odevincenti/Wet-DryPenguins/Pruebas Experimentales/Medición de conductividad/Conexion de ensayo preliminar.jpeg

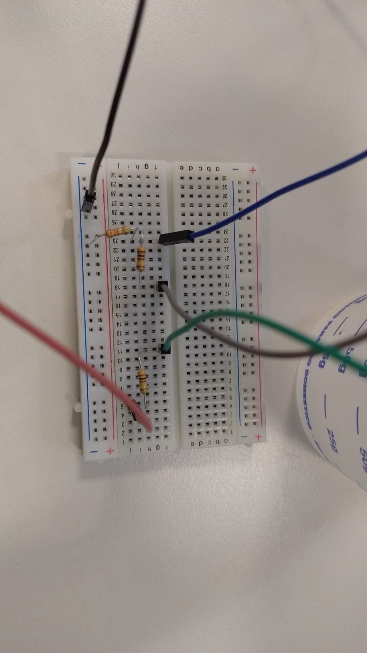
Pruebas Experimentales/Medición de conductividad/Conexion de ensayo preliminar.jpeg
