odevincenti/Wet-DryPenguins/README.md

# Wet&Dry Pingüinos

### Proyecto final de carrera de Ingeniería Electrónica - ITBA
#
## Integrantes
- De Vincenti, Olivia
- Figueroa, Alejo Agustin
- Mangone, Santiago Ezequiel
- Moldovan, Alexander
#
## Requerimientos
Diseñar un dispositivo que...
