odevincenti/Wet-DryPenguins/Produccion/PT_FINAL_2024_02/idea2.txt

// TODO
- si se despierta al inicio, otro texto?
- mediante uart y rtc para setear
//- agregar que se despierte desde base directo a uart
//- PONER HORA DE INICIO
//- si desconecta base, se salga solo de uart
//- always unknown command \n
//- lista de reseteos (con 2 indices each)
//- set led / clr led
//- paridad set, y chequeo con NAK
//- revisar indice 65535
// - ver porq se glitchea al inicio
//- sacar leds
//- corregir largo arreglo log
- corregir minuto calibrado 
//- corregir index maximo

// https://e2e.ti.com/support/microcontrollers/msp-low-power-microcontrollers-group/msp430/f/msp-low-power-microcontroller-forum/461905/msp430fr6989-unable-to-use-fram2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

65535 (MOD mas grande)

Digamos, maximo 60 min = 60000
-> 1 min = 1000
-> precision de 0,1%

Divisor de RTC a 1000
-> RTCCLK a 10Hz
-> 1 = 0,1 segs
-> 600 = 1 min

Divisor de RTC a 256
-> RTCCLK a 39,0625 Hz
-> 1 = 0,0256 segs
-> 2343,75 = 1 min

Divisor de RTC a 100
-> RTCCLK a 100Hz
-> 1 = 0,01 segs
-> 6000 = 1 min

Maximo 15 min = 60000
-> 1 min hasta 4000

Divisor de RTC a 256
-> RTCCLK a 39,0625 Hz
-> 1 = 0,0256 segs
-> 2343,75 = 1 min
