odevincenti/Wet-DryPenguins/Documentación/Tablas/14-1 Confiabilidad de hardware.xlsx

Sheet: Fórmulas
Componente | Cálculo de tasa de fallos [$fallas/10^6 horas$]
Capacitor | $\lambda_p = \pi_G \pi_C \left( \lambda_{OB} \pi_{DCO} \pi_{TO} \pi_S + \lambda_{EB} \pi_{DCN} \pi_{TE} + \lambda_{TCB} \pi_{CR} \pi_{DT} \right) + \lambda_{SJB} \pi_{SJDT} + \lambda_{EOS}$
Diodo | $\lambda_p = \pi_G \left( \lambda_{OB} \pi_{DCO} \pi_{TO} \pi_S + \lambda_{EB} \pi_{DCN} \pi_{TE} + \lambda_{TCB} \pi_{CR} \pi_{DT} \right) + \lambda_{SJB} \pi_{SJDT} + \lambda_{EOS}$
Resistencia | $\lambda_p = \pi_G \left( \lambda_{OB} \pi_{DCO} \pi_{TO} \pi_P + \lambda_{EB} \pi_{DCN} \pi_{TE} + \lambda_{TCB} \pi_{CR} \pi_{DT} \right) + \lambda_{SJB} \pi_{SJDT} + \lambda_{IND}$
Microcontrolador | $\lambda_p = \pi_G \left( \lambda_{OB} \pi_{DCO} \pi_{TO} + \lambda_{EB} \pi_{DCN} \pi_{RHT} + \lambda_{TCB} \pi_{CR} \pi_{DT} \right) + \lambda_{SJB} \pi_{SJDT} + \lambda_{EOS}$
LED | $\lambda_p = \pi_G \left( \lambda_{OB} \pi_{DCO} \pi_{TO} + \lambda_{EB} \pi_{DCN} \pi_{TE} + \lambda_{TCB} \pi_{CR} \pi_{DT} \right) + \lambda_{IND}$
PCB | $\lambda_p = \pi_G \left( \lambda_{OB} \pi_{DCO} \pi_{TO} + \lambda_{EB} \pi_{DCN} \pi_{TE} + \lambda_{TCB} \pi_{CR} \pi_{DT} \right) + \lambda_{IND}$
Conector | $\lambda_p = \pi_G \left( \lambda_{OB} \pi_{DCO} \pi_{TO} + \lambda_{EB} \pi_{DCN} \pi_{TE} + \lambda_{TCB} \pi_{CR} \pi_{DT} \right) + \lambda_{IND}$
Pila | Documentación

Sheet: Cálculos
 | Capacitor | Diodo uso general | Diodo schotky | Resistencia | Microcontrolador | LED | PCB | Conector | Pila
πG | 0.78 | 0.0012 | 0.0012 | 1.0 | 0.0000006 | 0.00004 | 0.001 | 0.001 | -
πC | 0.7 | - | - | - | - | - | - | - | -
λOB | 0.0013 | 0.00062 | 0.00005 | 0.00004 | 0.00001 | 0.00003 | 0.00004 | 0.0002 | -
πDCO | 0.01 | 0.04 | 0.04 | 0.04 | 0.04 | 0.03 | 0.02 | 0.02 | -
πTO | 1.0 | 0.8 | 0.8 | 0.9 | 1.1 | 0.5 | 0.8 | 0.8 | -
πP | - | - | - | 0.72021089 | - | - | - | - | -
πS | 0.000001 | 0.001 | 0.001 | - | - | - | - | - | -
λEB | 0.0006 | 0.00003 | 0.00004 | 0.00003 | 0.00063 | 0.0001 | 0.0001 | 0.0009 | -
πDCN | 1.20 | 1.30 | 1.30 | 1.30 | 1.39 | 1.47 | 2.04 | 2.04 | -
πTE | 0.5 | 0.4 | 0.4 | 0.7 | 0.5 | 0.4 | 0.7 | 0.7 | -
λTCB | 0.00010 | 0.00010 | 0.0006 | 0.000001 | 0.00003 | 0.00001 | 0.000003 | 0.00001 | -
πCR | 0.001 | 0.000001 | 0.000001 | 0.001 | 0.002 | 0.003 | 0.002 | 0.002 | -
πDT | 0.44 | 0.03 | 0.03 | 0.01 | 1.64 | 1.42 | 0.07 | 0.07 | -
λSJB | 0.0009 | 0.0002 | 0.0002 | 0.0009 | 0.0049 | - | - | - | -
λSJDT | 0.08 | 0.04 | 0.04 | 0.04 | 0.42 | - | - | - | -
λEOS | 0 | 0 | 0 | 0 | 0 | 0 | 0 | 0.00000 | -
λIND | - | - | - | 0.000006 | - | 0.0001 | 0.0002 | 0.002 | -
λP [fallas/10^6 hs] | 0.0002 | 0.000007 | 0.000007 | 0.00006 | 0.002 | 0.0001 | 0.0002 | 0.002 | 0.0000004
Bloque: | λ [fallas/10^6hs] |  | t [años] | R(t)
2x Conector | 0.004 |  | 1 | 99.99%
PCB | 0.0002 |  | 2 | 99.97%
2x Diodo Schotky | 0.00001 |  | 3 | 99.96%
3x Diodo uso general | 0.00002 |  | 4 | 99.95%
RC de reset | 0.0003 |  | 5 | 99.93%
Micro | 0.002 |  | 6 | 99.92%
2xR de sensado | 0.0001 |  | 7 | 99.91%
4x Pines de entrada | 0.008 |  | 8 | 99.90%
R de LED | 0.0001 |  | 9 | 99.88%
LED | 0.0001 |  | 10 | 99.87%
Pila | 0.0000004
 |  |  | MTBF [años] | 7.681236065
λtotal | 0.015
