odevincenti/Wet-DryPenguins/Documentación/Tablas/10-1-2 Propuesta de alternativas de diseño.xlsx

 | MSP430FR2476 | MB85RC128APNF-G | AT25DN256-SSHF-B
 | METER FOTO | METER FOTO | METER FOTO
Formato | RTC Interno Sin formato de fecha | HH:MM:SS - YY:MM:DD:dd | HH:MM:SS - YY:MM:DD:dd
Dimensiones | - | 3mm x 3mm | 3mm x 3mm
Consumo | - | 0,65 μA | 0,05 μA
Costo | Integrado | \$0,40 | \$1,67
 | MSP430FR2433 | MSP430FR2476
 | METER FOTO | METER FOTO
Consumo | 126 μA/M Hz − 0, 73μA(avg) | 135 μA/M Hz − 0, 66μA(avg)
Memoria | 16kB FRAM | 64kB FRAM
Dimensiones | 4mm x 4mm | 5mm x 5mm
Costo | $2,11 | $2,90
 | Interno MSP430 | MB85RC128APNF-G | AT25DN256-SSHF-B
 | METER FOTO | METER FOTO | METER FOTO
Memoria | 64kB FRAM | 16kB FRAM | 32 KB FLASH
Costo | Integrado | $2,48 | $0,26
 | Interno MSP430 | SIT1532AI-J4-DCC-32.768D
 | METER FOTO | METER FOTO
Tipo | RTC interno | RTC alta precisión
Frecuencia | 32.768 kHz | 32.768kHz
Consumo | - | 1.4µA
Costo | Integrado | \$1,24
 | Interno MSP430 | MB85RC128APNF-G | AT25DN256-SSHF-B
 | METER FOTO | METER FOTO | METER FOTO
Formato | RTC Interno Sin formato de fecha | HH:MM:SS - YY:MM:DD:dd | HH:MM:SS - YY:MM:DD:dd
Dimensiones | - | 3mm x 3mm | 3mm x 3mm
Consumo | - | 0,65 μA | 0,05 μA
Costo | Integrado | \$0,40 | \$1,67
 | SR626 | CR1620 | CR1632 | CR2032
 | METER FOTO | METER FOTO | METER FOTO | METER FOTO
Diámetro | 6,8mm | 16mm | 16mm | 20mm
Alto | 2,6mm | 2mm | 3.2mm | 3.2mm
Peso | 0,4g | 1,2g | 1,8g | 3,0g
Tensión nominal | 1,55v | 3V | 3V | 3V
Capacidad | 28mAh | 75mAh | 140mAh | 235mAh
Descarga continua | 0,05mA | 0,1mA | 0.1mA | 0,1mA
Descarga pulsada | 1mA | 5mA | 5mA | 7mA
Precio | $0,53 | $1,03 | $1,09 | $0,48
 | Pogo 0985-0-15-20-71-14-11-0 | GRPB081VWVN-RC
 | METER FOTO | METER FOTO
Peso | 80mg | 51mg
Acabado | Gold Plated | Gold Plated
Precio | $0,75 USD | $0,76 USD (x8)
 | Interno MSP430 | MAX31875 | TMP102
 | METER FOTO | METER FOTO | METER FOTO
Peso | - | 3mg | 15,5mg
Dimensiones | - | 1,6 X 1,6mm | 2,9 X 2,8mm
Rango | -10°C ~ 100°C (12bit res) | -10°C ~ 100°C (12bit res) | -40°C ~ 125°C (11bit res)
Comunicación | - | I²C | I²C
Consumo | - | 0.7uA/80uA | 1uA/10uA
Precio | $0,00 | $2,01 | $1,82
 | Epoxi | Poliuretano | Silicona
Impermeable | Si | Si | Si
Propiedades mecánicas | \tabitem Alta resistencia \tabitem Excelente adherencia \tabitem Duro y rígido | \tabitem Buena flexibilidad y resistencia \tabitem Buena resistencia al impacto \tabitem Resistencia moderada | \tabitem Buena flexibilidad \tabitem Buena resistencia al impacto \tabitem Resistencia moderada
Tiempo de curado | Minutos a horas | Minutos a horas | Horas a dias
Facilidad de aplicación | \tabitem Requiere mezcla precisa y manejo adecuado \tabitem Pot life corto | \tabitem Sencilla mezcla y manejo \tabitem Tiempo de vida más largo | \tabitem Sencilla mezcla y manejo \tabitem Tiempo de vida más largo
Resistencia al agua salada y corrosión | Buena | Excelente | Excelente
Resistencia a Altas Presiones | Buena (depende de la formulación y espesor) | Excelente (depende de la formulación y espesor) | Buena (depende de la formulación y espesor)
Densidad | 1.1 - 1.5 g/cm^3 | 0.9 - 1.5 g/cm^3 | 0.9 - 1.3 g/cm^3
Rango de Temperatura de Curado | 70°C-90°C | 40°C-60°C | 25°C-45°C
Costo | Medio | Bajo | Medio
