odevincenti/Wet-DryPenguins/Revisión del Informe/Corrección 8.docx

2. Agradecimientos

A nuestras familias por apoyarnos en cada paso de nuestra formación como Ingenieros.

A los Doctores Miguel Aguirre, y Pablo Cossuta y el resto de investigadores ~~en el~~ del CIDEI. (¿A estos en que se los agradece?)

A los Ingenieros Lien Tori y Nicolás Magliola, por ~~prestarnos~~ brindarnos su experiencia, ~~y~~ consejos~~, al igual que~~ y el uso de las instalaciones …. (Instalaciones de dónde).

A los Doctores Esteban Frere, Melina Barrionuevo y Gabriela Blanco, y a Juan Cruz Martín, por confiar en nosotros con el desarrollo del proyecto, hospedarnos en Puerto Deseado y ser nuestros guías ~~durante~~ en la excursión a la Isla Quiroga.

Al Doctor Martín David por su especial ayuda y ~~por~~ facilitarnos las instalaciones del Laboratorio de Energía.

A los Doctores Ezequiel Rossi, ~~la Doctora~~ Guillermina Gentile, Gema Díaz y Víctor Omar Lizza por su ayuda en las ~~momentos~~ etapas de la investigación. (A estos los adelanté porque son Doctores, no pueden estar al fondo)

A Jorge Caseres y Gabriel Zapata por estar siempre disponibles en el pañol, ~~ayudándonos sin importar cuántas~~ brindándose generosamente ~~en~~ durante las extensas pruebas de ~~estemos en el~~ laboratorio. ~~durante las pruebas.~~

Y finalmente, a los Pingüinos de Magallanes que protagonizan este trabajo y nos inspiraron a lo largo del proyecto.

¿Qué es CIDEI? ¿Está aclarado en el trabajo? Caso contrario hay que poner el nombre completo

Entre cada agradecimiento conviene dejar un espacio

Me gustó agradecerles a los pingüinos
