odevincenti/Wet-DryPenguins/Documentación/Factibilidad de tiempos/Gantt del Proyecto.pdf

Alejo Figueroa - Alexander Moldov an - Oliv ia De Vincenti - Santiago Mangone

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
1 | Planteo de Objetiv os | 27 28 29 30 31
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
9 10 11 12 13 14 15 16 17 18 19 20 21 22 23 24 25 26 27 28 29 30

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
9 10 11 12 13 14 15 16 17 18 19 20 21 22 23 24 25 26 27 28 29 30 31

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
9 10 11 12 13 14 15 16 17 18 19 20 21 22 23 24 25 26 27 28 29 30

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
9 10 11 12 13 14 15 16 17 18 19 20 21 22 23 24 25 26 27 28 29 30 31

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
9 10 11 12 13 14 15 16 17 18 19 20 21 22 23 24 25 26 27 28 29 30 31

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
9 10 11 12 13 14 15 16 17 18 19

1.1 | Contacto biólogos | Aj.Ax.O.S. | ####### #######
4
1.2 | Def inición del problema y relev amiento
de datos | Aj.Ax.O.S. | ####### #######
6
1.3 | Def inición de requerimientos | Aj.Ax.O.S. | ####### #######
7 | 1.2
1.4 | Plan de v alidación | Aj.Ax.O.S. | ####### ####### | 10 | 1.3 2 | Diseño del Producto
2.1 | Factibilidad Tecnológica | ####### ####### | 30
2.1.1 | Propuesta de alternativ as | Aj.Ax.O.S. | ####### ####### | 20 | 1.3
2.1.2 | Elección de una solución | Aj.Ax.O.S. | ####### ####### | 10 | 2.1.1, 2.3
2.1.3 | 1ra DFMEA | Aj.Ax.O.S. | ####### #######
1 | 2.1.2
2.2 | Factibilidad Económica | ####### ####### | 36
2.2.1 | Análisis de presupuesto y costos | Oliv ia | ####### ####### | 10 | 2.1.1
2.2.2 | Análisis del mercado | Oliv ia | ####### ####### | 30 | 1.3
2.2.4 | Diseño del modelo de negocios | Oliv ia | ####### ####### | 10 | 2.1.2
2.2.1, 2.2.2
2.3 | Factibilidad legal | Santiago | ####### ####### | 20 | 2.1.1 3 | Ingeniería de Detalle
3.1.1 | Diseño del sistema de medición | Aj.Ax.O.S. | ####### ####### | 22 | 2.1.2
3.1.2 | Diseño del sistema de alimentación | Aj.Ax.O.S. | ####### ####### | 22 | 2.1.2
3.1.3 | Diseño del sistema de comunicación | Aj.Ax.O. | ####### ####### | 32 | 2.1.2
3.1.4 | Selección de recubrimiento aislante | Santiago | ####### ####### | 38 | 2.1.2
3.1.5 | Integración de módulos | Aj.Ax.O.S. | ####### #######
8 | 3.1.1, 3.1.2,
3.1.3
3.2 | Diagramación del f irmware | Alex | ####### #######
6 | 3.1.1, 3.1.2,
3.1.4
3.3 | Diagramación del sof tware | Oliv ia | ####### #######
6 | 3.2

### 4 Elaboración Prototipo

4.1 | Fabricación de primer prototipo | Aj.S. | ####### ####### | 14 | 3.1.5
4.2 | Programación del f irmware | Alex | ####### ####### | 37 | 3.2, 3.1.5
4.3 | Programación del sof tware | Oliv ia | ####### ####### | 40 | 3.3 5 | Validación
5.1.1 | Pruebas de duración de batería | Ax.S. | ####### ####### | 60 | 3.1.2
5.1.2 | Pruebas de poteo | Santiago | ####### ####### | 16 | 3.1.4
5.1.3 | Pruebas de medición | Oliv ia | ####### #######
7 | 4.1
5.1.4 | Pruebas de consumo | Oliv ia | ####### #######
7 | 4.1
5.1.5 | Pruebas de resistencia | Aj.Ax.O.S. | ####### #######
7 | 4.1, 5.1.2
5.1.6 | Pruebas de f uncionamiento | Aj.Ax. | ####### #######
7 | 4.1, 4.2
5.2 | Prueba de Campo | Aj.Ax.O.S. | ####### ####### | 39 | 4.3, 5.1.6 6 | Rediseño
6.1 | Análisis de resultados | Aj.Ax.O.S. | ####### ####### | 12 | 5.2
6.2 | Identif icación de nuev os modos de
| f alla | Aj.Ax.O.S. | ####### ####### | 19 | 6.1
6.3 | Rediseño | Aj.Ax.O.S. | ####### ####### | 10 | 6.2
6.4 | Elaboración del producto f inal | Aj.Ax.O.S. | ####### ####### | 6 | 6.3

### 7 Conclusiones

7.1 | Elaboración de especif icaciones
| def initiv as | Aj.Ax.O.S. | ####### ####### | 9 | 6.4
7.2 | Presentación a la comunidad | Aj.Ax.O.S. | ####### ####### | 1 | 7.1

MAYO
DEPENDENCI | SEMANA 13 | SEMANA 14 | SEMANA 15 | SEMANA 16 | SEMANA 17 | SEMANA 18 | SEMANA 19 | SEMANA 20 AS

# Proyecto ITBA + CIDEI + CONICET

TÍTULO DEL PROYECTO | Diseño de Equipos Electrónicos

RESPONSABLE DEL PROYECTO

NÚMERO
EDT
MARZO | ABRIL
TÍTULO DE LA TAREA | RESPONSAB
LE

FECHA
DE INICIO

FECHA
DE
ENTREG A
DURACIÓ N | SEMANA 26 | SEMANA 27
JUNIO | JULIO
SEMANA 28 | SEMANA 29 | SEMANA 30 | SEMANA 31

AGOSTO

SEMANA 21 | SEMANA 22 | SEMANA 23 | SEMANA 24 | SEMANA 25 | SEMANA 32 | SEMANA 33 | SEMANA 34 | SEMANA 35 | SEMANA 36 | SEMANA 37 | SEMANA 38 | SEMANA 39
| | | | | | | | | | SEPTIEMBRE
SEMANA 40 | SEMANA 41 | SEMANA 42 | SEMANA 43 | SEMANA 44

OCTUBRE

SEMANA 45 | SEMANA 46 | SEMANA 47 | SEMANA 48

NOVIEMBRE

SEMANA 49 | SEMANA 50 | SEMANA 51 | SEMANA 52
DICIEMBRE | ENERO
SEMANA 1 | SEMANA 2 | SEMANA 3 | SEMANA 4 | SEMANA 5 | SEMANA 6

FEBRERO

SEMANA 7
