odevincenti/Wet-DryPenguins/Documentación/Diagramas y Gráficos/Diagramas en bloque/8 - Definición del producto/Casa de calidad.jpeg

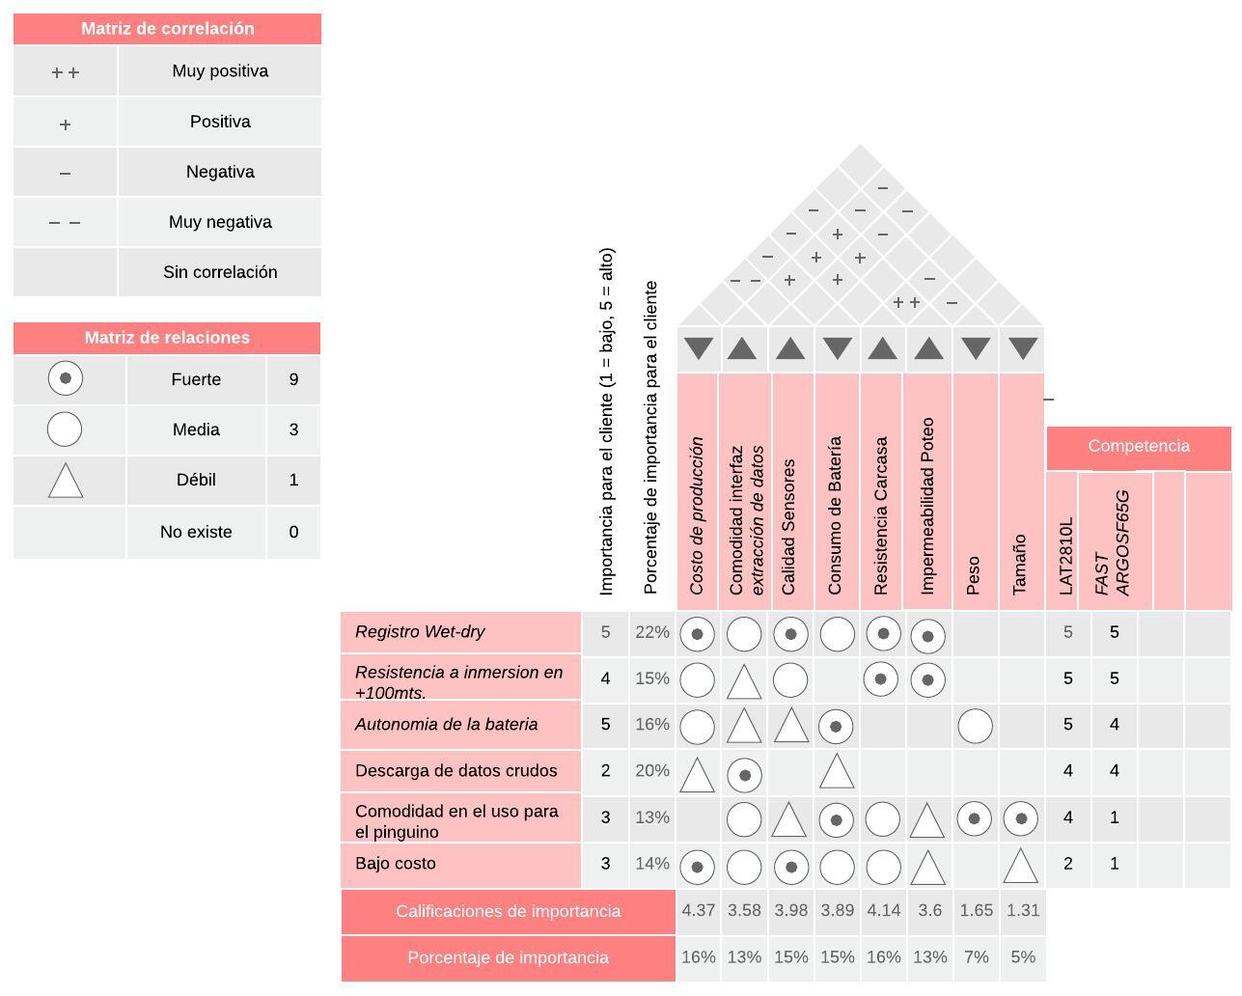
Documentación/Diagramas y Gráficos/Diagramas en bloque/8 - Definición del producto/Casa de calidad.jpeg
