odevincenti/Wet-DryPenguins/Documentación/Diagramas y Gráficos/Diagramas en bloque/8 - Definición del producto/project_diagram.png

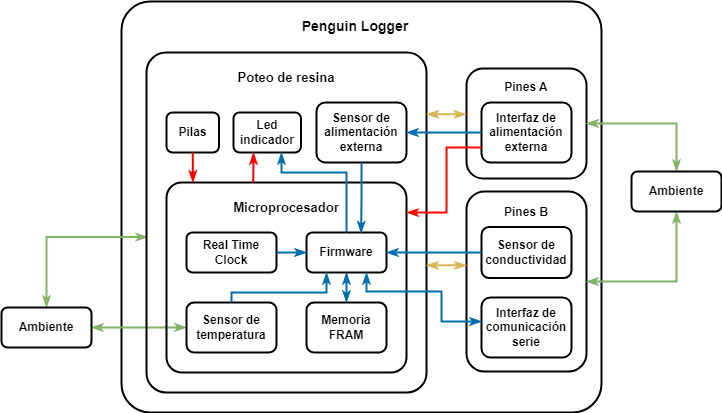
Documentación/Diagramas y Gráficos/Diagramas en bloque/8 - Definición del producto/project_diagram.png
