odevincenti/Wet-DryPenguins/Documentación/Diagramas y Gráficos/Diagramas en bloque/8 - Definición del producto/reference.drawio.png

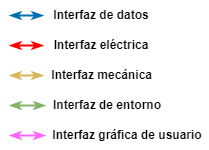
Documentación/Diagramas y Gráficos/Diagramas en bloque/8 - Definición del producto/reference.drawio.png
