odevincenti/Wet-DryPenguins/Documentación/Diagramas y Gráficos/Diagramas en bloque/9 - Plan de validación/BP-03.jpg

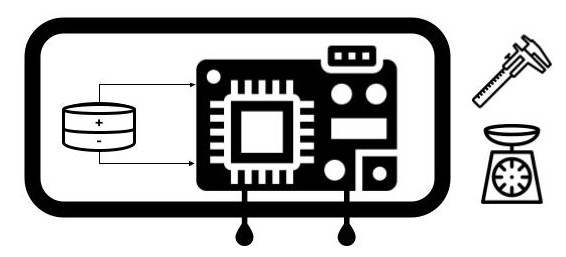
Documentación/Diagramas y Gráficos/Diagramas en bloque/9 - Plan de validación/BP-03.jpg
