odevincenti/Wet-DryPenguins/Documentación/Diagramas y Gráficos/Diagramas en bloque/9 - Plan de validación/BP-04.jpg

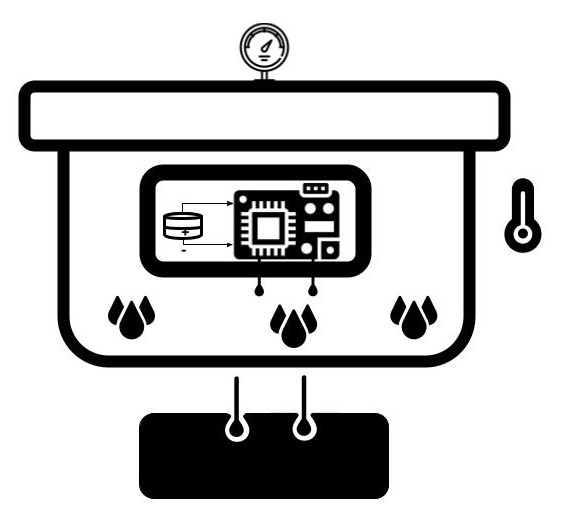
Documentación/Diagramas y Gráficos/Diagramas en bloque/9 - Plan de validación/BP-04.jpg
