odevincenti/Wet-DryPenguins/Documentación/Diagramas y Gráficos/Diagramas en bloque/10 - Ingeniería de detalle/Hardware/10.1.3 Detalles de Selección y Cálculo de los Elementos Circuitales de cada Bloque.jpg

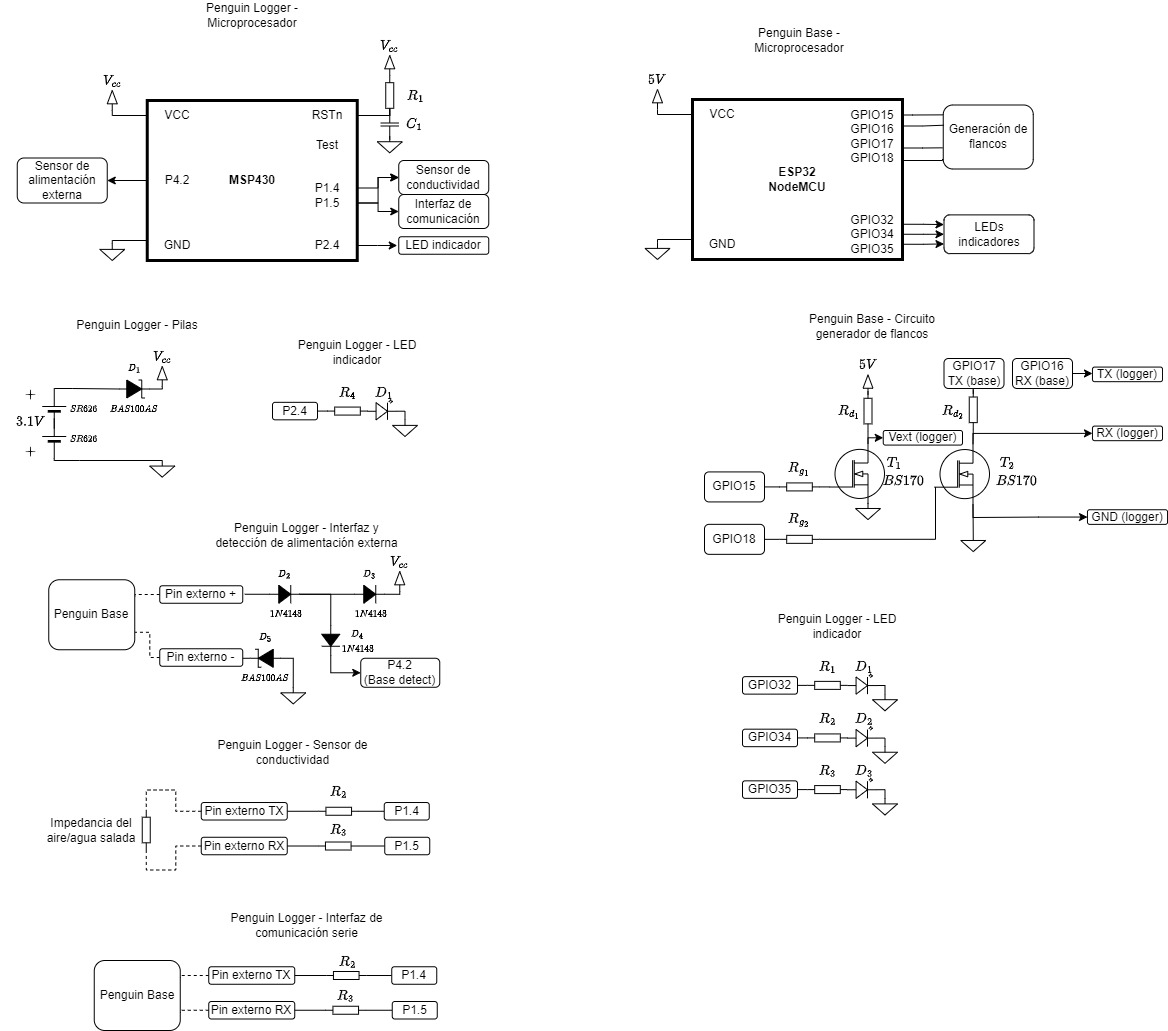
Documentación/Diagramas y Gráficos/Diagramas en bloque/10 - Ingeniería de detalle/Hardware/10.1.3 Detalles de Selección y Cálculo de los Elementos Circuitales de cada Bloque.jpg
