odevincenti/Wet-DryPenguins/Documentación/Diagramas y Gráficos/Diagramas en bloque/10 - Ingeniería de detalle/Hardware/base.drawio.png

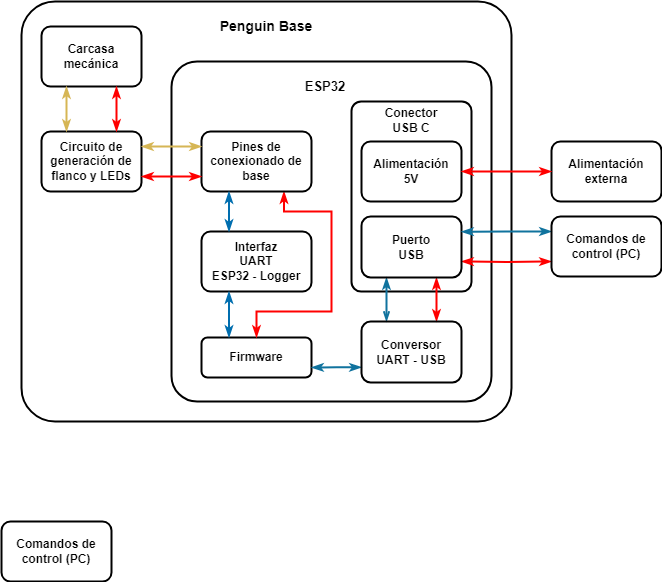
Documentación/Diagramas y Gráficos/Diagramas en bloque/10 - Ingeniería de detalle/Hardware/base.drawio.png
