odevincenti/Wet-DryPenguins/Documentación/Diagramas y Gráficos/Diagramas en bloque/10 - Ingeniería de detalle/Hardware/Base_led_block.jpg

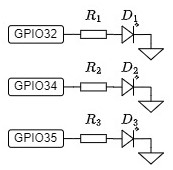
Documentación/Diagramas y Gráficos/Diagramas en bloque/10 - Ingeniería de detalle/Hardware/Base_led_block.jpg
