odevincenti/Wet-DryPenguins/Documentación/Diagramas y Gráficos/Diagramas en bloque/10 - Ingeniería de detalle/Software/pengui_diagram.drawio.png

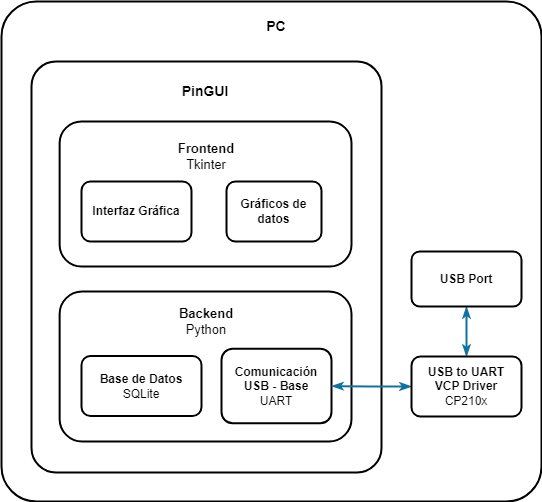
Documentación/Diagramas y Gráficos/Diagramas en bloque/10 - Ingeniería de detalle/Software/pengui_diagram.drawio.png
