odevincenti/Wet-DryPenguins/Documentación/Diagramas y Gráficos/Diagramas en bloque/10 - Ingeniería de detalle/Software/PreHito 3 - Firmware - Diagrama de Bloques.png

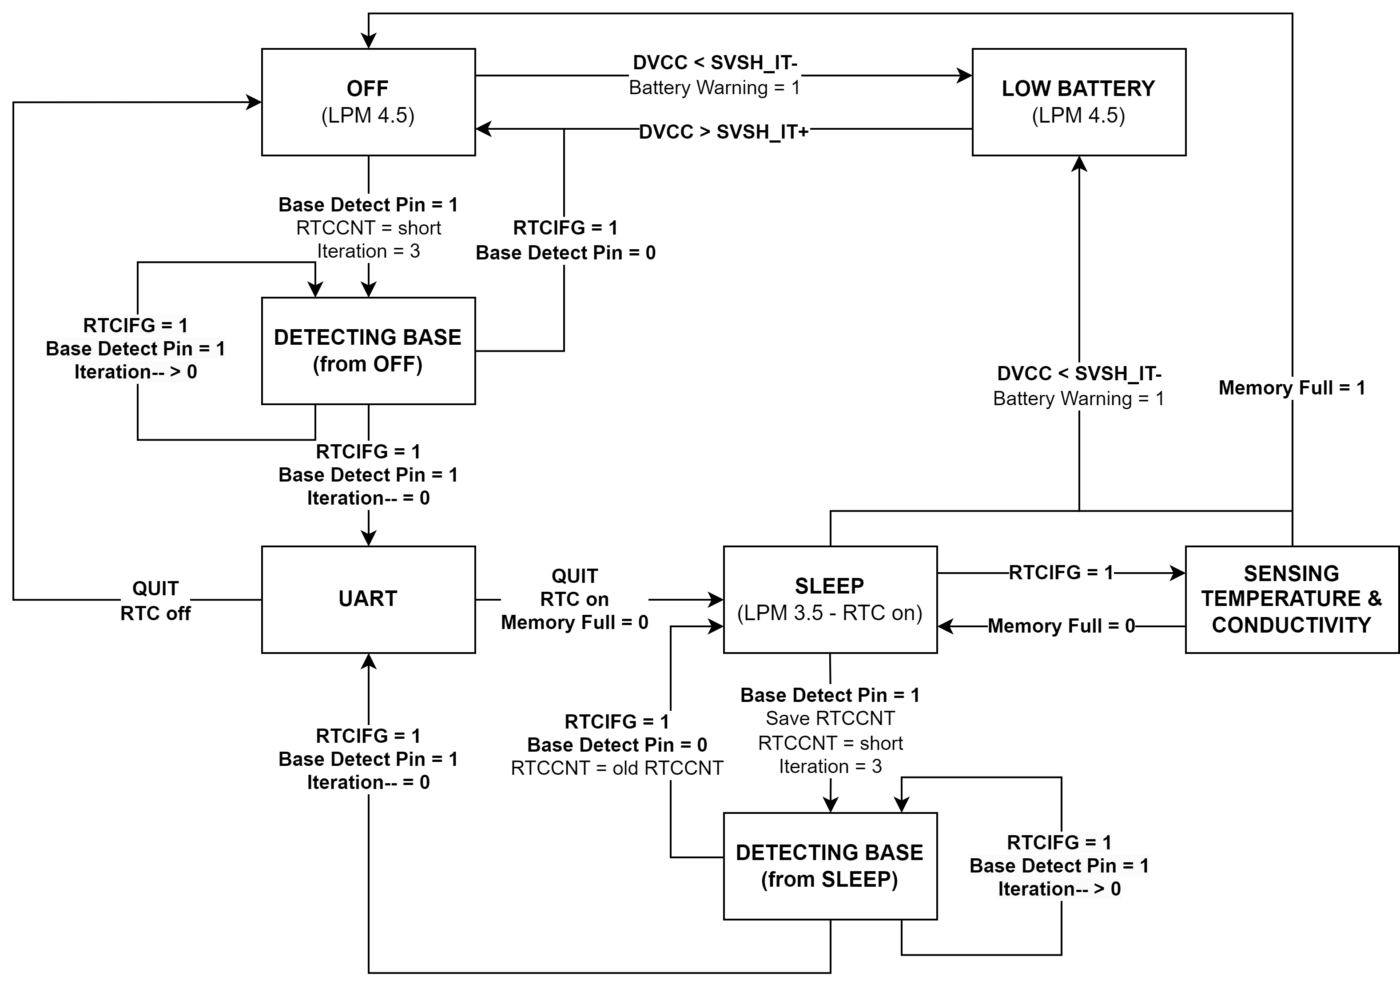
Documentación/Diagramas y Gráficos/Diagramas en bloque/10 - Ingeniería de detalle/Software/PreHito 3 - Firmware - Diagrama de Bloques.png
