odevincenti/Wet-DryPenguins/Documentación/Diagramas y Gráficos/Diagramas en bloque/10 - Ingeniería de detalle/Software/PreHito 3 - Firmware - Memoria.png

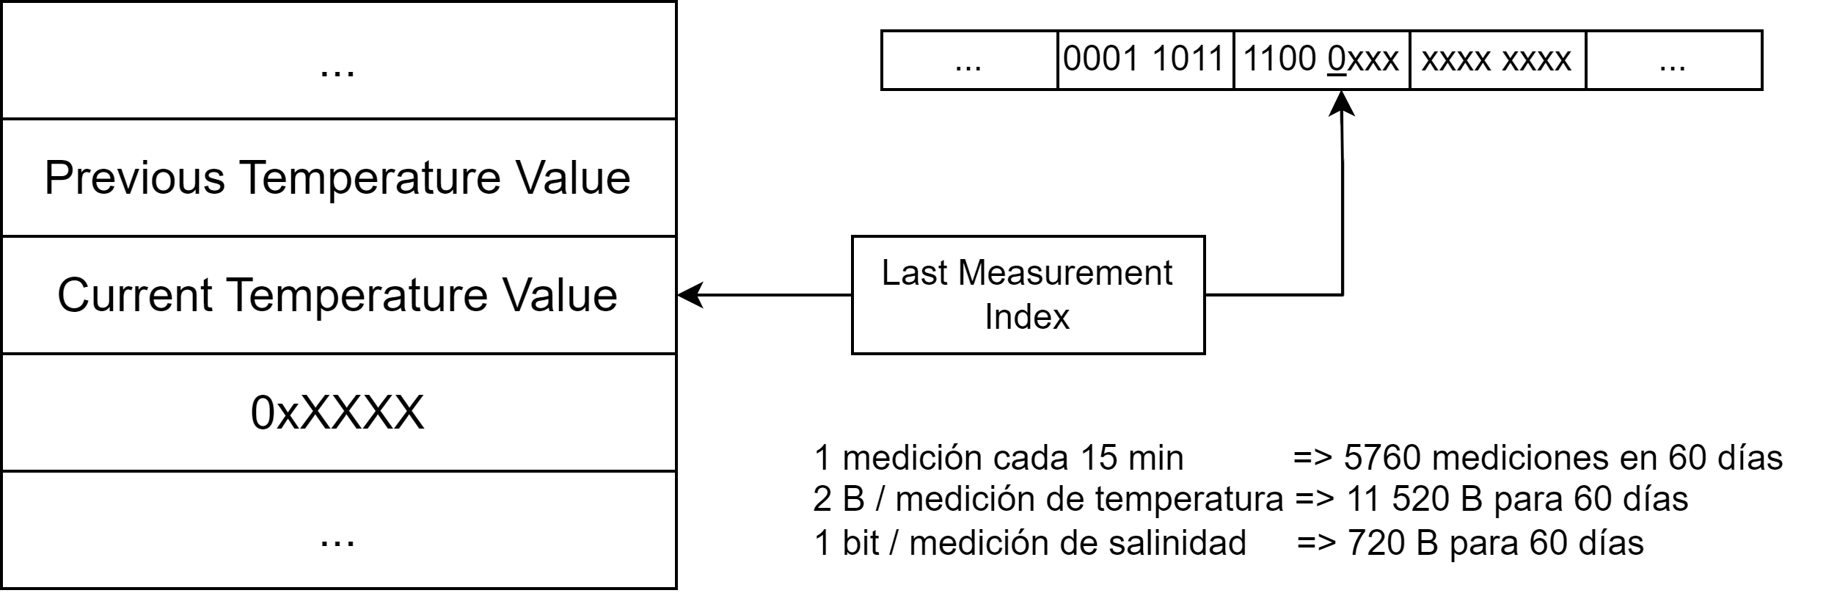
Documentación/Diagramas y Gráficos/Diagramas en bloque/10 - Ingeniería de detalle/Software/PreHito 3 - Firmware - Memoria.png
