odevincenti/Wet-DryPenguins/Documentación/Diagramas y Gráficos/Diagramas en bloque/14 - Confiabilidad/14-1 Confiabilidad de hardware.jpg

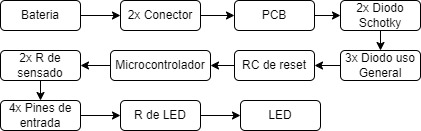
Documentación/Diagramas y Gráficos/Diagramas en bloque/14 - Confiabilidad/14-1 Confiabilidad de hardware.jpg
