odevincenti/Wet-DryPenguins/Documentación/Diagramas y Gráficos/PenGUI Views/connected_logger_view.png

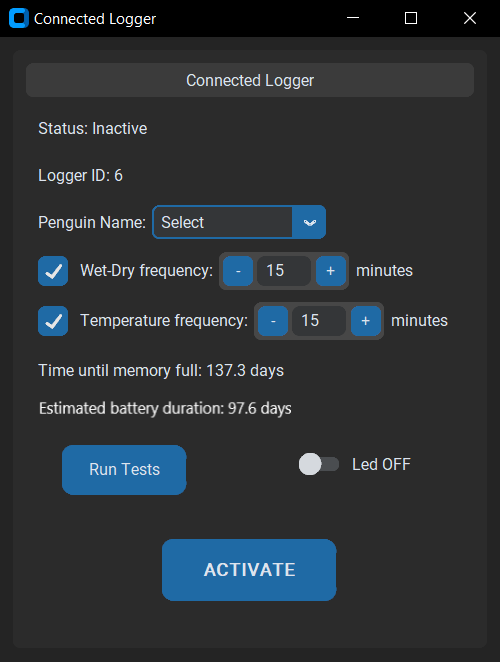
Documentación/Diagramas y Gráficos/PenGUI Views/connected_logger_view.png
