odevincenti/Wet-DryPenguins/Documentación/Diagramas y Gráficos/PenGUI Views/data_view.png

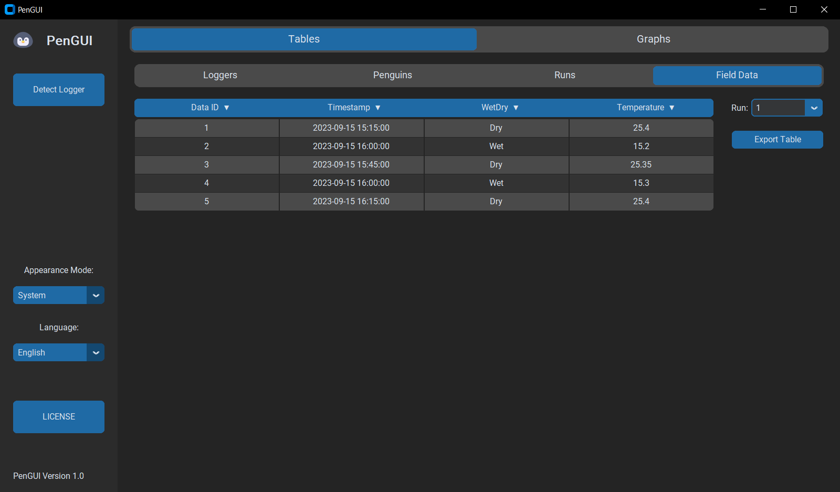
Documentación/Diagramas y Gráficos/PenGUI Views/data_view.png
