odevincenti/Wet-DryPenguins/Documentación/Diagramas y Gráficos/PenGUI Views/data_view_with_connected_logger.png

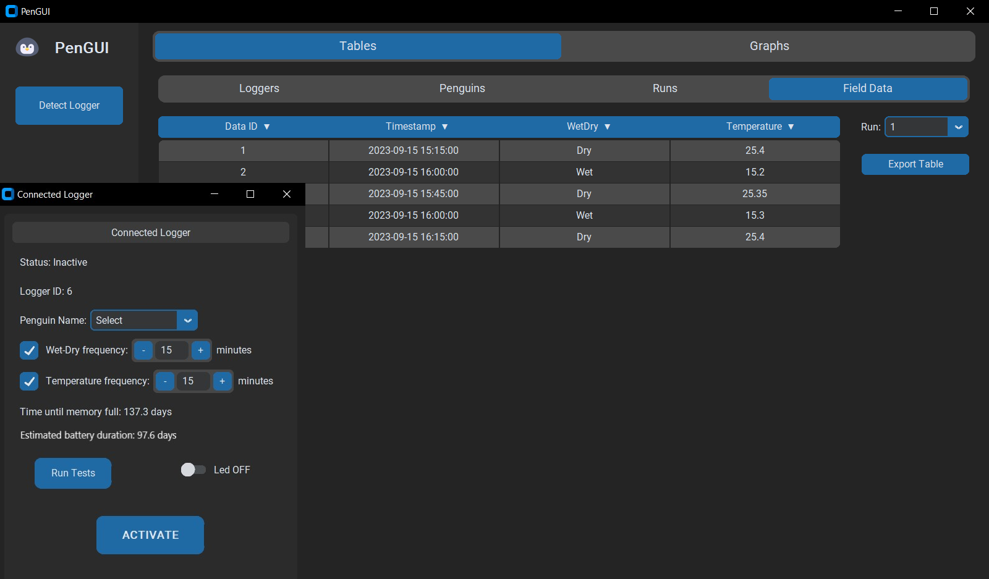
Documentación/Diagramas y Gráficos/PenGUI Views/data_view_with_connected_logger.png
