odevincenti/Wet-DryPenguins/Documentación/Diagramas y Gráficos/PenGUI Views/graph_view.png

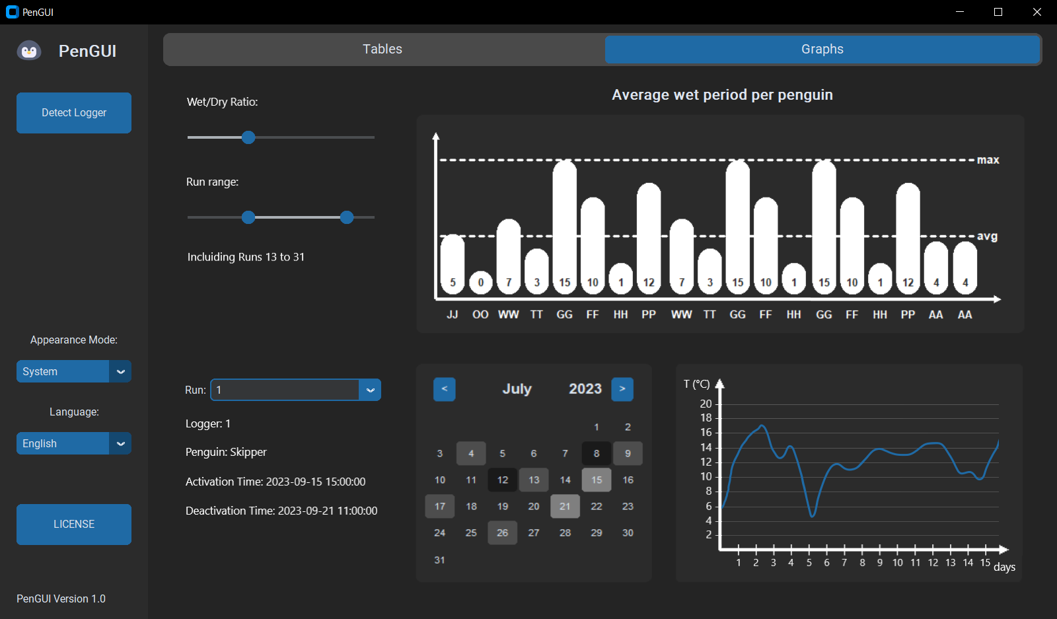
Documentación/Diagramas y Gráficos/PenGUI Views/graph_view.png
