odevincenti/Wet-DryPenguins/Documentación/Diagramas y Gráficos/PenGUI Views/Logger_base_PenGUI_real.jpeg

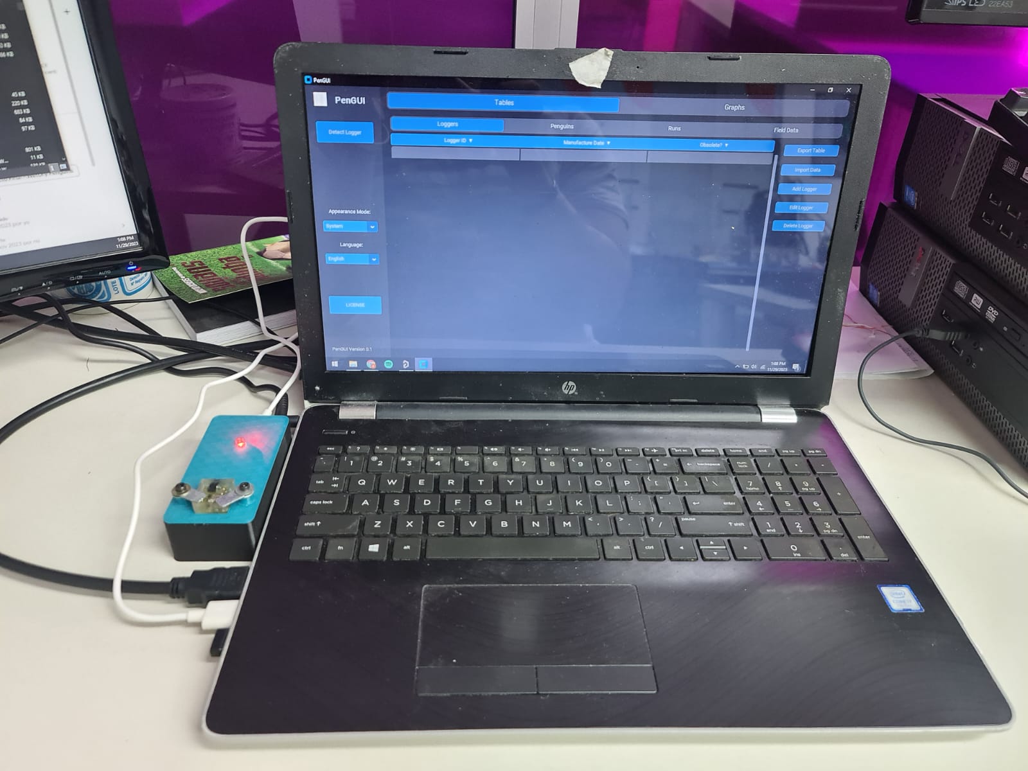
Documentación/Diagramas y Gráficos/PenGUI Views/Logger_base_PenGUI_real.jpeg
