odevincenti/Wet-DryPenguins/Documentación/Diagramas y Gráficos/PenGUI Views/logger_view.png

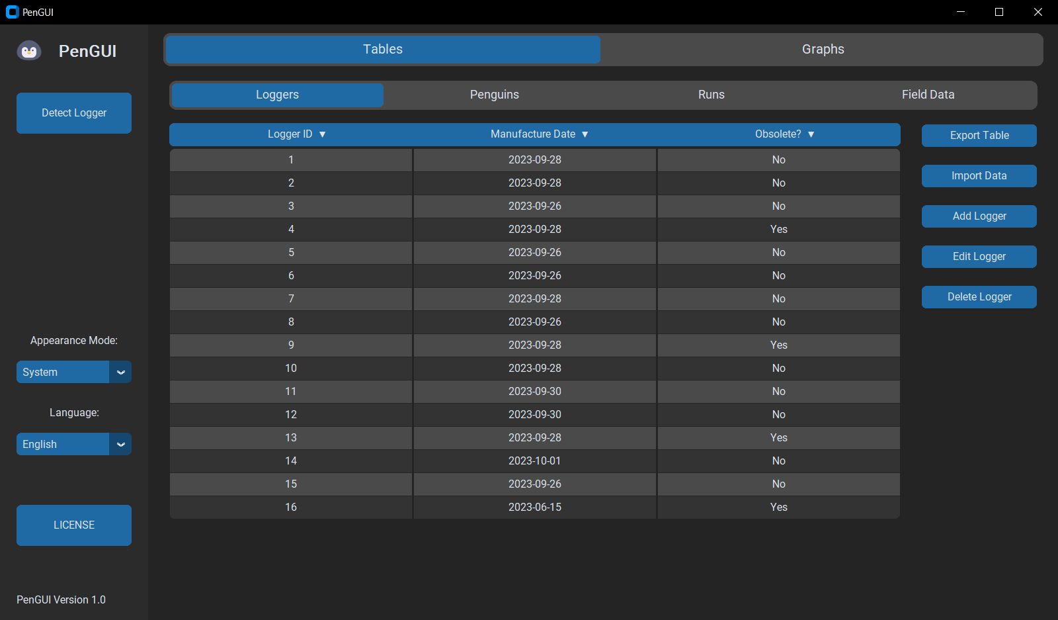
Documentación/Diagramas y Gráficos/PenGUI Views/logger_view.png
