odevincenti/Wet-DryPenguins/Documentación/Diagramas y Gráficos/PenGUI Views/penguin_view+connected_logger_view.png

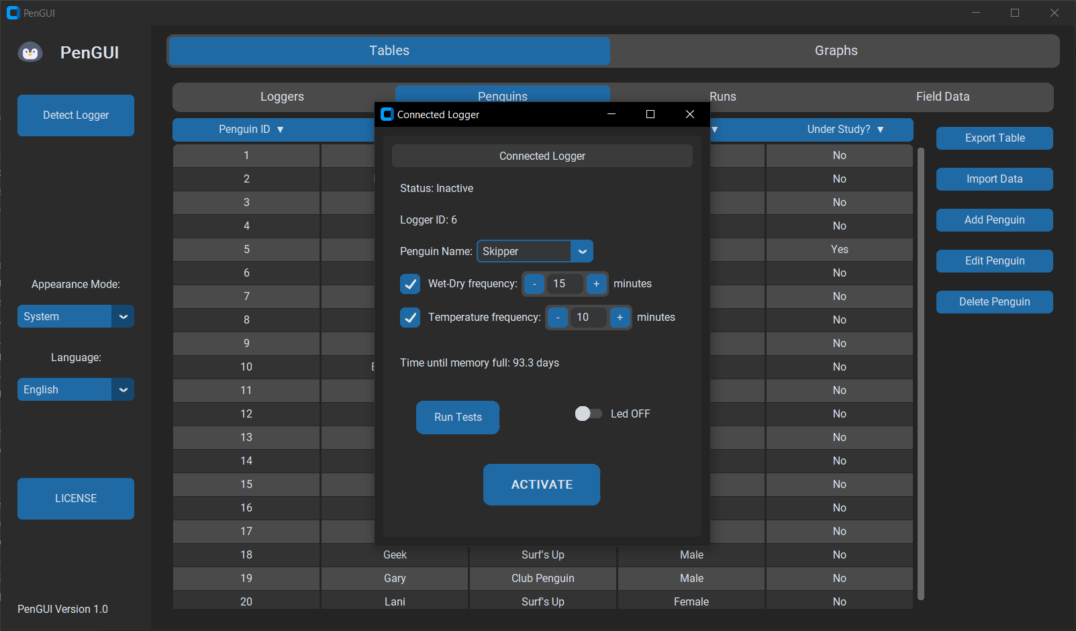
Documentación/Diagramas y Gráficos/PenGUI Views/penguin_view+connected_logger_view.png
