odevincenti/Wet-DryPenguins/Documentación/Diagramas y Gráficos/PenGUI Views/penguin_view.png

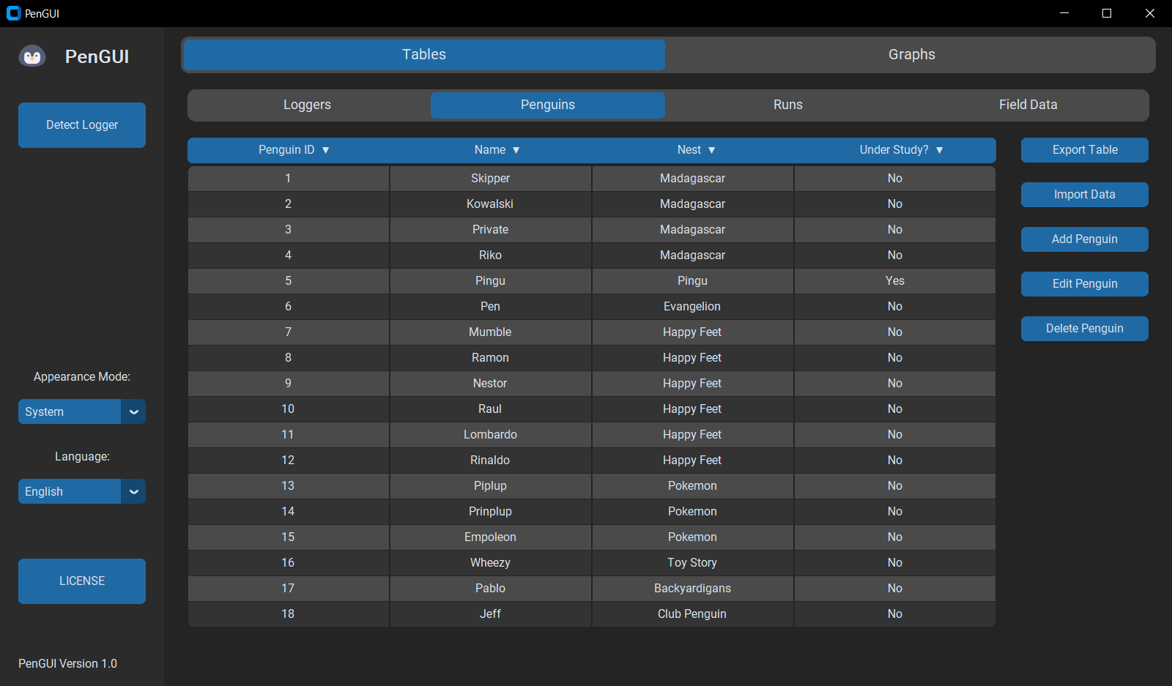
Documentación/Diagramas y Gráficos/PenGUI Views/penguin_view.png
