odevincenti/Wet-DryPenguins/Documentación/Diagramas y Gráficos/PenGUI Views/run_view.png

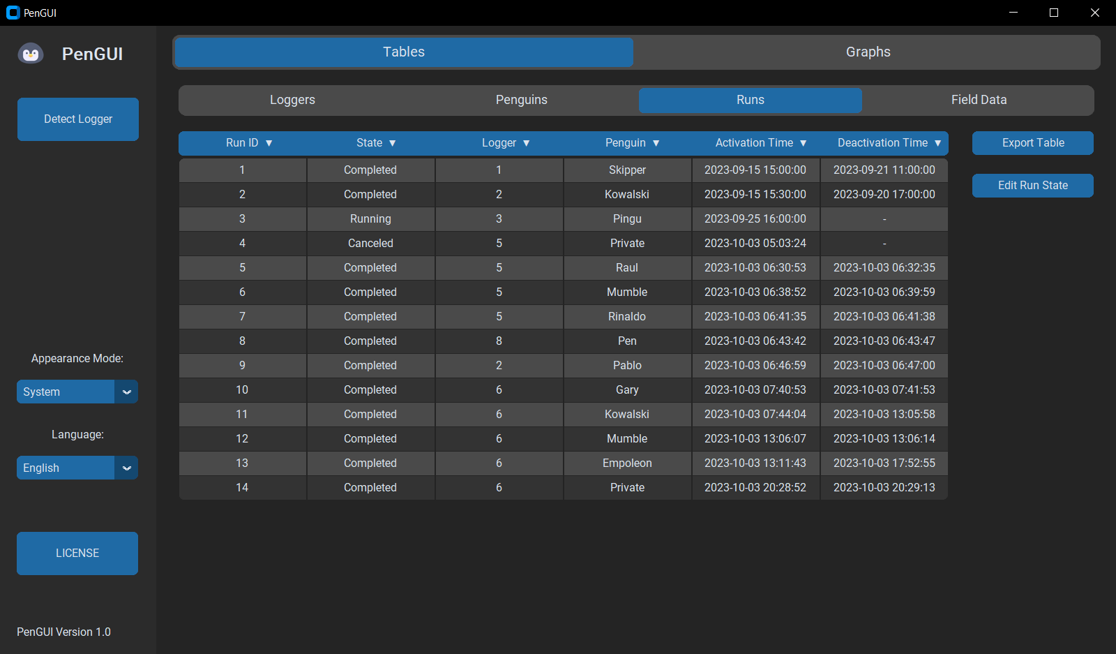
Documentación/Diagramas y Gráficos/PenGUI Views/run_view.png
