odevincenti/Wet-DryPenguins/Documentación/Factibilidad de tiempos/PERT.drawio.png

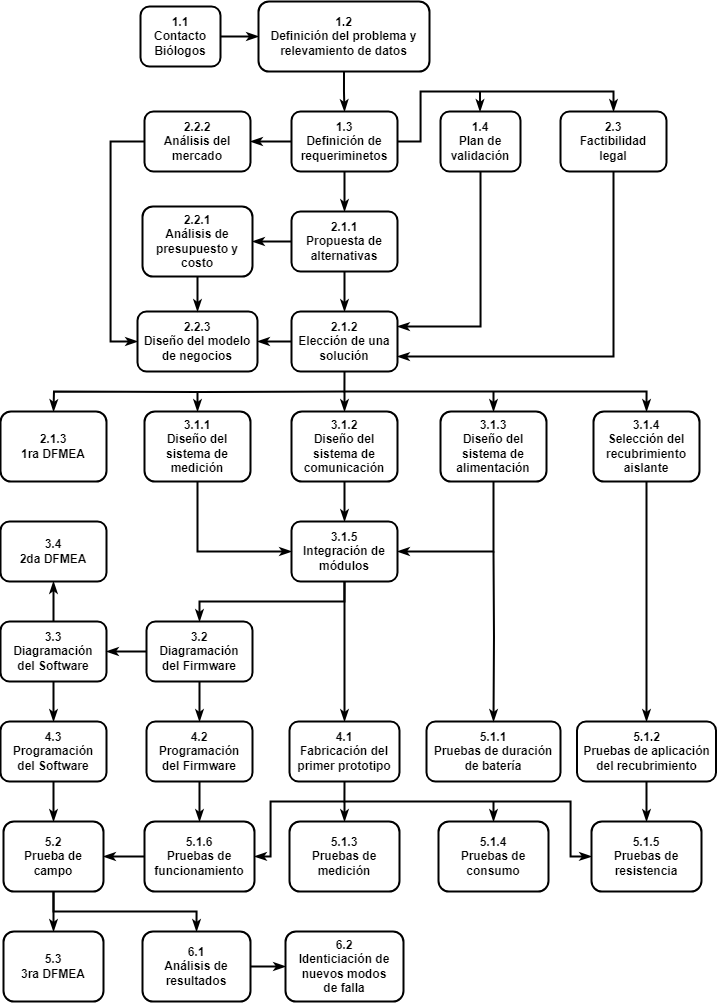
Documentación/Factibilidad de tiempos/PERT.drawio.png
