odevincenti/Wet-DryPenguins/Documentación/Factibilidad económica/CANVAS.png

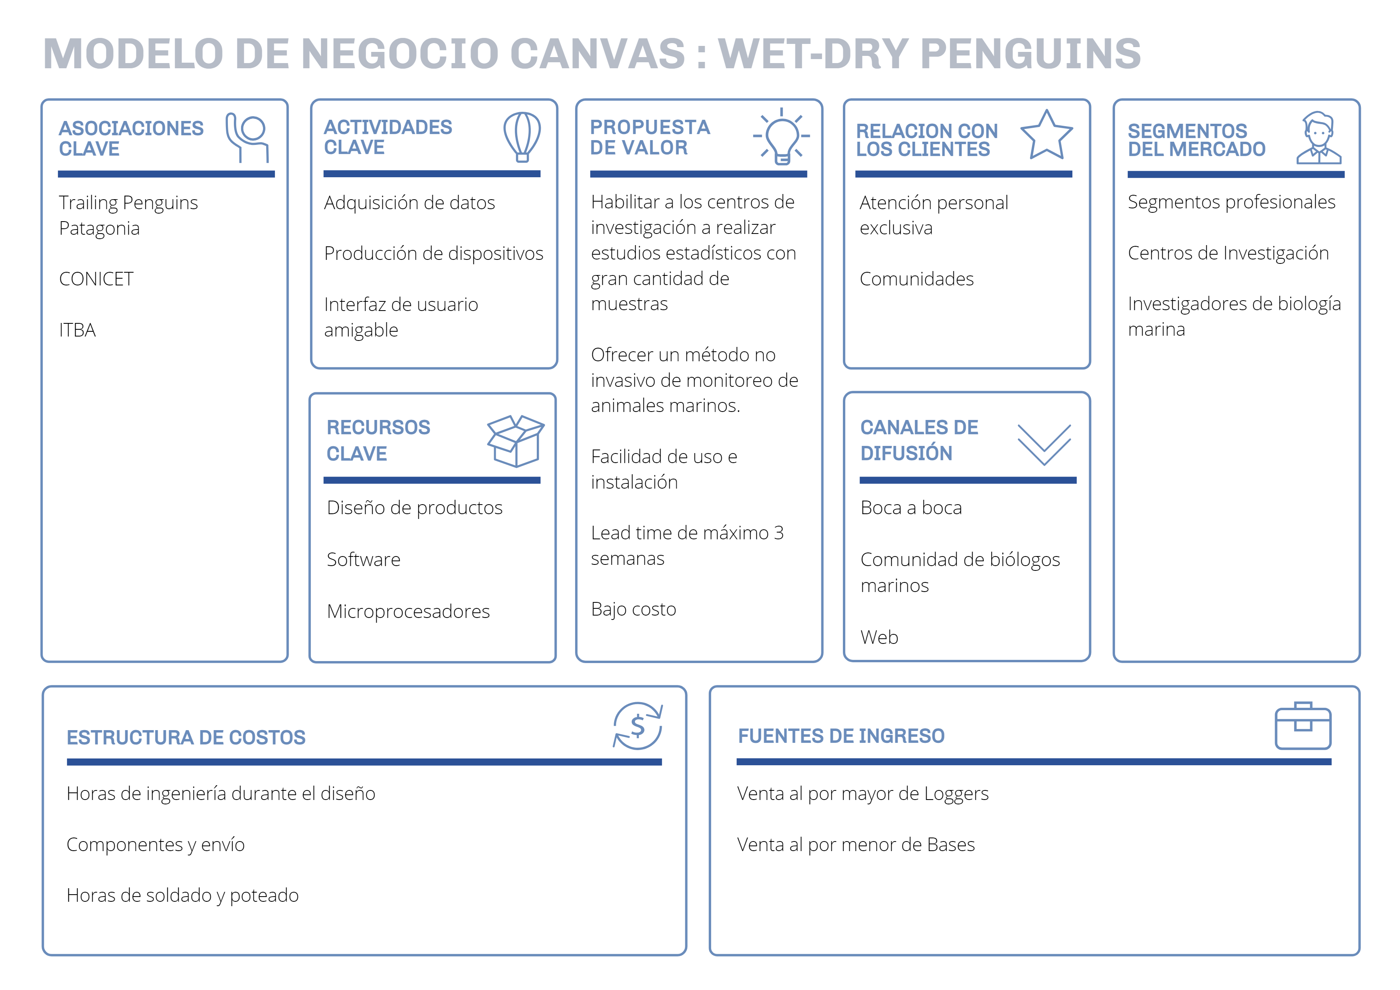
Documentación/Factibilidad económica/CANVAS.png
