odevincenti/Wet-DryPenguins/Documentación/PCB_Base_Real.jpeg

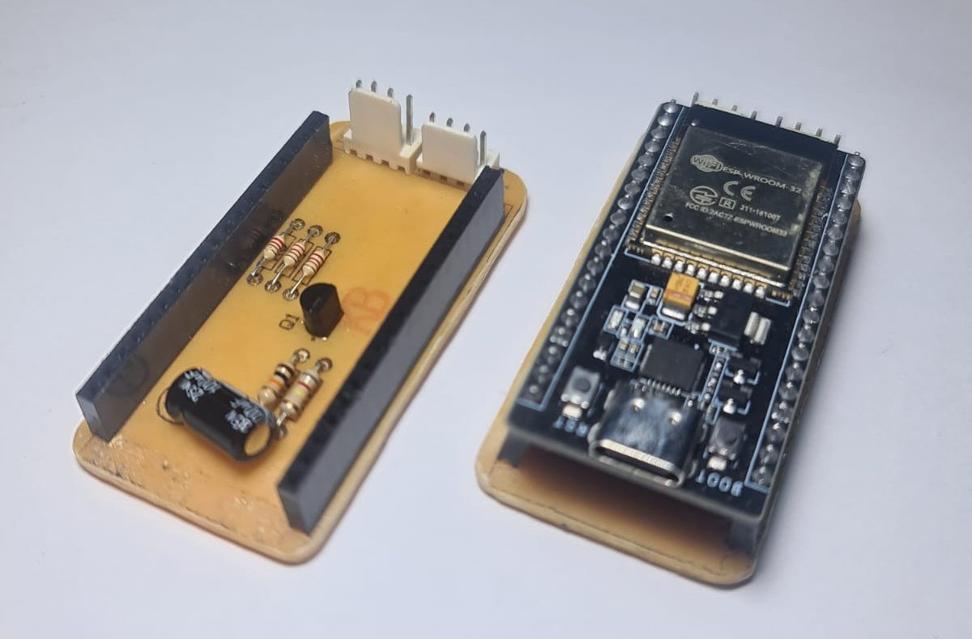
Documentación/PCB_Base_Real.jpeg
