odevincenti/Wet-DryPenguins/PCB/Penguin Base/Base_V2.png

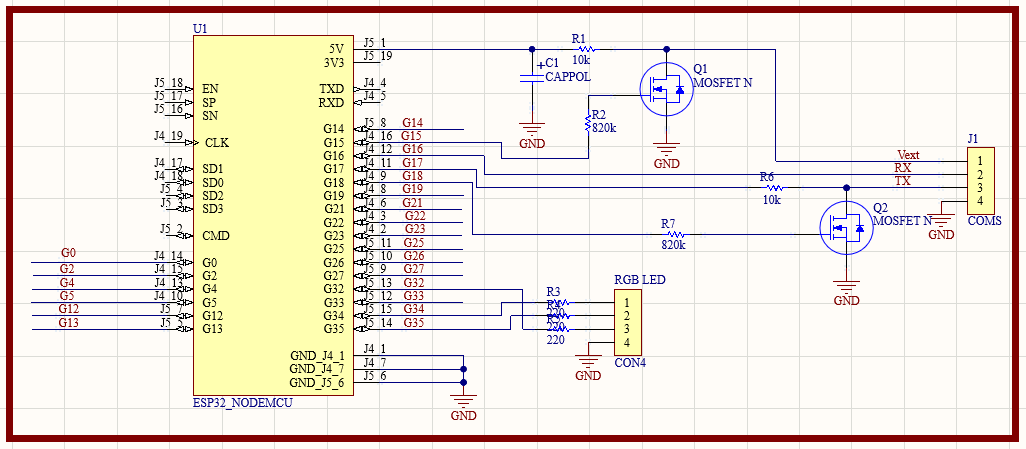
PCB/Penguin Base/Base_V2.png
