odevincenti/Wet-DryPenguins/PCB/terrifiednootnoot.png

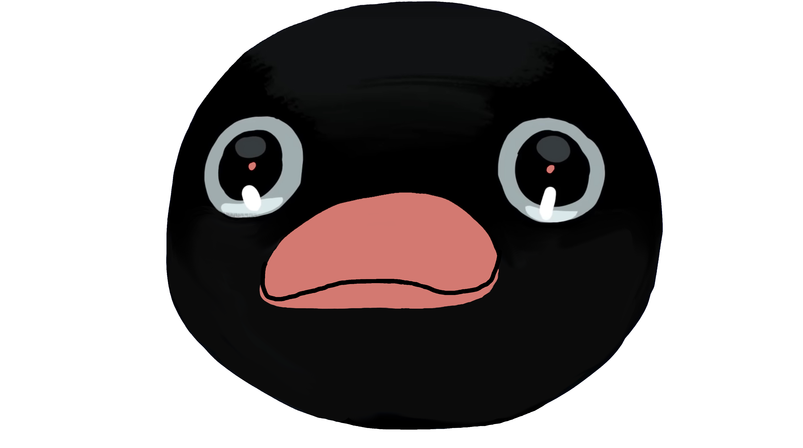
PCB/terrifiednootnoot.png
