odevincenti/Wet-DryPenguins/PCB/Tracker_Prototype/3D_View_V3.png

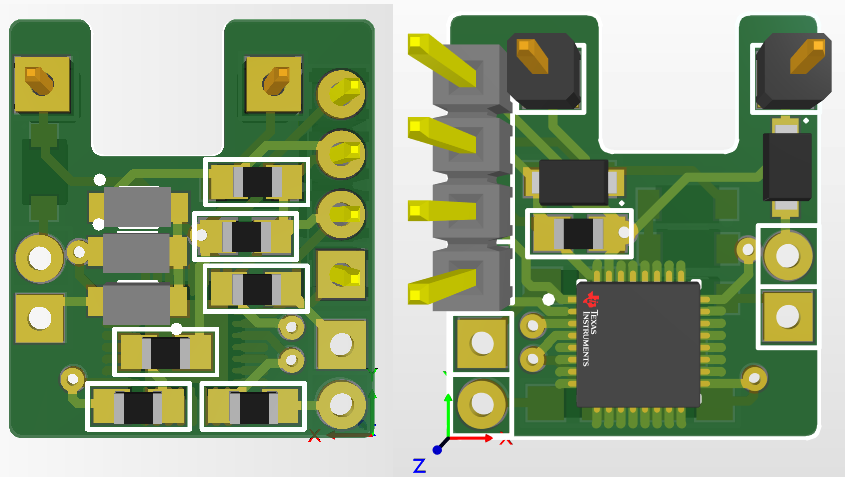
PCB/Tracker_Prototype/3D_View_V3.png
