odevincenti/Wet-DryPenguins/PCB/Tracker_Prototype/ReferenceV3.png

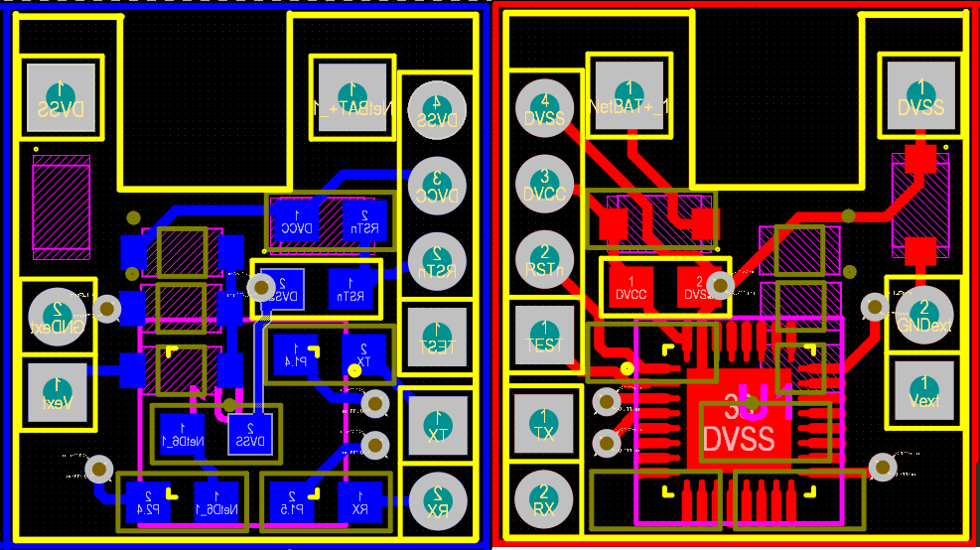
PCB/Tracker_Prototype/ReferenceV3.png
