odevincenti/Wet-DryPenguins/PCB/Tracker_Prototype/ReferenceV3_inverted.png

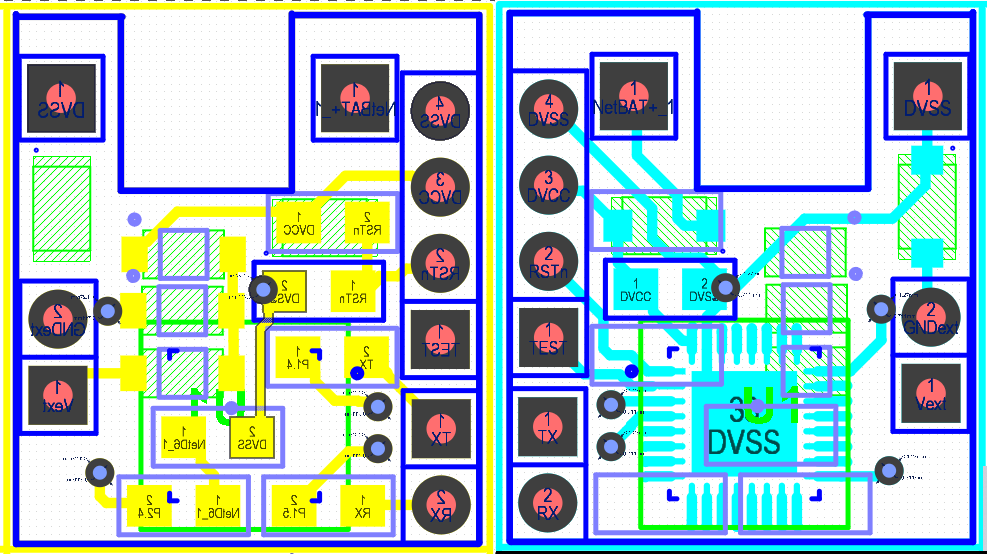
PCB/Tracker_Prototype/ReferenceV3_inverted.png
