odevincenti/Wet-DryPenguins/Documentación/Tablas/12-1 Descripción de los módulos - BOMs.xlsx

Sheet: BOM Logger
Componente | Código | Cantidad
Microprocesador | MSP430FR2476TRHBR | 1
Diodo Schottky | CDBQR70 | 2
Diodo Rectificador | 1N4148WL2-TP | 3
LED Verde | LTST-C171GKT | 1
Capacitor 100n | CL05B104KP5VPNC | 1
Capacitor 4.7n | C0402C472K5RECAUTO | 1
RES100 | RC0402FR-07100RL | 2
RES47K | ERJ-2GEJ473X | 1
RES2K2 | RC0402FR-072K2L | 1
Pines | 6136-0-00-15-00-00-03-0 | 4
Pilas | SR626 | 2

Sheet: BOM Base
Componente | Código | Cantidad
Microprocesador | ESP32 NodeMCU | 1
Transistor MOS | BS170-ND | 2
Capacitor Elec 10uF x 16V | ECA-1CM100I | 1
RES220 | CF14JT220R | 3
RES10K | CF14JT10K | 2
RES820K | CF14JT820K | 2
LED RGB 5mm | HV-5RGB25 | 1
Terminal Macho Molex 4 pines | 22232041 | 2
Tira de 19 pines Hembra | PH1-20-UA | 2
