odevincenti/Wet-DryPenguins/Documentación/Tablas/9-2 Especificación de Tests.xlsx

Sheet: 8.2 Especificación de tests
ID | Descripción | Dependencia | Banco de pruebas
T-BASIC-01 | Validación de programación del dispositivo. | - | BP-01
T-BASIC-02 | Validación encendido del dispositivo. | T-BASIC-01
T-INT-FUNC-01 | Adquisición de medición de temperatura. | T-BASIC-02
T-INT-FUNC-02 | Adquisición de hora.
T-INT-FUNC-03 | Detección wet/dry.
T-INT-FUNC-04 | Medición de corriente durante adquisición de datos. | T-INT-FUNC-01 T-INT-FUNC-02 T-INT-FUNC-03
T-INT-FUNC-05 | Medición de corriente durante guardado de datos.
T-INT-FUNC-06 | Medición de corriente durante modo bajo consumo.
T-INT-FUNC-07 | Validación duración de batería. | T-INT-FUNC-04 T-INT-FUNC-05 T-INT-FUNC-06 | BP-02
T-INT-COM-01 | Validación de transmisión de datos. | T-INT-FUNC-07
T-INT-DIM-01 | Validación de dimensiones totales. | T-INT-COM-01 | BP-03
T-INT-DIM-02 | Validación de peso total. | T-INT-COM-01
T-INT-MEC-01 | Validación de funcionamiento bajo el agua. | T-INT-DIM-01 T-INT-DIM-02 | BP-04
T-INT-MEC-02 | Validación de funcionamiento a bajas temperaturas.
T-INT-MEC-03 | Validación de funcionamiento bajo presión.
T-INT-DATA-01 | Validación de recuperado de datos. | T-INT-MEC-01 T-INT-MEC-02 T-INT-MEC-03 | BP-05
T-INT-DATA-02 | Validación de datos obtenidos. | T-INT-DATA-01
T-INT-DATA-03 | Validación de archivos de datos crudos. | T-INT-DATA-02

Sheet: 8.2.1 Tests básicos
ID Aplicabilidad | Descripción | Criterio de aceptación
T-BASIC-01 BP-01 P | \tabitem Conectar el dispositivo al programador mediante el conector de programación. \tabitem Programar el dispositivo. \tabitem Observar al dispositivo durante la programación. | El dispositivo debe parpadear su LED interno, y el programador no debe devolver errores de programación.
T-BASIC-02 BP-01 P-F | \tabitem Conectar el dispositivo a la fuente de alimentación regulada mediante los conectores utilizados para la batería. \tabitem Programar la fuente a 3.3V con limitación de 100mA. \tabitem Encender la fuente de alimentación. \tabitem Observar al dispositivo al encender la fuente. | La fuente no debe alcanzar su limitación de corriente, y el dispositivo parpadea brevemente su LED interno. El parpadeo ocurre solo inicialmente y no vuelve a suceder mientras se mantenga energizado.

Sheet: 8.2.2 Test de funcionalidad
ID Aplicabilidad | Descripción | Criterio de aceptación
T-INT-FUNC-01 BP-01 P-F | \tabitem Cargar el programa de adquisición de datos al dispositivo. \tabitem Asegurar el dispositivo al termómetro calibrado. \tabitem Conectar al dispositivo a la fuente de alimentación programada para 3.3V con limitación de 100mA. \tabitem Guardar un registro con la temperatura medida por el termómetro. \tabitem Dejar que pasen al menos 5 horas. \tabitem Durante la etapa de recuperado de datos, comparar la temperatura medida con la registrada por el termómetro. | El dispositivo tiene un error absoluto menor a 2°C, con un período transitorio menor a 10 min.
T-INT-FUNC-02 BP-01 P-F | \tabitem Cargar el programa de adquisición de datos al dispositivo. \tabitem Conectar al dispositivo a la fuente de alimentación programada para 3.3V con limitación de 100mA. \tabitem Guardar un registro de la hora en la que se energiza el dispositivo. \tabitem Guardar un registro de la hora en la que ocurren los eventos de las pruebas T-INT-FUNC-01 y T-INT-FUNC-02. \tabitem Durante la etapa de recuperado de datos, comparar el horario de los eventos registrados por el dispositivo y los registrados de forma externa. | El dispositivo devuelve el horario de los eventos transcurridos durante las pruebas con un error máximo de 1min
T-INT-FUNC-03 BP-01 P-F | \tabitem Cargar el programa de adquisición de datos al dispositivo. \tabitem Conectar al dispositivo a la fuente de alimentación programada para 3.3V con limitación de 100mA. \tabitem Conectar cables a los pines de sensado del dispositivo. \tabitem Sumergir los cables en el recipiente con agua salada en inervalos aleatorios. \tabitem Registrar los horarios de transición entre mojado y seco. \tabitem Durante la etapa de recuperado de datos, comparar el horario de los eventos registrados por el dispositivo y los registrados de forma externa. | El dispositivo detecta correctamente las transiciones entre agua salada y aire.
T-INT-FUNC-04 BP-01 P | \tabitem Cargar el programa de adquisición de datos al dispositivo. \tabitem Conectar al dispositivo a la fuente de alimentación programada para 3.3V con limitación de 100mA. \tabitem Conectar un amperímetro entre la fuente y el dispositivo. \tabitem Observar el consumo de corriente durante la adquisición de datos. | La corriente de entrada durante la adquisición de datos no supera 1mA.
T-INT-FUNC-05 BP-01 P | \tabitem Cargar el programa de adquisición de datos al dispositivo. \tabitem Conectar al dispositivo a la fuente de alimentación programada para 3.3V con limitación de 100mA. \tabitem Conectar un amperímetro entre la fuente y el dispositivo. \tabitem Observar el consumo de corriente durante el guardad de datos. | La corriente de entrada durante el guardado de datos no supera 1mA.
T-INT-FUNC-06 BP-01 P | \tabitem Cargar el programa de adquisición de datos al dispositivo. \tabitem Conectar al dispositivo a la fuente de alimentación programada para 3.3V con limitación de 100mA. \tabitem Conectar un amperímetro entre la fuente y el dispositivo. \tabitem Observar el consumo de corriente durante el modo de bajo consumo. | La corriente de entrada durante modo de bajo consumo no supera 1uA.
T-INT-FUNC-07 BP-02 P | \tabitem Cargar el programa de adquisición de datos en tiempo acelerado. \tabitem El programa simula la adquisición de datos de 60 días en 25 días. \tabitem Conectar dos pilas nuevas al dispositivo. \tabitem Dejar que pasen 25 días. | El dispositivo sigue energizado luego de la prueba y el LED sigue parpadeando.

Sheet: 8.2.3 Test de comunicación
ID Aplicabilidad | Descripción | Criterio de aceptación
T-INT-COM-01 BP-02 P-F | \tabitem Cargar el programa de adquisición de datos al dispositivo. \tabitem Asegurarse que el dispositivo este conectado a su batería mediante los conectores en la placa. \tabitem Utilizar el registro de eventos durante las pruebas anteriores. \tabitem Conectar cables a los conectores de comunicación y alimentación externa. \tabitem Conectar los cables a la base. \tabitem Conectar la base a una computadora y abrir el puerto serie correspondiente a la base. \tabitem Interactuar con la interfaz de obtención de datos propia del dispositivo. \tabitem Confirmar la recepción de datos. | Los datos registrados por el dispositivo son válidos y se reciben en la consola de comandos correctamente.

Sheet: 8.2.2 Test mecánicos
ID Aplicabilidad | Descripción | Criterio de aceptación
T-INT-DIM-01 BP-03 P-F | \tabitem Utilizar el dispositivo luego de su baño en resina, una vez que está endurecido y fuera del molde. \tabitem Utilizar un elemento de medición con precisión igual o mejor que 0.1mm. \tabitem Medir ancho, alto y profundidad del dispositivo con su recubrimiento, sin contar los conectores expuestos de medición y alimentación externa. | El dispositivo tiene dimensiones comprendidas dentro de un prisma de 40mm de ancho, 40mm de largo y 20mm de profundidad.
T-INT-DIM-02 BP-03 P-F | \tabitem Utilizar el dispositivo luego de su baño en resina, una vez que está endurecido y fuera del molde. \tabitem Utilizar una balanza digital con precisión igual o mejor que 0.1g. \tabitem Medir el peso del dispositvo final. | El dispositivo tiene un peso menor a 10g, incluyendo circuito electrónico, fuente de energía y recubrimiento.
T-INT-MEC-01 BP-04 P-F | \tabitem Utilizar el dispositivo luego de su baño en resina, una vez que está endurecido y fuera del molde. \tabitem Utilizar el programa que hace parpadear el LED interno. \tabitem Sumergir el dispositivo en un contenedor con agua salada por al menos una hora. \tabitem Retirar el dispositivo. \tabitem Comprobar el estado del LED interno. \tabitem Comunicarse con el dispositivo. | El dispositivo sigue parpadeando el LED interno, y al comunicarse no se encuentran errores de comunicación.
T-INT-MEC-02 BP-04 P-F | \tabitem Utilizar el dispositivo luego de su baño en resina, una vez que está endurecido y fuera del molde. \tabitem Utilizar el programa que hace parpadear el LED interno. \tabitem Sumergir el dispositivo en un contenedor con agua salada a una temperatura igual o menor a 3°C por al menos una hora. \tabitem Retirar el dispositivo. \tabitem Comprobar el estado del LED interno. \tabitem Comunicarse con el dispositivo. | El dispositivo sigue parpadeando el LED interno, y al comunicarse no se encuentran errores de comunicación.
T-INT-MEC-03 BP-04 P-F | \tabitem Utilizar el dispositivo luego de su baño en resina, una vez que está endurecido y fuera del molde. \tabitem Utilizar el programa que hace parpadear el LED interno. \tabitem Sumergir el dispositivo en una cámara de presión capaz de generar un mínimo de 10bar de presión. \tabitem Llenar la cámara de presión con agua salada. \tabitem Utilizar un manómetro con presición igual o mejor que 0.5bar \tabitem Sellar la cámara. \tabitem Elevar la presión hasta 10bar en menos de 10 segundos y mantenerla durante una hora. \tabitem Despresurizar la cámara en menos de 10 segundos. \tabitem Retirar el dispositivo. \tabitem Comprobar el estado del LED interno. \tabitem Comunicarse con el dispositivo. | El dispositivo sigue parpadeando el LED interno, y al comunicarse no se encuentran errores de comunicación.

Sheet: 8.2.2 Test de integridad de dat
ID Aplicabilidad | Descripción | Criterio de aceptación
T-INT-DATA-01 BP-05 P-F | \tabitem Utilizar el dispositivo luego de su baño en resina, una vez que está endurecido y fuera del molde. \tabitem Utilizar los registros de eventos de las pruebas anteriores. \tabitem Conectar el dispositivo a la base. \tabitem Conectar la base a la computadora corriendo la PenGUI. | La PenGUI reconoce al dispositivo y recupera correctamente su número de identificación.
T-INT-DATA-02 BP-05 P-F | \tabitem Utilizar el dispositivo conectado a la base, conectada a la computadora corriendo la PenGUI. \tabitem Presionar el botón para visualizar los datos crudos en la PenGUI. | Los datos recuperados y visualizados coinciden con los datos registrados en pruebas anteriores.
T-INT-DATA-03 BP-05 P-F | \tabitem Utilizar el dispositivo conectado a la base, conectada a la computadora corriendo la PenGUI. \tabitem Presionar el botón descargar los datos crudos en la PenGUI. \tabitem Importar los datos descargados en la PenGUI y visualizarlos | Los datos importados y visualizados coinciden con los datos registrados en pruebas anteriores.
