odevincenti/Wet-DryPenguins/Documentación/Tablas/8-3 Especificaciones de Diseño.xlsx

Sheet: Especificaciones funcionales
Leyenda para especificaciones |  | ID | Descripción | Origen | Aplicabilidad Validación
Aplicabilidad | Validación | INT-FUN-01 | El dispositivo debe ser capaz de detectar si se encuentra en la tierra o en el mar. | REQ-04 | P-F S-T
P: Prototipo | I: Inspección Visual | INT-FUN-02 | El dispositivo debe ser capaz de obtener la temperatura del entorno cuando se encuentre sumergido. | REQ-04 | P-F S-T
 | D: Documentación de diseño | INT-FUN-03 | El dispositivo deberá contar con un espacio de almacenamiento de datos de un tamaño entre 1.5KB y 95KB. | REQ-04 | P-F D-S-T
F: Producto Final | S: Simulación | INT-FUN-04 | El dispositivo deberá tomar las mediciones con un período mínimo de 30 segundos. | REQ-08 | P-F T
 | T: Test | INT-FUN-05 | El dispositivo deberá tomar las mediciones con un período máximo de 60 minutos. | REQ-08 | P-F T
 |  | INT-FUN-06 | El dispositivo debe ser capaz de devolver el registro de la fecha y hora correcta luego de ser previamente configurada. | REQ-05 | P-F T
 |  | INT-FUN-07 | El dispositivo debe transmitir los datos almacenados a la base según todas las especificaciones de la Tabla INT-COM1. | REQ-07 | P-F T
 |  | INT-FUN-08 | La base debe transmitir los datos almacenados a la computadora según todas las especificaciones de la Tabla INT-COM2. | REQ-08 | P-F T
 |  | INT-FUN-09 | El programa de descarga de datos (PenGUI) deberá permitir la descarga de datos desde la base. | REQ-07 | P-F S-T
 |  | INT-FUN-10 | A partir de los datos del dispositivo, debe poder obtenerse el patrón de comportamiento del pingüino bajo estudio. | REQ-04 | P-F T

Sheet: Especificaciones de interfaz
ID | Descripción | Origen | Aplicabilidad Validación
INT-COM1-01 | La transmisión de datos debe realizarse desde el dispositivo hacia la base. | REQ-07 | P-F I-T
INT-COM1-02 | La transmisión de datos debe realizarse por medio de un protocolo serie que minimice la cantidad de líneas. | REQ-07 | P-F I-D-T
INT-COM1-03 | La transmisión de datos se efectúa una vez que el dispositivo esté acoplado a la base. | REQ-07 | P-F I-T
ID | Descripción | Origen | Aplicabilidad Validación
INT-COM2-01 | La transmisión de datos debe realizarse desde la base hasta la PenGUI. | REQ-07 | P-F I-T
INT-COM2-02 | La transmisión de datos debe realizarse por medio de un protocolo USB 3.0 a través de un cable USB-C a USB-A. | REQ-07 | P-F I-T
INT-COM2-03 | La transmisión de datos debe ser inicializada de modo manual a través de la PenGUI. | REQ-07 | P-F I-S-T

Sheet: Especificaciones dimensionales
ID | Descripción | Origen | Aplicabilidad Validación
IMP-DIM-01 | El dispositivo debe poder asegurarse a la pata de un pingüino mediante precintos. | REQ-01 | P-F I-T
IMP-DIM-02 | El dispositivo debe tener dimensiones comprendidas dentro de un prisma de 40mm de ancho, 40mm de largo y 20mm de profundidad. | REQ-14 | P-F I-T
IMP-DIM-03 | El dispositivo debe tener un peso menor a 10g, incluyendo circuito electrónico, fuente de energía y recubrimiento. | REQ-15 | P-F I-T

Sheet: Especificaciones de costo
ID | Descripción | Origen | Aplicabilidad Validación
IMP‐COS‐01 | El dispositivo debe tener un costo menor o igual a 30 USD. | REQ-16 | P-F I

Sheet: Especificaciones de confiabilid
ID | Descripción | Origen | Aplicabilidad Validación
RAM‐CON‐01 | El dispositivo debe tener una vida útil mayor a 60 días. | REQ-02 | P-F I-T

Sheet: Especificaciones de operación
ID | Descripción | Origen | Aplicabilidad Validación
IMP-OPE-1 | El dispositivo debe poder operar en temperaturas entre 3°C y 50°C. | REQ-09 REQ-10 | P-F I-T
IMP-OPE-2 | El dispositivo debe poder operar a una presión constante de hasta 8bar. | REQ-11 REQ-12 | P-F I-T
IMP-OPE-3 | El dispositivo debe poder soportar cambios de presión menores a 0.8 bar/seg. | REQ-13 | P-F I-T
IMP-OPE-4 | El dispositivo debe tener un recubrimiento que lo vuelva impermeable y lo proteja del ambiente. | REQ-06 REQ-09 | P-F I-T
