odevincenti/Wet-DryPenguins/Documentación/Modelos 3D/Base_spring_holder_V2.SLDPRT

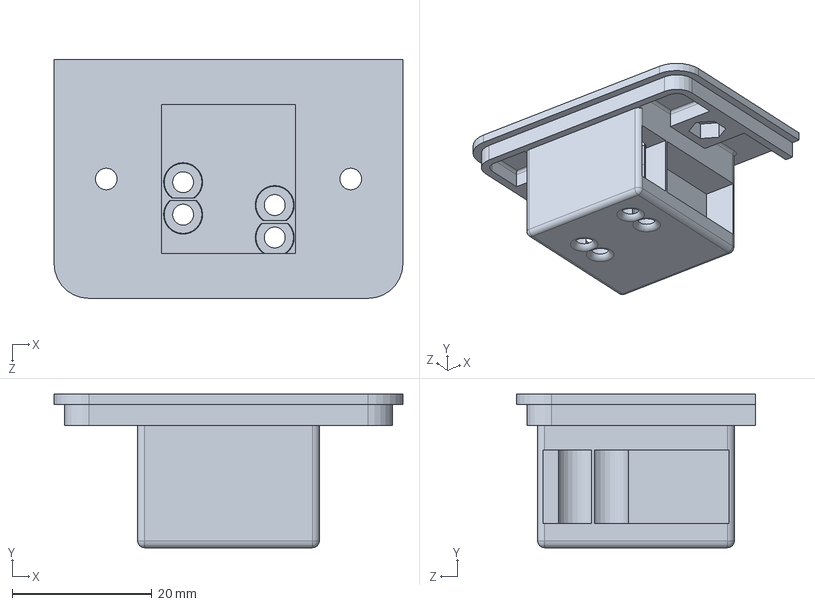
[picture p43: CAD file, 2024-02-06]
Documentación/Modelos 3D/Base_spring_holder_V2.SLDPRT
50.0 x 22.0 x 34.2 mm
