odevincenti/Wet-DryPenguins/Documentación/Modelos 3D/Base_top.SLDPRT

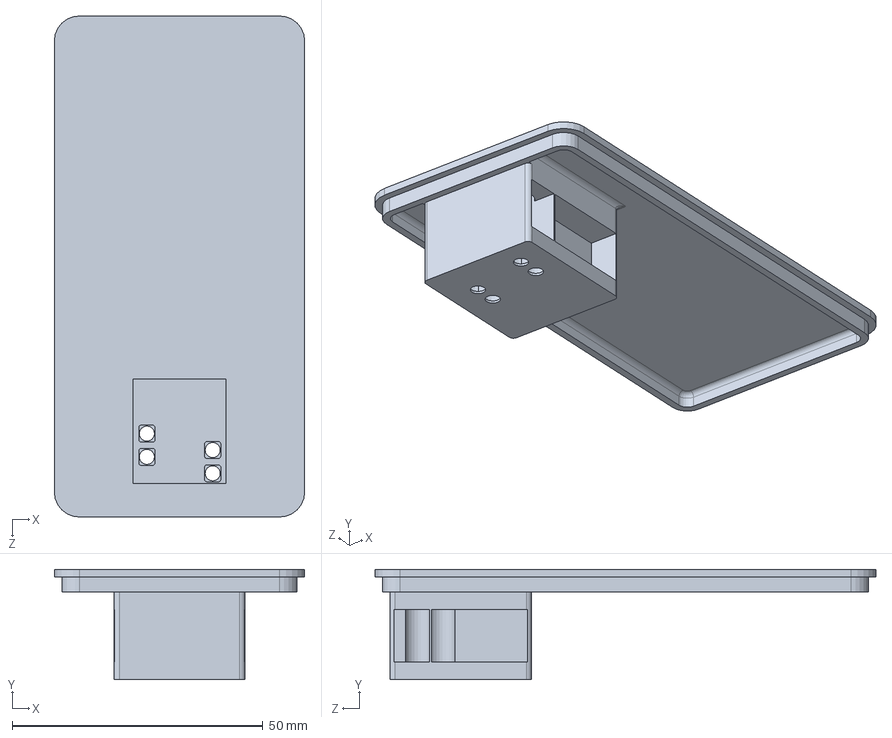
[picture p44: CAD file, 2024-02-06]
Documentación/Modelos 3D/Base_top.SLDPRT
50.0 x 22.0 x 100.0 mm
