odevincenti/Wet-DryPenguins/Documentación/Modelos 3D/Basedelabase.SLDPRT

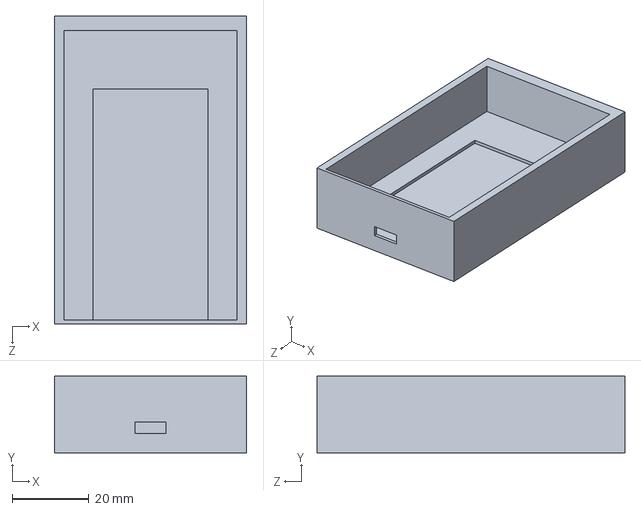
[picture p45: CAD file, 2024-02-06]
Documentación/Modelos 3D/Basedelabase.SLDPRT
50.0 x 20.0 x 80.0 mm
