odevincenti/Wet-DryPenguins/Documentación/Modelos 3D/Base_lip.STL

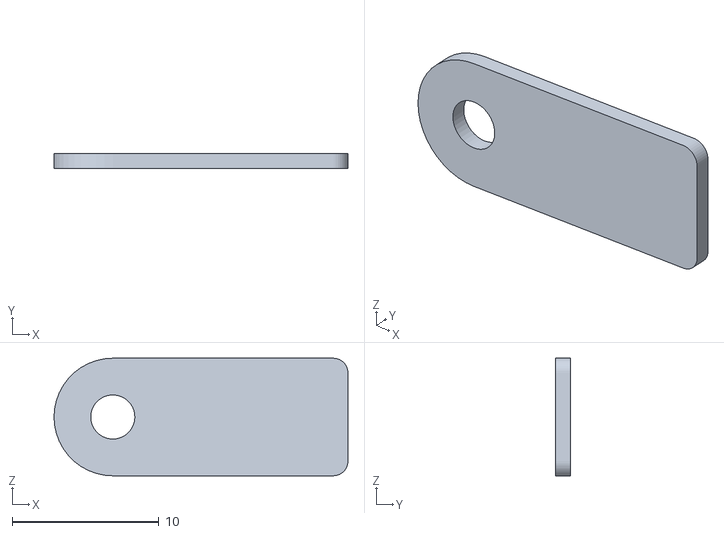
[picture p46: CAD file, 2024-02-06]
Documentación/Modelos 3D/Base_lip.STL
20.0 x 1.00 x 8.00
