odevincenti/Wet-DryPenguins/Documentación/Modelos 3D/Base_bottom.SLDPRT

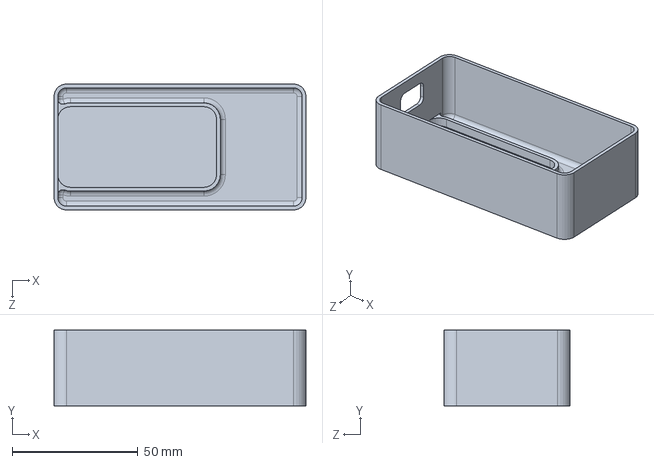
[picture p47: CAD file, 2024-02-06]
Documentación/Modelos 3D/Base_bottom.SLDPRT
100.0 x 30.0 x 50.0 mm
