odevincenti/Wet-DryPenguins/Documentación/Modelos 3D/Base_test_slider.SLDPRT

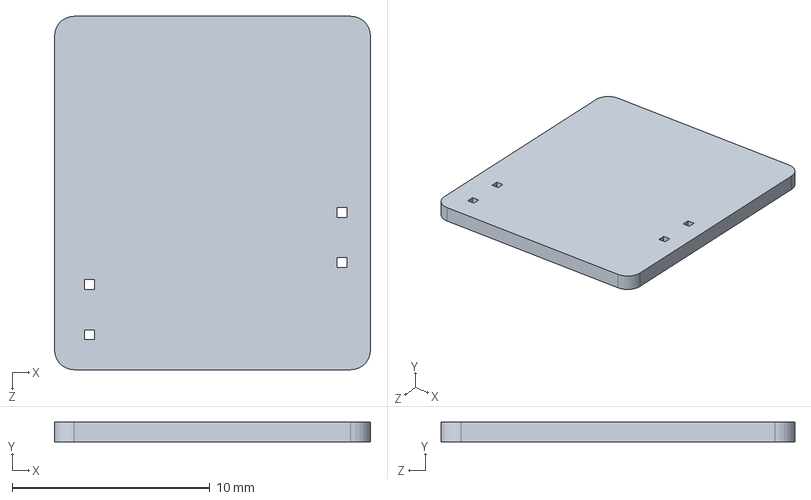
[picture p48: CAD file, 2024-02-06]
Documentación/Modelos 3D/Base_test_slider.SLDPRT
16.0 x 1.00 x 17.9 mm
