odevincenti/Wet-DryPenguins/Documentación/Modelos 3D/Base_contact.STL

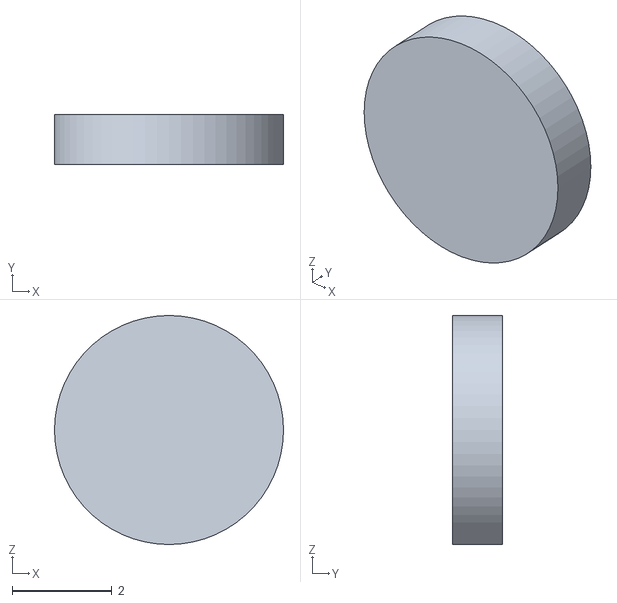
[picture p49: CAD file, 2024-02-06]
Documentación/Modelos 3D/Base_contact.STL
4.60 x 1.00 x 4.60
