odevincenti/Wet-DryPenguins/Documentación/Modelos 3D/Base_spring_holder.STL

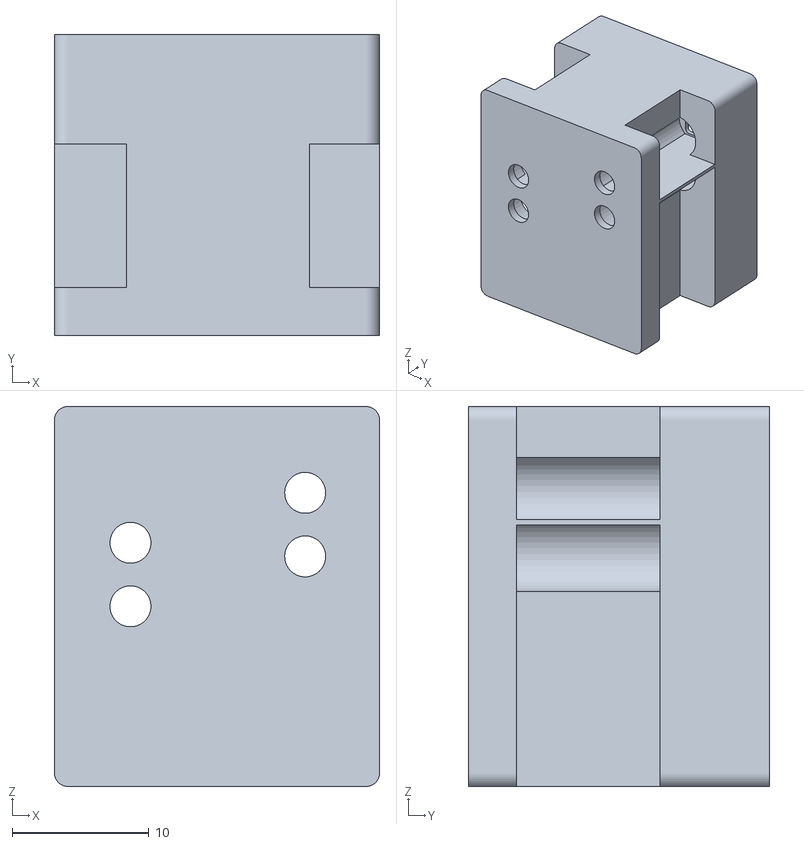
[picture p50: CAD file, 2024-02-06]
Documentación/Modelos 3D/Base_spring_holder.STL
23.8 x 22.0 x 27.8
