odevincenti/Wet-DryPenguins/Documentación/Modelos 3D/Screw_tower_bot.SLDPRT

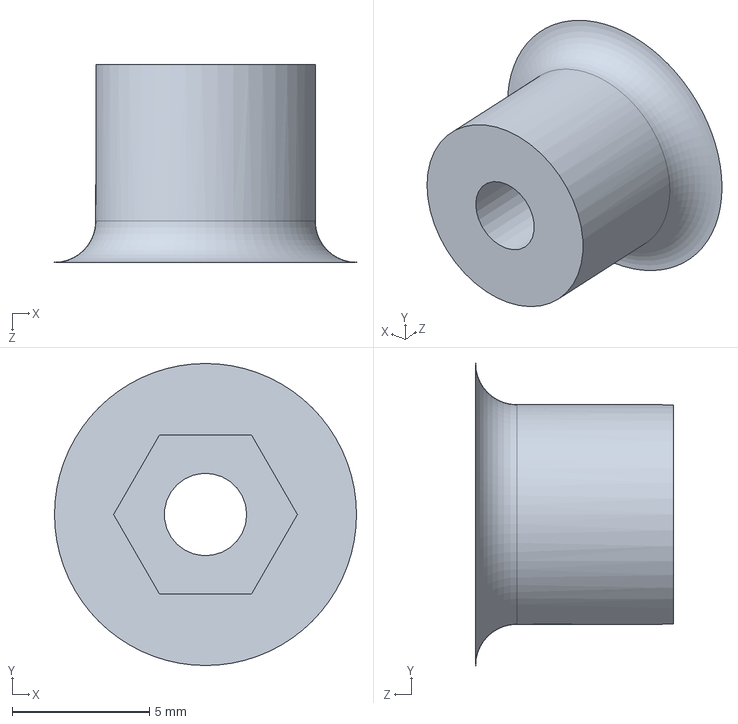
[picture p51: CAD file, 2024-02-06]
Documentación/Modelos 3D/Screw_tower_bot.SLDPRT
11.0 x 11.0 x 7.20 mm
