odevincenti/Wet-DryPenguins/(list of files, cad)

Other CAD files:
Documentación/Modelos 3D/Base_top_clipper_V2.STL
Documentación/Modelos 3D/Base_top_clipper.STL
Documentación/Modelos 3D/Base_bottom.STL
Documentación/Modelos 3D/Base_spring_holder_V2.STL
Documentación/Modelos 3D/Base_test_slider.STL
Documentación/Modelos 3D/Base_top.STL
Documentación/Modelos 3D/Screw_tower_bot.STL
Documentación/Modelos 3D/basetop.SLDPRT
PCB/Tracker_Prototype/LIB_CR1216_MFR_SM/CR1216_MFR_SM/Allegro/cr1216mfrsm.psm
PCB/Tracker_Prototype/LIB_CR1216_MFR_SM/CR1216_MFR_SM/DEHDL/cr1216_mfr_sm/chips/chips.prt
