odevincenti/Wet-DryPenguins/Documentación/Diagramas y Gráficos/Diagramas en bloque/12 - Construcción del prototipo/Logger_Schem_V3.png

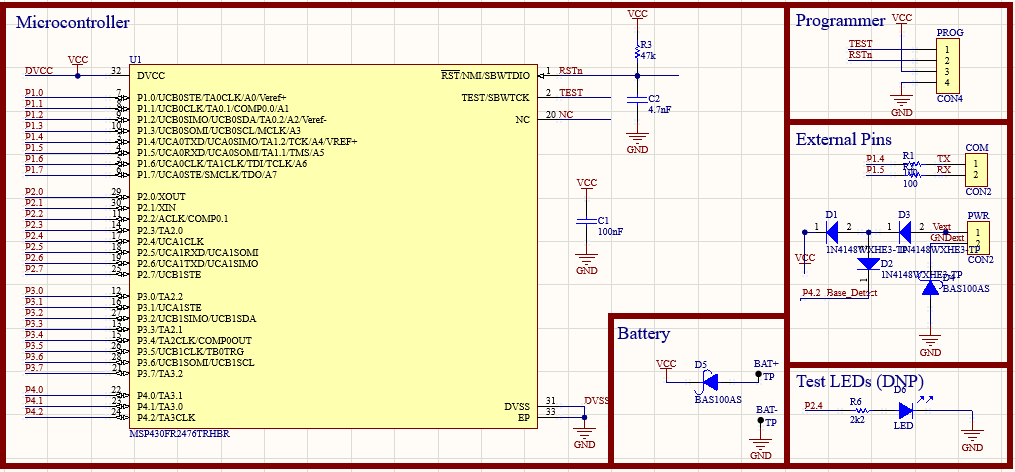
Documentación/Diagramas y Gráficos/Diagramas en bloque/12 - Construcción del prototipo/Logger_Schem_V3.png
