odevincenti/Wet-DryPenguins/Pruebas Experimentales/Prueba Temperatura/Pruebas viejas/Prueba 1/output_from_msp_PRUEBA_TEMPERATURA_OLI_06.txt

OK
ACTIVATED MASTER CONTROL

	SENDING: ?
	MESSAGE RECEIVED!
	INPUT BUFFER INDEX = 160 / 5000
	INPUT BUFFER WRITING TIME = 18

Repeating ...0x21
Unknown Command
DEBUG MENU

G = Get
S = Set
N = Change Penguin Name
L = Toggle LED
> = USER MENU
? = Repeat
Q = Quit

*************************

	SENDING: G
	MESSAGE RECEIVED!
	INPUT BUFFER INDEX = 274 / 5000
	INPUT BUFFER WRITING TIME = 29
0x6
GETTING...

1 = Device active
2 = Wet and Dry active
3 = Temperature active
4 = Wet and Dry Period
5 = Temperature Period
6 = Calibrated Minute Value
7 = Penguin Name
8 = Penguin ID
9 = Starting Date
0 = Calibration values
? = Repeat
< = Return

*************************

	SENDING: 1
	MESSAGE RECEIVED!
	INPUT BUFFER INDEX = 156 / 5000
	INPUT BUFFER WRITING TIME = 18
0x6
device_is_active = FALSE

DEBUG MENU

G = Get
S = Set
N = Change Penguin Name
L = Toggle LED
> = USER MENU
? = Repeat
Q = Quit

*************************

	SENDING: G
	MESSAGE RECEIVED!
	INPUT BUFFER INDEX = 274 / 5000
	INPUT BUFFER WRITING TIME = 29
0x6
GETTING...

1 = Device active
2 = Wet and Dry active
3 = Temperature active
4 = Wet and Dry Period
5 = Temperature Period
6 = Calibrated Minute Value
7 = Penguin Name
8 = Penguin ID
9 = Starting Date
0 = Calibration values
? = Repeat
< = Return

*************************

	SENDING: 2
	MESSAGE RECEIVED!
	INPUT BUFFER INDEX = 161 / 5000
	INPUT BUFFER WRITING TIME = 17
0x6
wet_and_dry_is_active = FALSE

DEBUG MENU

G = Get
S = Set
N = Change Penguin Name
L = Toggle LED
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
7 = Penguin Name
8 = Penguin ID
9 = Starting Date
0 = Calibration values
? = Repeat
< = Return

*************************

	SENDING: 9
	MESSAGE RECEIVED!
	INPUT BUFFER INDEX = 168 / 5000
	INPUT BUFFER WRITING TIME = 19
0x6
starting_date = 23-jun-1991 12:00:00

DEBUG MENU

G = Get
S = Set
N = Change Penguin Name
L = Toggle LED
> = USER MENU
? = Repeat
Q = Quit

*************************

	SENDING: G
	MESSAGE RECEIVED!
	INPUT BUFFER INDEX = 274 / 5000
	INPUT BUFFER WRITING TIME = 29
0x6
GETTING...

1 = Device active
2 = Wet and Dry active
3 = Temperature active
4 = Wet and Dry Period
5 = Temperature Period
6 = Calibrated Minute Value
7 = Penguin Name
8 = Penguin ID
9 = Starting Date
0 = Calibration values
? = Repeat
< = Return

*************************

	SENDING: 0
	MESSAGE RECEIVED!
	INPUT BUFFER INDEX = 211 / 5000
	INPUT BUFFER WRITING TIME = 32
0x6
CALADC_15V_30C = 2183

CALADC_15V_105C = 2755

ADC_GAIN = 32740

ADC_OFFSET = 2

DEBUG MENU

G = Get
S = Set
N = Change Penguin Name
L = Toggle LED
> = USER MENU
? = Repeat
Q = Quit

*************************

	SENDING: L
	MESSAGE RECEIVED!
	INPUT BUFFER INDEX = 138 / 5000
	INPUT BUFFER WRITING TIME = 16
0x6
LED ON

DEBUG MENU

G = Get
S = Set
N = Change Penguin Name
L = Toggle LED
> = USER MENU
? = Repeat
Q = Quit

*************************

	SENDING: L
	MESSAGE RECEIVED!
	INPUT BUFFER INDEX = 139 / 5000
	INPUT BUFFER WRITING TIME = 16
0x6
LED OFF

DEBUG MENU

G = Get
S = Set
N = Change Penguin Name
L = Toggle LED
> = USER MENU
? = Repeat
Q = Quit

*************************

	SENDING: >
	MESSAGE RECEIVED!
	INPUT BUFFER INDEX = 643 / 5000
	INPUT BUFFER WRITING TIME = 78
0x6
PROGRAMMED STATE = INACTIVE

memory_full = FALSE

svsh_fault = FALSE

resets_since_last_communication = 0

temperature_index = 74

wet_and_dry_index = 74

temperature_index == MAX_INDEX_SIZE = FALSE

wet_and_dry_index == MAX_INDEX_SIZE = FALSE

get_next_pointed_temperature_byte() = -4918

get_next_pointed_wet_and_dry_byte() = -32759

get_next_pointed_wet_and_dry_bit() = 2

USER MENU

Attention! Before starting new state, change periods in DEBUG MENU
G = Get tracking data
F = Get tracking data fast
E = Events
< = Go back to DEBUG MENU
> = Set new state (either start tracking or turn off)
? = Repeat
Q = Quit

*************************

	SENDING: E
	MESSAGE RECEIVED!
	INPUT BUFFER INDEX = 3661 / 5000
	INPUT BUFFER WRITING TIME = 856
0x6
last_events_index = 5

looping_events = FALSE
21	21	False base detect
21	21	False base detect
74	74	UART communication
74	74	False base detect
74	74	UART communication
12722	921	Reset while sensing
12723	921	Reset while sensing
12724	921	Reset while sensing
12726	922	Reset while sensing
12727	922	Reset while sensing
12728	922	Reset while sensing
12729	922	Reset while sensing
12730	922	Reset while sensing
12731	922	Reset while sensing
12732	922	Reset while sensing
12733	922	Reset while sensing
12734	922	Reset while sensing
12735	922	Reset while sensing
12736	922	Reset while sensing
12737	922	Reset while sensing
12738	922	Reset while sensing
12739	922	Reset while sensing
12740	922	Reset while sensing
12741	922	Reset while sensing
12742	922	Reset while sensing
12743	922	Reset while sensing
12746	924	Reset while sensing
12747	924	Reset while sensing
12748	924	Reset while sensing
12749	924	Reset while sensing
12750	924	Reset while sensing
12751	924	Reset while sensing
12752	924	Reset while sensing
12753	924	Reset while sensing
12754	924	Reset while sensing
12755	924	Reset while sensing
12756	924	Reset while sensing
12757	924	Reset while sensing
12758	924	Reset while sensing
12759	924	Reset while sensing
12760	924	Reset while sensing
12761	924	Reset while sensing
12762	924	Reset while sensing
12763	924	Reset while sensing
12764	924	Reset while sensing
12765	924	Reset while sensing
12766	924	Reset while sensing
12768	925	Reset while sensing
12769	925	Reset while sensing
12770	925	Reset while sensing
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
255	255	255	255	255	255	255	255	255	255	255	255	255	255	255	255
255	255	255	255	255	255	255	255	255	255	255	255	255	255	255	255
255	255	255	255	255	255	255	255	255	255	255	255	255	255	255	255
255	255	255	255	255	255	255	255	255	255	255	255	255	255	255	255
255	255	255	255	255	255	255	255	255	255	255	255	255	255	255	255
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

PROGRAMMED STATE = INACTIVE

memory_full = FALSE

svsh_fault = FALSE

resets_since_last_communication = 0

temperature_index = 74

wet_and_dry_index = 74

temperature_index == MAX_INDEX_SIZE = FALSE

wet_and_dry_index == MAX_INDEX_SIZE = FALSE

get_next_pointed_temperature_byte() = -4918

get_next_pointed_wet_and_dry_byte() = -32759

get_next_pointed_wet_and_dry_bit() = 2

USER MENU

Attention! Before starting new state, change periods in DEBUG MENU
G = Get tracking data
F = Get tracking data fast
E = Events
< = Go back to DEBUG MENU
> = Set new state (either start tracking or turn off)
? = Repeat
Q = Quit

*************************

	SENDING: >
	MESSAGE RECEIVED!
	INPUT BUFFER INDEX = 157 / 5000
	INPUT BUFFER WRITING TIME = 17
0x6
INPUT = 

ENTER PASSWORD

WARNING! Changing state starts new tracking logs, deleting all previous data
< = Abort password input

*************************

	SENDING: N
	MESSAGE RECEIVED!
	INPUT BUFFER INDEX = 158 / 5000
	INPUT BUFFER WRITING TIME = 17
0x6
INPUT = *

ENTER PASSWORD

WARNING! Changing state starts new tracking logs, deleting all previous data
< = Abort password input

*************************

	SENDING: o
	MESSAGE RECEIVED!
	INPUT BUFFER INDEX = 159 / 5000
	INPUT BUFFER WRITING TIME = 17
0x6
INPUT = **

ENTER PASSWORD

WARNING! Changing state starts new tracking logs, deleting all previous data
< = Abort password input

*************************

	SENDING: o
	MESSAGE RECEIVED!
	INPUT BUFFER INDEX = 160 / 5000
	INPUT BUFFER WRITING TIME = 17
0x6
INPUT = ***

ENTER PASSWORD

WARNING! Changing state starts new tracking logs, deleting all previous data
< = Abort password input

*************************

	SENDING: t
	MESSAGE RECEIVED!
	INPUT BUFFER INDEX = 161 / 5000
	INPUT BUFFER WRITING TIME = 17
0x6
INPUT = ****

ENTER PASSWORD

WARNING! Changing state starts new tracking logs, deleting all previous data
< = Abort password input

*************************

	SENDING:  
	MESSAGE RECEIVED!
	INPUT BUFFER INDEX = 162 / 5000
	INPUT BUFFER WRITING TIME = 18
0x6
INPUT = *****

ENTER PASSWORD

WARNING! Changing state starts new tracking logs, deleting all previous data
< = Abort password input

*************************

	SENDING: n
	MESSAGE RECEIVED!
	INPUT BUFFER INDEX = 163 / 5000
	INPUT BUFFER WRITING TIME = 18
0x6
INPUT = ******

ENTER PASSWORD

WARNING! Changing state starts new tracking logs, deleting all previous data
< = Abort password input

*************************

	SENDING: o
	MESSAGE RECEIVED!
	INPUT BUFFER INDEX = 164 / 5000
	INPUT BUFFER WRITING TIME = 18
0x6
INPUT = *******

ENTER PASSWORD

WARNING! Changing state starts new tracking logs, deleting all previous data
< = Abort password input

*************************

	SENDING: o
	MESSAGE RECEIVED!
	INPUT BUFFER INDEX = 165 / 5000
	INPUT BUFFER WRITING TIME = 18
0x6
INPUT = ********

ENTER PASSWORD

WARNING! Changing state starts new tracking logs, deleting all previous data
< = Abort password input

*************************

	SENDING: t
	MESSAGE RECEIVED!
	INPUT BUFFER INDEX = 166 / 5000
	INPUT BUFFER WRITING TIME = 18
0x6
INPUT = *********

ENTER PASSWORD

WARNING! Changing state starts new tracking logs, deleting all previous data
< = Abort password input

*************************

	SENDING: !
	MESSAGE RECEIVED!
	INPUT BUFFER INDEX = 169 / 5000
	INPUT BUFFER WRITING TIME = 18
0x6
incorrect_password = FALSE

Input = 

INSERT DATE

Any letter or number = Write
- = Delete
> = Confirm starting date
? = Repeat
< = Return

*************************

	SENDING: >
	MESSAGE RECEIVED!
	INPUT BUFFER INDEX = 243 / 5000
	INPUT BUFFER WRITING TIME = 27
0x6
Starting date = 

SELECT NEW STATE AND QUIT

REMEMBER! After choosing an option, all previous data is lost
1 = INACTIVE
2 = WET AND DRY ONLY
3 = TEMPERATURE ONLY
4 = WET AND DRY & TEMPERATURE
? = Repeat
< = Return

*************************

	SENDING: 1
	 WARNING! MESSAGED NOT RECEIVED PROPERLY!!!
	INPUT BUFFER INDEX = 14 / 5000
	INPUT BUFFER WRITING TIME = 2000
0x6
Bye bye!
OK
