odevincenti/Wet-DryPenguins/Pruebas Experimentales/Prueba Temperatura/Pruebas viejas/Prueba 1/output_from_msp_PRUEBA_TEMPERATURA_OLI_23.txt

OK

ACTIVATED MASTER CONTROL

	SENDING: ?
	MESSAGE RECEIVED!
	INPUT BUFFER INDEX = 160 / 5000
	INPUT BUFFER WRITING TIME = 17

Repeating ...0x21
Unknown Command
DEBUG MENU

G = Get
S = Set
N = Change Penguin Name
L = Toggle LED
> = USER MENU
? = Repeat
Q = Quit

*************************

	SENDING: G
	MESSAGE RECEIVED!
	INPUT BUFFER INDEX = 274 / 5000
	INPUT BUFFER WRITING TIME = 29
0x6
GETTING...

1 = Device active
2 = Wet and Dry active
3 = Temperature active
4 = Wet and Dry Period
5 = Temperature Period
6 = Calibrated Minute Value
7 = Penguin Name
8 = Penguin ID
9 = Starting Date
0 = Calibration values
? = Repeat
< = Return

*************************

	SENDING: 1
	MESSAGE RECEIVED!
	INPUT BUFFER INDEX = 155 / 5000
	INPUT BUFFER WRITING TIME = 17
0x6
device_is_active = TRUE

DEBUG MENU

G = Get
S = Set
N = Change Penguin Name
L = Toggle LED
> = USER MENU
? = Repeat
Q = Quit

*************************

	SENDING: G
	MESSAGE RECEIVED!
	INPUT BUFFER INDEX = 274 / 5000
	INPUT BUFFER WRITING TIME = 29
0x6
GETTING...

1 = Device active
2 = Wet and Dry active
3 = Temperature active
4 = Wet and Dry Period
5 = Temperature Period
6 = Calibrated Minute Value
7 = Penguin Name
8 = Penguin ID
9 = Starting Date
0 = Calibration values
? = Repeat
< = Return

*************************

	SENDING: 2
	MESSAGE RECEIVED!
	INPUT BUFFER INDEX = 160 / 5000
	INPUT BUFFER WRITING TIME = 17
0x6
wet_and_dry_is_active = TRUE

DEBUG MENU

G = Get
S = Set
N = Change Penguin Name
L = Toggle LED
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
7 = Penguin Name
8 = Penguin ID
9 = Starting Date
0 = Calibration values
? = Repeat
< = Return

*************************

	SENDING: 9
	MESSAGE RECEIVED!
	INPUT BUFFER INDEX = 168 / 5000
	INPUT BUFFER WRITING TIME = 19
0x6
starting_date = 23-jun-1991 12:00:00

DEBUG MENU

G = Get
S = Set
N = Change Penguin Name
L = Toggle LED
> = USER MENU
? = Repeat
Q = Quit

*************************

	SENDING: G
	MESSAGE RECEIVED!
	INPUT BUFFER INDEX = 274 / 5000
	INPUT BUFFER WRITING TIME = 30
0x6
GETTING...

1 = Device active
2 = Wet and Dry active
3 = Temperature active
4 = Wet and Dry Period
5 = Temperature Period
6 = Calibrated Minute Value
7 = Penguin Name
8 = Penguin ID
9 = Starting Date
0 = Calibration values
? = Repeat
< = Return

*************************

	SENDING: 0
	MESSAGE RECEIVED!
	INPUT BUFFER INDEX = 211 / 5000
	INPUT BUFFER WRITING TIME = 32
0x6
CALADC_15V_30C = 2207

CALADC_15V_105C = 2779

ADC_GAIN = 32735

ADC_OFFSET = 2

DEBUG MENU

G = Get
S = Set
N = Change Penguin Name
L = Toggle LED
> = USER MENU
? = Repeat
Q = Quit

*************************

	SENDING: L
	MESSAGE RECEIVED!
	INPUT BUFFER INDEX = 138 / 5000
	INPUT BUFFER WRITING TIME = 16
0x6
LED ON

DEBUG MENU

G = Get
S = Set
N = Change Penguin Name
L = Toggle LED
> = USER MENU
? = Repeat
Q = Quit

*************************

	SENDING: L
	MESSAGE RECEIVED!
	INPUT BUFFER INDEX = 139 / 5000
	INPUT BUFFER WRITING TIME = 15
0x6
LED OFF

DEBUG MENU

G = Get
S = Set
N = Change Penguin Name
L = Toggle LED
> = USER MENU
? = Repeat
Q = Quit

*************************

	SENDING: >
	MESSAGE RECEIVED!
	INPUT BUFFER INDEX = 660 / 5000
	INPUT BUFFER WRITING TIME = 81
0x6
PROGRAMMED STATE = WET AND DRY & TEMPERATURE

memory_full = FALSE

svsh_fault = FALSE

resets_since_last_communication = 0

temperature_index = 91

wet_and_dry_index = 91

temperature_index == MAX_INDEX_SIZE = FALSE

wet_and_dry_index == MAX_INDEX_SIZE = FALSE

get_next_pointed_temperature_byte() = -4952

get_next_pointed_wet_and_dry_byte() = -32757

get_next_pointed_wet_and_dry_bit() = 3

USER MENU

Attention! Before starting new state, change periods in DEBUG MENU
G = Get tracking data
F = Get tracking data fast
E = Events
< = Go back to DEBUG MENU
> = Set new state (either start tracking or turn off)
? = Repeat
Q = Quit

*************************

	SENDING: E
	MESSAGE RECEIVED!
	INPUT BUFFER INDEX = 3025 / 5000
	INPUT BUFFER WRITING TIME = 609
0x6
last_events_index = 3

looping_events = FALSE
23	23	False base detect
27	27	False base detect
91	91	UART communication
0	0	False base detect
0	0	False base detect
0	0	False base detect
0	0	False base detect
0	0	False base detect
0	0	False base detect
0	0	False base detect
0	0	False base detect
0	0	False base detect
0	0	False base detect
0	0	False base detect
0	0	False base detect
0	0	False base detect
0	0	False base detect
0	0	False base detect
0	0	False base detect
0	0	False base detect
0	0	False base detect
0	0	False base detect
0	0	False base detect
0	0	Timeout while Password
0	0	Timeout while Password
0	0	Timeout while Password
0	0	Timeout while Password
0	0	UART communication
0	0	False base detect
0	0	UART communication
0	0	False base detect
0	0	False base detect
0	0	False base detect
0	0	False base detect
0	0	False base detect
0	0	False base detect
0	0	False base detect
0	0	False base detect
0	0	UART communication
0	0	Disconnected for Inactivity
0	0	UART communication
0	0	Disconnected for Inactivity
0	0	UART communication
0	0	Disconnected for Inactivity
0	0	UART communication
0	0	Disconnected for Inactivity
0	0	UART communication
0	0	Disconnected for Inactivity
0	0	UART communication
0	0	Disconnected for Inactivity
0	0	UART communication
0	0	Disconnected for Inactivity
0	0	UART communication
0	0	Disconnected for Inactivity
0	0	False base detect
0	0	False base detect
0	0	False base detect
0	0	False base detect
0	0	False base detect
0	0	False base detect
0	0	False base detect
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

*************************

	SENDING: N
	MESSAGE RECEIVED!
	INPUT BUFFER INDEX = 158 / 5000
	INPUT BUFFER WRITING TIME = 17
0x6
INPUT = *

ENTER PASSWORD

WARNING! Changing state starts new tracking logs, deleting all previous data
< = Abort password input

*************************

	SENDING: o
	MESSAGE RECEIVED!
	INPUT BUFFER INDEX = 159 / 5000
	INPUT BUFFER WRITING TIME = 17
0x6
INPUT = **

ENTER PASSWORD

WARNING! Changing state starts new tracking logs, deleting all previous data
< = Abort password input

*************************

	SENDING: o
	MESSAGE RECEIVED!
	INPUT BUFFER INDEX = 160 / 5000
	INPUT BUFFER WRITING TIME = 18
0x6
INPUT = ***

ENTER PASSWORD

WARNING! Changing state starts new tracking logs, deleting all previous data
< = Abort password input

*************************

	SENDING: t
	MESSAGE RECEIVED!
	INPUT BUFFER INDEX = 161 / 5000
	INPUT BUFFER WRITING TIME = 17
0x6
INPUT = ****

ENTER PASSWORD

WARNING! Changing state starts new tracking logs, deleting all previous data
< = Abort password input

*************************

	SENDING:  
	MESSAGE RECEIVED!
	INPUT BUFFER INDEX = 162 / 5000
	INPUT BUFFER WRITING TIME = 18
0x6
INPUT = *****

ENTER PASSWORD

WARNING! Changing state starts new tracking logs, deleting all previous data
< = Abort password input

*************************

	SENDING: n
	MESSAGE RECEIVED!
	INPUT BUFFER INDEX = 163 / 5000
	INPUT BUFFER WRITING TIME = 18
0x6
INPUT = ******

ENTER PASSWORD

WARNING! Changing state starts new tracking logs, deleting all previous data
< = Abort password input

*************************

	SENDING: o
	MESSAGE RECEIVED!
	INPUT BUFFER INDEX = 164 / 5000
	INPUT BUFFER WRITING TIME = 18
0x6
INPUT = *******

ENTER PASSWORD

WARNING! Changing state starts new tracking logs, deleting all previous data
< = Abort password input

*************************

	SENDING: o
	MESSAGE RECEIVED!
	INPUT BUFFER INDEX = 165 / 5000
	INPUT BUFFER WRITING TIME = 19
0x6
INPUT = ********

ENTER PASSWORD

WARNING! Changing state starts new tracking logs, deleting all previous data
< = Abort password input

*************************

	SENDING: t
	MESSAGE RECEIVED!
	INPUT BUFFER INDEX = 166 / 5000
	INPUT BUFFER WRITING TIME = 18
0x6
INPUT = *********

ENTER PASSWORD

WARNING! Changing state starts new tracking logs, deleting all previous data
< = Abort password input

*************************

	SENDING: !
	MESSAGE RECEIVED!
	INPUT BUFFER INDEX = 169 / 5000
	INPUT BUFFER WRITING TIME = 18
0x6
incorrect_password = FALSE

Input = 

INSERT DATE

Any letter or number = Write
- = Delete
> = Confirm starting date
? = Repeat
< = Return

*************************

	SENDING: <
	MESSAGE RECEIVED!
	INPUT BUFFER INDEX = 660 / 5000
	INPUT BUFFER WRITING TIME = 80
0x6
PROGRAMMED STATE = WET AND DRY & TEMPERATURE

memory_full = FALSE

svsh_fault = FALSE

resets_since_last_communication = 0

temperature_index = 91

wet_and_dry_index = 91

temperature_index == MAX_INDEX_SIZE = FALSE

wet_and_dry_index == MAX_INDEX_SIZE = FALSE

get_next_pointed_temperature_byte() = -4952

get_next_pointed_wet_and_dry_byte() = -32757

get_next_pointed_wet_and_dry_bit() = 3

USER MENU

Attention! Before starting new state, change periods in DEBUG MENU
G = Get tracking data
F = Get tracking data fast
E = Events
< = Go back to DEBUG MENU
> = Set new state (either start tracking or turn off)
? = Repeat
Q = Quit

*************************

	SENDING: >
	MESSAGE RECEIVED!
	INPUT BUFFER INDEX = 157 / 5000
	INPUT BUFFER WRITING TIME = 17
0x6
INPUT = 

ENTER PASSWORD

WARNING! Changing state starts new tracking logs, deleting all previous data
< = Abort password input

*************************

	SENDING: N
	MESSAGE RECEIVED!
	INPUT BUFFER INDEX = 158 / 5000
	INPUT BUFFER WRITING TIME = 18
0x6
INPUT = *

ENTER PASSWORD

WARNING! Changing state starts new tracking logs, deleting all previous data
< = Abort password input

*************************

	SENDING: o
	MESSAGE RECEIVED!
	INPUT BUFFER INDEX = 159 / 5000
	INPUT BUFFER WRITING TIME = 18
0x6
INPUT = **

ENTER PASSWORD

WARNING! Changing state starts new tracking logs, deleting all previous data
< = Abort password input

*************************

	SENDING: o
	MESSAGE RECEIVED!
	INPUT BUFFER INDEX = 160 / 5000
	INPUT BUFFER WRITING TIME = 17
0x6
INPUT = ***

ENTER PASSWORD

WARNING! Changing state starts new tracking logs, deleting all previous data
< = Abort password input

*************************

	SENDING: t
	MESSAGE RECEIVED!
	INPUT BUFFER INDEX = 161 / 5000
	INPUT BUFFER WRITING TIME = 18
0x6
INPUT = ****

ENTER PASSWORD

WARNING! Changing state starts new tracking logs, deleting all previous data
< = Abort password input

*************************

	SENDING:  
	MESSAGE RECEIVED!
	INPUT BUFFER INDEX = 162 / 5000
	INPUT BUFFER WRITING TIME = 18
0x6
INPUT = *****

ENTER PASSWORD

WARNING! Changing state starts new tracking logs, deleting all previous data
< = Abort password input

*************************

	SENDING: n
	MESSAGE RECEIVED!
	INPUT BUFFER INDEX = 163 / 5000
	INPUT BUFFER WRITING TIME = 18
0x6
INPUT = ******

ENTER PASSWORD

WARNING! Changing state starts new tracking logs, deleting all previous data
< = Abort password input

*************************

	SENDING: o
	MESSAGE RECEIVED!
	INPUT BUFFER INDEX = 164 / 5000
	INPUT BUFFER WRITING TIME = 18
0x6
INPUT = *******

ENTER PASSWORD

WARNING! Changing state starts new tracking logs, deleting all previous data
< = Abort password input

*************************

	SENDING: o
	MESSAGE RECEIVED!
	INPUT BUFFER INDEX = 165 / 5000
	INPUT BUFFER WRITING TIME = 19
0x6
INPUT = ********

ENTER PASSWORD

WARNING! Changing state starts new tracking logs, deleting all previous data
< = Abort password input

*************************

	SENDING: t
	MESSAGE RECEIVED!
	INPUT BUFFER INDEX = 166 / 5000
	INPUT BUFFER WRITING TIME = 19
0x6
INPUT = *********

ENTER PASSWORD

WARNING! Changing state starts new tracking logs, deleting all previous data
< = Abort password input

*************************

	SENDING: !
	MESSAGE RECEIVED!
	INPUT BUFFER INDEX = 169 / 5000
	INPUT BUFFER WRITING TIME = 18
0x6
incorrect_password = FALSE

Input = 

INSERT DATE

Any letter or number = Write
- = Delete
> = Confirm starting date
? = Repeat
< = Return

*************************

	SENDING: >
	MESSAGE RECEIVED!
	INPUT BUFFER INDEX = 243 / 5000
	INPUT BUFFER WRITING TIME = 28
0x6
Starting date = 

SELECT NEW STATE AND QUIT

REMEMBER! After choosing an option, all previous data is lost
1 = INACTIVE
2 = WET AND DRY ONLY
3 = TEMPERATURE ONLY
4 = WET AND DRY & TEMPERATURE
? = Repeat
< = Return

*************************

	SENDING: 1
	 WARNING! MESSAGED NOT RECEIVED PROPERLY!!!
	INPUT BUFFER INDEX = 14 / 5000
	INPUT BUFFER WRITING TIME = 2000
0x6
Bye bye!
OK
