odevincenti/Wet-DryPenguins/Documentación/Tablas/9-1 Diseño de banco de pruebas.xlsx

Banco | Descripción
BP-01 | FOTO | \tabitem Penguin Logger. \tabitem Penguin Base. \tabitem Multímetro de banco. \tabitem Fuente regulada de 3.3V, capaz de entregar al menos 100mA. \tabitem Sensor de temperatura calibrado. \tabitem Cronómetro calibrado. \tabitem Recipiente con agua salada.
BP-02 | FOTO | \tabitem Penguin Logger. \tabitem Batería utilizada. \tabitem Data Logger. \tabitem Multímetro de banco.
BP-03 | FOTO | \tabitem Penguin Logger, sellado en su poteo. \tabitem Penguin Base. \tabitem Instrumentos de medición dimensional con resolución de al menos 1mm. \tabitem Balanza digital con resolución de al menos 0.1g.
BP-04 | FOTO | \tabitem Penguin Logger, sellado en su poteo. \tabitem Penguin Base. \tabitem Cámara de presión calibrada, capaz de generar al menos 10bar de presión. \tabitem Manómetro calibrado. \tabitem Sensor de temperatura calibrado. \tabitem Recipiente con agua salada.
BP-05 | FOTO | \tabitem Penguin Logger, sellado en su poteo y con datos. \tabitem Penguin Base. \tabitem Computadora con programa de recoleccíon de datos (PenGUI).
