odevincenti/Wet-DryPenguins/Documentación/Tablas/11-1-4 Plan de pruebas de cada módulo (Hardware).xlsx

Sheet: Logger
Módulo | Plan de prueba
Microprocesador | \tabitem Utilizar una placa de evaluación MSP430FR2433 LaunchPad para programar el microcontrolador usando el conector de programación dedicado. \tabitem Utilizar un programa que configure las entradas y salidas. \tabitem Verificar que el programa cargue correctamente. \tabitem Aplicar una señal digital alta a los pines de entrada. \tabitem Utilizar un multímetro para verificar que los pines de salida reflejan una señal digital alta.
Pilas | \tabitem Conectar las dos pilas a su conector dedicado en el dispositivo. \tabitem Verificar con un multímetro que la tensión medida entre ambas pilas es de $3,1V$. \tabitem Verificar con un multímetro que la tensión medida entre el negativo del conjunto de pilas y el cátodo del diodo $D_1$ está entre $2,6V$ y $2,8V$.
Interfaz de alimentación externa | \tabitem Aplicar una tensión de $5V$ entre los conectores de alimentación externa. \tabitem Verificar con un multímetro que la tensión entre el pin externo negativo y la alimentación del microcontrolador $V_{cc}$ está entre $3V$ y $3,3V$. \tabitem Verificar con un multímetro que la tensión entre el pin externo negativo y el pin P4.2 del microcontrolador (Base Detect) está entre $3V$ y $3,3V$.
Interfaz de comunicación serie | \tabitem Cargar un programa que configure los pines P1.4 y P1.5 como transmisión y recepción de una interfaz de comunicación UART. \tabitem Utilizar un osciloscopio con analizador de tramas para verificar que el mensaje enviado y recibido sea el correcto.
Sensor de conductividad | \tabitem Cortocircuitar los conectores externos del dispositivo en modo de medición. \tabitem Verificar con un multímetro que la tensión en el pin P1.5 esté entre $2,25V$ y la tensión de alimentación $V_{cc}$.
LED indicador | \tabitem Aplicar una tensión de $3V$ a $R_4$. \tabitem Verificar que el LED se enciende y que su brillo es adecuado. \tabitem Verificar con un multímetro que la corriente que circula por el LED no supere los $5mA$.

Sheet: Base
Módulo | Plan de prueba
Microprocesador | \tabitem Programar el microcontrolador usando el conector de programación dedicado. \tabitem Utilizar un programa que configure los pines de salida y de comunicación. \tabitem Verificar que el programa cargue correctamente. \tabitem Aplicar una señal digital alta a los pines de entrada. \tabitem Verificar con un multímetro que los pines de salida reflejan una señal digital alta. \tabitem Utilizar un osciloscopio con analizador de tramas para verificar que el mensaje enviado y recibido sea el correcto.
Circuito de generación de flancos | \tabitem Aplicar una tensión de $3,3V$ a $R_{g_1}$ y a $R_{g_2}$. \tabitem Verificar con un multímetro que la tensión en $V_{ext}$ es de $5V$. \tabitem Verificar con un multímetro que la tensión en $RX$ (logger) sigue siempre a $TX$ (base).
LED indicador | \tabitem Aplicar una tensión de $3,3V$ a $R_1$, $R_2$ y $R_3$, . \tabitem Verificar que el LED RGB se enciende y que su brillo es adecuado. \tabitem Verificar con un multímetro que la corriente que circula por el LED no supere los $5mA$.
