odevincenti/Wet-DryPenguins/Pruebas Experimentales/Prueba Temperatura/Prueba Temperatura.xlsx

Sheet: Pruebas pegadas
T° real | Logger | Activación | Desactivación | Indice | T° real max | T° real min | T° medida media | T° medida max | T° medida min | T° medida std | Tiempo de estabilización | Observaciones | Path
24 | 6 | 2023-12-08 23:17:42 | 2023-12-08 23:51:10 | 34 | 24.5 | 23.5 | 24.36188811 | 24.62412587 | 24.23076923 | 0.1311188811 | 0:17:56 |  | C:\Users\User\Repos\Wet-DryPenguins\Pruebas Experimentales\Prueba Temperatura\Prueba
 | 23 | 2023-12-08 23:19:32 | 2023-12-08 23:54:54 | 35 |  |  | 24.93404323 | 25.1486014 | 24.36188811 | 0.3062277315 | 0:08:45
23 | 6 | 2023-12-09 00:05:42 | 2023-12-09 00:40:09 | 35 | 23.5 | 22.5 | 23.7301335 | 23.96853147 | 23.44405594 | 0.1741284591 | 0:14:16
 | 23 | 2023-12-09 00:04:04 | 2023-12-09 00:36:07 | 32 |  |  | 23.37253655 | 24.09965035 | 23.0506993 | 0.3010806804 | 0:18:17
22 | 6 | 2023-12-09 00:49:50 | 2023-12-09 01:26:11 | 37 | 22.5 | 21.5 | 23.14605849 | 23.44405594 | 22.91958042 | 0.1561461179 | 0:19:20
 | 23 | 2023-12-09 00:50:57 | 2023-12-09 01:28:18 | 37 |  |  | 22.68118245 | 23.57517483 | 22.3951049 | 0.3147846315 | 0:14:08
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
