odevincenti/Wet-DryPenguins/Pruebas Experimentales/Medicion de tiempos/Prueba de Resistencia/Medicion_de_tiempos_prueba_de_resistencia.csv

#Digilent WaveForms Oscilloscope Acquisition
#Device Name: Discovery2
#Serial Number: SN:210321B0DECA
#Date Time: 2023-12-11 23:41:10.776
#Sample rate: 400000Hz
#Samples: 8192
#Trigger: Source: Channel 2 Type: Edge Condition: Rising Level: 1.25 V Hyst.: Auto HoldOff: 0 s
#Channel 1: Range: 20 mV/div Offset: -2.96 V Attenuation: 1 X Sample Mode: Average
#Channel 2: Range: 500 mV/div Offset: -2 V Attenuation: 1 X Sample Mode: Average
#Power Supplies: ON
#Positive Supply: ON
#Voltage: 3.1 V
#Negative Supply: OFF
#Voltage: -1 V
Time (s) | Channel 1 (V) | Channel 2 (V)
-0.004238875568265142 | 3.050787066260679 | -0.002805743479061373
-0.004236375568265141 | 3.050787066260679 | -0.002472000149445819
-0.00423387556826514 | 3.049793916415505 | -0.002138256819831012
-0.004231375568265141 | 3.050456016312288 | -0.002805743479061373
-0.004228875568265141 | 3.05111811620907 | -0.002138256819830708
-0.004226375568265142 | 3.050787066260679 | -0.002138256819830708
-0.004223875568265141 | 3.050124966363896 | -0.002138256819830708
-0.004221375568265142 | 3.05111811620907 | -0.002472000149445667
-0.004218875568265141 | 3.050787066260679 | -0.002472000149445819
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
