odevincenti/Wet-DryPenguins/Pruebas Experimentales/Prueba Temperatura/Prueba 10C/PRUEBA_TEMPERATURA_23_10C.xlsx

Sheet: Datos crudos
ID | Run | Timestamp | WetDry | Temperature | Datos válidos |  | Tiempo de establecimiento
23 | 10 | 2023-12-11 22:57:25 | 0 | 23.18181818 | Fila inicial | 8 | 0:06:14
23 | 10 | 2023-12-11 22:58:27 | 0 | 21.47727273 | Fila final | 42
23 | 10 | 2023-12-11 22:59:29 | 0 | 20.03496503
23 | 10 | 2023-12-11 23:00:32 | 0 | 19.64160839
23 | 10 | 2023-12-11 23:01:34 | 0 | 18.98601399
23 | 10 | 2023-12-11 23:02:37 | 0 | 18.33041958
23 | 10 | 2023-12-11 23:03:39 | 0 | 17.54370629
23 | 10 | 2023-12-11 23:04:41 | 0 | 17.28146853
23 | 10 | 2023-12-11 23:05:44 | 0 | 17.01923077
23 | 10 | 2023-12-11 23:06:46 | 0 | 16.49475524
23 | 10 | 2023-12-11 23:07:49 | 0 | 16.23251748
23 | 10 | 2023-12-11 23:08:51 | 0 | 15.97027972
23 | 10 | 2023-12-11 23:09:53 | 0 | 16.1013986
23 | 10 | 2023-12-11 23:10:56 | 0 | 15.97027972
23 | 10 | 2023-12-11 23:11:58 | 0 | 15.70804196
23 | 10 | 2023-12-11 23:13:01 | 0 | 15.83916084
23 | 10 | 2023-12-11 23:14:03 | 0 | 15.4458042
23 | 10 | 2023-12-11 23:15:06 | 0 | 15.4458042
23 | 10 | 2023-12-11 23:16:08 | 0 | 15.57692308
23 | 10 | 2023-12-11 23:17:10 | 0 | 15.57692308
23 | 10 | 2023-12-11 23:18:13 | 0 | 15.31468531
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
