odevincenti/Wet-DryPenguins/Pruebas Experimentales/Prueba Temperatura/Prueba 10C/PRUEBA_TEMPERATURA_6_10C.xlsx

Sheet: Datos crudos
ID | Run | Timestamp | WetDry | Temperature | Datos válidos |  | Tiempo de establecimiento
6 | 10 | 2023-12-10 08:04:54 | 0 | 26.19755245 | Fila inicial | 17 | 0:14:49
6 | 10 | 2023-12-10 08:05:53 | 0 | 22.65734266 | Fila final | 40
6 | 10 | 2023-12-10 08:06:52 | 0 | 20.69055944
6 | 10 | 2023-12-10 08:07:51 | 0 | 19.37937063
6 | 10 | 2023-12-10 08:08:51 | 0 | 18.33041958
6 | 10 | 2023-12-10 08:09:50 | 0 | 17.01923077
6 | 10 | 2023-12-10 08:10:49 | 0 | 17.01923077
6 | 10 | 2023-12-10 08:11:48 | 0 | 15.4458042
6 | 10 | 2023-12-10 08:12:48 | 0 | 15.4458042
6 | 10 | 2023-12-10 08:13:47 | 0 | 14.65909091
6 | 10 | 2023-12-10 08:14:46 | 0 | 14.52797203
6 | 10 | 2023-12-10 08:15:46 | 0 | 14.39685315
6 | 10 | 2023-12-10 08:16:45 | 0 | 14.0034965
6 | 10 | 2023-12-10 08:17:44 | 0 | 13.87237762
6 | 10 | 2023-12-10 08:18:43 | 0 | 13.74125874
6 | 10 | 2023-12-10 08:19:43 | 0 | 13.47902098
6 | 10 | 2023-12-10 08:20:42 | 0 | 13.61013986
6 | 10 | 2023-12-10 08:21:41 | 0 | 13.61013986
6 | 10 | 2023-12-10 08:22:40 | 0 | 13.61013986
6 | 10 | 2023-12-10 08:23:40 | 0 | 13.61013986
6 | 10 | 2023-12-10 08:24:39 | 0 | 13.47902098
6 | 10 | 2023-12-10 08:25:38 | 0 | 13.47902098
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
