odevincenti/Wet-DryPenguins/Pruebas Experimentales/Prueba Temperatura/Prueba 13C/PRUEBA_TEMPERATURA_23_13C.xlsx

Sheet: Datos crudos
ID | Run | Timestamp | WetDry | Temperature | Datos válidos |  | Tiempo de establecimiento
23 | 13 | 2023-12-11 22:13:15 | 0 | 26.32867133 | Fila inicial | 8 | 0:06:10
23 | 13 | 2023-12-11 22:14:16 | 0 | 24.36188811 | Fila final | 35
23 | 13 | 2023-12-11 22:15:18 | 0 | 22.00174825
23 | 13 | 2023-12-11 22:16:20 | 0 | 21.34615385
23 | 13 | 2023-12-11 22:17:21 | 0 | 20.55944056
23 | 13 | 2023-12-11 22:18:23 | 0 | 20.55944056
23 | 13 | 2023-12-11 22:19:25 | 0 | 19.90384615
23 | 13 | 2023-12-11 22:20:26 | 0 | 19.24825175
23 | 13 | 2023-12-11 22:21:28 | 0 | 18.98601399
23 | 13 | 2023-12-11 22:22:30 | 0 | 18.98601399
23 | 13 | 2023-12-11 22:23:31 | 0 | 18.8548951
23 | 13 | 2023-12-11 22:24:33 | 0 | 18.1993007
23 | 13 | 2023-12-11 22:25:35 | 0 | 18.46153846
23 | 13 | 2023-12-11 22:26:37 | 0 | 18.1993007
23 | 13 | 2023-12-11 22:27:38 | 0 | 18.06818182
23 | 13 | 2023-12-11 22:28:40 | 0 | 18.33041958
23 | 13 | 2023-12-11 22:29:42 | 0 | 18.06818182
23 | 13 | 2023-12-11 22:30:43 | 0 | 17.67482517
23 | 13 | 2023-12-11 22:31:45 | 0 | 17.67482517
23 | 13 | 2023-12-11 22:32:47 | 0 | 17.54370629
23 | 13 | 2023-12-11 22:33:48 | 0 | 17.93706294
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
