odevincenti/Wet-DryPenguins/Pruebas Experimentales/Prueba Temperatura/Prueba 13C/PRUEBA_TEMPERATURA_6_13C.xlsx

Sheet: Datos crudos
ID | Run | Timestamp | WetDry | Temperature | Datos válidos |  | Tiempo de establecimiento
6 | 13 | 2023-12-11 22:12:56 | 0 | 26.45979021 | Fila inicial | 16 | 0:14:11
6 | 13 | 2023-12-11 22:13:56 | 0 | 24.36188811 | Fila final | 36
6 | 13 | 2023-12-11 22:14:57 | 0 | 22.91958042
6 | 13 | 2023-12-11 22:15:58 | 0 | 21.60839161
6 | 13 | 2023-12-11 22:16:59 | 0 | 21.08391608
6 | 13 | 2023-12-11 22:18:00 | 0 | 20.55944056
6 | 13 | 2023-12-11 22:19:00 | 0 | 19.90384615
6 | 13 | 2023-12-11 22:20:01 | 0 | 19.37937063
6 | 13 | 2023-12-11 22:21:02 | 0 | 19.11713287
6 | 13 | 2023-12-11 22:22:03 | 0 | 18.46153846
6 | 13 | 2023-12-11 22:23:04 | 0 | 18.46153846
6 | 13 | 2023-12-11 22:24:04 | 0 | 17.93706294
6 | 13 | 2023-12-11 22:25:05 | 0 | 17.93706294
6 | 13 | 2023-12-11 22:26:06 | 0 | 17.93706294
6 | 13 | 2023-12-11 22:27:07 | 0 | 16.88811189
6 | 13 | 2023-12-11 22:28:08 | 0 | 16.75699301
6 | 13 | 2023-12-11 22:29:08 | 0 | 17.54370629
6 | 13 | 2023-12-11 22:30:09 | 0 | 17.41258741
6 | 13 | 2023-12-11 22:31:10 | 0 | 17.28146853
6 | 13 | 2023-12-11 22:32:11 | 0 | 17.01923077
6 | 13 | 2023-12-11 22:33:12 | 0 | 16.23251748
6 | 13 | 2023-12-11 22:34:12 | 0 | 17.01923077
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
