odevincenti/Wet-DryPenguins/Pruebas Experimentales/Prueba Temperatura/Prueba 19C/PRUEBA_TEMPERATURA_23_19C.xlsx

Sheet: Datos crudos
ID | Run | Timestamp | WetDry | Temperature | Datos válidos |  | Tiempo de establecimiento
23 | 19 | 2023-12-11 23:54:44 | 0 | 25.93531469 | Fila inicial | 15 | 0:13:25
23 | 19 | 2023-12-11 23:55:45 | 0 | 25.1486014 | Fila final | 37
23 | 19 | 2023-12-11 23:56:47 | 0 | 24.23076923
23 | 19 | 2023-12-11 23:57:49 | 0 | 22.78846154
23 | 19 | 2023-12-11 23:58:51 | 0 | 22.65734266
23 | 19 | 2023-12-11 23:59:53 | 0 | 22.26398601
23 | 19 | 2023-12-12 00:00:55 | 0 | 22.00174825
23 | 19 | 2023-12-12 00:01:57 | 0 | 22.00174825
23 | 19 | 2023-12-12 00:02:59 | 0 | 21.60839161
23 | 19 | 2023-12-12 00:04:01 | 0 | 21.34615385
23 | 19 | 2023-12-12 00:05:03 | 0 | 21.87062937
23 | 19 | 2023-12-12 00:06:05 | 0 | 21.34615385
23 | 19 | 2023-12-12 00:07:07 | 0 | 21.21503497
23 | 19 | 2023-12-12 00:08:09 | 0 | 21.34615385
23 | 19 | 2023-12-12 00:09:11 | 0 | 21.08391608
23 | 19 | 2023-12-12 00:10:13 | 0 | 20.82167832
23 | 19 | 2023-12-12 00:11:15 | 0 | 21.08391608
23 | 19 | 2023-12-12 00:12:17 | 0 | 21.21503497
23 | 19 | 2023-12-12 00:13:19 | 0 | 21.21503497
23 | 19 | 2023-12-12 00:14:21 | 0 | 21.34615385
23 | 19 | 2023-12-12 00:15:23 | 0 | 21.08391608
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
