odevincenti/Wet-DryPenguins/Pruebas Experimentales/Prueba Temperatura/Prueba 19C/PRUEBA_TEMPERATURA_6_19C.xlsx

Sheet: Datos crudos
ID | Run | Timestamp | WetDry | Temperature | Datos válidos |  | Tiempo de establecimiento
6 | 19 | 2023-12-11 23:54:20 | 0 | 26.45979021 | Fila inicial | 8 | 0:05:59
6 | 19 | 2023-12-11 23:55:19 | 0 | 25.27972028 | Fila final | 39
6 | 19 | 2023-12-11 23:56:19 | 0 | 24.49300699
6 | 19 | 2023-12-11 23:57:19 | 0 | 23.96853147
6 | 19 | 2023-12-11 23:58:19 | 0 | 23.31293706
6 | 19 | 2023-12-11 23:59:19 | 0 | 23.0506993
6 | 19 | 2023-12-12 00:00:19 | 0 | 22.52622378
6 | 19 | 2023-12-12 00:01:19 | 0 | 22.52622378
6 | 19 | 2023-12-12 00:02:19 | 0 | 22.13286713
6 | 19 | 2023-12-12 00:03:19 | 0 | 22.13286713
6 | 19 | 2023-12-12 00:04:19 | 0 | 22.00174825
6 | 19 | 2023-12-12 00:05:19 | 0 | 21.87062937
6 | 19 | 2023-12-12 00:06:19 | 0 | 21.73951049
6 | 19 | 2023-12-12 00:07:18 | 0 | 21.60839161
6 | 19 | 2023-12-12 00:08:18 | 0 | 21.47727273
6 | 19 | 2023-12-12 00:09:18 | 0 | 21.47727273
6 | 19 | 2023-12-12 00:10:18 | 0 | 21.60839161
6 | 19 | 2023-12-12 00:11:18 | 0 | 21.47727273
6 | 19 | 2023-12-12 00:12:18 | 0 | 21.34615385
6 | 19 | 2023-12-12 00:13:18 | 0 | 21.34615385
6 | 19 | 2023-12-12 00:14:18 | 0 | 21.34615385
6 | 19 | 2023-12-12 00:15:18 | 0 | 21.47727273
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
