odevincenti/Wet-DryPenguins/Pruebas Experimentales/Prueba Temperatura/Prueba 20C/PRUEBA_TEMPERATURA_23_20C.xlsx

Sheet: Datos crudos
ID | Run | Timestamp | WetDry | Temperature | Datos válidos |  | Tiempo de establecimiento
23 | 20 | 2023-12-12 00:39:11 | 0 | 25.8041958 | Fila inicial | 16 | 0:14:33
23 | 20 | 2023-12-12 00:40:13 | 0 | 25.1486014 | Fila final | 32
23 | 20 | 2023-12-12 00:41:15 | 0 | 24.88636364
23 | 20 | 2023-12-12 00:42:18 | 0 | 23.83741259
23 | 20 | 2023-12-12 00:43:20 | 0 | 22.91958042
23 | 20 | 2023-12-12 00:44:23 | 0 | 22.78846154
23 | 20 | 2023-12-12 00:45:25 | 0 | 22.52622378
23 | 20 | 2023-12-12 00:46:27 | 0 | 22.52622378
23 | 20 | 2023-12-12 00:47:30 | 0 | 22.3951049
23 | 20 | 2023-12-12 00:48:32 | 0 | 22.26398601
23 | 20 | 2023-12-12 00:49:35 | 0 | 22.00174825
23 | 20 | 2023-12-12 00:50:37 | 0 | 22.00174825
23 | 20 | 2023-12-12 00:51:40 | 0 | 22.00174825
23 | 20 | 2023-12-12 00:52:42 | 0 | 21.87062937
23 | 20 | 2023-12-12 00:53:44 | 0 | 21.87062937
23 | 20 | 2023-12-12 00:54:47 | 0 | 21.60839161
23 | 20 | 2023-12-12 00:55:49 | 0 | 22.13286713
23 | 20 | 2023-12-12 00:56:52 | 0 | 21.87062937
23 | 20 | 2023-12-12 00:57:54 | 0 | 21.60839161
23 | 20 | 2023-12-12 00:58:57 | 0 | 21.47727273
23 | 20 | 2023-12-12 00:59:59 | 0 | 21.73951049
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
