odevincenti/Wet-DryPenguins/Pruebas Experimentales/Prueba Temperatura/Prueba 20C/PRUEBA_TEMPERATURA_6_20C.xlsx

Sheet: Datos crudos
ID | Run | Timestamp | WetDry | Temperature | Datos válidos |  | Tiempo de establecimiento
6 | 20 | 2023-12-12 00:38:49 | 0 | 25.41083916 | Fila inicial | 11 | 0:09:09
6 | 20 | 2023-12-12 00:39:50 | 0 | 24.75524476 | Fila final | 33
6 | 20 | 2023-12-12 00:40:51 | 0 | 24.23076923
6 | 20 | 2023-12-12 00:41:52 | 0 | 23.83741259
6 | 20 | 2023-12-12 00:42:53 | 0 | 23.44405594
6 | 20 | 2023-12-12 00:43:54 | 0 | 23.18181818
6 | 20 | 2023-12-12 00:44:55 | 0 | 22.65734266
6 | 20 | 2023-12-12 00:45:56 | 0 | 22.78846154
6 | 20 | 2023-12-12 00:46:57 | 0 | 22.3951049
6 | 20 | 2023-12-12 00:47:58 | 0 | 22.26398601
6 | 20 | 2023-12-12 00:48:59 | 0 | 22.26398601
6 | 20 | 2023-12-12 00:50:00 | 0 | 22.26398601
6 | 20 | 2023-12-12 00:51:01 | 0 | 22.52622378
6 | 20 | 2023-12-12 00:52:02 | 0 | 22.3951049
6 | 20 | 2023-12-12 00:53:03 | 0 | 22.3951049
6 | 20 | 2023-12-12 00:54:04 | 0 | 22.3951049
6 | 20 | 2023-12-12 00:55:06 | 0 | 22.52622378
6 | 20 | 2023-12-12 00:56:07 | 0 | 22.13286713
6 | 20 | 2023-12-12 00:57:08 | 0 | 22.3951049
6 | 20 | 2023-12-12 00:58:09 | 0 | 22.3951049
6 | 20 | 2023-12-12 00:59:10 | 0 | 22.00174825
6 | 20 | 2023-12-12 01:00:11 | 0 | 22.52622378
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
