odevincenti/Wet-DryPenguins/Pruebas Experimentales/Prueba Temperatura/Prueba 21C/PRUEBA_TEMPERATURA_23_21C.xlsx

Sheet: Datos crudos
ID | Run | Timestamp | WetDry | Temperature | Datos válidos |  | Tiempo de establecimiento
23 | 21 | 2023-12-12 01:33:34 | 0 | 26.85314685 | Fila inicial | 14 | 0:12:38
23 | 21 | 2023-12-12 01:34:37 | 0 | 26.19755245 | Fila final | 28
23 | 21 | 2023-12-12 01:35:40 | 0 | 25.8041958
23 | 21 | 2023-12-12 01:36:43 | 0 | 25.27972028
23 | 21 | 2023-12-12 01:37:46 | 0 | 24.62412587
23 | 21 | 2023-12-12 01:38:49 | 0 | 24.09965035
23 | 21 | 2023-12-12 01:39:53 | 0 | 23.44405594
23 | 21 | 2023-12-12 01:40:56 | 0 | 24.36188811
23 | 21 | 2023-12-12 01:41:59 | 0 | 23.83741259
23 | 21 | 2023-12-12 01:43:02 | 0 | 24.23076923
23 | 21 | 2023-12-12 01:44:05 | 0 | 24.09965035
23 | 21 | 2023-12-12 01:45:08 | 0 | 23.83741259
23 | 21 | 2023-12-12 01:46:12 | 0 | 22.52622378
23 | 21 | 2023-12-12 01:47:15 | 0 | 22.52622378
23 | 21 | 2023-12-12 01:48:18 | 0 | 23.31293706
23 | 21 | 2023-12-12 01:49:21 | 0 | 23.70629371
23 | 21 | 2023-12-12 01:50:24 | 0 | 23.83741259
23 | 21 | 2023-12-12 01:51:28 | 0 | 22.3951049
23 | 21 | 2023-12-12 01:52:31 | 0 | 22.52622378
23 | 21 | 2023-12-12 01:53:34 | 0 | 22.65734266
23 | 21 | 2023-12-12 01:54:37 | 0 | 22.52622378
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
