odevincenti/Wet-DryPenguins/Pruebas Experimentales/Prueba Temperatura/Prueba 21C/PRUEBA_TEMPERATURA_6_21C.xlsx

Sheet: Datos crudos
ID | Run | Timestamp | WetDry | Temperature | Datos válidos |  | Tiempo de establecimiento
6 | 21 | 2023-12-12 01:32:59 | 0 | 27.50874126 | Fila inicial | 8 | 0:06:12
6 | 21 | 2023-12-12 01:34:01 | 0 | 26.19755245 | Fila final | 28
6 | 21 | 2023-12-12 01:35:03 | 0 | 25.41083916
6 | 21 | 2023-12-12 01:36:05 | 0 | 25.1486014
6 | 21 | 2023-12-12 01:37:07 | 0 | 24.49300699
6 | 21 | 2023-12-12 01:38:09 | 0 | 24.09965035
6 | 21 | 2023-12-12 01:39:11 | 0 | 23.70629371
6 | 21 | 2023-12-12 01:40:13 | 0 | 23.57517483
6 | 21 | 2023-12-12 01:41:15 | 0 | 23.31293706
6 | 21 | 2023-12-12 01:42:17 | 0 | 23.18181818
6 | 21 | 2023-12-12 01:43:19 | 0 | 23.0506993
6 | 21 | 2023-12-12 01:44:21 | 0 | 22.78846154
6 | 21 | 2023-12-12 01:45:23 | 0 | 22.91958042
6 | 21 | 2023-12-12 01:46:25 | 0 | 23.0506993
6 | 21 | 2023-12-12 01:47:27 | 0 | 22.65734266
6 | 21 | 2023-12-12 01:48:29 | 0 | 22.78846154
6 | 21 | 2023-12-12 01:49:31 | 0 | 23.0506993
6 | 21 | 2023-12-12 01:50:33 | 0 | 22.65734266
6 | 21 | 2023-12-12 01:51:35 | 0 | 22.65734266
6 | 21 | 2023-12-12 01:52:37 | 0 | 22.52622378
6 | 21 | 2023-12-12 01:53:39 | 0 | 22.65734266
6 | 21 | 2023-12-12 01:54:41 | 0 | 22.65734266
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
