odevincenti/Wet-DryPenguins/Pruebas Experimentales/Prueba Temperatura/Prueba 22C/PRUEBA_TEMPERATURA_23_22C.xlsx

Sheet: Datos crudos
ID | Run | Timestamp | WetDry | Temperature | Datos válidos |  | Tiempo de establecimiento
23 | 22 | 2023-12-12 02:18:43 | 0 | 26.98426573 | Fila inicial | 16 | 0:14:08
23 | 22 | 2023-12-12 02:19:43 | 0 | 26.19755245 | Fila final | 32
23 | 22 | 2023-12-12 02:20:44 | 0 | 25.8041958
23 | 22 | 2023-12-12 02:21:44 | 0 | 25.67307692
23 | 22 | 2023-12-12 02:22:45 | 0 | 25.27972028
23 | 22 | 2023-12-12 02:23:45 | 0 | 25.1486014
23 | 22 | 2023-12-12 02:24:46 | 0 | 24.75524476
23 | 22 | 2023-12-12 02:25:47 | 0 | 24.75524476
23 | 22 | 2023-12-12 02:26:47 | 0 | 24.49300699
23 | 22 | 2023-12-12 02:27:48 | 0 | 23.31293706
23 | 22 | 2023-12-12 02:28:48 | 0 | 23.0506993
23 | 22 | 2023-12-12 02:29:49 | 0 | 24.23076923
23 | 22 | 2023-12-12 02:30:49 | 0 | 23.0506993
23 | 22 | 2023-12-12 02:31:50 | 0 | 23.18181818
23 | 22 | 2023-12-12 02:32:51 | 0 | 22.78846154
23 | 22 | 2023-12-12 02:33:51 | 0 | 22.78846154
23 | 22 | 2023-12-12 02:34:52 | 0 | 22.78846154
23 | 22 | 2023-12-12 02:35:52 | 0 | 22.78846154
23 | 22 | 2023-12-12 02:36:53 | 0 | 23.83741259
23 | 22 | 2023-12-12 02:37:54 | 0 | 22.65734266
23 | 22 | 2023-12-12 02:38:54 | 0 | 22.65734266
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
