odevincenti/Wet-DryPenguins/Pruebas Experimentales/Prueba Temperatura/Prueba 22C/PRUEBA_TEMPERATURA_6_22C.xlsx

Sheet: Datos crudos
ID | Run | Timestamp | WetDry | Temperature | Datos válidos |  | Tiempo de establecimiento
6 | 22 | 2023-12-12 02:17:43 | 0 | 26.59090909 | Fila inicial | 21 | 0:19:20
6 | 22 | 2023-12-12 02:18:44 | 0 | 26.45979021 | Fila final | 34
6 | 22 | 2023-12-12 02:19:45 | 0 | 25.54195804
6 | 22 | 2023-12-12 02:20:46 | 0 | 25.41083916
6 | 22 | 2023-12-12 02:21:47 | 0 | 24.88636364
6 | 22 | 2023-12-12 02:22:48 | 0 | 24.49300699
6 | 22 | 2023-12-12 02:23:49 | 0 | 24.49300699
6 | 22 | 2023-12-12 02:24:50 | 0 | 23.96853147
6 | 22 | 2023-12-12 02:25:51 | 0 | 24.09965035
6 | 22 | 2023-12-12 02:26:52 | 0 | 24.09965035
6 | 22 | 2023-12-12 02:27:53 | 0 | 23.83741259
6 | 22 | 2023-12-12 02:28:54 | 0 | 23.83741259
6 | 22 | 2023-12-12 02:29:56 | 0 | 23.57517483
6 | 22 | 2023-12-12 02:30:57 | 0 | 23.44405594
6 | 22 | 2023-12-12 02:31:58 | 0 | 23.70629371
6 | 22 | 2023-12-12 02:32:59 | 0 | 23.44405594
6 | 22 | 2023-12-12 02:34:00 | 0 | 23.57517483
6 | 22 | 2023-12-12 02:35:01 | 0 | 23.31293706
6 | 22 | 2023-12-12 02:36:02 | 0 | 23.31293706
6 | 22 | 2023-12-12 02:37:03 | 0 | 23.18181818
6 | 22 | 2023-12-12 02:38:04 | 0 | 23.18181818
6 | 22 | 2023-12-12 02:39:05 | 0 | 23.18181818
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
