odevincenti/Wet-DryPenguins/Pruebas Experimentales/Prueba Temperatura/Prueba 23C/PRUEBA_TEMPERATURA_23_23C.xlsx

Sheet: Datos crudos
ID | Run | Timestamp | WetDry | Temperature | Datos válidos |  | Tiempo de establecimiento
23 | 23 | 2023-12-12 03:20:30 | 0 | 27.37762238 | Fila inicial | 20 | 0:18:17
23 | 23 | 2023-12-12 03:21:30 | 0 | 26.72202797 | Fila final | 30
23 | 23 | 2023-12-12 03:22:31 | 0 | 26.19755245
23 | 23 | 2023-12-12 03:23:32 | 0 | 26.19755245
23 | 23 | 2023-12-12 03:24:33 | 0 | 25.8041958
23 | 23 | 2023-12-12 03:25:34 | 0 | 25.54195804
23 | 23 | 2023-12-12 03:26:35 | 0 | 25.1486014
23 | 23 | 2023-12-12 03:27:36 | 0 | 25.1486014
23 | 23 | 2023-12-12 03:28:37 | 0 | 25.1486014
23 | 23 | 2023-12-12 03:29:38 | 0 | 24.75524476
23 | 23 | 2023-12-12 03:30:39 | 0 | 24.75524476
23 | 23 | 2023-12-12 03:31:40 | 0 | 23.57517483
23 | 23 | 2023-12-12 03:32:41 | 0 | 24.75524476
23 | 23 | 2023-12-12 03:33:42 | 0 | 24.75524476
23 | 23 | 2023-12-12 03:34:43 | 0 | 24.62412587
23 | 23 | 2023-12-12 03:35:44 | 0 | 24.36188811
23 | 23 | 2023-12-12 03:36:45 | 0 | 24.62412587
23 | 23 | 2023-12-12 03:37:46 | 0 | 23.83741259
23 | 23 | 2023-12-12 03:38:47 | 0 | 23.18181818
23 | 23 | 2023-12-12 03:39:48 | 0 | 23.31293706
23 | 23 | 2023-12-12 03:40:49 | 0 | 23.31293706
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
