odevincenti/Wet-DryPenguins/Pruebas Experimentales/Prueba Temperatura/Prueba 23C/PRUEBA_TEMPERATURA_6_23C.xlsx

Sheet: Datos crudos
ID | Run | Timestamp | WetDry | Temperature | Datos válidos |  | Tiempo de establecimiento
6 | 23 | 2023-12-12 03:19:55 | 0 | 26.98426573 | Fila inicial | 16 | 0:14:16
6 | 23 | 2023-12-12 03:20:56 | 0 | 26.45979021 | Fila final | 33
6 | 23 | 2023-12-12 03:21:57 | 0 | 25.93531469
6 | 23 | 2023-12-12 03:22:58 | 0 | 25.54195804
6 | 23 | 2023-12-12 03:23:59 | 0 | 25.1486014
6 | 23 | 2023-12-12 03:25:00 | 0 | 25.01748252
6 | 23 | 2023-12-12 03:26:02 | 0 | 24.62412587
6 | 23 | 2023-12-12 03:27:03 | 0 | 24.75524476
6 | 23 | 2023-12-12 03:28:04 | 0 | 24.36188811
6 | 23 | 2023-12-12 03:29:05 | 0 | 24.36188811
6 | 23 | 2023-12-12 03:30:06 | 0 | 24.23076923
6 | 23 | 2023-12-12 03:31:08 | 0 | 24.09965035
6 | 23 | 2023-12-12 03:32:09 | 0 | 24.09965035
6 | 23 | 2023-12-12 03:33:10 | 0 | 23.96853147
6 | 23 | 2023-12-12 03:34:11 | 0 | 23.83741259
6 | 23 | 2023-12-12 03:35:12 | 0 | 23.96853147
6 | 23 | 2023-12-12 03:36:14 | 0 | 23.96853147
6 | 23 | 2023-12-12 03:37:15 | 0 | 23.96853147
6 | 23 | 2023-12-12 03:38:16 | 0 | 23.57517483
6 | 23 | 2023-12-12 03:39:17 | 0 | 23.83741259
6 | 23 | 2023-12-12 03:40:18 | 0 | 23.83741259
6 | 23 | 2023-12-12 03:41:19 | 0 | 23.83741259
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
