odevincenti/Wet-DryPenguins/Pruebas Experimentales/Prueba Temperatura/Prueba 24C/PRUEBA_TEMPERATURA_23_24C.xlsx

Sheet: Datos crudos
ID | Run | Timestamp | WetDry | Temperature | Datos válidos |  | Tiempo de establecimiento
23 | 24 | 2023-12-12 03:19:55 | 0 | 27.2465035 | Fila inicial | 13 | 0:08:45
23 | 24 | 2023-12-12 03:20:42 | 0 | 26.72202797 | Fila final | 36
23 | 24 | 2023-12-12 03:21:30 | 0 | 26.45979021
23 | 24 | 2023-12-12 03:22:18 | 0 | 26.06643357
23 | 24 | 2023-12-12 03:23:06 | 0 | 26.06643357
23 | 24 | 2023-12-12 03:23:53 | 0 | 25.8041958
23 | 24 | 2023-12-12 03:24:41 | 0 | 25.8041958
23 | 24 | 2023-12-12 03:25:29 | 0 | 25.67307692
23 | 24 | 2023-12-12 03:26:17 | 0 | 25.41083916
23 | 24 | 2023-12-12 03:27:04 | 0 | 25.1486014
23 | 24 | 2023-12-12 03:27:52 | 0 | 25.41083916
23 | 24 | 2023-12-12 03:28:40 | 0 | 24.23076923
23 | 24 | 2023-12-12 03:29:28 | 0 | 25.27972028
23 | 24 | 2023-12-12 03:30:15 | 0 | 25.27972028
23 | 24 | 2023-12-12 03:31:03 | 0 | 25.27972028
23 | 24 | 2023-12-12 03:31:51 | 0 | 24.09965035
23 | 24 | 2023-12-12 03:32:39 | 0 | 25.27972028
23 | 24 | 2023-12-12 03:33:26 | 0 | 24.88636364
23 | 24 | 2023-12-12 03:34:14 | 0 | 25.1486014
23 | 24 | 2023-12-12 03:35:02 | 0 | 23.96853147
23 | 24 | 2023-12-12 03:35:50 | 0 | 25.1486014
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
