odevincenti/Wet-DryPenguins/Pruebas Experimentales/Prueba Temperatura/Prueba 24C/PRUEBA_TEMPERATURA_6_24C.xlsx

Sheet: Datos crudos
ID | Run | Timestamp | WetDry | Temperature | Datos válidos |  | Tiempo de establecimiento
6 | 24 | 2023-12-12 04:04:36 | 0 | 26.72202797 | Fila inicial | 20 | 0:17:56
6 | 24 | 2023-12-12 04:05:35 | 0 | 26.32867133 | Fila final | 36
6 | 24 | 2023-12-12 04:06:35 | 0 | 25.93531469
6 | 24 | 2023-12-12 04:07:35 | 0 | 25.67307692
6 | 24 | 2023-12-12 04:08:35 | 0 | 25.27972028
6 | 24 | 2023-12-12 04:09:35 | 0 | 25.1486014
6 | 24 | 2023-12-12 04:10:34 | 0 | 25.01748252
6 | 24 | 2023-12-12 04:11:34 | 0 | 25.01748252
6 | 24 | 2023-12-12 04:12:34 | 0 | 24.88636364
6 | 24 | 2023-12-12 04:13:34 | 0 | 25.01748252
6 | 24 | 2023-12-12 04:14:34 | 0 | 24.62412587
6 | 24 | 2023-12-12 04:15:34 | 0 | 24.88636364
6 | 24 | 2023-12-12 04:16:33 | 0 | 24.49300699
6 | 24 | 2023-12-12 04:17:33 | 0 | 24.75524476
6 | 24 | 2023-12-12 04:18:33 | 0 | 24.49300699
6 | 24 | 2023-12-12 04:19:33 | 0 | 24.62412587
6 | 24 | 2023-12-12 04:20:33 | 0 | 24.49300699
6 | 24 | 2023-12-12 04:21:33 | 0 | 24.49300699
6 | 24 | 2023-12-12 04:22:32 | 0 | 24.36188811
6 | 24 | 2023-12-12 04:23:32 | 0 | 24.49300699
6 | 24 | 2023-12-12 04:24:32 | 0 | 24.49300699
6 | 24 | 2023-12-12 04:25:32 | 0 | 24.36188811
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
