odevincenti/Wet-DryPenguins/Pruebas Experimentales/Prueba Temperatura/Prueba 25C/PRUEBA_TEMPERATURA_23_25C.xlsx

Sheet: Datos crudos
ID | Run | Timestamp | WetDry | Temperature | Datos válidos |  | Tiempo de establecimiento
23 | 25 | 2023-12-12 04:54:08 | 0 | 27.63986014 | Fila inicial | 14 | 0:12:12
23 | 25 | 2023-12-12 04:55:09 | 0 | 27.37762238 | Fila final | 37
23 | 25 | 2023-12-12 04:56:10 | 0 | 26.85314685
23 | 25 | 2023-12-12 04:57:11 | 0 | 26.72202797
23 | 25 | 2023-12-12 04:58:12 | 0 | 26.59090909
23 | 25 | 2023-12-12 04:59:13 | 0 | 26.45979021
23 | 25 | 2023-12-12 05:00:14 | 0 | 26.32867133
23 | 25 | 2023-12-12 05:01:15 | 0 | 26.06643357
23 | 25 | 2023-12-12 05:02:16 | 0 | 26.19755245
23 | 25 | 2023-12-12 05:03:17 | 0 | 25.93531469
23 | 25 | 2023-12-12 05:04:18 | 0 | 25.01748252
23 | 25 | 2023-12-12 05:05:19 | 0 | 26.06643357
23 | 25 | 2023-12-12 05:06:20 | 0 | 25.8041958
23 | 25 | 2023-12-12 05:07:22 | 0 | 25.8041958
23 | 25 | 2023-12-12 05:08:23 | 0 | 25.8041958
23 | 25 | 2023-12-12 05:09:24 | 0 | 25.8041958
23 | 25 | 2023-12-12 05:10:25 | 0 | 25.67307692
23 | 25 | 2023-12-12 05:11:26 | 0 | 25.54195804
23 | 25 | 2023-12-12 05:12:27 | 0 | 25.67307692
23 | 25 | 2023-12-12 05:13:28 | 0 | 25.67307692
23 | 25 | 2023-12-12 05:14:29 | 0 | 25.67307692
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
