odevincenti/Wet-DryPenguins/Pruebas Experimentales/Prueba Temperatura/Prueba 25C/PRUEBA_TEMPERATURA_6_25C.xlsx

Sheet: Datos crudos
ID | Run | Timestamp | WetDry | Temperature | Datos válidos |  | Tiempo de establecimiento
6 | 25 | 2023-12-12 04:53:40 | 0 | 27.11538462 | Fila inicial | 17 | 0:15:04
6 | 25 | 2023-12-12 04:54:40 | 0 | 26.85314685 | Fila final | 36
6 | 25 | 2023-12-12 04:55:40 | 0 | 26.45979021
6 | 25 | 2023-12-12 04:56:40 | 0 | 26.06643357
6 | 25 | 2023-12-12 04:57:41 | 0 | 26.06643357
6 | 25 | 2023-12-12 04:58:41 | 0 | 25.8041958
6 | 25 | 2023-12-12 04:59:41 | 0 | 25.67307692
6 | 25 | 2023-12-12 05:00:41 | 0 | 25.8041958
6 | 25 | 2023-12-12 05:01:42 | 0 | 25.41083916
6 | 25 | 2023-12-12 05:02:42 | 0 | 25.41083916
6 | 25 | 2023-12-12 05:03:42 | 0 | 25.27972028
6 | 25 | 2023-12-12 05:04:43 | 0 | 25.27972028
6 | 25 | 2023-12-12 05:05:43 | 0 | 25.27972028
6 | 25 | 2023-12-12 05:06:43 | 0 | 25.27972028
6 | 25 | 2023-12-12 05:07:43 | 0 | 25.67307692
6 | 25 | 2023-12-12 05:08:44 | 0 | 25.01748252
6 | 25 | 2023-12-12 05:09:44 | 0 | 25.1486014
6 | 25 | 2023-12-12 05:10:44 | 0 | 25.01748252
6 | 25 | 2023-12-12 05:11:45 | 0 | 25.1486014
6 | 25 | 2023-12-12 05:12:45 | 0 | 25.27972028
6 | 25 | 2023-12-12 05:13:45 | 0 | 25.01748252
6 | 25 | 2023-12-12 05:14:45 | 0 | 25.01748252
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
