odevincenti/Wet-DryPenguins/Pruebas Experimentales/Prueba Temperatura/Prueba 26C/PRUEBA_TEMPERATURA_23_26C.xlsx

Sheet: Datos crudos
ID | Run | Timestamp | WetDry | Temperature | Datos válidos |  | Tiempo de establecimiento
23 | 26 | 2023-12-12 05:53:06 | 0 | 27.63986014 | Fila inicial | 15 | 0:13:29
23 | 26 | 2023-12-12 05:54:08 | 0 | 27.50874126 | Fila final | 31
23 | 26 | 2023-12-12 05:55:10 | 0 | 27.11538462
23 | 26 | 2023-12-12 05:56:12 | 0 | 27.11538462
23 | 26 | 2023-12-12 05:57:15 | 0 | 26.85314685
23 | 26 | 2023-12-12 05:58:17 | 0 | 26.72202797
23 | 26 | 2023-12-12 05:59:19 | 0 | 26.72202797
23 | 26 | 2023-12-12 06:00:21 | 0 | 26.72202797
23 | 26 | 2023-12-12 06:01:24 | 0 | 26.59090909
23 | 26 | 2023-12-12 06:02:26 | 0 | 26.32867133
23 | 26 | 2023-12-12 06:03:28 | 0 | 26.45979021
23 | 26 | 2023-12-12 06:04:30 | 0 | 26.32867133
23 | 26 | 2023-12-12 06:05:33 | 0 | 26.45979021
23 | 26 | 2023-12-12 06:06:35 | 0 | 26.19755245
23 | 26 | 2023-12-12 06:07:37 | 0 | 26.45979021
23 | 26 | 2023-12-12 06:08:40 | 0 | 26.32867133
23 | 26 | 2023-12-12 06:09:42 | 0 | 26.06643357
23 | 26 | 2023-12-12 06:10:44 | 0 | 26.19755245
23 | 26 | 2023-12-12 06:11:46 | 0 | 26.32867133
23 | 26 | 2023-12-12 06:12:49 | 0 | 26.32867133
23 | 26 | 2023-12-12 06:13:51 | 0 | 26.59090909
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
