odevincenti/Wet-DryPenguins/Pruebas Experimentales/Prueba Temperatura/Prueba 26C/PRUEBA_TEMPERATURA_6_26C.xlsx

Sheet: Datos crudos
ID | Run | Timestamp | WetDry | Temperature | Datos válidos |  | Tiempo de establecimiento
6 | 26 | 2023-12-12 05:53:28 | 0 | 26.72202797 | Fila inicial | 11 | 0:08:56
6 | 26 | 2023-12-12 05:54:27 | 0 | 26.45979021 | Fila final | 31
6 | 26 | 2023-12-12 05:55:27 | 0 | 26.32867133
6 | 26 | 2023-12-12 05:56:26 | 0 | 26.06643357
6 | 26 | 2023-12-12 05:57:26 | 0 | 26.32867133
6 | 26 | 2023-12-12 05:58:26 | 0 | 26.06643357
6 | 26 | 2023-12-12 05:59:25 | 0 | 26.06643357
6 | 26 | 2023-12-12 06:00:25 | 0 | 26.06643357
6 | 26 | 2023-12-12 06:01:25 | 0 | 25.93531469
6 | 26 | 2023-12-12 06:02:24 | 0 | 25.8041958
6 | 26 | 2023-12-12 06:03:24 | 0 | 25.8041958
6 | 26 | 2023-12-12 06:04:24 | 0 | 25.8041958
6 | 26 | 2023-12-12 06:05:23 | 0 | 25.8041958
6 | 26 | 2023-12-12 06:06:23 | 0 | 25.8041958
6 | 26 | 2023-12-12 06:07:23 | 0 | 25.8041958
6 | 26 | 2023-12-12 06:08:22 | 0 | 25.8041958
6 | 26 | 2023-12-12 06:09:22 | 0 | 25.8041958
6 | 26 | 2023-12-12 06:10:22 | 0 | 25.8041958
6 | 26 | 2023-12-12 06:11:21 | 0 | 25.8041958
6 | 26 | 2023-12-12 06:12:21 | 0 | 25.8041958
6 | 26 | 2023-12-12 06:13:21 | 0 | 25.8041958
6 | 26 | 2023-12-12 06:14:20 | 0 | 25.8041958
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
