odevincenti/Wet-DryPenguins/Pruebas Experimentales/Prueba Temperatura/Prueba 10C2/PRUEBA_TEMPERATURA_23_10C.xlsx

Sheet: Datos crudos
ID | Run | Timestamp | WetDry | Temperature | Datos válidos |  | Tiempo de establecimiento
23 | 10 | 2023-12-11 06:02:19 | 0 | 22.52622378 | Fila inicial | 15 | 0:13:28
23 | 10 | 2023-12-11 06:03:21 | 0 | 20.55944056 | Fila final | 31
23 | 10 | 2023-12-11 06:04:23 | 0 | 18.98601399
23 | 10 | 2023-12-11 06:05:25 | 0 | 17.93706294
23 | 10 | 2023-12-11 06:06:27 | 0 | 16.75699301
23 | 10 | 2023-12-11 06:07:29 | 0 | 15.57692308
23 | 10 | 2023-12-11 06:08:32 | 0 | 15.18356643
23 | 10 | 2023-12-11 06:09:34 | 0 | 14.92132867
23 | 10 | 2023-12-11 06:10:36 | 0 | 14.65909091
23 | 10 | 2023-12-11 06:11:38 | 0 | 14.0034965
23 | 10 | 2023-12-11 06:12:40 | 0 | 14.0034965
23 | 10 | 2023-12-11 06:13:42 | 0 | 13.74125874
23 | 10 | 2023-12-11 06:14:45 | 0 | 13.74125874
23 | 10 | 2023-12-11 06:15:47 | 0 | 13.47902098
23 | 10 | 2023-12-11 06:16:49 | 0 | 13.47902098
23 | 10 | 2023-12-11 06:17:51 | 0 | 13.47902098
23 | 10 | 2023-12-11 06:18:53 | 0 | 13.3479021
23 | 10 | 2023-12-11 06:19:56 | 0 | 13.61013986
23 | 10 | 2023-12-11 06:20:58 | 0 | 13.21678322
23 | 10 | 2023-12-11 06:22:00 | 0 | 13.21678322
23 | 10 | 2023-12-11 06:23:02 | 0 | 13.47902098
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
