odevincenti/Wet-DryPenguins/Pruebas Experimentales/Prueba Temperatura/Prueba 10C2/PRUEBA_TEMPERATURA_6_10C.xlsx

Sheet: Datos crudos
ID | Run | Timestamp | WetDry | Temperature | Datos válidos |  | Tiempo de establecimiento
6 | 10 | 2023-12-11 06:01:49 | 0 | 24.49300699 | Fila inicial | 15 | 0:13:11
6 | 10 | 2023-12-11 06:02:49 | 0 | 21.87062937 | Fila final | 33
6 | 10 | 2023-12-11 06:03:50 | 0 | 19.90384615
6 | 10 | 2023-12-11 06:04:51 | 0 | 17.93706294
6 | 10 | 2023-12-11 06:05:52 | 0 | 16.49475524
6 | 10 | 2023-12-11 06:06:53 | 0 | 14.39685315
6 | 10 | 2023-12-11 06:07:54 | 0 | 13.3479021
6 | 10 | 2023-12-11 06:08:55 | 0 | 13.3479021
6 | 10 | 2023-12-11 06:09:56 | 0 | 12.82342657
6 | 10 | 2023-12-11 06:10:57 | 0 | 12.56118881
6 | 10 | 2023-12-11 06:11:58 | 0 | 12.16783217
6 | 10 | 2023-12-11 06:12:58 | 0 | 12.03671329
6 | 10 | 2023-12-11 06:13:59 | 0 | 12.03671329
6 | 10 | 2023-12-11 06:15:00 | 0 | 11.77447552
6 | 10 | 2023-12-11 06:16:01 | 0 | 11.51223776
6 | 10 | 2023-12-11 06:17:02 | 0 | 11.77447552
6 | 10 | 2023-12-11 06:18:03 | 0 | 11.90559441
6 | 10 | 2023-12-11 06:19:04 | 0 | 11.38111888
6 | 10 | 2023-12-11 06:20:05 | 0 | 11.64335664
6 | 10 | 2023-12-11 06:21:06 | 0 | 11.90559441
6 | 10 | 2023-12-11 06:22:07 | 0 | 11.77447552
6 | 10 | 2023-12-11 06:23:08 | 0 | 11.38111888
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
