odevincenti/Wet-DryPenguins/Pruebas Experimentales/Prueba Temperatura/Prueba 11C/PRUEBA_TEMPERATURA_23_11C.xlsx

Sheet: Datos crudos
ID | Run | Timestamp | WetDry | Temperature | Datos válidos |  | Tiempo de establecimiento
23 | 11 | 2023-12-10 07:13:04 | 0 | 29.21328671 | Fila inicial | 21 | 0:19:45
23 | 11 | 2023-12-10 07:14:06 | 0 | 26.19755245 | Fila final | 34
23 | 11 | 2023-12-10 07:15:08 | 0 | 22.65734266
23 | 11 | 2023-12-10 07:16:11 | 0 | 21.34615385
23 | 11 | 2023-12-10 07:17:13 | 0 | 20.55944056
23 | 11 | 2023-12-10 07:18:16 | 0 | 19.90384615
23 | 11 | 2023-12-10 07:19:18 | 0 | 18.59265734
23 | 11 | 2023-12-10 07:20:20 | 0 | 18.59265734
23 | 11 | 2023-12-10 07:21:23 | 0 | 18.1993007
23 | 11 | 2023-12-10 07:22:25 | 0 | 17.80594406
23 | 11 | 2023-12-10 07:23:28 | 0 | 17.01923077
23 | 11 | 2023-12-10 07:24:30 | 0 | 16.49475524
23 | 11 | 2023-12-10 07:25:32 | 0 | 16.75699301
23 | 11 | 2023-12-10 07:26:35 | 0 | 16.36363636
23 | 11 | 2023-12-10 07:27:37 | 0 | 16.23251748
23 | 11 | 2023-12-10 07:28:40 | 0 | 15.97027972
23 | 11 | 2023-12-10 07:29:42 | 0 | 15.97027972
23 | 11 | 2023-12-10 07:30:44 | 0 | 15.70804196
23 | 11 | 2023-12-10 07:31:47 | 0 | 15.70804196
23 | 11 | 2023-12-10 07:32:49 | 0 | 15.4458042
23 | 11 | 2023-12-10 07:33:52 | 0 | 15.70804196
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
