odevincenti/Wet-DryPenguins/Pruebas Experimentales/Prueba Temperatura/Prueba 11C/PRUEBA_TEMPERATURA_6_11C.xlsx

Sheet: Datos crudos
ID | Run | Timestamp | WetDry | Temperature | Datos válidos |  | Tiempo de establecimiento
6 | 11 | 2023-12-10 07:12:34 | 0 | 30.52447552 | Fila inicial | 20 | 0:18:04
6 | 11 | 2023-12-10 07:13:34 | 0 | 26.98426573 | Fila final | 36
6 | 11 | 2023-12-10 07:14:34 | 0 | 23.70629371
6 | 11 | 2023-12-10 07:15:34 | 0 | 22.13286713
6 | 11 | 2023-12-10 07:16:35 | 0 | 20.69055944
6 | 11 | 2023-12-10 07:17:35 | 0 | 19.64160839
6 | 11 | 2023-12-10 07:18:35 | 0 | 17.80594406
6 | 11 | 2023-12-10 07:19:35 | 0 | 17.41258741
6 | 11 | 2023-12-10 07:20:36 | 0 | 16.49475524
6 | 11 | 2023-12-10 07:21:36 | 0 | 16.36363636
6 | 11 | 2023-12-10 07:22:36 | 0 | 16.75699301
6 | 11 | 2023-12-10 07:23:36 | 0 | 16.36363636
6 | 11 | 2023-12-10 07:24:37 | 0 | 15.05244755
6 | 11 | 2023-12-10 07:25:37 | 0 | 14.92132867
6 | 11 | 2023-12-10 07:26:37 | 0 | 14.65909091
6 | 11 | 2023-12-10 07:27:37 | 0 | 14.52797203
6 | 11 | 2023-12-10 07:28:38 | 0 | 14.52797203
6 | 11 | 2023-12-10 07:29:38 | 0 | 14.92132867
6 | 11 | 2023-12-10 07:30:38 | 0 | 14.39685315
6 | 11 | 2023-12-10 07:31:38 | 0 | 14.39685315
6 | 11 | 2023-12-10 07:32:39 | 0 | 14.26573427
6 | 11 | 2023-12-10 07:33:39 | 0 | 14.0034965
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
