odevincenti/Wet-DryPenguins/Pruebas Experimentales/Prueba Temperatura/Prueba 11C2/PRUEBA_TEMPERATURA_23_11C.xlsx

Sheet: Datos crudos
ID | Run | Timestamp | WetDry | Temperature | Datos válidos |  | Tiempo de establecimiento
23 | 11 | 2023-12-11 05:17:33 | 0 | 23.0506993 | Fila inicial | 8 | 0:06:08
23 | 11 | 2023-12-11 05:18:34 | 0 | 20.2972028 | Fila final | 32
23 | 11 | 2023-12-11 05:19:35 | 0 | 19.37937063
23 | 11 | 2023-12-11 05:20:37 | 0 | 17.67482517
23 | 11 | 2023-12-11 05:21:38 | 0 | 16.36363636
23 | 11 | 2023-12-11 05:22:40 | 0 | 14.92132867
23 | 11 | 2023-12-11 05:23:41 | 0 | 14.92132867
23 | 11 | 2023-12-11 05:24:43 | 0 | 14.39685315
23 | 11 | 2023-12-11 05:25:44 | 0 | 14.13461538
23 | 11 | 2023-12-11 05:26:46 | 0 | 14.0034965
23 | 11 | 2023-12-11 05:27:47 | 0 | 13.61013986
23 | 11 | 2023-12-11 05:28:48 | 0 | 13.87237762
23 | 11 | 2023-12-11 05:29:50 | 0 | 13.61013986
23 | 11 | 2023-12-11 05:30:51 | 0 | 13.47902098
23 | 11 | 2023-12-11 05:31:53 | 0 | 13.74125874
23 | 11 | 2023-12-11 05:32:54 | 0 | 13.47902098
23 | 11 | 2023-12-11 05:33:56 | 0 | 13.47902098
23 | 11 | 2023-12-11 05:34:57 | 0 | 13.3479021
23 | 11 | 2023-12-11 05:35:59 | 0 | 13.47902098
23 | 11 | 2023-12-11 05:37:00 | 0 | 13.3479021
23 | 11 | 2023-12-11 05:38:01 | 0 | 13.21678322
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
