odevincenti/Wet-DryPenguins/Pruebas Experimentales/Prueba Temperatura/Prueba 11C2/PRUEBA_TEMPERATURA_6_11C.xlsx

Sheet: Datos crudos
ID | Run | Timestamp | WetDry | Temperature | Datos válidos |  | Tiempo de establecimiento
6 | 11 | 2023-12-11 05:17:00 | 0 | 25.41083916 | Fila inicial | 17 | 0:15:21
6 | 11 | 2023-12-11 05:18:01 | 0 | 22.52622378 | Fila final | 34
6 | 11 | 2023-12-11 05:19:02 | 0 | 20.42832168
6 | 11 | 2023-12-11 05:20:04 | 0 | 18.59265734
6 | 11 | 2023-12-11 05:21:05 | 0 | 17.28146853
6 | 11 | 2023-12-11 05:22:07 | 0 | 15.97027972
6 | 11 | 2023-12-11 05:23:08 | 0 | 14.0034965
6 | 11 | 2023-12-11 05:24:09 | 0 | 13.87237762
6 | 11 | 2023-12-11 05:25:11 | 0 | 13.47902098
6 | 11 | 2023-12-11 05:26:12 | 0 | 12.95454545
6 | 11 | 2023-12-11 05:27:14 | 0 | 12.82342657
6 | 11 | 2023-12-11 05:28:15 | 0 | 12.56118881
6 | 11 | 2023-12-11 05:29:17 | 0 | 12.56118881
6 | 11 | 2023-12-11 05:30:18 | 0 | 12.43006993
6 | 11 | 2023-12-11 05:31:19 | 0 | 12.69230769
6 | 11 | 2023-12-11 05:32:21 | 0 | 12.43006993
6 | 11 | 2023-12-11 05:33:22 | 0 | 12.16783217
6 | 11 | 2023-12-11 05:34:24 | 0 | 12.16783217
6 | 11 | 2023-12-11 05:35:25 | 0 | 12.03671329
6 | 11 | 2023-12-11 05:36:27 | 0 | 12.29895105
6 | 11 | 2023-12-11 05:37:28 | 0 | 12.16783217
6 | 11 | 2023-12-11 05:38:29 | 0 | 12.16783217
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
