odevincenti/Wet-DryPenguins/Pruebas Experimentales/Prueba Temperatura/Prueba 12C/PRUEBA_TEMPERATURA_23_12C.xlsx

Sheet: Datos crudos
ID | Run | Timestamp | WetDry | Temperature | Datos válidos |  | Tiempo de establecimiento
23 | 12 | 2023-12-10 06:24:56 | 0 | 28.68881119 | Fila inicial | 16 | 0:14:22
23 | 12 | 2023-12-10 06:25:57 | 0 | 25.67307692 | Fila final | 32
23 | 12 | 2023-12-10 06:26:59 | 0 | 23.96853147
23 | 12 | 2023-12-10 06:28:00 | 0 | 20.9527972
23 | 12 | 2023-12-10 06:29:02 | 0 | 20.16608392
23 | 12 | 2023-12-10 06:30:04 | 0 | 19.64160839
23 | 12 | 2023-12-10 06:31:05 | 0 | 19.11713287
23 | 12 | 2023-12-10 06:32:07 | 0 | 18.06818182
23 | 12 | 2023-12-10 06:33:09 | 0 | 18.1993007
23 | 12 | 2023-12-10 06:34:10 | 0 | 17.41258741
23 | 12 | 2023-12-10 06:35:12 | 0 | 17.80594406
23 | 12 | 2023-12-10 06:36:14 | 0 | 17.28146853
23 | 12 | 2023-12-10 06:37:15 | 0 | 17.28146853
23 | 12 | 2023-12-10 06:38:17 | 0 | 16.62587413
23 | 12 | 2023-12-10 06:39:18 | 0 | 16.62587413
23 | 12 | 2023-12-10 06:40:20 | 0 | 16.36363636
23 | 12 | 2023-12-10 06:41:22 | 0 | 16.49475524
23 | 12 | 2023-12-10 06:42:23 | 0 | 16.36363636
23 | 12 | 2023-12-10 06:43:25 | 0 | 16.23251748
23 | 12 | 2023-12-10 06:44:27 | 0 | 16.23251748
23 | 12 | 2023-12-10 06:45:28 | 0 | 16.49475524
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
