odevincenti/Wet-DryPenguins/Pruebas Experimentales/Prueba Temperatura/Prueba 12C/PRUEBA_TEMPERATURA_6_12C.xlsx

Sheet: Datos crudos
ID | Run | Timestamp | WetDry | Temperature | Datos válidos |  | Tiempo de establecimiento
6 | 12 | 2023-12-10 06:24:17 | 0 | 29.08216783 | Fila inicial | 14 | 0:12:19
6 | 12 | 2023-12-10 06:25:18 | 0 | 25.01748252 | Fila final | 33
6 | 12 | 2023-12-10 06:26:20 | 0 | 22.65734266
6 | 12 | 2023-12-10 06:27:21 | 0 | 21.34615385
6 | 12 | 2023-12-10 06:28:23 | 0 | 20.03496503
6 | 12 | 2023-12-10 06:29:24 | 0 | 19.24825175
6 | 12 | 2023-12-10 06:30:26 | 0 | 17.67482517
6 | 12 | 2023-12-10 06:31:28 | 0 | 17.80594406
6 | 12 | 2023-12-10 06:32:29 | 0 | 16.62587413
6 | 12 | 2023-12-10 06:33:31 | 0 | 17.15034965
6 | 12 | 2023-12-10 06:34:32 | 0 | 16.75699301
6 | 12 | 2023-12-10 06:35:34 | 0 | 16.23251748
6 | 12 | 2023-12-10 06:36:36 | 0 | 15.97027972
6 | 12 | 2023-12-10 06:37:37 | 0 | 15.97027972
6 | 12 | 2023-12-10 06:38:39 | 0 | 15.83916084
6 | 12 | 2023-12-10 06:39:40 | 0 | 15.97027972
6 | 12 | 2023-12-10 06:40:42 | 0 | 15.70804196
6 | 12 | 2023-12-10 06:41:44 | 0 | 15.97027972
6 | 12 | 2023-12-10 06:42:45 | 0 | 15.70804196
6 | 12 | 2023-12-10 06:43:47 | 0 | 15.83916084
6 | 12 | 2023-12-10 06:44:48 | 0 | 15.83916084
6 | 12 | 2023-12-10 06:45:50 | 0 | 15.70804196
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
