odevincenti/Wet-DryPenguins/Pruebas Experimentales/Prueba Temperatura/Prueba 12C2/PRUEBA_TEMPERATURA_23_12C.xlsx

Sheet: Datos crudos
ID | Run | Timestamp | WetDry | Temperature | Datos válidos |  | Tiempo de establecimiento
23 | 12 | 2023-12-11 04:24:16 | 0 | 25.67307692 | Fila inicial | 19 | 0:17:34
23 | 12 | 2023-12-11 04:25:18 | 0 | 21.60839161 | Fila final | 38
23 | 12 | 2023-12-11 04:26:20 | 0 | 20.03496503
23 | 12 | 2023-12-11 04:27:22 | 0 | 18.59265734
23 | 12 | 2023-12-11 04:28:24 | 0 | 17.28146853
23 | 12 | 2023-12-11 04:29:26 | 0 | 16.75699301
23 | 12 | 2023-12-11 04:30:28 | 0 | 16.1013986
23 | 12 | 2023-12-11 04:31:30 | 0 | 15.70804196
23 | 12 | 2023-12-11 04:32:32 | 0 | 15.57692308
23 | 12 | 2023-12-11 04:33:34 | 0 | 15.18356643
23 | 12 | 2023-12-11 04:34:36 | 0 | 14.92132867
23 | 12 | 2023-12-11 04:35:38 | 0 | 15.05244755
23 | 12 | 2023-12-11 04:36:40 | 0 | 15.05244755
23 | 12 | 2023-12-11 04:37:42 | 0 | 14.79020979
23 | 12 | 2023-12-11 04:38:44 | 0 | 14.79020979
23 | 12 | 2023-12-11 04:39:46 | 0 | 14.52797203
23 | 12 | 2023-12-11 04:40:48 | 0 | 14.65909091
23 | 12 | 2023-12-11 04:41:50 | 0 | 14.26573427
23 | 12 | 2023-12-11 04:42:52 | 0 | 14.52797203
23 | 12 | 2023-12-11 04:43:54 | 0 | 14.39685315
23 | 12 | 2023-12-11 04:44:56 | 0 | 14.39685315
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
