odevincenti/Wet-DryPenguins/Pruebas Experimentales/Prueba Temperatura/Prueba 12C2/PRUEBA_TEMPERATURA_6_12C.xlsx

Sheet: Datos crudos
ID | Run | Timestamp | WetDry | Temperature | Datos válidos |  | Tiempo de establecimiento
6 | 12 | 2023-12-11 04:23:45 | 0 | 25.93531469 | Fila inicial | 18 | 0:16:07
6 | 12 | 2023-12-11 04:24:45 | 0 | 23.83741259 | Fila final | 32
6 | 12 | 2023-12-11 04:25:45 | 0 | 21.73951049
6 | 12 | 2023-12-11 04:26:46 | 0 | 19.90384615
6 | 12 | 2023-12-11 04:27:46 | 0 | 18.1993007
6 | 12 | 2023-12-11 04:28:47 | 0 | 16.62587413
6 | 12 | 2023-12-11 04:29:47 | 0 | 17.01923077
6 | 12 | 2023-12-11 04:30:48 | 0 | 15.31468531
6 | 12 | 2023-12-11 04:31:48 | 0 | 15.05244755
6 | 12 | 2023-12-11 04:32:49 | 0 | 15.4458042
6 | 12 | 2023-12-11 04:33:49 | 0 | 14.39685315
6 | 12 | 2023-12-11 04:34:50 | 0 | 14.13461538
6 | 12 | 2023-12-11 04:35:50 | 0 | 14.26573427
6 | 12 | 2023-12-11 04:36:51 | 0 | 13.87237762
6 | 12 | 2023-12-11 04:37:51 | 0 | 13.74125874
6 | 12 | 2023-12-11 04:38:52 | 0 | 13.87237762
6 | 12 | 2023-12-11 04:39:52 | 0 | 13.47902098
6 | 12 | 2023-12-11 04:40:53 | 0 | 13.47902098
6 | 12 | 2023-12-11 04:41:53 | 0 | 13.21678322
6 | 12 | 2023-12-11 04:42:54 | 0 | 13.74125874
6 | 12 | 2023-12-11 04:43:54 | 0 | 13.47902098
6 | 12 | 2023-12-11 04:44:55 | 0 | 13.47902098
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
