odevincenti/Wet-DryPenguins/Pruebas Experimentales/Prueba Temperatura/Prueba 13C2/PRUEBA_TEMPERATURA_23_13C.xlsx

Sheet: Datos crudos
ID | Run | Timestamp | WetDry | Temperature | Datos válidos |  | Tiempo de establecimiento
23 | 13 | 2023-12-11 03:04:14 | 0 | 25.1486014 | Fila inicial | 28 | 0:26:47
23 | 13 | 2023-12-11 03:05:15 | 0 | 21.73951049 | Fila final | 50
23 | 13 | 2023-12-11 03:06:17 | 0 | 20.16608392
23 | 13 | 2023-12-11 03:07:19 | 0 | 18.72377622
23 | 13 | 2023-12-11 03:08:21 | 0 | 17.93706294
23 | 13 | 2023-12-11 03:09:23 | 0 | 17.93706294
23 | 13 | 2023-12-11 03:10:24 | 0 | 17.41258741
23 | 13 | 2023-12-11 03:11:26 | 0 | 16.88811189
23 | 13 | 2023-12-11 03:12:28 | 0 | 16.88811189
23 | 13 | 2023-12-11 03:13:30 | 0 | 16.75699301
23 | 13 | 2023-12-11 03:14:32 | 0 | 16.49475524
23 | 13 | 2023-12-11 03:15:34 | 0 | 16.75699301
23 | 13 | 2023-12-11 03:16:35 | 0 | 15.97027972
23 | 13 | 2023-12-11 03:17:37 | 0 | 15.97027972
23 | 13 | 2023-12-11 03:18:39 | 0 | 16.49475524
23 | 13 | 2023-12-11 03:19:41 | 0 | 16.1013986
23 | 13 | 2023-12-11 03:20:43 | 0 | 15.97027972
23 | 13 | 2023-12-11 03:21:44 | 0 | 15.97027972
23 | 13 | 2023-12-11 03:22:46 | 0 | 16.1013986
23 | 13 | 2023-12-11 03:23:48 | 0 | 15.70804196
23 | 13 | 2023-12-11 03:24:50 | 0 | 16.23251748
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
