odevincenti/Wet-DryPenguins/Pruebas Experimentales/Prueba Temperatura/Prueba 13C2/PRUEBA_TEMPERATURA_6_13C.xlsx

Sheet: Datos crudos
ID | Run | Timestamp | WetDry | Temperature | Datos válidos |  | Tiempo de establecimiento
6 | 13 | 2023-12-11 03:03:50 | 0 | 25.8041958 | Fila inicial | 34 | 0:31:56
6 | 13 | 2023-12-11 03:04:49 | 0 | 22.65734266 | Fila final | 52
6 | 13 | 2023-12-11 03:05:49 | 0 | 20.42832168
6 | 13 | 2023-12-11 03:06:49 | 0 | 18.98601399
6 | 13 | 2023-12-11 03:07:49 | 0 | 17.01923077
6 | 13 | 2023-12-11 03:08:49 | 0 | 15.57692308
6 | 13 | 2023-12-11 03:09:49 | 0 | 15.83916084
6 | 13 | 2023-12-11 03:10:49 | 0 | 16.23251748
6 | 13 | 2023-12-11 03:11:49 | 0 | 15.70804196
6 | 13 | 2023-12-11 03:12:48 | 0 | 15.18356643
6 | 13 | 2023-12-11 03:13:48 | 0 | 14.79020979
6 | 13 | 2023-12-11 03:14:48 | 0 | 14.65909091
6 | 13 | 2023-12-11 03:15:48 | 0 | 14.65909091
6 | 13 | 2023-12-11 03:16:48 | 0 | 14.13461538
6 | 13 | 2023-12-11 03:17:48 | 0 | 14.39685315
6 | 13 | 2023-12-11 03:18:48 | 0 | 14.52797203
6 | 13 | 2023-12-11 03:19:48 | 0 | 14.26573427
6 | 13 | 2023-12-11 03:20:48 | 0 | 14.39685315
6 | 13 | 2023-12-11 03:21:47 | 0 | 15.05244755
6 | 13 | 2023-12-11 03:22:47 | 0 | 14.79020979
6 | 13 | 2023-12-11 03:23:47 | 0 | 14.26573427
6 | 13 | 2023-12-11 03:24:47 | 0 | 14.52797203
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
