odevincenti/Wet-DryPenguins/Pruebas Experimentales/Prueba Temperatura/Prueba 14C/PRUEBA_TEMPERATURA_23_14C.xlsx

Sheet: Datos crudos
ID | Run | Timestamp | WetDry | Temperature | Datos válidos |  | Tiempo de establecimiento
23 | 14 | 2023-12-10 04:17:20 | 0 | 27.50874126 | Fila inicial | 22 | 0:20:21
23 | 14 | 2023-12-10 04:18:21 | 0 | 25.41083916 | Fila final | 40
23 | 14 | 2023-12-10 04:19:22 | 0 | 23.0506993
23 | 14 | 2023-12-10 04:20:23 | 0 | 22.13286713
23 | 14 | 2023-12-10 04:21:24 | 0 | 20.82167832
23 | 14 | 2023-12-10 04:22:25 | 0 | 20.2972028
23 | 14 | 2023-12-10 04:23:26 | 0 | 20.2972028
23 | 14 | 2023-12-10 04:24:27 | 0 | 20.03496503
23 | 14 | 2023-12-10 04:25:28 | 0 | 19.24825175
23 | 14 | 2023-12-10 04:26:29 | 0 | 19.51048951
23 | 14 | 2023-12-10 04:27:30 | 0 | 19.37937063
23 | 14 | 2023-12-10 04:28:32 | 0 | 19.11713287
23 | 14 | 2023-12-10 04:29:33 | 0 | 18.98601399
23 | 14 | 2023-12-10 04:30:34 | 0 | 18.59265734
23 | 14 | 2023-12-10 04:31:35 | 0 | 18.8548951
23 | 14 | 2023-12-10 04:32:36 | 0 | 18.33041958
23 | 14 | 2023-12-10 04:33:37 | 0 | 18.59265734
23 | 14 | 2023-12-10 04:34:38 | 0 | 18.46153846
23 | 14 | 2023-12-10 04:35:39 | 0 | 18.33041958
23 | 14 | 2023-12-10 04:36:40 | 0 | 18.46153846
23 | 14 | 2023-12-10 04:37:41 | 0 | 18.1993007
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
