odevincenti/Wet-DryPenguins/Pruebas Experimentales/Prueba Temperatura/Prueba 14C/PRUEBA_TEMPERATURA_6_14C.xlsx

Sheet: Datos crudos
ID | Run | Timestamp | WetDry | Temperature | Datos válidos |  | Tiempo de establecimiento
6 | 14 | 2023-12-10 04:16:50 | 0 | 28.55769231 | Fila inicial | 17 | 0:14:48
6 | 14 | 2023-12-10 04:17:49 | 0 | 25.8041958 | Fila final | 42
6 | 14 | 2023-12-10 04:18:48 | 0 | 24.09965035
6 | 14 | 2023-12-10 04:19:47 | 0 | 22.78846154
6 | 14 | 2023-12-10 04:20:46 | 0 | 21.87062937
6 | 14 | 2023-12-10 04:21:46 | 0 | 21.34615385
6 | 14 | 2023-12-10 04:22:45 | 0 | 20.82167832
6 | 14 | 2023-12-10 04:23:44 | 0 | 20.2972028
6 | 14 | 2023-12-10 04:24:43 | 0 | 19.90384615
6 | 14 | 2023-12-10 04:25:43 | 0 | 19.51048951
6 | 14 | 2023-12-10 04:26:42 | 0 | 18.72377622
6 | 14 | 2023-12-10 04:27:41 | 0 | 18.98601399
6 | 14 | 2023-12-10 04:28:40 | 0 | 18.8548951
6 | 14 | 2023-12-10 04:29:40 | 0 | 18.46153846
6 | 14 | 2023-12-10 04:30:39 | 0 | 18.33041958
6 | 14 | 2023-12-10 04:31:38 | 0 | 17.67482517
6 | 14 | 2023-12-10 04:32:37 | 0 | 17.28146853
6 | 14 | 2023-12-10 04:33:37 | 0 | 18.1993007
6 | 14 | 2023-12-10 04:34:36 | 0 | 17.93706294
6 | 14 | 2023-12-10 04:35:35 | 0 | 17.28146853
6 | 14 | 2023-12-10 04:36:34 | 0 | 17.54370629
6 | 14 | 2023-12-10 04:37:34 | 0 | 18.06818182
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
