odevincenti/Wet-DryPenguins/Pruebas Experimentales/Prueba Temperatura/Prueba 15C2/PRUEBA_TEMPERATURA_23_15C.xlsx

Sheet: Datos crudos
ID | Run | Timestamp | WetDry | Temperature | Datos válidos |  | Tiempo de establecimiento
23 | 15 | 2023-12-10 03:30:26 | 0 | 26.85314685 | Fila inicial | 17 | 0:15:44
23 | 15 | 2023-12-10 03:31:28 | 0 | 25.41083916 | Fila final | 33
23 | 15 | 2023-12-10 03:32:31 | 0 | 23.57517483
23 | 15 | 2023-12-10 03:33:34 | 0 | 22.00174825
23 | 15 | 2023-12-10 03:34:37 | 0 | 21.60839161
23 | 15 | 2023-12-10 03:35:40 | 0 | 20.82167832
23 | 15 | 2023-12-10 03:36:43 | 0 | 20.55944056
23 | 15 | 2023-12-10 03:37:46 | 0 | 20.03496503
23 | 15 | 2023-12-10 03:38:49 | 0 | 19.77272727
23 | 15 | 2023-12-10 03:39:52 | 0 | 20.03496503
23 | 15 | 2023-12-10 03:40:55 | 0 | 19.24825175
23 | 15 | 2023-12-10 03:41:58 | 0 | 19.51048951
23 | 15 | 2023-12-10 03:43:01 | 0 | 19.64160839
23 | 15 | 2023-12-10 03:44:04 | 0 | 19.24825175
23 | 15 | 2023-12-10 03:45:07 | 0 | 19.37937063
23 | 15 | 2023-12-10 03:46:10 | 0 | 18.8548951
23 | 15 | 2023-12-10 03:47:13 | 0 | 19.11713287
23 | 15 | 2023-12-10 03:48:15 | 0 | 18.8548951
23 | 15 | 2023-12-10 03:49:18 | 0 | 18.72377622
23 | 15 | 2023-12-10 03:50:21 | 0 | 19.11713287
23 | 15 | 2023-12-10 03:51:24 | 0 | 18.59265734
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
