odevincenti/Wet-DryPenguins/Pruebas Experimentales/Prueba Temperatura/Prueba 15C2/PRUEBA_TEMPERATURA_6_15C.xlsx

Sheet: Datos crudos
ID | Run | Timestamp | WetDry | Temperature | Datos válidos |  | Tiempo de establecimiento
6 | 15 | 2023-12-10 03:29:43 | 0 | 26.98426573 | Fila inicial | 21 | 0:19:00
6 | 15 | 2023-12-10 03:30:43 | 0 | 25.1486014 | Fila final | 35
6 | 15 | 2023-12-10 03:31:43 | 0 | 23.83741259
6 | 15 | 2023-12-10 03:32:43 | 0 | 22.65734266
6 | 15 | 2023-12-10 03:33:43 | 0 | 22.00174825
6 | 15 | 2023-12-10 03:34:43 | 0 | 21.73951049
6 | 15 | 2023-12-10 03:35:43 | 0 | 20.82167832
6 | 15 | 2023-12-10 03:36:43 | 0 | 20.55944056
6 | 15 | 2023-12-10 03:37:43 | 0 | 20.16608392
6 | 15 | 2023-12-10 03:38:43 | 0 | 19.64160839
6 | 15 | 2023-12-10 03:39:43 | 0 | 19.37937063
6 | 15 | 2023-12-10 03:40:43 | 0 | 19.37937063
6 | 15 | 2023-12-10 03:41:43 | 0 | 19.24825175
6 | 15 | 2023-12-10 03:42:43 | 0 | 18.98601399
6 | 15 | 2023-12-10 03:43:43 | 0 | 18.8548951
6 | 15 | 2023-12-10 03:44:43 | 0 | 18.72377622
6 | 15 | 2023-12-10 03:45:43 | 0 | 18.72377622
6 | 15 | 2023-12-10 03:46:43 | 0 | 17.93706294
6 | 15 | 2023-12-10 03:47:43 | 0 | 18.72377622
6 | 15 | 2023-12-10 03:48:43 | 0 | 18.33041958
6 | 15 | 2023-12-10 03:49:43 | 0 | 18.33041958
6 | 15 | 2023-12-10 03:50:43 | 0 | 17.41258741
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
