odevincenti/Wet-DryPenguins/Pruebas Experimentales/Prueba Temperatura/Prueba 16C/PRUEBA_TEMPERATURA_23_16C.xlsx

Sheet: Datos crudos
ID | Run | Timestamp | WetDry | Temperature | Datos válidos |  | Tiempo de establecimiento
23 | 16 | 2023-12-09 07:16:32 | 0 | 25.67307692 | Fila inicial | 14 | 0:12:15
23 | 16 | 2023-12-09 07:17:33 | 0 | 23.83741259 | Fila final | 31
23 | 16 | 2023-12-09 07:18:34 | 0 | 22.78846154
23 | 16 | 2023-12-09 07:19:35 | 0 | 21.87062937
23 | 16 | 2023-12-09 07:20:37 | 0 | 21.73951049
23 | 16 | 2023-12-09 07:21:38 | 0 | 21.34615385
23 | 16 | 2023-12-09 07:22:39 | 0 | 21.08391608
23 | 16 | 2023-12-09 07:23:41 | 0 | 20.55944056
23 | 16 | 2023-12-09 07:24:42 | 0 | 20.55944056
23 | 16 | 2023-12-09 07:25:43 | 0 | 20.2972028
23 | 16 | 2023-12-09 07:26:45 | 0 | 19.90384615
23 | 16 | 2023-12-09 07:27:46 | 0 | 20.03496503
23 | 16 | 2023-12-09 07:28:47 | 0 | 19.37937063
23 | 16 | 2023-12-09 07:29:49 | 0 | 19.51048951
23 | 16 | 2023-12-09 07:30:50 | 0 | 19.51048951
23 | 16 | 2023-12-09 07:31:51 | 0 | 19.90384615
23 | 16 | 2023-12-09 07:32:53 | 0 | 19.24825175
23 | 16 | 2023-12-09 07:33:54 | 0 | 19.51048951
23 | 16 | 2023-12-09 07:34:55 | 0 | 19.37937063
23 | 16 | 2023-12-09 07:35:57 | 0 | 19.90384615
23 | 16 | 2023-12-09 07:36:58 | 0 | 19.37937063
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
