odevincenti/Wet-DryPenguins/Pruebas Experimentales/Prueba Temperatura/Prueba 16C/PRUEBA_TEMPERATURA_6_16C.xlsx

Sheet: Datos crudos
ID | Run | Timestamp | WetDry | Temperature | Datos válidos |  | Tiempo de establecimiento
6 | 16 | 2023-12-09 07:18:27 | 0 | 23.96853147 | Fila inicial | 16 | 0:13:56
6 | 16 | 2023-12-09 07:19:26 | 0 | 23.18181818 | Fila final | 31
6 | 16 | 2023-12-09 07:20:26 | 0 | 22.52622378
6 | 16 | 2023-12-09 07:21:26 | 0 | 22.13286713
6 | 16 | 2023-12-09 07:22:26 | 0 | 21.73951049
6 | 16 | 2023-12-09 07:23:25 | 0 | 21.60839161
6 | 16 | 2023-12-09 07:24:25 | 0 | 21.08391608
6 | 16 | 2023-12-09 07:25:25 | 0 | 21.08391608
6 | 16 | 2023-12-09 07:26:25 | 0 | 20.82167832
6 | 16 | 2023-12-09 07:27:25 | 0 | 20.55944056
6 | 16 | 2023-12-09 07:28:24 | 0 | 20.42832168
6 | 16 | 2023-12-09 07:29:24 | 0 | 20.42832168
6 | 16 | 2023-12-09 07:30:24 | 0 | 20.2972028
6 | 16 | 2023-12-09 07:31:24 | 0 | 20.2972028
6 | 16 | 2023-12-09 07:32:23 | 0 | 20.03496503
6 | 16 | 2023-12-09 07:33:23 | 0 | 19.90384615
6 | 16 | 2023-12-09 07:34:23 | 0 | 19.90384615
6 | 16 | 2023-12-09 07:35:23 | 0 | 19.90384615
6 | 16 | 2023-12-09 07:36:23 | 0 | 19.90384615
6 | 16 | 2023-12-09 07:37:22 | 0 | 20.03496503
6 | 16 | 2023-12-09 07:38:22 | 0 | 19.90384615
6 | 16 | 2023-12-09 07:39:22 | 0 | 19.77272727
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
