odevincenti/Wet-DryPenguins/Pruebas Experimentales/Prueba Temperatura/Prueba 16C2/PRUEBA_TEMPERATURA_23_16C.xlsx

Sheet: Datos crudos
ID | Run | Timestamp | WetDry | Temperature | Datos válidos |  | Tiempo de establecimiento
23 | 16 | 2023-12-10 02:32:11 | 0 | 28.55769231 | Fila inicial | 19 | 0:17:27
23 | 16 | 2023-12-10 02:33:12 | 0 | 26.45979021 | Fila final | 42
23 | 16 | 2023-12-10 02:34:14 | 0 | 23.83741259
23 | 16 | 2023-12-10 02:35:15 | 0 | 22.52622378
23 | 16 | 2023-12-10 02:36:17 | 0 | 22.13286713
23 | 16 | 2023-12-10 02:37:19 | 0 | 21.34615385
23 | 16 | 2023-12-10 02:38:20 | 0 | 20.82167832
23 | 16 | 2023-12-10 02:39:22 | 0 | 21.08391608
23 | 16 | 2023-12-10 02:40:23 | 0 | 20.82167832
23 | 16 | 2023-12-10 02:41:25 | 0 | 20.2972028
23 | 16 | 2023-12-10 02:42:27 | 0 | 20.16608392
23 | 16 | 2023-12-10 02:43:28 | 0 | 20.16608392
23 | 16 | 2023-12-10 02:44:30 | 0 | 19.90384615
23 | 16 | 2023-12-10 02:45:31 | 0 | 20.03496503
23 | 16 | 2023-12-10 02:46:33 | 0 | 19.37937063
23 | 16 | 2023-12-10 02:47:35 | 0 | 19.64160839
23 | 16 | 2023-12-10 02:48:36 | 0 | 19.90384615
23 | 16 | 2023-12-10 02:49:38 | 0 | 19.37937063
23 | 16 | 2023-12-10 02:50:39 | 0 | 18.8548951
23 | 16 | 2023-12-10 02:51:41 | 0 | 19.51048951
23 | 16 | 2023-12-10 02:52:43 | 0 | 19.64160839
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
