odevincenti/Wet-DryPenguins/Pruebas Experimentales/Prueba Temperatura/Prueba 16C2/PRUEBA_TEMPERATURA_6_16C.xlsx

Sheet: Datos crudos
ID | Run | Timestamp | WetDry | Temperature | Datos válidos |  | Tiempo de establecimiento
6 | 16 | 2:31:46 | 0 | 29.08216783 | Fila inicial | 18 | 0:15:54
6 | 16 | 2:32:45 | 0 | 26.59090909 | Fila final | 43
6 | 16 | 2:33:45 | 0 | 25.01748252
6 | 16 | 2:34:44 | 0 | 23.70629371
6 | 16 | 2:35:44 | 0 | 22.91958042
6 | 16 | 2:36:44 | 0 | 22.13286713
6 | 16 | 2:37:43 | 0 | 21.73951049
6 | 16 | 2:38:43 | 0 | 21.34615385
6 | 16 | 2:39:43 | 0 | 20.9527972
6 | 16 | 2:40:42 | 0 | 20.69055944
6 | 16 | 2:41:42 | 0 | 20.03496503
6 | 16 | 2:42:42 | 0 | 20.03496503
6 | 16 | 2:43:41 | 0 | 19.77272727
6 | 16 | 2:44:41 | 0 | 19.90384615
6 | 16 | 2:45:41 | 0 | 19.64160839
6 | 16 | 2:46:40 | 0 | 19.51048951
6 | 16 | 2:47:40 | 0 | 19.37937063
6 | 16 | 2:48:40 | 0 | 19.64160839
6 | 16 | 2:49:39 | 0 | 19.24825175
6 | 16 | 2:50:39 | 0 | 19.24825175
6 | 16 | 2:51:39 | 0 | 19.24825175
6 | 16 | 2:52:38 | 0 | 18.98601399
6 | 16 | 2:53:38 | 0 | 18.8548951
6 | 16 | 2:54:37 | 0 | 19.11713287
6 | 16 | 2:55:37 | 0 | 19.37937063
6 | 16 | 2:56:37 | 0 | 18.8548951
6 | 16 | 2:57:36 | 0 | 18.98601399
6 | 16 | 2:58:36 | 0 | 19.11713287
6 | 16 | 2:59:36 | 0 | 19.11713287
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
