odevincenti/Wet-DryPenguins/Pruebas Experimentales/Prueba Temperatura/Prueba 17C/PRUEBA_TEMPERATURA_23_17C.xlsx

Sheet: Datos crudos
ID | Run | Timestamp | WetDry | Temperature | Datos válidos |  | Tiempo de establecimiento
23 | 17 | 2023-12-09 06:23:18 | 0 | 26.85314685 | Fila inicial | 11 | 0:09:19
23 | 17 | 2023-12-09 06:24:20 | 0 | 25.67307692 | Fila final | 38
23 | 17 | 2023-12-09 06:25:22 | 0 | 24.75524476
23 | 17 | 2023-12-09 06:26:24 | 0 | 23.18181818
23 | 17 | 2023-12-09 06:27:26 | 0 | 21.87062937
23 | 17 | 2023-12-09 06:28:28 | 0 | 21.47727273
23 | 17 | 2023-12-09 06:29:30 | 0 | 21.21503497
23 | 17 | 2023-12-09 06:30:32 | 0 | 21.21503497
23 | 17 | 2023-12-09 06:31:35 | 0 | 20.42832168
23 | 17 | 2023-12-09 06:32:37 | 0 | 20.42832168
23 | 17 | 2023-12-09 06:33:39 | 0 | 20.2972028
23 | 17 | 2023-12-09 06:34:41 | 0 | 20.16608392
23 | 17 | 2023-12-09 06:35:43 | 0 | 20.2972028
23 | 17 | 2023-12-09 06:36:45 | 0 | 20.2972028
23 | 17 | 2023-12-09 06:37:47 | 0 | 20.16608392
23 | 17 | 2023-12-09 06:38:50 | 0 | 20.03496503
23 | 17 | 2023-12-09 06:39:52 | 0 | 20.03496503
23 | 17 | 2023-12-09 06:40:54 | 0 | 19.90384615
23 | 17 | 2023-12-09 06:41:56 | 0 | 20.42832168
23 | 17 | 2023-12-09 06:42:58 | 0 | 20.03496503
23 | 17 | 2023-12-09 06:44:00 | 0 | 19.90384615
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
