odevincenti/Wet-DryPenguins/Pruebas Experimentales/Prueba Temperatura/Prueba 17C/PRUEBA_TEMPERATURA_6_17C.xlsx

Sheet: Datos crudos
ID | Run | Timestamp | WetDry | Temperature | Datos válidos |  | Tiempo de establecimiento
6 | 17 | 2023-12-09 06:22:00 | 0 | 25.67307692 | Fila inicial | 18 | 0:16:04
6 | 17 | 2023-12-09 06:23:00 | 0 | 24.36188811 | Fila final | 38
6 | 17 | 2023-12-09 06:24:00 | 0 | 23.44405594
6 | 17 | 2023-12-09 06:25:00 | 0 | 23.0506993
6 | 17 | 2023-12-09 06:26:01 | 0 | 22.3951049
6 | 17 | 2023-12-09 06:27:01 | 0 | 21.87062937
6 | 17 | 2023-12-09 06:28:01 | 0 | 21.60839161
6 | 17 | 2023-12-09 06:29:01 | 0 | 21.47727273
6 | 17 | 2023-12-09 06:30:02 | 0 | 21.34615385
6 | 17 | 2023-12-09 06:31:02 | 0 | 20.9527972
6 | 17 | 2023-12-09 06:32:02 | 0 | 20.9527972
6 | 17 | 2023-12-09 06:33:02 | 0 | 20.55944056
6 | 17 | 2023-12-09 06:34:03 | 0 | 20.69055944
6 | 17 | 2023-12-09 06:35:03 | 0 | 20.42832168
6 | 17 | 2023-12-09 06:36:03 | 0 | 20.42832168
6 | 17 | 2023-12-09 06:37:04 | 0 | 20.2972028
6 | 17 | 2023-12-09 06:38:04 | 0 | 20.16608392
6 | 17 | 2023-12-09 06:39:04 | 0 | 20.16608392
6 | 17 | 2023-12-09 06:40:04 | 0 | 20.16608392
6 | 17 | 2023-12-09 06:41:05 | 0 | 20.03496503
6 | 17 | 2023-12-09 06:42:05 | 0 | 20.03496503
6 | 17 | 2023-12-09 06:43:05 | 0 | 19.90384615
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
