odevincenti/Wet-DryPenguins/Pruebas Experimentales/Prueba Temperatura/Prueba 17C2/PRUEBA_TEMPERATURA_23_17C.xlsx

Sheet: Datos crudos
ID | Run | Timestamp | WetDry | Temperature | Datos válidos |  | Tiempo de establecimiento
23 | 17 | 2023-12-10 01:45:33 | 0 | 24.88636364 | Fila inicial | 15 | 0:13:21
23 | 17 | 2023-12-10 01:46:34 | 0 | 23.0506993 | Fila final | 32
23 | 17 | 2023-12-10 01:47:36 | 0 | 22.26398601
23 | 17 | 2023-12-10 01:48:37 | 0 | 22.00174825
23 | 17 | 2023-12-10 01:49:39 | 0 | 21.21503497
23 | 17 | 2023-12-10 01:50:41 | 0 | 21.73951049
23 | 17 | 2023-12-10 01:51:42 | 0 | 21.34615385
23 | 17 | 2023-12-10 01:52:44 | 0 | 20.82167832
23 | 17 | 2023-12-10 01:53:45 | 0 | 20.9527972
23 | 17 | 2023-12-10 01:54:47 | 0 | 20.55944056
23 | 17 | 2023-12-10 01:55:49 | 0 | 20.16608392
23 | 17 | 2023-12-10 01:56:50 | 0 | 20.2972028
23 | 17 | 2023-12-10 01:57:52 | 0 | 20.16608392
23 | 17 | 2023-12-10 01:58:54 | 0 | 19.77272727
23 | 17 | 2023-12-10 01:59:55 | 0 | 20.16608392
23 | 17 | 2023-12-10 02:00:57 | 0 | 19.77272727
23 | 17 | 2023-12-10 02:01:58 | 0 | 19.51048951
23 | 17 | 2023-12-10 02:03:00 | 0 | 19.90384615
23 | 17 | 2023-12-10 02:04:02 | 0 | 19.77272727
23 | 17 | 2023-12-10 02:05:03 | 0 | 20.03496503
23 | 17 | 2023-12-10 02:06:05 | 0 | 20.03496503
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
