odevincenti/Wet-DryPenguins/Pruebas Experimentales/Prueba Temperatura/Prueba 17C2/PRUEBA_TEMPERATURA_6_17C.xlsx

Sheet: Datos crudos
ID | Run | Timestamp | WetDry | Temperature | Datos válidos |  | Tiempo de establecimiento
6 | 17 | 2023-12-10 01:45:02 | 0 | 25.27972028 | Fila inicial | 16 | 0:14:08
6 | 17 | 2023-12-10 01:46:02 | 0 | 24.36188811 | Fila final | 32
6 | 17 | 2023-12-10 01:47:03 | 0 | 23.31293706
6 | 17 | 2023-12-10 01:48:03 | 0 | 22.3951049
6 | 17 | 2023-12-10 01:49:04 | 0 | 22.26398601
6 | 17 | 2023-12-10 01:50:05 | 0 | 21.87062937
6 | 17 | 2023-12-10 01:51:05 | 0 | 21.47727273
6 | 17 | 2023-12-10 01:52:06 | 0 | 21.21503497
6 | 17 | 2023-12-10 01:53:06 | 0 | 21.08391608
6 | 17 | 2023-12-10 01:54:07 | 0 | 20.55944056
6 | 17 | 2023-12-10 01:55:08 | 0 | 20.55944056
6 | 17 | 2023-12-10 01:56:08 | 0 | 20.69055944
6 | 17 | 2023-12-10 01:57:09 | 0 | 20.55944056
6 | 17 | 2023-12-10 01:58:09 | 0 | 20.42832168
6 | 17 | 2023-12-10 01:59:10 | 0 | 20.03496503
6 | 17 | 2023-12-10 02:00:11 | 0 | 20.16608392
6 | 17 | 2023-12-10 02:01:11 | 0 | 20.03496503
6 | 17 | 2023-12-10 02:02:12 | 0 | 19.90384615
6 | 17 | 2023-12-10 02:03:12 | 0 | 20.03496503
6 | 17 | 2023-12-10 02:04:13 | 0 | 20.03496503
6 | 17 | 2023-12-10 02:05:14 | 0 | 20.03496503
6 | 17 | 2023-12-10 02:06:14 | 0 | 19.90384615
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
