odevincenti/Wet-DryPenguins/Pruebas Experimentales/Prueba Temperatura/Prueba 18C/PRUEBA_TEMPERATURA_23_18C.xlsx

Sheet: Datos crudos
ID | Run | Timestamp | WetDry | Temperature | Datos válidos |  | Tiempo de establecimiento
23 | 18 | 2023-12-10 00:40:28 | 0 | 25.8041958 | Fila inicial | 12 | 0:10:20
23 | 18 | 2023-12-10 00:41:30 | 0 | 24.75524476 | Fila final | 34
23 | 18 | 2023-12-10 00:42:32 | 0 | 22.78846154
23 | 18 | 2023-12-10 00:43:34 | 0 | 22.26398601
23 | 18 | 2023-12-10 00:44:36 | 0 | 21.87062937
23 | 18 | 2023-12-10 00:45:38 | 0 | 21.73951049
23 | 18 | 2023-12-10 00:46:40 | 0 | 21.60839161
23 | 18 | 2023-12-10 00:47:42 | 0 | 21.34615385
23 | 18 | 2023-12-10 00:48:44 | 0 | 21.34615385
23 | 18 | 2023-12-10 00:49:46 | 0 | 20.82167832
23 | 18 | 2023-12-10 00:50:48 | 0 | 20.42832168
23 | 18 | 2023-12-10 00:51:50 | 0 | 20.82167832
23 | 18 | 2023-12-10 00:52:53 | 0 | 20.82167832
23 | 18 | 2023-12-10 00:53:55 | 0 | 20.55944056
23 | 18 | 2023-12-10 00:54:57 | 0 | 20.16608392
23 | 18 | 2023-12-10 00:55:59 | 0 | 20.16608392
23 | 18 | 2023-12-10 00:57:01 | 0 | 20.42832168
23 | 18 | 2023-12-10 00:58:03 | 0 | 20.69055944
23 | 18 | 2023-12-10 00:59:05 | 0 | 20.55944056
23 | 18 | 2023-12-10 01:00:07 | 0 | 20.2972028
23 | 18 | 2023-12-10 01:01:09 | 0 | 20.16608392
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
