odevincenti/Wet-DryPenguins/Pruebas Experimentales/Prueba Temperatura/Prueba 18C/PRUEBA_TEMPERATURA_6_18C.xlsx

Sheet: Datos crudos
ID | Run | Timestamp | WetDry | Temperature | Datos válidos |  | Tiempo de establecimiento
6 | 18 | 2023-12-10 00:39:28 | 0 | 25.27972028 | Fila inicial | 15 | 0:13:13
6 | 18 | 2023-12-10 00:40:29 | 0 | 24.88636364 | Fila final | 35
6 | 18 | 2023-12-10 00:41:30 | 0 | 23.83741259
6 | 18 | 2023-12-10 00:42:31 | 0 | 23.18181818
6 | 18 | 2023-12-10 00:43:32 | 0 | 22.91958042
6 | 18 | 2023-12-10 00:44:33 | 0 | 22.13286713
6 | 18 | 2023-12-10 00:45:34 | 0 | 22.13286713
6 | 18 | 2023-12-10 00:46:35 | 0 | 21.73951049
6 | 18 | 2023-12-10 00:47:36 | 0 | 21.73951049
6 | 18 | 2023-12-10 00:48:37 | 0 | 21.47727273
6 | 18 | 2023-12-10 00:49:38 | 0 | 21.21503497
6 | 18 | 2023-12-10 00:50:39 | 0 | 20.9527972
6 | 18 | 2023-12-10 00:51:40 | 0 | 21.08391608
6 | 18 | 2023-12-10 00:52:41 | 0 | 20.82167832
6 | 18 | 2023-12-10 00:53:42 | 0 | 20.69055944
6 | 18 | 2023-12-10 00:54:43 | 0 | 20.9527972
6 | 18 | 2023-12-10 00:55:44 | 0 | 20.82167832
6 | 18 | 2023-12-10 00:56:45 | 0 | 20.69055944
6 | 18 | 2023-12-10 00:57:46 | 0 | 20.69055944
6 | 18 | 2023-12-10 00:58:47 | 0 | 20.55944056
6 | 18 | 2023-12-10 00:59:48 | 0 | 20.69055944
6 | 18 | 2023-12-10 01:00:49 | 0 | 20.69055944
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
