odevincenti/Wet-DryPenguins/Pruebas Experimentales/Prueba Temperatura/Prueba 18C1/PRUEBA_TEMPERATURA_23_18C.xlsx

Sheet: Datos crudos
ID | Run | Timestamp | WetDry | Temperature | Datos válidos |  | Tiempo de establecimiento
23 | 18 | 2023-12-09 05:26:09 | 0 | 25.8041958 | Fila inicial | 15 | 0:13:27
23 | 18 | 2023-12-09 05:27:11 | 0 | 23.96853147 | Fila final | 40
23 | 18 | 2023-12-09 05:28:13 | 0 | 23.0506993
23 | 18 | 2023-12-09 05:29:15 | 0 | 23.57517483
23 | 18 | 2023-12-09 05:30:17 | 0 | 22.13286713
23 | 18 | 2023-12-09 05:31:19 | 0 | 21.87062937
23 | 18 | 2023-12-09 05:32:21 | 0 | 21.87062937
23 | 18 | 2023-12-09 05:33:23 | 0 | 21.60839161
23 | 18 | 2023-12-09 05:34:26 | 0 | 21.08391608
23 | 18 | 2023-12-09 05:35:28 | 0 | 21.08391608
23 | 18 | 2023-12-09 05:36:30 | 0 | 21.08391608
23 | 18 | 2023-12-09 05:37:32 | 0 | 21.08391608
23 | 18 | 2023-12-09 05:38:34 | 0 | 20.69055944
23 | 18 | 2023-12-09 05:39:36 | 0 | 20.42832168
23 | 18 | 2023-12-09 05:40:38 | 0 | 20.9527972
23 | 18 | 2023-12-09 05:41:40 | 0 | 20.55944056
23 | 18 | 2023-12-09 05:42:43 | 0 | 20.2972028
23 | 18 | 2023-12-09 05:43:45 | 0 | 20.55944056
23 | 18 | 2023-12-09 05:44:47 | 0 | 20.2972028
23 | 18 | 2023-12-09 05:45:49 | 0 | 20.55944056
23 | 18 | 2023-12-09 05:46:51 | 0 | 20.55944056
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
