odevincenti/Wet-DryPenguins/Pruebas Experimentales/Prueba Temperatura/Prueba 18C1/PRUEBA_TEMPERATURA_6_18C.xlsx

Sheet: Datos crudos
ID | Run | Timestamp | WetDry | Temperature | Datos válidos |  | Tiempo de establecimiento
6 | 18 | 2023-12-09 05:24:58 | 0 | 24.88636364 | Fila inicial | 16 | 0:14:12
6 | 18 | 2023-12-09 05:25:58 | 0 | 24.23076923 | Fila final | 38
6 | 18 | 2023-12-09 05:26:59 | 0 | 23.57517483
6 | 18 | 2023-12-09 05:28:00 | 0 | 23.0506993
6 | 18 | 2023-12-09 05:29:01 | 0 | 22.91958042
6 | 18 | 2023-12-09 05:30:02 | 0 | 22.52622378
6 | 18 | 2023-12-09 05:31:03 | 0 | 22.3951049
6 | 18 | 2023-12-09 05:32:04 | 0 | 21.73951049
6 | 18 | 2023-12-09 05:33:05 | 0 | 21.87062937
6 | 18 | 2023-12-09 05:34:06 | 0 | 21.47727273
6 | 18 | 2023-12-09 05:35:06 | 0 | 21.60839161
6 | 18 | 2023-12-09 05:36:07 | 0 | 21.21503497
6 | 18 | 2023-12-09 05:37:08 | 0 | 21.47727273
6 | 18 | 2023-12-09 05:38:09 | 0 | 21.47727273
6 | 18 | 2023-12-09 05:39:10 | 0 | 21.08391608
6 | 18 | 2023-12-09 05:40:11 | 0 | 21.08391608
6 | 18 | 2023-12-09 05:41:12 | 0 | 20.9527972
6 | 18 | 2023-12-09 05:42:13 | 0 | 21.08391608
6 | 18 | 2023-12-09 05:43:14 | 0 | 21.08391608
6 | 18 | 2023-12-09 05:44:15 | 0 | 21.08391608
6 | 18 | 2023-12-09 05:45:15 | 0 | 20.9527972
6 | 18 | 2023-12-09 05:46:16 | 0 | 20.9527972
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
