odevincenti/Wet-DryPenguins/Pruebas Experimentales/Prueba Temperatura/Prueba 18C2/PRUEBA_TEMPERATURA_23_18C.csv

ID | Run | Timestamp | WetDry | Temperature
23 | 18 | 2023-12-09 20:35:12 | 0 | 22.657342657342667
23 | 18 | 2023-12-09 20:36:13 | 0 | 20.82167832167835
23 | 18 | 2023-12-09 20:37:15 | 0 | 20.03496503496507
23 | 18 | 2023-12-09 20:38:17 | 0 | 19.90384615384619
23 | 18 | 2023-12-09 20:39:18 | 0 | 19.24825174825179
23 | 18 | 2023-12-09 20:40:20 | 0 | 19.11713286713291
23 | 18 | 2023-12-09 20:41:22 | 0 | 18.461538461538453
23 | 18 | 2023-12-09 20:42:24 | 0 | 17.805944055944053
23 | 18 | 2023-12-09 20:43:25 | 0 | 16.625874125874134
23 | 18 | 2023-12-09 20:44:27 | 0 | 15.839160839160854
23 | 18 | 2023-12-09 20:45:29 | 0 | 15.052447552447575
23 | 18 | 2023-12-09 20:46:31 | 0 | 14.527972027972055
23 | 18 | 2023-12-09 20:47:32 | 0 | 13.872377622377655
23 | 18 | 2023-12-09 20:48:34 | 0 | 13.216783216783256
23 | 18 | 2023-12-09 20:49:36 | 0 | 12.954545454545496
23 | 18 | 2023-12-09 20:50:38 | 0 | 13.347902097902136
23 | 18 | 2023-12-09 20:51:39 | 0 | 14.134615384615415
23 | 18 | 2023-12-09 20:52:41 | 0 | 14.396853146853175
23 | 18 | 2023-12-09 20:53:43 | 0 | 14.396853146853175
23 | 18 | 2023-12-09 20:54:45 | 0 | 14.396853146853175
23 | 18 | 2023-12-09 20:55:46 | 0 | 13.741258741258775
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
