odevincenti/Wet-DryPenguins/Pruebas Experimentales/Prueba Temperatura/Prueba 18C3/PRUEBA_TEMPERATURA_23_18C.csv

ID | Run | Timestamp | WetDry | Temperature
23 | 18 | 2023-12-09 21:36:45 | 0 | 28.16433566433568
23 | 18 | 2023-12-09 21:37:46 | 0 | 28.6888111888112
23 | 18 | 2023-12-09 21:38:48 | 0 | 24.755244755244746
23 | 18 | 2023-12-09 21:39:50 | 0 | 20.82167832167835
23 | 18 | 2023-12-09 21:40:52 | 0 | 19.51048951048955
23 | 18 | 2023-12-09 21:41:53 | 0 | 17.937062937062933
23 | 18 | 2023-12-09 21:42:55 | 0 | 16.494755244755254
23 | 18 | 2023-12-09 21:43:57 | 0 | 15.708041958041974
23 | 18 | 2023-12-09 21:44:59 | 0 | 15.708041958041974
23 | 18 | 2023-12-09 21:46:01 | 0 | 15.970279720279734
23 | 18 | 2023-12-09 21:47:02 | 0 | 16.363636363636374
23 | 18 | 2023-12-09 21:48:04 | 0 | 16.888111888111894
23 | 18 | 2023-12-09 21:49:06 | 0 | 16.756993006993014
23 | 18 | 2023-12-09 21:50:08 | 0 | 16.101398601398614
23 | 18 | 2023-12-09 21:51:10 | 0 | 16.363636363636374
23 | 18 | 2023-12-09 21:52:11 | 0 | 16.756993006993014
23 | 18 | 2023-12-09 21:53:13 | 0 | 15.970279720279734
23 | 18 | 2023-12-09 21:54:15 | 0 | 16.756993006993014
23 | 18 | 2023-12-09 21:55:17 | 0 | 16.888111888111894
23 | 18 | 2023-12-09 21:56:19 | 0 | 16.494755244755254
23 | 18 | 2023-12-09 21:57:20 | 0 | 16.232517482517494
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
