odevincenti/Wet-DryPenguins/Pruebas Experimentales/Prueba Temperatura/Prueba 18C3/PRUEBA_TEMPERATURA_6_18C.csv

ID | Run | Timestamp | WetDry | Temperature
6 | 18 | 2023-12-09 21:35:57 | 0 | 26.984265734265705
6 | 18 | 2023-12-09 21:36:58 | 0 | 28.55769230769232
6 | 18 | 2023-12-09 21:37:59 | 0 | 27.902097902097864
6 | 18 | 2023-12-09 21:39:01 | 0 | 23.837412587412587
6 | 18 | 2023-12-09 21:40:02 | 0 | 21.47727272727269
6 | 18 | 2023-12-09 21:41:04 | 0 | 19.379370629370612
6 | 18 | 2023-12-09 21:42:05 | 0 | 17.674825174825173
6 | 18 | 2023-12-09 21:43:07 | 0 | 15.445804195804158
6 | 18 | 2023-12-09 21:44:08 | 0 | 14.396853146853118
6 | 18 | 2023-12-09 21:45:10 | 0 | 14.265734265734238
6 | 18 | 2023-12-09 21:46:11 | 0 | 14.659090909090878
6 | 18 | 2023-12-09 21:47:13 | 0 | 15.052447552447518
6 | 18 | 2023-12-09 21:48:14 | 0 | 15.708041958041974
6 | 18 | 2023-12-09 21:49:16 | 0 | 15.576923076923038
6 | 18 | 2023-12-09 21:50:17 | 0 | 14.921328671328638
6 | 18 | 2023-12-09 21:51:19 | 0 | 14.921328671328638
6 | 18 | 2023-12-09 21:52:20 | 0 | 15.314685314685278
6 | 18 | 2023-12-09 21:53:21 | 0 | 15.052447552447518
6 | 18 | 2023-12-09 21:54:23 | 0 | 14.921328671328638
6 | 18 | 2023-12-09 21:55:24 | 0 | 15.314685314685278
6 | 18 | 2023-12-09 21:56:26 | 0 | 15.052447552447518
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
