odevincenti/Wet-DryPenguins/Pruebas Experimentales/Prueba Temperatura/Prueba 19C1/PRUEBA_TEMPERATURA_23_19C.xlsx

Sheet: Datos crudos
ID | Run | Timestamp | WetDry | Temperature | Datos válidos |  | Tiempo de establecimiento
23 | 19 | 2023-12-09 04:29:23 | 0 | 25.1486014 | Fila inicial | 15 | 0:13:22
23 | 19 | 2023-12-09 04:30:24 | 0 | 24.49300699 | Fila final | 36
23 | 19 | 2023-12-09 04:31:26 | 0 | 22.52622378
23 | 19 | 2023-12-09 04:32:28 | 0 | 22.13286713
23 | 19 | 2023-12-09 04:33:29 | 0 | 21.87062937
23 | 19 | 2023-12-09 04:34:31 | 0 | 21.60839161
23 | 19 | 2023-12-09 04:35:33 | 0 | 21.34615385
23 | 19 | 2023-12-09 04:36:35 | 0 | 21.21503497
23 | 19 | 2023-12-09 04:37:36 | 0 | 21.34615385
23 | 19 | 2023-12-09 04:38:38 | 0 | 21.21503497
23 | 19 | 2023-12-09 04:39:40 | 0 | 21.34615385
23 | 19 | 2023-12-09 04:40:42 | 0 | 21.08391608
23 | 19 | 2023-12-09 04:41:43 | 0 | 20.82167832
23 | 19 | 2023-12-09 04:42:45 | 0 | 20.69055944
23 | 19 | 2023-12-09 04:43:47 | 0 | 20.69055944
23 | 19 | 2023-12-09 04:44:49 | 0 | 20.82167832
23 | 19 | 2023-12-09 04:45:50 | 0 | 20.55944056
23 | 19 | 2023-12-09 04:46:52 | 0 | 20.82167832
23 | 19 | 2023-12-09 04:47:54 | 0 | 21.21503497
23 | 19 | 2023-12-09 04:48:56 | 0 | 20.82167832
23 | 19 | 2023-12-09 04:49:57 | 0 | 20.55944056
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
