odevincenti/Wet-DryPenguins/Pruebas Experimentales/Prueba Temperatura/Prueba 19C1/PRUEBA_TEMPERATURA_6_19C.xlsx

Sheet: Datos crudos
ID | Run | Timestamp | WetDry | Temperature | Datos válidos |  | Tiempo de establecimiento
6 | 19 | 2023-12-09 04:28:21 | 0 | 24.49300699 | Fila inicial | 17 | 0:15:12
6 | 19 | 2023-12-09 04:29:21 | 0 | 24.09965035 | Fila final | 35
6 | 19 | 2023-12-09 04:30:22 | 0 | 23.31293706
6 | 19 | 2023-12-09 04:31:23 | 0 | 23.18181818
6 | 19 | 2023-12-09 04:32:24 | 0 | 22.91958042
6 | 19 | 2023-12-09 04:33:25 | 0 | 22.78846154
6 | 19 | 2023-12-09 04:34:26 | 0 | 22.52622378
6 | 19 | 2023-12-09 04:35:26 | 0 | 22.52622378
6 | 19 | 2023-12-09 04:36:27 | 0 | 22.26398601
6 | 19 | 2023-12-09 04:37:28 | 0 | 22.13286713
6 | 19 | 2023-12-09 04:38:29 | 0 | 21.87062937
6 | 19 | 2023-12-09 04:39:30 | 0 | 21.73951049
6 | 19 | 2023-12-09 04:40:31 | 0 | 21.73951049
6 | 19 | 2023-12-09 04:41:32 | 0 | 21.47727273
6 | 19 | 2023-12-09 04:42:32 | 0 | 20.82167832
6 | 19 | 2023-12-09 04:43:33 | 0 | 21.60839161
6 | 19 | 2023-12-09 04:44:34 | 0 | 21.47727273
6 | 19 | 2023-12-09 04:45:35 | 0 | 21.60839161
6 | 19 | 2023-12-09 04:46:36 | 0 | 21.21503497
6 | 19 | 2023-12-09 04:47:37 | 0 | 21.47727273
6 | 19 | 2023-12-09 04:48:38 | 0 | 21.21503497
6 | 19 | 2023-12-09 04:49:38 | 0 | 21.60839161
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
