odevincenti/Wet-DryPenguins/Pruebas Experimentales/Prueba Temperatura/Prueba 20C1/PRUEBA_TEMPERATURA_23_20C.xlsx

Sheet: Datos crudos
ID | Run | Timestamp | WetDry | Temperature | Datos válidos |  | Tiempo de establecimiento
23 | 20 | 2023-12-09 03:27:23 | 0 | 25.67307692 | Fila inicial | 15 | 0:13:11
23 | 20 | 2023-12-09 03:28:23 | 0 | 25.01748252 | Fila final | 44
23 | 20 | 2023-12-09 03:29:24 | 0 | 23.0506993
23 | 20 | 2023-12-09 03:30:25 | 0 | 22.91958042
23 | 20 | 2023-12-09 03:31:26 | 0 | 22.26398601
23 | 20 | 2023-12-09 03:32:27 | 0 | 22.13286713
23 | 20 | 2023-12-09 03:33:28 | 0 | 22.00174825
23 | 20 | 2023-12-09 03:34:29 | 0 | 21.87062937
23 | 20 | 2023-12-09 03:35:30 | 0 | 21.47727273
23 | 20 | 2023-12-09 03:36:31 | 0 | 21.60839161
23 | 20 | 2023-12-09 03:37:32 | 0 | 21.47727273
23 | 20 | 2023-12-09 03:38:32 | 0 | 21.87062937
23 | 20 | 2023-12-09 03:39:33 | 0 | 21.47727273
23 | 20 | 2023-12-09 03:40:34 | 0 | 20.9527972
23 | 20 | 2023-12-09 03:41:35 | 0 | 21.34615385
23 | 20 | 2023-12-09 03:42:36 | 0 | 21.21503497
23 | 20 | 2023-12-09 03:43:37 | 0 | 21.34615385
23 | 20 | 2023-12-09 03:44:38 | 0 | 21.21503497
23 | 20 | 2023-12-09 03:45:39 | 0 | 20.82167832
23 | 20 | 2023-12-09 03:46:40 | 0 | 20.9527972
23 | 20 | 2023-12-09 03:47:41 | 0 | 21.34615385
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
