odevincenti/Wet-DryPenguins/Pruebas Experimentales/Prueba Temperatura/Prueba 20C1/PRUEBA_TEMPERATURA_6_20C.xlsx

Sheet: Datos crudos
ID | Run | Timestamp | WetDry | Temperature | Datos válidos |  | Tiempo de establecimiento
6 | 20 | 2023-12-09 03:26:00 | 0 | 25.27972028 | Fila inicial | 19 | 0:16:58
6 | 20 | 2023-12-09 03:26:59 | 0 | 24.62412587 | Fila final | 43
6 | 20 | 2023-12-09 03:27:59 | 0 | 23.96853147
6 | 20 | 2023-12-09 03:28:59 | 0 | 23.70629371
6 | 20 | 2023-12-09 03:29:59 | 0 | 23.18181818
6 | 20 | 2023-12-09 03:30:59 | 0 | 23.18181818
6 | 20 | 2023-12-09 03:31:59 | 0 | 22.91958042
6 | 20 | 2023-12-09 03:32:59 | 0 | 22.65734266
6 | 20 | 2023-12-09 03:33:59 | 0 | 22.52622378
6 | 20 | 2023-12-09 03:34:59 | 0 | 22.13286713
6 | 20 | 2023-12-09 03:35:59 | 0 | 22.3951049
6 | 20 | 2023-12-09 03:36:58 | 0 | 22.13286713
6 | 20 | 2023-12-09 03:37:58 | 0 | 22.13286713
6 | 20 | 2023-12-09 03:38:58 | 0 | 22.26398601
6 | 20 | 2023-12-09 03:39:58 | 0 | 22.00174825
6 | 20 | 2023-12-09 03:40:58 | 0 | 22.00174825
6 | 20 | 2023-12-09 03:41:58 | 0 | 22.13286713
6 | 20 | 2023-12-09 03:42:58 | 0 | 21.60839161
6 | 20 | 2023-12-09 03:43:58 | 0 | 21.87062937
6 | 20 | 2023-12-09 03:44:58 | 0 | 21.87062937
6 | 20 | 2023-12-09 03:45:58 | 0 | 21.73951049
6 | 20 | 2023-12-09 03:46:58 | 0 | 21.87062937
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
