odevincenti/Wet-DryPenguins/Pruebas Experimentales/Prueba Temperatura/Prueba 21C1/PRUEBA_TEMPERATURA_23_21C.xlsx

Sheet: Datos crudos
ID | Run | Timestamp | WetDry | Temperature | Datos válidos |  | Tiempo de establecimiento
23 | 21 | 2023-12-09 01:40:30 | 0 | 25.67307692 | Fila inicial | 13 | 0:11:27
23 | 21 | 2023-12-09 01:41:32 | 0 | 25.1486014 | Fila final | 35
23 | 21 | 2023-12-09 01:42:34 | 0 | 23.44405594
23 | 21 | 2023-12-09 01:43:37 | 0 | 23.83741259
23 | 21 | 2023-12-09 01:44:39 | 0 | 23.0506993
23 | 21 | 2023-12-09 01:45:42 | 0 | 22.91958042
23 | 21 | 2023-12-09 01:46:44 | 0 | 22.52622378
23 | 21 | 2023-12-09 01:47:47 | 0 | 22.52622378
23 | 21 | 2023-12-09 01:48:49 | 0 | 22.65734266
23 | 21 | 2023-12-09 01:49:52 | 0 | 22.52622378
23 | 21 | 2023-12-09 01:50:54 | 0 | 22.13286713
23 | 21 | 2023-12-09 01:51:57 | 0 | 22.00174825
23 | 21 | 2023-12-09 01:52:59 | 0 | 22.26398601
23 | 21 | 2023-12-09 01:54:02 | 0 | 22.26398601
23 | 21 | 2023-12-09 01:55:04 | 0 | 22.00174825
23 | 21 | 2023-12-09 01:56:07 | 0 | 21.87062937
23 | 21 | 2023-12-09 01:57:09 | 0 | 21.60839161
23 | 21 | 2023-12-09 01:58:11 | 0 | 21.87062937
23 | 21 | 2023-12-09 01:59:14 | 0 | 21.60839161
23 | 21 | 2023-12-09 02:00:16 | 0 | 21.60839161
23 | 21 | 2023-12-09 02:01:19 | 0 | 21.87062937
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
