odevincenti/Wet-DryPenguins/Pruebas Experimentales/Prueba Temperatura/Prueba 21C1/PRUEBA_TEMPERATURA_6_21C.xlsx

Sheet: Datos crudos
ID | Run | Timestamp | WetDry | Temperature | Datos válidos |  | Tiempo de establecimiento
6 | 21 | 2023-12-09 01:39:47 | 0 | 25.27972028 | Fila inicial | 15 | 0:13:11
6 | 21 | 2023-12-09 01:40:47 | 0 | 24.75524476 | Fila final | 35
6 | 21 | 2023-12-09 01:41:48 | 0 | 24.36188811
6 | 21 | 2023-12-09 01:42:49 | 0 | 24.09965035
6 | 21 | 2023-12-09 01:43:50 | 0 | 23.83741259
6 | 21 | 2023-12-09 01:44:51 | 0 | 23.57517483
6 | 21 | 2023-12-09 01:45:52 | 0 | 23.44405594
6 | 21 | 2023-12-09 01:46:53 | 0 | 23.31293706
6 | 21 | 2023-12-09 01:47:54 | 0 | 23.0506993
6 | 21 | 2023-12-09 01:48:55 | 0 | 22.91958042
6 | 21 | 2023-12-09 01:49:56 | 0 | 22.78846154
6 | 21 | 2023-12-09 01:50:57 | 0 | 22.78846154
6 | 21 | 2023-12-09 01:51:57 | 0 | 22.65734266
6 | 21 | 2023-12-09 01:52:58 | 0 | 22.3951049
6 | 21 | 2023-12-09 01:53:59 | 0 | 22.52622378
6 | 21 | 2023-12-09 01:55:00 | 0 | 22.3951049
6 | 21 | 2023-12-09 01:56:01 | 0 | 22.3951049
6 | 21 | 2023-12-09 01:57:02 | 0 | 22.52622378
6 | 21 | 2023-12-09 01:58:03 | 0 | 22.52622378
6 | 21 | 2023-12-09 01:59:04 | 0 | 22.52622378
6 | 21 | 2023-12-09 02:00:05 | 0 | 22.26398601
6 | 21 | 2023-12-09 02:01:06 | 0 | 22.52622378
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
