odevincenti/Wet-DryPenguins/Pruebas Experimentales/Prueba Temperatura/Prueba 22C1/PRUEBA_TEMPERATURA_23_22C.xlsx

Sheet: Datos crudos
ID | Run | Timestamp | WetDry | Temperature | Datos válidos |  | Tiempo de establecimiento
23 | 22 | 2023-12-09 00:50:57 | 0 | 25.8041958 | Fila inicial | 21 | 0:19:42
23 | 22 | 2023-12-09 00:51:59 | 0 | 25.27972028 | Fila final | 37
23 | 22 | 2023-12-09 00:53:01 | 0 | 24.88636364
23 | 22 | 2023-12-09 00:54:03 | 0 | 24.62412587
23 | 22 | 2023-12-09 00:55:06 | 0 | 23.18181818
23 | 22 | 2023-12-09 00:56:08 | 0 | 23.18181818
23 | 22 | 2023-12-09 00:57:10 | 0 | 23.0506993
23 | 22 | 2023-12-09 00:58:12 | 0 | 22.78846154
23 | 22 | 2023-12-09 00:59:15 | 0 | 22.65734266
23 | 22 | 2023-12-09 01:00:17 | 0 | 22.65734266
23 | 22 | 2023-12-09 01:01:19 | 0 | 22.52622378
23 | 22 | 2023-12-09 01:02:21 | 0 | 22.52622378
23 | 22 | 2023-12-09 01:03:24 | 0 | 22.52622378
23 | 22 | 2023-12-09 01:04:26 | 0 | 22.26398601
23 | 22 | 2023-12-09 01:05:28 | 0 | 23.0506993
23 | 22 | 2023-12-09 01:06:30 | 0 | 23.44405594
23 | 22 | 2023-12-09 01:07:33 | 0 | 22.91958042
23 | 22 | 2023-12-09 01:08:35 | 0 | 22.26398601
23 | 22 | 2023-12-09 01:09:37 | 0 | 23.0506993
23 | 22 | 2023-12-09 01:10:39 | 0 | 22.13286713
23 | 22 | 2023-12-09 01:11:42 | 0 | 22.26398601
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
