odevincenti/Wet-DryPenguins/Pruebas Experimentales/Prueba Temperatura/Prueba 22C1/PRUEBA_TEMPERATURA_6_22C.xlsx

Sheet: Datos crudos
ID | Run | Timestamp | WetDry | Temperature | Datos válidos |  | Tiempo de establecimiento
6 | 22 | 2023-12-09 00:49:50 | 0 | 25.41083916 | Fila inicial | 19 | 0:17:09
6 | 22 | 2023-12-09 00:50:50 | 0 | 25.01748252 | Fila final | 37
6 | 22 | 2023-12-09 00:51:51 | 0 | 24.88636364
6 | 22 | 2023-12-09 00:52:51 | 0 | 24.36188811
6 | 22 | 2023-12-09 00:53:52 | 0 | 23.96853147
6 | 22 | 2023-12-09 00:54:52 | 0 | 23.96853147
6 | 22 | 2023-12-09 00:55:53 | 0 | 23.70629371
6 | 22 | 2023-12-09 00:56:54 | 0 | 23.44405594
6 | 22 | 2023-12-09 00:57:54 | 0 | 23.44405594
6 | 22 | 2023-12-09 00:58:55 | 0 | 23.18181818
6 | 22 | 2023-12-09 00:59:55 | 0 | 23.44405594
6 | 22 | 2023-12-09 01:00:56 | 0 | 23.0506993
6 | 22 | 2023-12-09 01:01:56 | 0 | 23.44405594
6 | 22 | 2023-12-09 01:02:57 | 0 | 23.18181818
6 | 22 | 2023-12-09 01:03:58 | 0 | 23.0506993
6 | 22 | 2023-12-09 01:04:58 | 0 | 23.18181818
6 | 22 | 2023-12-09 01:05:59 | 0 | 23.18181818
6 | 22 | 2023-12-09 01:06:59 | 0 | 22.91958042
6 | 22 | 2023-12-09 01:08:00 | 0 | 22.91958042
6 | 22 | 2023-12-09 01:09:01 | 0 | 22.91958042
6 | 22 | 2023-12-09 01:10:01 | 0 | 22.91958042
6 | 22 | 2023-12-09 01:11:02 | 0 | 22.91958042
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
