odevincenti/Wet-DryPenguins/Pruebas Experimentales/Prueba Temperatura/Prueba 23C1/PRUEBA_TEMPERATURA_23_23C.xlsx

Sheet: Datos crudos
ID | Run | Timestamp | WetDry | Temperature | Datos válidos |  | Tiempo de establecimiento
23 | 23 | 2023-12-09 00:04:04 | 0 | 25.8041958 | Fila inicial | 15 | 0:13:26
23 | 23 | 2023-12-09 00:05:06 | 0 | 25.54195804 | Fila final | 32
23 | 23 | 2023-12-09 00:06:08 | 0 | 25.27972028
23 | 23 | 2023-12-09 00:07:10 | 0 | 25.1486014
23 | 23 | 2023-12-09 00:08:12 | 0 | 23.57517483
23 | 23 | 2023-12-09 00:09:14 | 0 | 23.96853147
23 | 23 | 2023-12-09 00:10:16 | 0 | 24.75524476
23 | 23 | 2023-12-09 00:11:18 | 0 | 23.18181818
23 | 23 | 2023-12-09 00:12:20 | 0 | 24.49300699
23 | 23 | 2023-12-09 00:13:22 | 0 | 24.49300699
23 | 23 | 2023-12-09 00:14:24 | 0 | 23.18181818
23 | 23 | 2023-12-09 00:15:26 | 0 | 23.0506993
23 | 23 | 2023-12-09 00:16:28 | 0 | 23.57517483
23 | 23 | 2023-12-09 00:17:30 | 0 | 23.0506993
23 | 23 | 2023-12-09 00:18:32 | 0 | 22.78846154
23 | 23 | 2023-12-09 00:19:34 | 0 | 22.91958042
23 | 23 | 2023-12-09 00:20:36 | 0 | 23.18181818
23 | 23 | 2023-12-09 00:21:38 | 0 | 23.0506993
23 | 23 | 2023-12-09 00:22:40 | 0 | 22.78846154
23 | 23 | 2023-12-09 00:23:42 | 0 | 22.91958042
23 | 23 | 2023-12-09 00:24:44 | 0 | 23.83741259
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
