odevincenti/Wet-DryPenguins/Pruebas Experimentales/Prueba Temperatura/Prueba 23C1/PRUEBA_TEMPERATURA_6_23C.xlsx

Sheet: Datos crudos
ID | Run | Timestamp | WetDry | Temperature | Datos válidos |  | Tiempo de establecimiento
6 | 23 | 2023-12-09 00:05:42 | 0 | 25.27972028 | Fila inicial | 12 | 0:10:07
6 | 23 | 2023-12-09 00:06:42 | 0 | 25.27972028 | Fila final | 35
6 | 23 | 2023-12-09 00:07:43 | 0 | 24.62412587
6 | 23 | 2023-12-09 00:08:44 | 0 | 24.49300699
6 | 23 | 2023-12-09 00:09:45 | 0 | 24.49300699
6 | 23 | 2023-12-09 00:10:45 | 0 | 24.36188811
6 | 23 | 2023-12-09 00:11:46 | 0 | 24.23076923
6 | 23 | 2023-12-09 00:12:47 | 0 | 24.23076923
6 | 23 | 2023-12-09 00:13:48 | 0 | 23.96853147
6 | 23 | 2023-12-09 00:14:49 | 0 | 23.83741259
6 | 23 | 2023-12-09 00:15:49 | 0 | 23.70629371
6 | 23 | 2023-12-09 00:16:50 | 0 | 23.70629371
6 | 23 | 2023-12-09 00:17:51 | 0 | 23.70629371
6 | 23 | 2023-12-09 00:18:52 | 0 | 23.57517483
6 | 23 | 2023-12-09 00:19:53 | 0 | 23.44405594
6 | 23 | 2023-12-09 00:20:53 | 0 | 23.57517483
6 | 23 | 2023-12-09 00:21:54 | 0 | 23.57517483
6 | 23 | 2023-12-09 00:22:55 | 0 | 23.83741259
6 | 23 | 2023-12-09 00:23:56 | 0 | 23.57517483
6 | 23 | 2023-12-09 00:24:57 | 0 | 23.57517483
6 | 23 | 2023-12-09 00:25:57 | 0 | 23.44405594
6 | 23 | 2023-12-09 00:26:58 | 0 | 23.44405594
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
