odevincenti/Wet-DryPenguins/Pruebas Experimentales/Prueba Temperatura/Prueba 24C1/PRUEBA_TEMPERATURA_23_24C.xlsx

Sheet: Datos crudos
ID | Run | Timestamp | WetDry | Temperature | Datos válidos |  | Tiempo de establecimiento
23 | 24 | 2023-12-08 23:19:32 | 0 | 26.19755245 | Fila inicial | 14 | 0:12:28
23 | 24 | 2023-12-08 23:20:34 | 0 | 26.19755245 | Fila final | 35
23 | 24 | 2023-12-08 23:21:36 | 0 | 25.93531469
23 | 24 | 2023-12-08 23:22:39 | 0 | 25.67307692
23 | 24 | 2023-12-08 23:23:41 | 0 | 25.54195804
23 | 24 | 2023-12-08 23:24:44 | 0 | 24.49300699
23 | 24 | 2023-12-08 23:25:46 | 0 | 24.88636364
23 | 24 | 2023-12-08 23:26:48 | 0 | 25.1486014
23 | 24 | 2023-12-08 23:27:51 | 0 | 24.36188811
23 | 24 | 2023-12-08 23:28:53 | 0 | 24.09965035
23 | 24 | 2023-12-08 23:29:56 | 0 | 24.62412587
23 | 24 | 2023-12-08 23:30:58 | 0 | 24.88636364
23 | 24 | 2023-12-08 23:32:00 | 0 | 23.83741259
23 | 24 | 2023-12-08 23:33:03 | 0 | 23.70629371
23 | 24 | 2023-12-08 23:34:05 | 0 | 25.01748252
23 | 24 | 2023-12-08 23:35:08 | 0 | 25.01748252
23 | 24 | 2023-12-08 23:36:10 | 0 | 23.44405594
23 | 24 | 2023-12-08 23:37:13 | 0 | 23.83741259
23 | 24 | 2023-12-08 23:38:15 | 0 | 23.57517483
23 | 24 | 2023-12-08 23:39:17 | 0 | 24.88636364
23 | 24 | 2023-12-08 23:40:20 | 0 | 23.57517483
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
