odevincenti/Wet-DryPenguins/Pruebas Experimentales/Prueba Temperatura/Prueba 24C1/PRUEBA_TEMPERATURA_6_24C.xlsx

Sheet: Datos crudos
ID | Run | Timestamp | WetDry | Temperature | Datos válidos |  | Tiempo de establecimiento
6 | 24 | 2023-12-08 23:17:42 | 0 | 25.54195804 | Fila inicial | 11 | 0:09:07
6 | 24 | 2023-12-08 23:18:42 | 0 | 25.27972028 | Fila final | 34
6 | 24 | 2023-12-08 23:19:43 | 0 | 25.1486014
6 | 24 | 2023-12-08 23:20:44 | 0 | 24.88636364
6 | 24 | 2023-12-08 23:21:45 | 0 | 24.62412587
6 | 24 | 2023-12-08 23:22:46 | 0 | 24.62412587
6 | 24 | 2023-12-08 23:23:47 | 0 | 24.36188811
6 | 24 | 2023-12-08 23:24:47 | 0 | 24.36188811
6 | 24 | 2023-12-08 23:25:48 | 0 | 24.49300699
6 | 24 | 2023-12-08 23:26:49 | 0 | 24.23076923
6 | 24 | 2023-12-08 23:27:50 | 0 | 24.36188811
6 | 24 | 2023-12-08 23:28:51 | 0 | 24.36188811
6 | 24 | 2023-12-08 23:29:52 | 0 | 24.09965035
6 | 24 | 2023-12-08 23:30:53 | 0 | 24.36188811
6 | 24 | 2023-12-08 23:31:53 | 0 | 24.49300699
6 | 24 | 2023-12-08 23:32:54 | 0 | 24.49300699
6 | 24 | 2023-12-08 23:33:55 | 0 | 24.09965035
6 | 24 | 2023-12-08 23:34:56 | 0 | 24.23076923
6 | 24 | 2023-12-08 23:35:57 | 0 | 24.23076923
6 | 24 | 2023-12-08 23:36:58 | 0 | 24.09965035
6 | 24 | 2023-12-08 23:37:58 | 0 | 24.23076923
6 | 24 | 2023-12-08 23:38:59 | 0 | 23.96853147
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
