odevincenti/Wet-DryPenguins/Pruebas Experimentales/Prueba Temperatura/Prueba 3C1/PRUEBA_TEMPERATURA_23_3C.xlsx

Sheet: Datos crudos
ID | Run | Timestamp | WetDry | Temperature | Datos válidos |  | Tiempo de establecimiento
23 | 3 | 2023-12-11 02:05:36 | 0 | 29.21328671 | Fila inicial | 22 | 0:20:40
23 | 3 | 2023-12-11 02:06:38 | 0 | 25.1486014 | Fila final | 38
23 | 3 | 2023-12-11 02:07:40 | 0 | 20.9527972
23 | 3 | 2023-12-11 02:08:42 | 0 | 19.51048951
23 | 3 | 2023-12-11 02:09:44 | 0 | 17.28146853
23 | 3 | 2023-12-11 02:10:46 | 0 | 15.97027972
23 | 3 | 2023-12-11 02:11:48 | 0 | 14.52797203
23 | 3 | 2023-12-11 02:12:50 | 0 | 13.87237762
23 | 3 | 2023-12-11 02:13:52 | 0 | 12.82342657
23 | 3 | 2023-12-11 02:14:54 | 0 | 12.43006993
23 | 3 | 2023-12-11 02:15:56 | 0 | 12.03671329
23 | 3 | 2023-12-11 02:16:58 | 0 | 11.38111888
23 | 3 | 2023-12-11 02:18:00 | 0 | 11.11888112
23 | 3 | 2023-12-11 02:19:02 | 0 | 10.20104895
23 | 3 | 2023-12-11 02:20:04 | 0 | 10.59440559
23 | 3 | 2023-12-11 02:21:06 | 0 | 9.545454545
23 | 3 | 2023-12-11 02:22:08 | 0 | 9.152097902
23 | 3 | 2023-12-11 02:23:10 | 0 | 10.33216783
23 | 3 | 2023-12-11 02:24:12 | 0 | 9.152097902
23 | 3 | 2023-12-11 02:25:14 | 0 | 10.06993007
23 | 3 | 2023-12-11 02:26:16 | 0 | 9.020979021
23 | 3 | 2023-12-11 02:27:18 | 0 | 8.758741259
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
