odevincenti/Wet-DryPenguins/Pruebas Experimentales/Prueba Temperatura/Prueba 3C1/PRUEBA_TEMPERATURA_6_3C.xlsx

Sheet: Datos crudos
ID | Run | Timestamp | WetDry | Temperature | Datos válidos |  | Tiempo de establecimiento
6 | 3 | 2023-12-11 02:05:15 | 0 | 30.13111888 | Fila inicial | 22 | 0:19:42
6 | 3 | 2023-12-11 02:06:14 | 0 | 25.27972028 | Fila final | 40
6 | 3 | 2023-12-11 02:07:13 | 0 | 22.13286713
6 | 3 | 2023-12-11 02:08:12 | 0 | 19.77272727
6 | 3 | 2023-12-11 02:09:11 | 0 | 17.80594406
6 | 3 | 2023-12-11 02:10:10 | 0 | 16.1013986
6 | 3 | 2023-12-11 02:11:09 | 0 | 14.79020979
6 | 3 | 2023-12-11 02:12:08 | 0 | 12.69230769
6 | 3 | 2023-12-11 02:13:07 | 0 | 11.90559441
6 | 3 | 2023-12-11 02:14:06 | 0 | 11.38111888
6 | 3 | 2023-12-11 02:15:06 | 0 | 10.85664336
6 | 3 | 2023-12-11 02:16:05 | 0 | 10.59440559
6 | 3 | 2023-12-11 02:17:04 | 0 | 10.06993007
6 | 3 | 2023-12-11 02:18:03 | 0 | 9.807692308
6 | 3 | 2023-12-11 02:19:02 | 0 | 9.807692308
6 | 3 | 2023-12-11 02:20:01 | 0 | 9.020979021
6 | 3 | 2023-12-11 02:21:00 | 0 | 9.414335664
6 | 3 | 2023-12-11 02:21:59 | 0 | 9.283216783
6 | 3 | 2023-12-11 02:22:58 | 0 | 9.283216783
6 | 3 | 2023-12-11 02:23:57 | 0 | 9.020979021
6 | 3 | 2023-12-11 02:24:57 | 0 | 8.88986014
6 | 3 | 2023-12-11 02:25:56 | 0 | 9.020979021
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
