odevincenti/Wet-DryPenguins/Pruebas Experimentales/Prueba Temperatura/Prueba 4C1/PRUEBA_TEMPERATURA_23_4C.xlsx

Sheet: Datos crudos
ID | Run | Timestamp | WetDry | Temperature | Datos válidos |  | Tiempo de establecimiento
23 | 4 | 2023-12-11 01:17:00 | 0 | 23.96853147 | Fila inicial | 29 | 0:27:56
23 | 4 | 2023-12-11 01:18:02 | 0 | 20.82167832 | Fila final | 32
23 | 4 | 2023-12-11 01:19:04 | 0 | 18.59265734
23 | 4 | 2023-12-11 01:20:06 | 0 | 17.80594406
23 | 4 | 2023-12-11 01:21:08 | 0 | 16.49475524
23 | 4 | 2023-12-11 01:22:10 | 0 | 15.83916084
23 | 4 | 2023-12-11 01:23:12 | 0 | 14.65909091
23 | 4 | 2023-12-11 01:24:14 | 0 | 14.13461538
23 | 4 | 2023-12-11 01:25:16 | 0 | 13.74125874
23 | 4 | 2023-12-11 01:26:18 | 0 | 13.08566434
23 | 4 | 2023-12-11 01:27:20 | 0 | 12.69230769
23 | 4 | 2023-12-11 01:28:22 | 0 | 12.56118881
23 | 4 | 2023-12-11 01:29:25 | 0 | 12.29895105
23 | 4 | 2023-12-11 01:30:27 | 0 | 12.03671329
23 | 4 | 2023-12-11 01:31:29 | 0 | 11.77447552
23 | 4 | 2023-12-11 01:32:31 | 0 | 11.51223776
23 | 4 | 2023-12-11 01:33:33 | 0 | 11.77447552
23 | 4 | 2023-12-11 01:34:35 | 0 | 11.51223776
23 | 4 | 2023-12-11 01:35:37 | 0 | 11.64335664
23 | 4 | 2023-12-11 01:36:39 | 0 | 11.25
23 | 4 | 2023-12-11 01:37:41 | 0 | 11.38111888
23 | 4 | 2023-12-11 01:38:43 | 0 | 11.11888112
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
