odevincenti/Wet-DryPenguins/Pruebas Experimentales/Prueba Temperatura/Prueba 4C1/PRUEBA_TEMPERATURA_6_4C.xlsx

Sheet: Datos crudos
ID | Run | Timestamp | WetDry | Temperature | Datos válidos |  | Tiempo de establecimiento
6 | 4 | 2023-12-11 01:16:32 | 0 | 26.19755245 | Fila inicial | 27 | 0:24:44
6 | 4 | 2023-12-11 01:17:31 | 0 | 22.3951049 | Fila final | 34
6 | 4 | 2023-12-11 01:18:30 | 0 | 19.51048951
6 | 4 | 2023-12-11 01:19:30 | 0 | 17.28146853
6 | 4 | 2023-12-11 01:20:29 | 0 | 15.4458042
6 | 4 | 2023-12-11 01:21:28 | 0 | 13.87237762
6 | 4 | 2023-12-11 01:22:28 | 0 | 12.95454545
6 | 4 | 2023-12-11 01:23:27 | 0 | 12.03671329
6 | 4 | 2023-12-11 01:24:27 | 0 | 11.90559441
6 | 4 | 2023-12-11 01:25:26 | 0 | 11.11888112
6 | 4 | 2023-12-11 01:26:25 | 0 | 10.59440559
6 | 4 | 2023-12-11 01:27:25 | 0 | 10.33216783
6 | 4 | 2023-12-11 01:28:24 | 0 | 10.06993007
6 | 4 | 2023-12-11 01:29:23 | 0 | 10.06993007
6 | 4 | 2023-12-11 01:30:23 | 0 | 10.06993007
6 | 4 | 2023-12-11 01:31:22 | 0 | 10.06993007
6 | 4 | 2023-12-11 01:32:22 | 0 | 9.283216783
6 | 4 | 2023-12-11 01:33:21 | 0 | 9.676573427
6 | 4 | 2023-12-11 01:34:20 | 0 | 9.414335664
6 | 4 | 2023-12-11 01:35:20 | 0 | 9.414335664
6 | 4 | 2023-12-11 01:36:19 | 0 | 9.283216783
6 | 4 | 2023-12-11 01:37:19 | 0 | 9.152097902
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
