odevincenti/Wet-DryPenguins/Documentación/Diagramas y Gráficos/Diagramas en bloque/9 - Plan de validación/9.4 Plan de Verificación y Validación.jpg

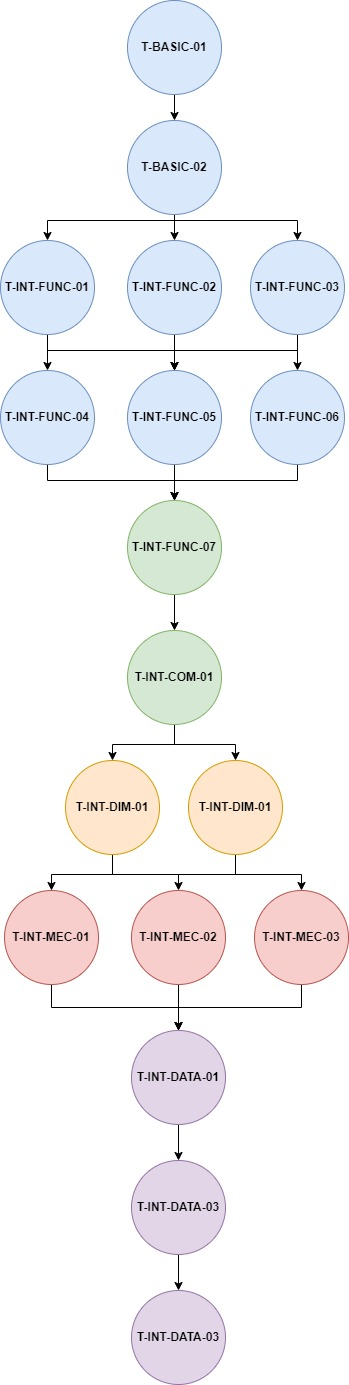
Documentación/Diagramas y Gráficos/Diagramas en bloque/9 - Plan de validación/9.4 Plan de Verificación y Validación.jpg
