odevincenti/Wet-DryPenguins/Documentación/Logger_high_measurement.jpeg

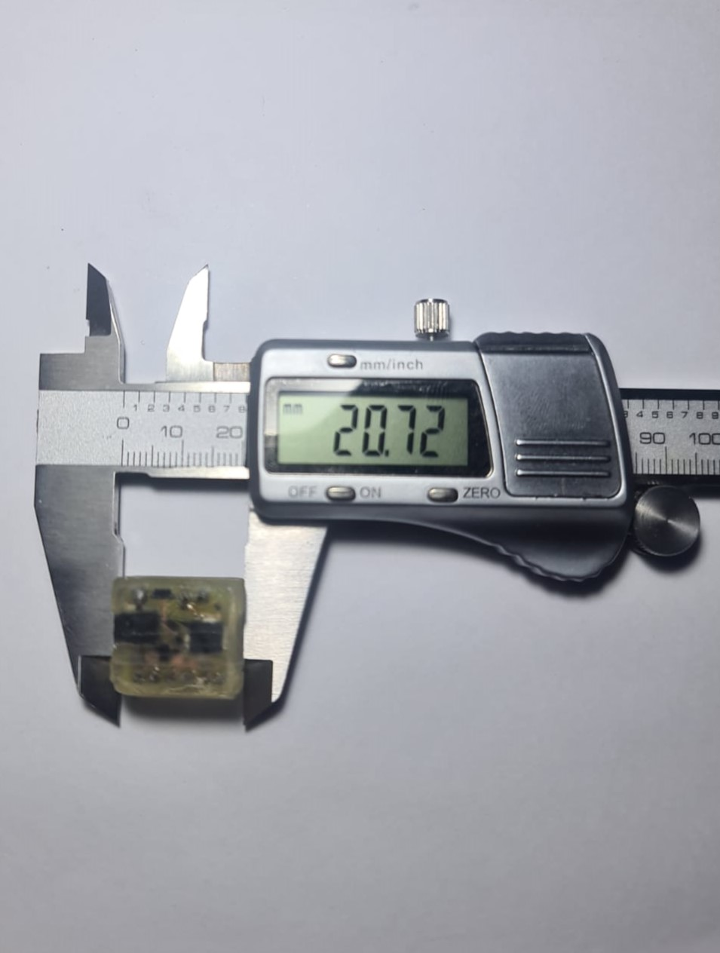
Documentación/Logger_high_measurement.jpeg
