odevincenti/Wet-DryPenguins/Documentación/Logger_thickness_measurement.jpeg

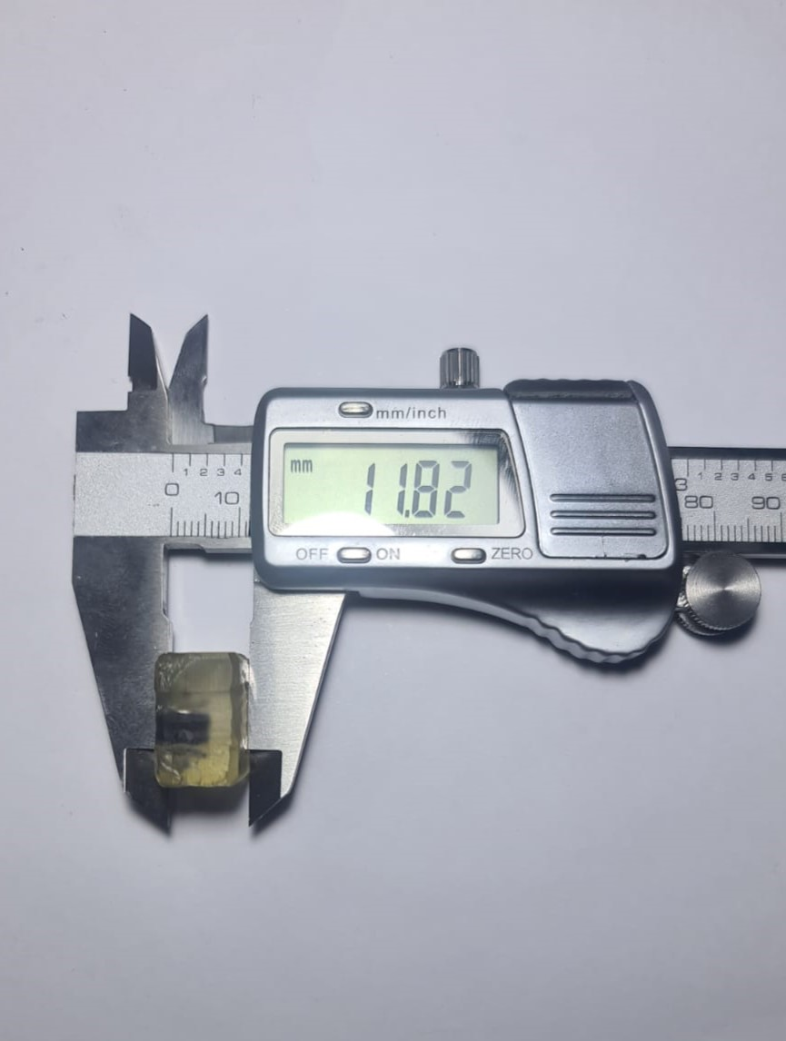
Documentación/Logger_thickness_measurement.jpeg
