odevincenti/Wet-DryPenguins/Documentación/Logger_with_measurement.jpeg

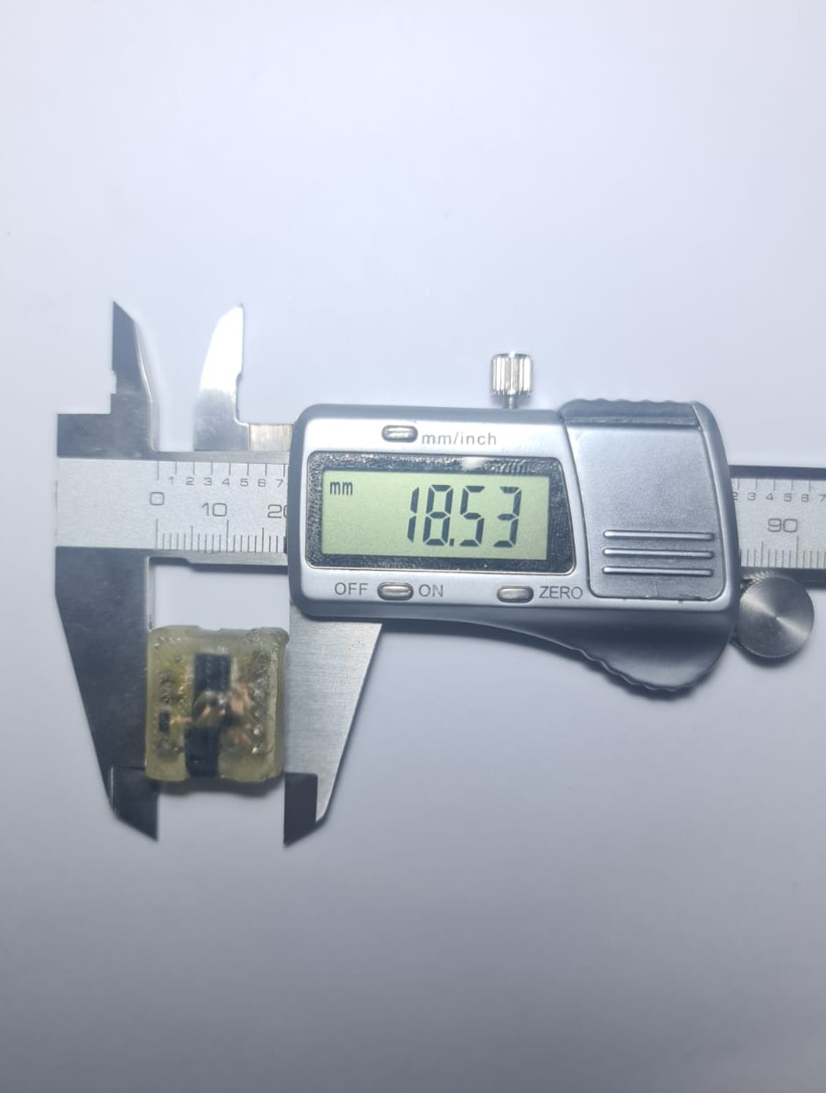
Documentación/Logger_with_measurement.jpeg
