odevincenti/Wet-DryPenguins/Pruebas Experimentales/Comparación de Osciladores internos/WhatsApp Image 2023-09-17 at 17.17.46.jpeg

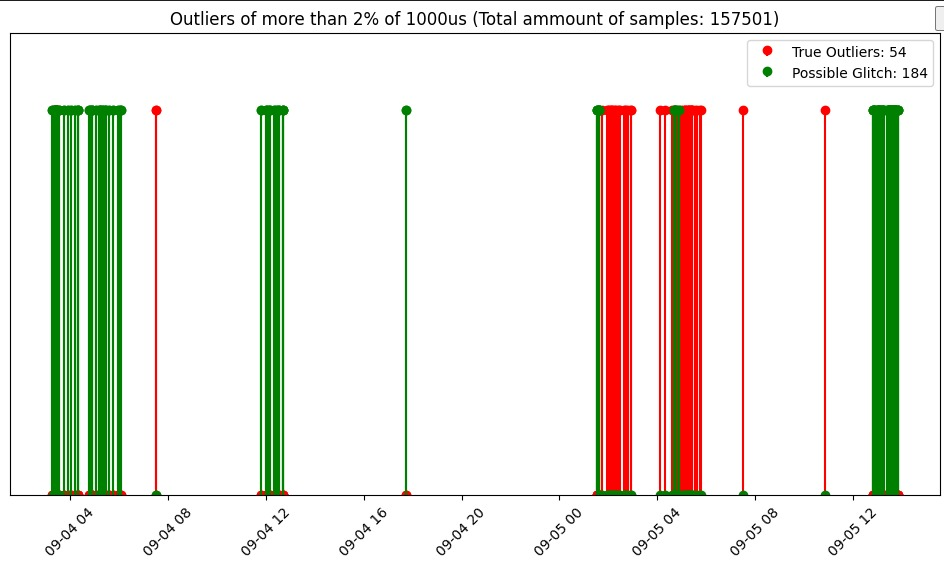
Pruebas Experimentales/Comparación de Osciladores internos/WhatsApp Image 2023-09-17 at 17.17.46.jpeg
