odevincenti/Wet-DryPenguins/Pruebas Experimentales/Medicion de tiempos/ADC/Screenshot 2023-12-07 201402.png

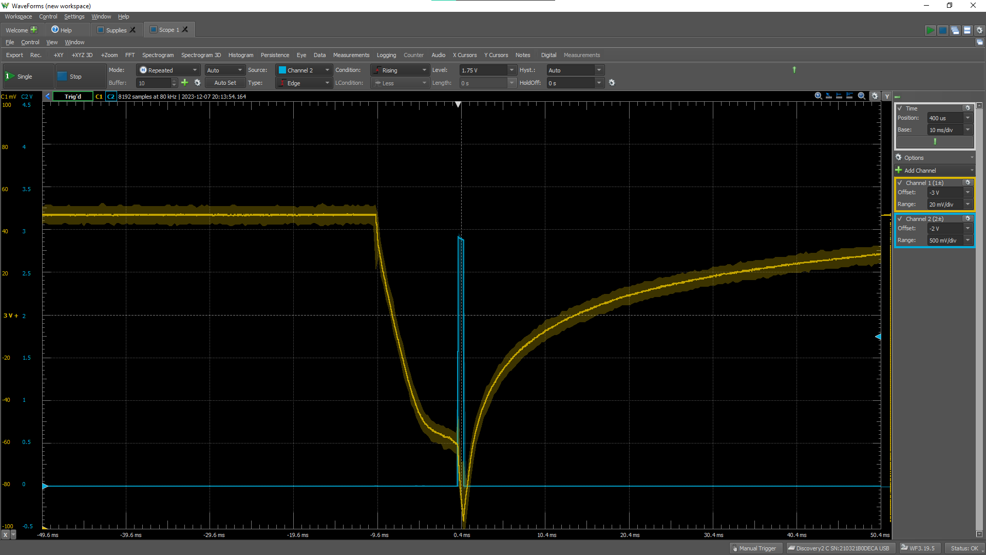
Pruebas Experimentales/Medicion de tiempos/ADC/Screenshot 2023-12-07 201402.png
