odevincenti/Wet-DryPenguins/Pruebas Experimentales/Medicion de tiempos/ADC/Screenshot 2023-12-07 201443.png

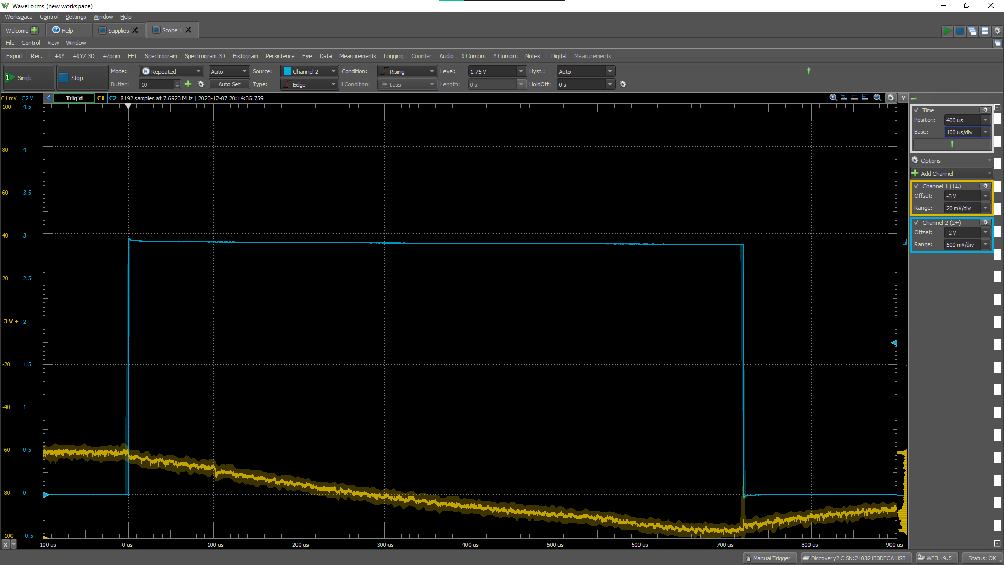
Pruebas Experimentales/Medicion de tiempos/ADC/Screenshot 2023-12-07 201443.png
