odevincenti/Wet-DryPenguins/Pruebas Experimentales/Medicion de tiempos/General/all.png

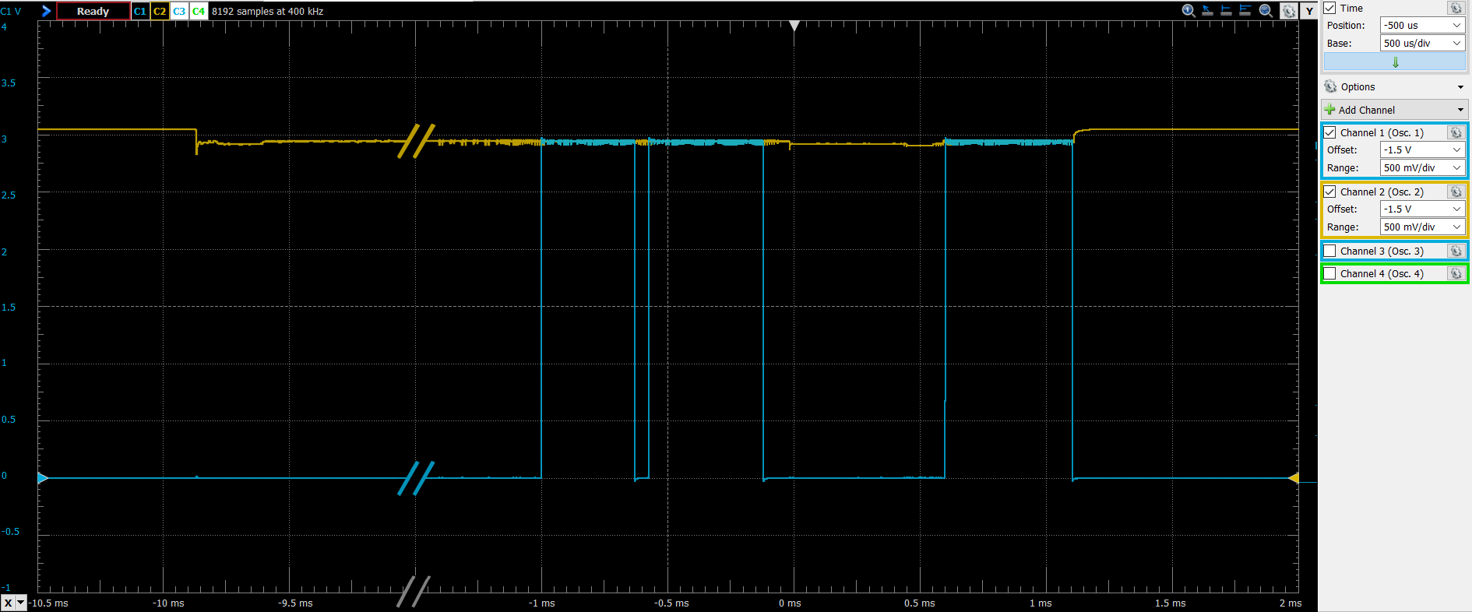
Pruebas Experimentales/Medicion de tiempos/General/all.png
