odevincenti/Wet-DryPenguins/Pruebas Experimentales/Medicion de tiempos/General/consumo_scope.png

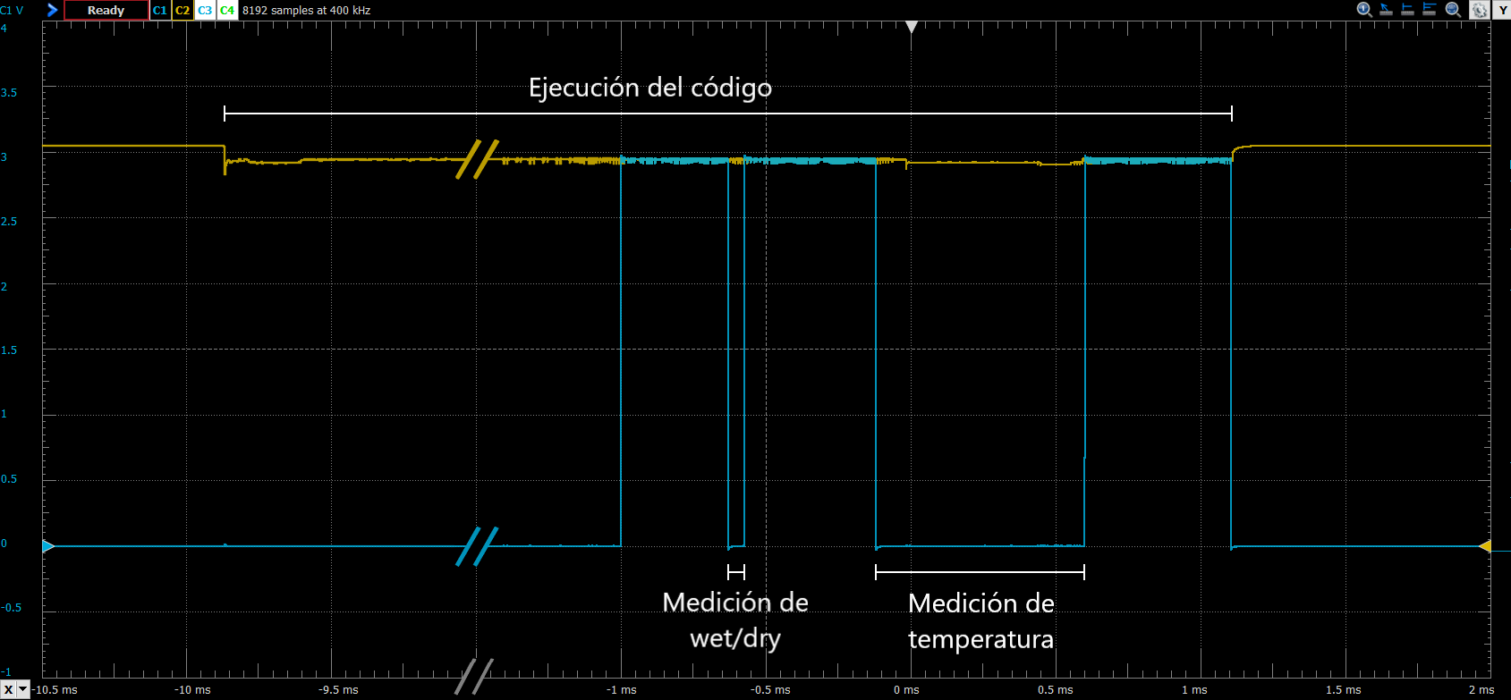
Pruebas Experimentales/Medicion de tiempos/General/consumo_scope.png
