odevincenti/Wet-DryPenguins/Pruebas Experimentales/Medicion de tiempos/General/full.png

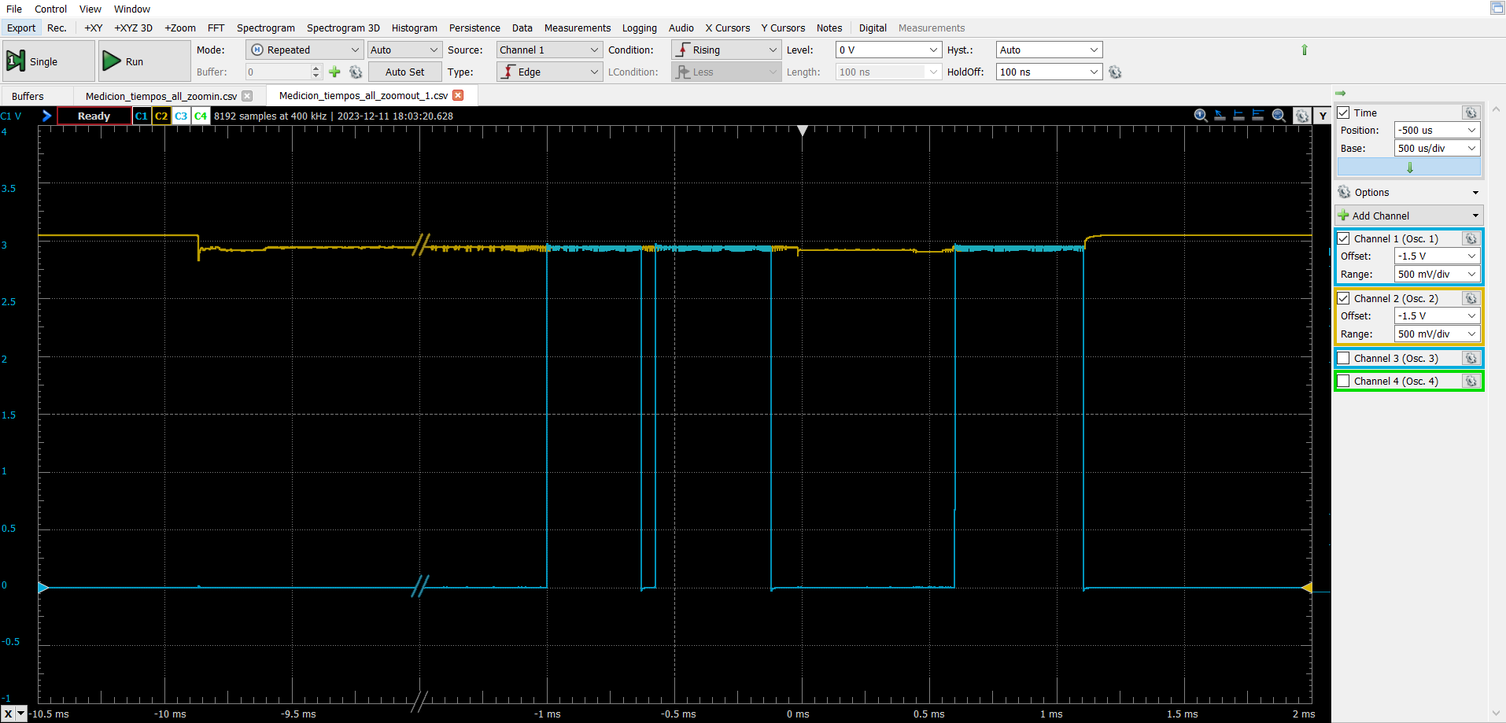
Pruebas Experimentales/Medicion de tiempos/General/full.png
