odevincenti/Wet-DryPenguins/Pruebas Experimentales/Medicion de tiempos/General/Screenshot 2023-12-10 054708.png

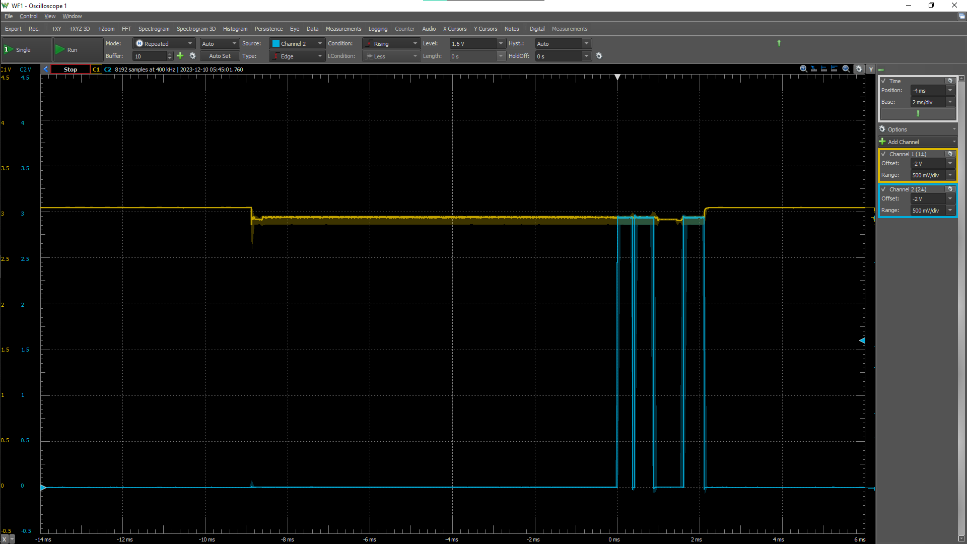
Pruebas Experimentales/Medicion de tiempos/General/Screenshot 2023-12-10 054708.png
