odevincenti/Wet-DryPenguins/Pruebas Experimentales/Medicion de tiempos/General/Screenshot 2023-12-10 055049.png

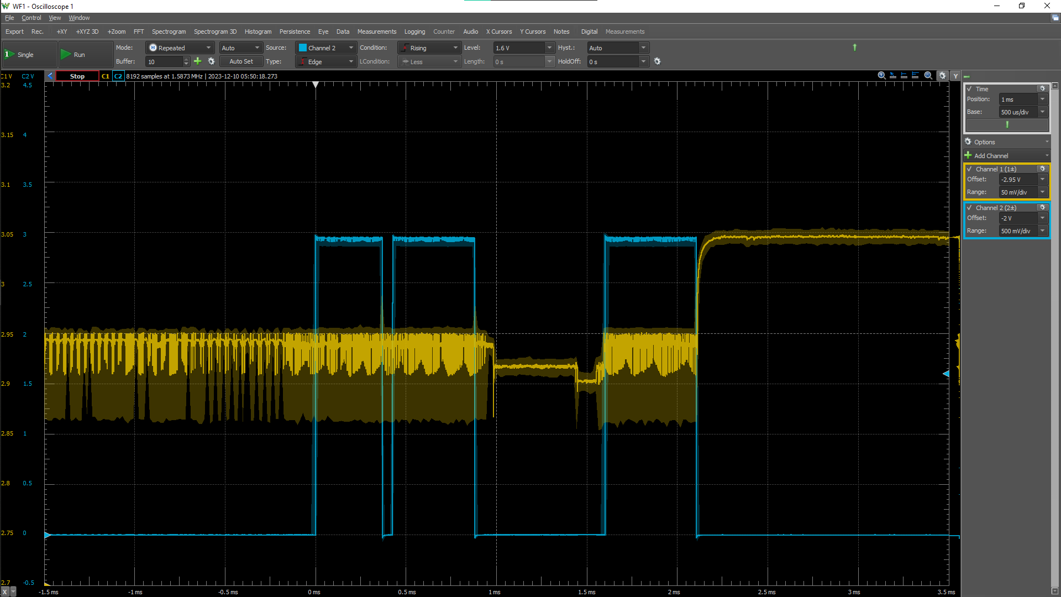
Pruebas Experimentales/Medicion de tiempos/General/Screenshot 2023-12-10 055049.png
