odevincenti/Wet-DryPenguins/Pruebas Experimentales/Medicion de tiempos/General/zoomin.png

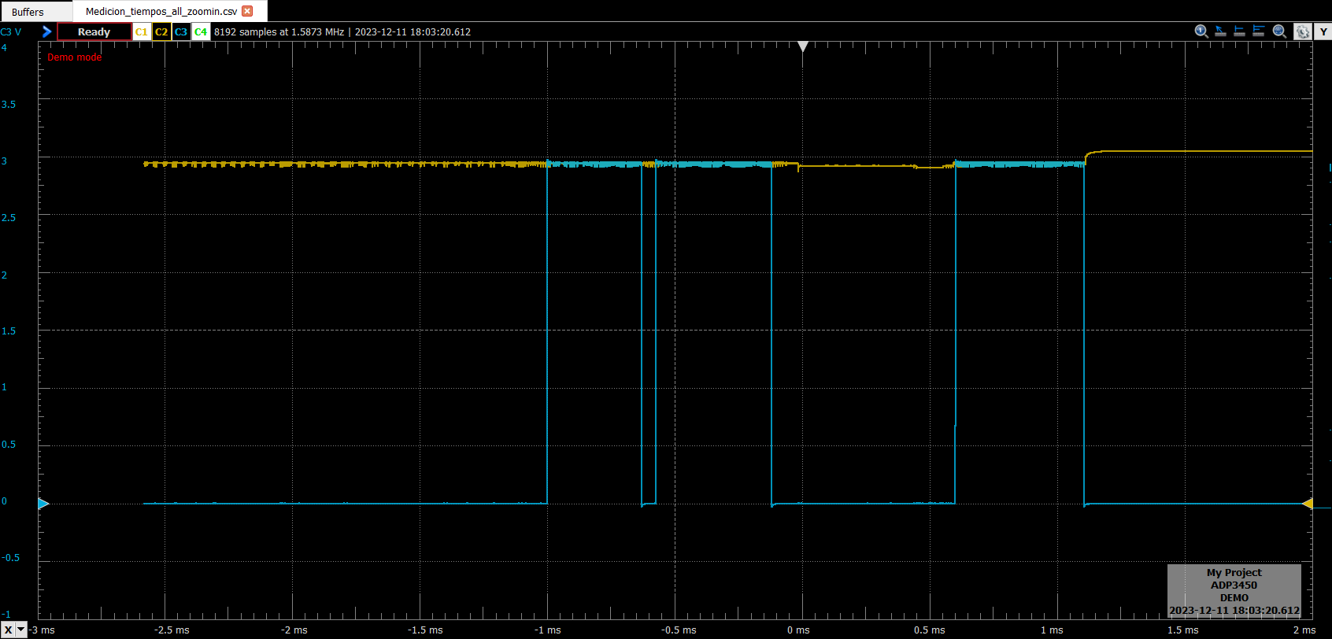
Pruebas Experimentales/Medicion de tiempos/General/zoomin.png
