odevincenti/Wet-DryPenguins/Pruebas Experimentales/Medicion de tiempos/General/zoomout.png

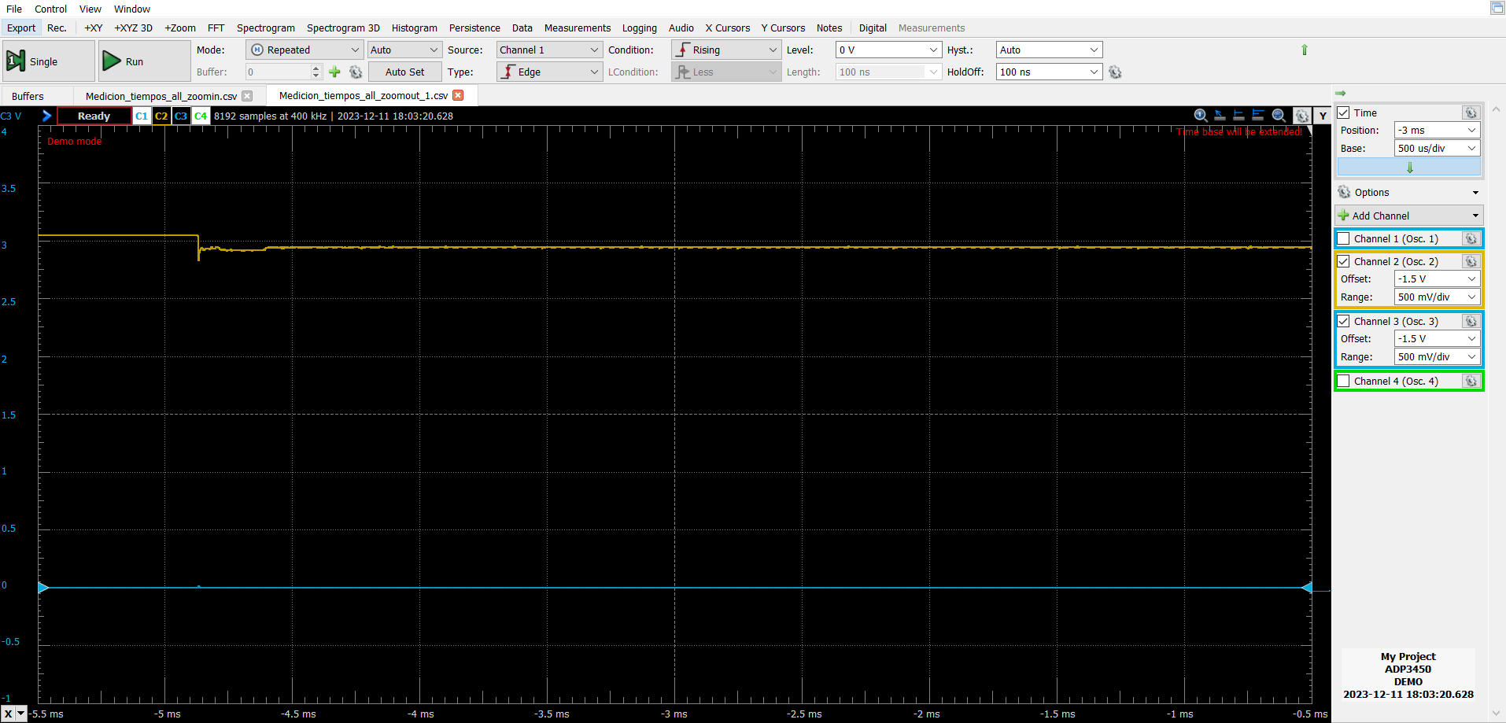
Pruebas Experimentales/Medicion de tiempos/General/zoomout.png
