odevincenti/Wet-DryPenguins/Pruebas Experimentales/Medicion de tiempos/Prueba de Resistencia/Grafico base + Segmentos.png

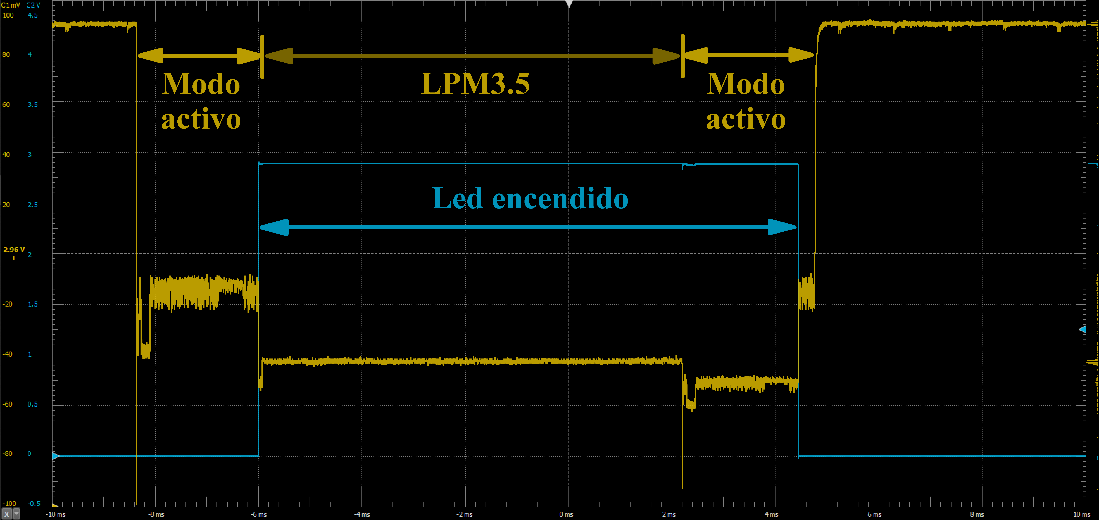
Pruebas Experimentales/Medicion de tiempos/Prueba de Resistencia/Grafico base + Segmentos.png
