odevincenti/Wet-DryPenguins/Pruebas Experimentales/Medicion de tiempos/Prueba de Resistencia/Grafico base.png

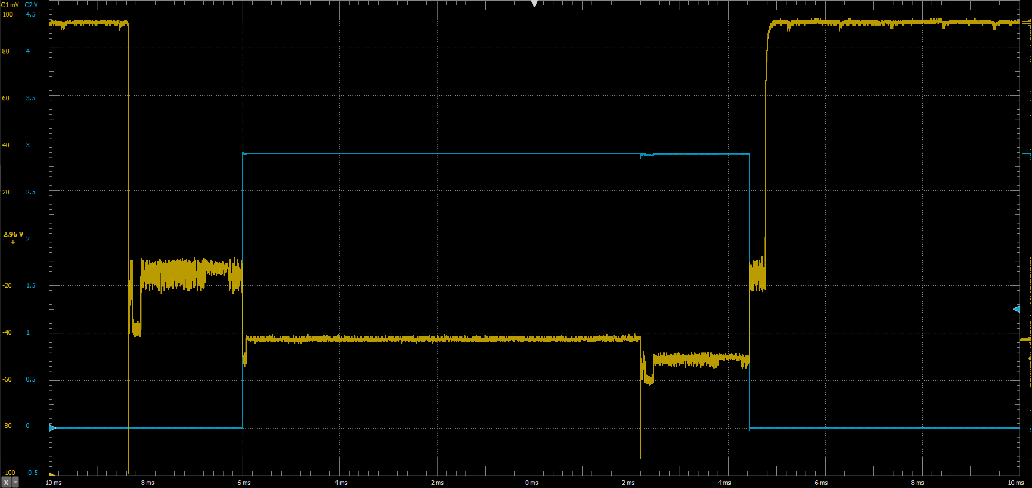
Pruebas Experimentales/Medicion de tiempos/Prueba de Resistencia/Grafico base.png
