odevincenti/Wet-DryPenguins/Pruebas Experimentales/Medición de conductividad/Circuito de ensayo preliminar.jpeg

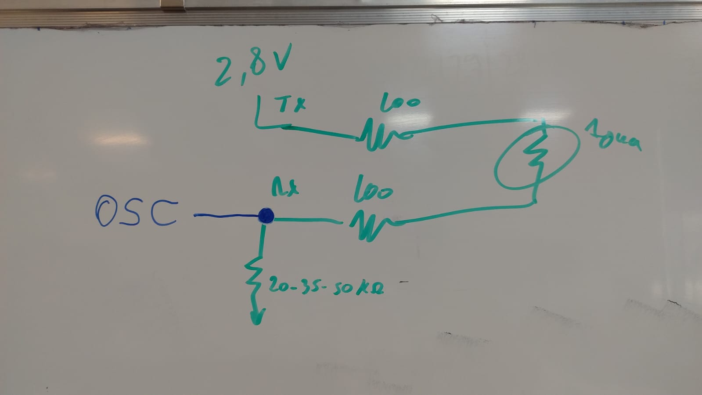
Pruebas Experimentales/Medición de conductividad/Circuito de ensayo preliminar.jpeg
