odevincenti/Wet-DryPenguins/Pruebas Experimentales/Medición de conductividad/Ensayo 2.8V.jpeg

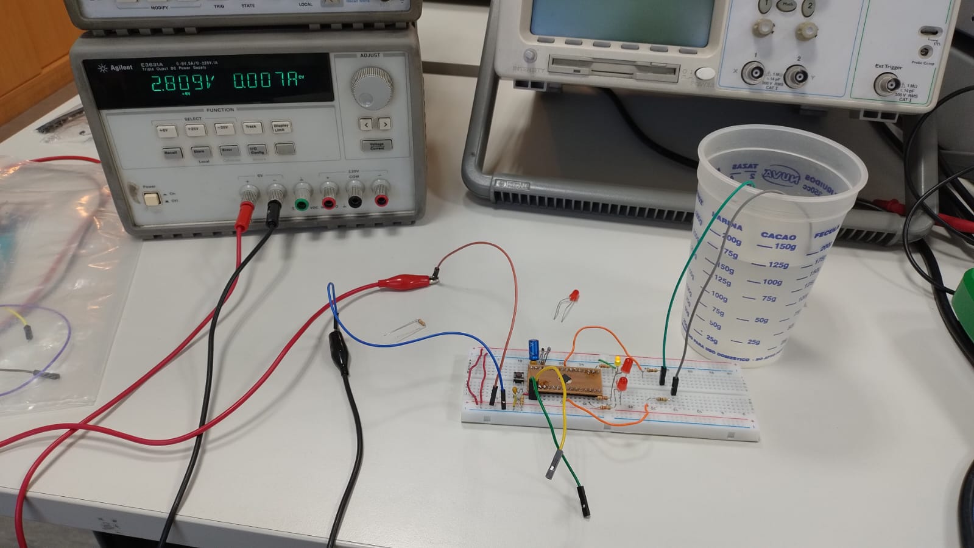
Pruebas Experimentales/Medición de conductividad/Ensayo 2.8V.jpeg
