odevincenti/Wet-DryPenguins/Pruebas Experimentales/Medición de conductividad/Ensayo 2V.jpeg

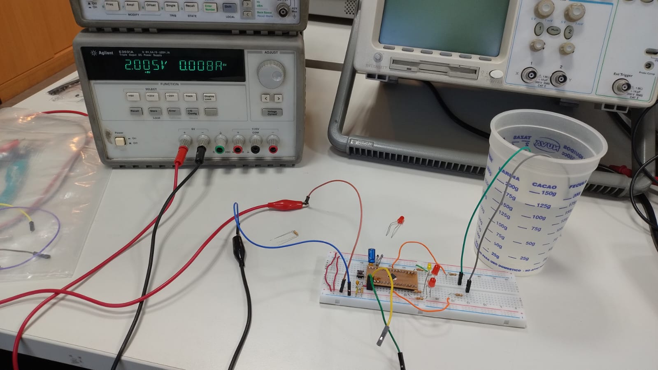
Pruebas Experimentales/Medición de conductividad/Ensayo 2V.jpeg
