odevincenti/Wet-DryPenguins/Pruebas Experimentales/Medición de conductividad/Ensayo preliminar AGUA 2V.jpeg

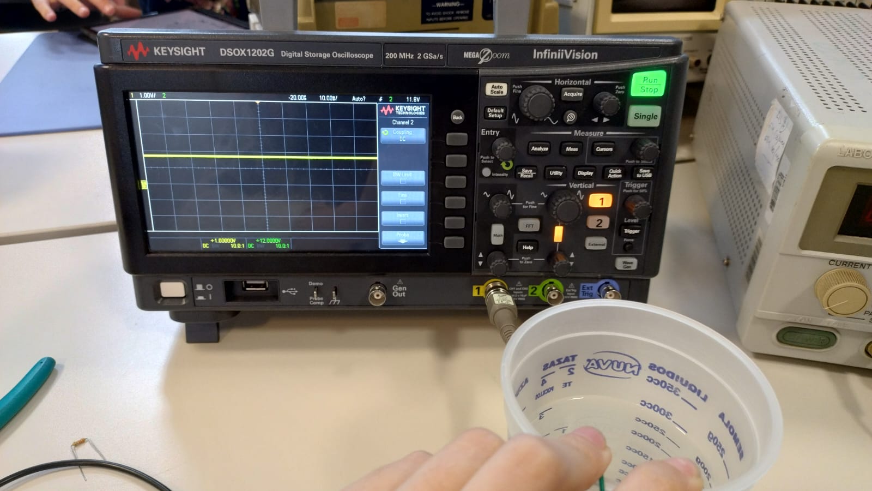
Pruebas Experimentales/Medición de conductividad/Ensayo preliminar AGUA 2V.jpeg
