odevincenti/Wet-DryPenguins/Pruebas Experimentales/Medición de conductividad/Ensayo preliminar AIRE 0V.jpeg

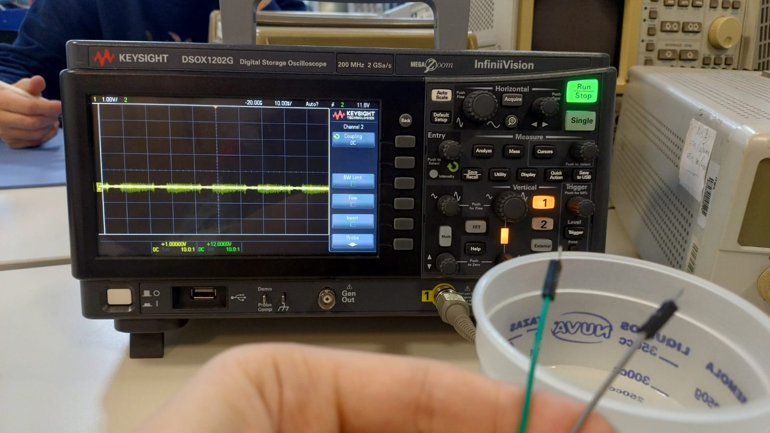
Pruebas Experimentales/Medición de conductividad/Ensayo preliminar AIRE 0V.jpeg
