odevincenti/Wet-DryPenguins/Pruebas Experimentales/Medición de conductividad/Mesa de ensayo preliminar.jpeg

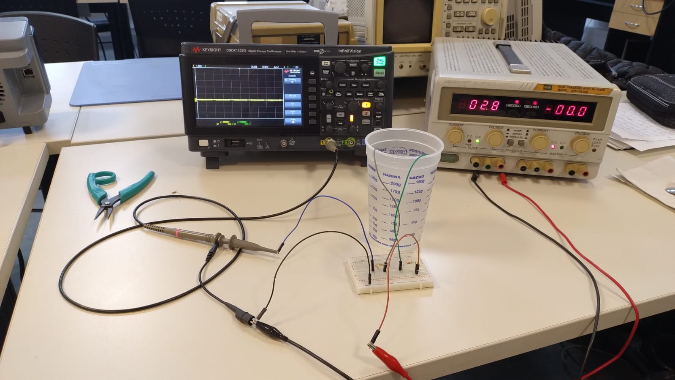
Pruebas Experimentales/Medición de conductividad/Mesa de ensayo preliminar.jpeg
