odevincenti/Wet-DryPenguins/Pruebas Experimentales/Medición de Consumo/Pruebas 07-12/consumo_ledon - copia.jpeg

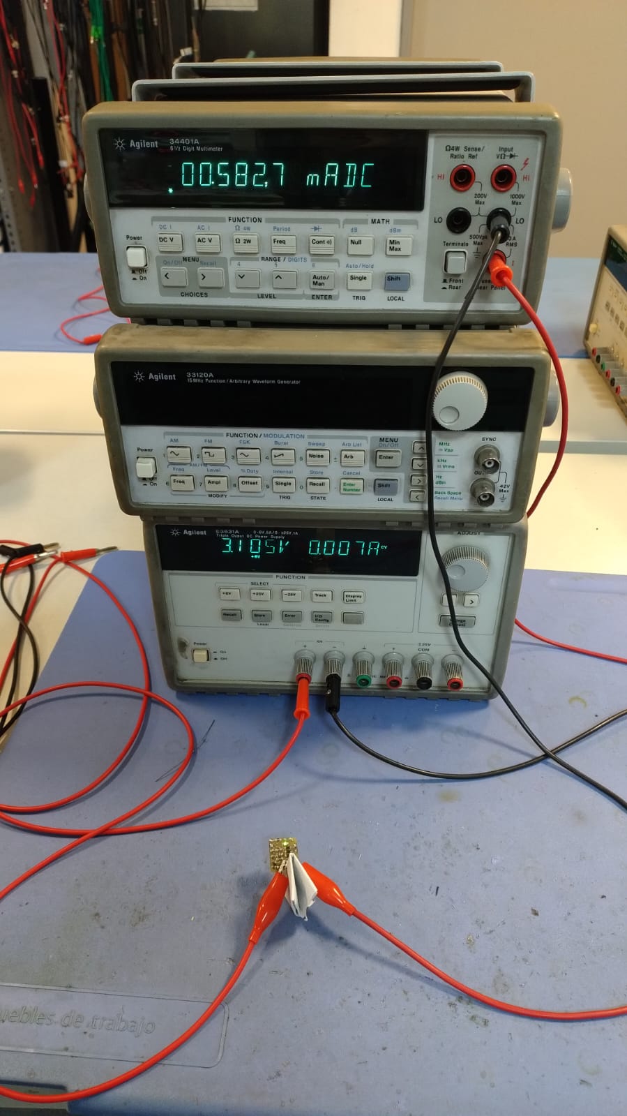
Pruebas Experimentales/Medición de Consumo/Pruebas 07-12/consumo_ledon - copia.jpeg
