odevincenti/Wet-DryPenguins/Pruebas Experimentales/Medición de Consumo/Pruebas 07-12/consumo_osc.jpeg

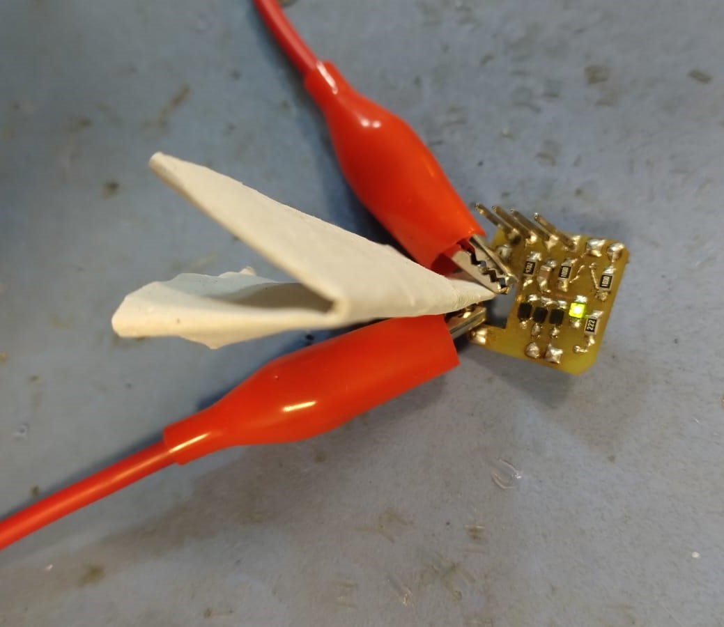
Pruebas Experimentales/Medición de Consumo/Pruebas 07-12/consumo_osc.jpeg
