odevincenti/Wet-DryPenguins/Pruebas Experimentales/Medición de Consumo/Pruebas 20-09/WhatsApp Image 2023-09-18 at 20.15.10.jpeg

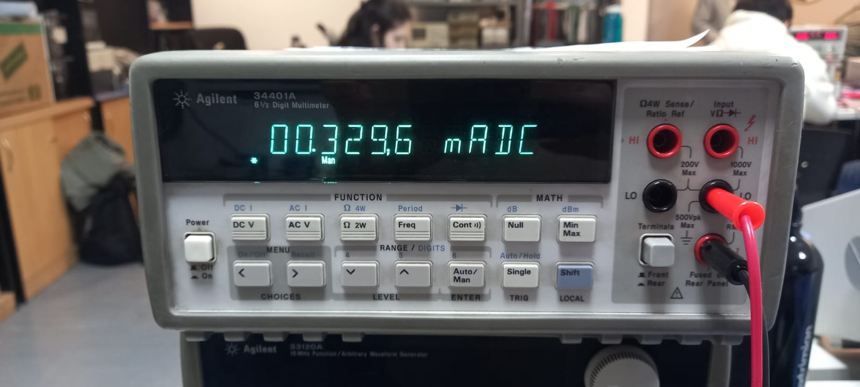
Pruebas Experimentales/Medición de Consumo/Pruebas 20-09/WhatsApp Image 2023-09-18 at 20.15.10.jpeg
