odevincenti/Wet-DryPenguins/Pruebas Experimentales/Placas prototipo/V2/WhatsApp Image 2023-09-19 at 20.37.05.jpeg

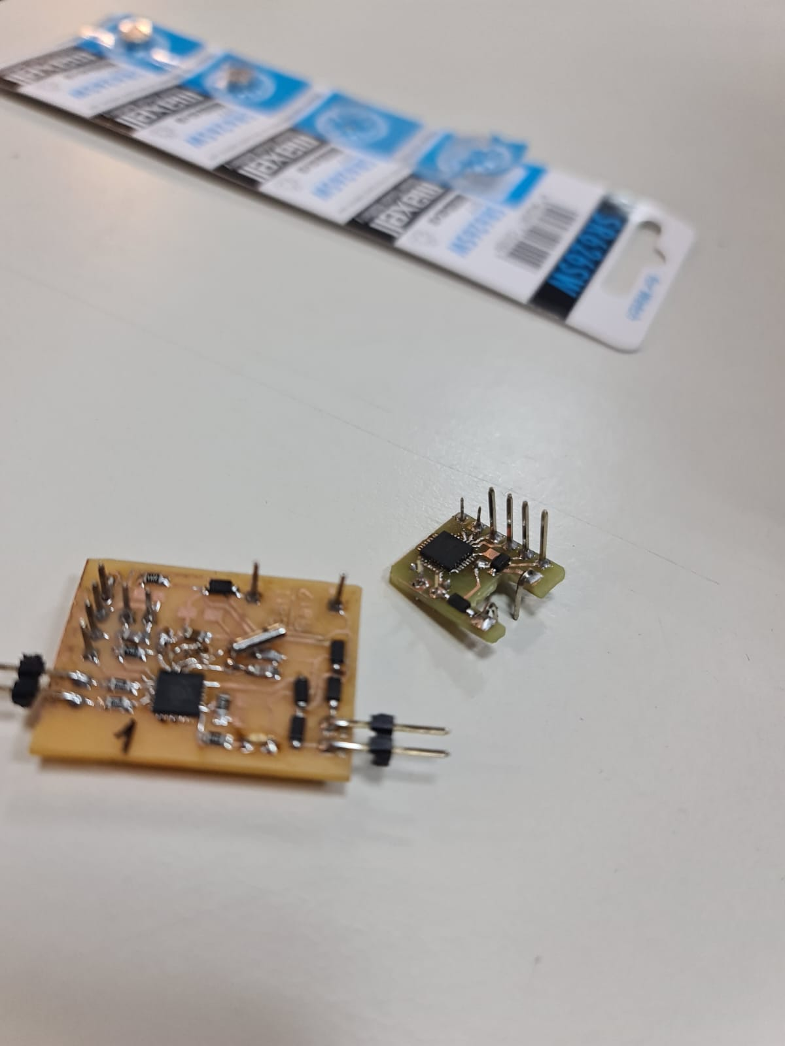
Pruebas Experimentales/Placas prototipo/V2/WhatsApp Image 2023-09-19 at 20.37.05.jpeg
