odevincenti/Wet-DryPenguins/Pruebas Experimentales/Placas prototipo/V2/WhatsApp Image 2023-09-20 at 13.44.29.jpeg

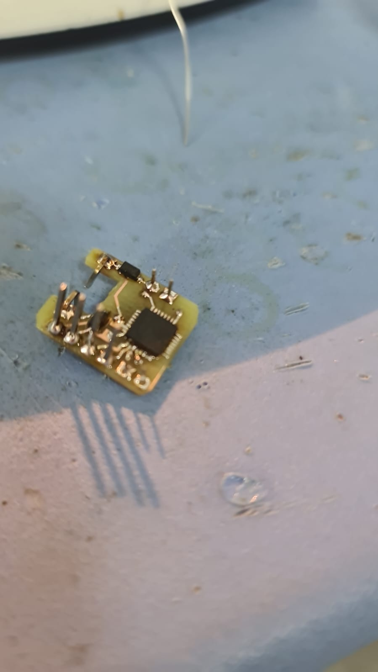
Pruebas Experimentales/Placas prototipo/V2/WhatsApp Image 2023-09-20 at 13.44.29.jpeg
