odevincenti/Wet-DryPenguins/Pruebas Experimentales/Poteo/V2/WhatsApp Image 2023-09-20 at 01.19.57.jpeg

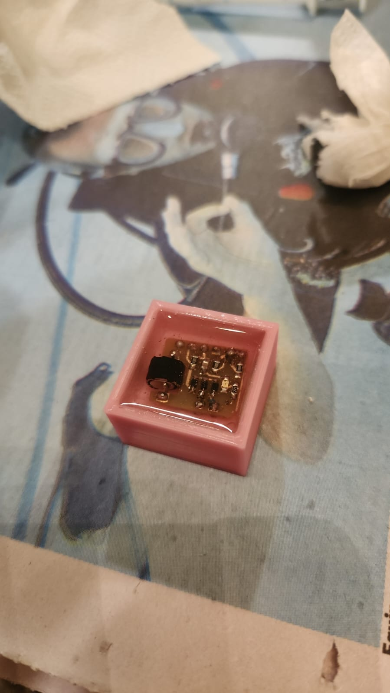
Pruebas Experimentales/Poteo/V2/WhatsApp Image 2023-09-20 at 01.19.57.jpeg
