odevincenti/Wet-DryPenguins/Pruebas Experimentales/Prueba de Presión/Prueba 1 13-09/WhatsApp Image 2023-09-13 at 11.03.48.jpeg

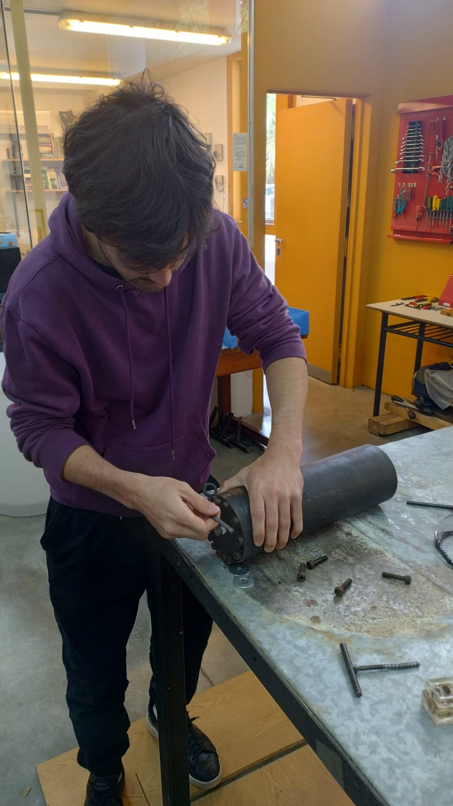
Pruebas Experimentales/Prueba de Presión/Prueba 1 13-09/WhatsApp Image 2023-09-13 at 11.03.48.jpeg
