odevincenti/Wet-DryPenguins/Pruebas Experimentales/Prueba Temperatura/Fotos/prueba_temp_diez.jpeg

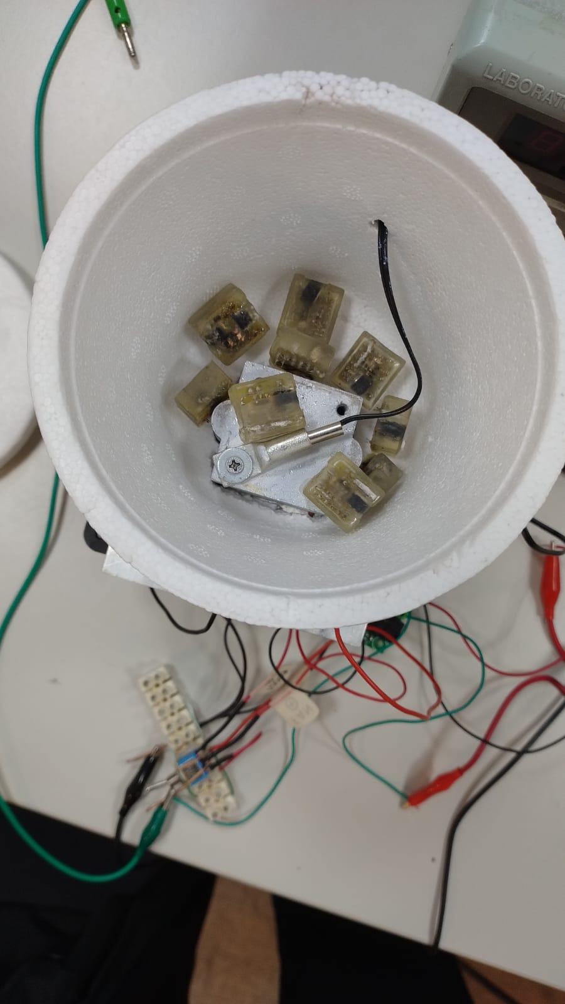
Pruebas Experimentales/Prueba Temperatura/Fotos/prueba_temp_diez.jpeg
