odevincenti/Wet-DryPenguins/Pruebas Experimentales/Prueba Temperatura/Fotos/prueba_temp_dos.jpeg

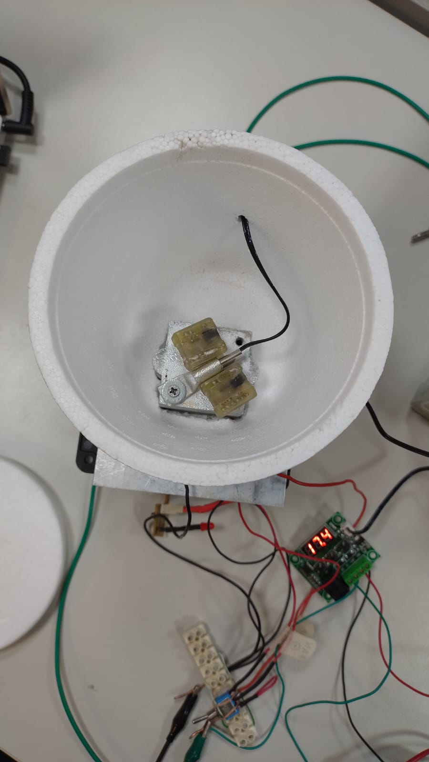
Pruebas Experimentales/Prueba Temperatura/Fotos/prueba_temp_dos.jpeg
