odevincenti/Wet-DryPenguins/Pruebas Experimentales/Prueba Temperatura/Fotos/prueba_temp_hclosed.jpeg

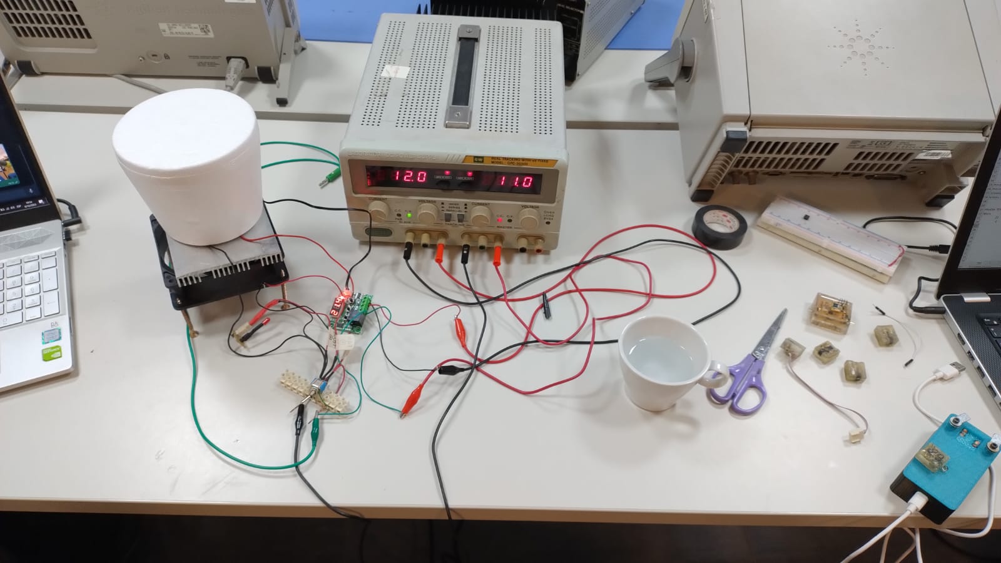
Pruebas Experimentales/Prueba Temperatura/Fotos/prueba_temp_hclosed.jpeg
