odevincenti/Wet-DryPenguins/Pruebas Experimentales/Prueba Temperatura/Fotos/prueba_temp_hopen - copia.jpeg

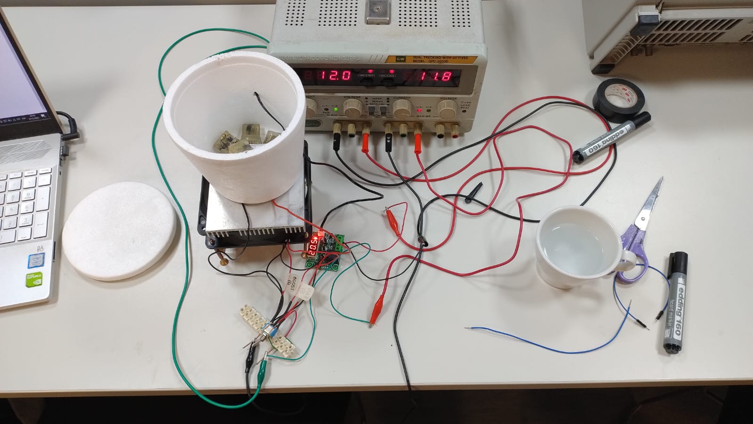
Pruebas Experimentales/Prueba Temperatura/Fotos/prueba_temp_hopen - copia.jpeg
