odevincenti/Wet-DryPenguins/Pruebas Experimentales/Prueba Temperatura/Fotos/prueba_temp_hopen.jpeg

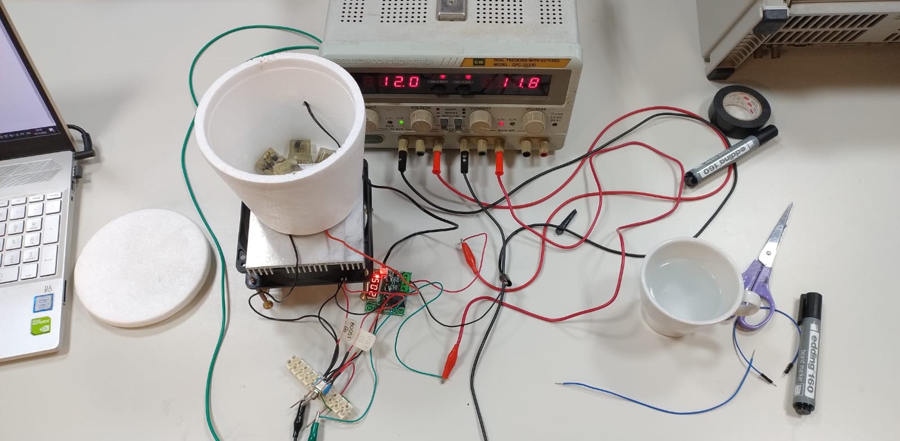
Pruebas Experimentales/Prueba Temperatura/Fotos/prueba_temp_hopen.jpeg
