odevincenti/Wet-DryPenguins/Pruebas Experimentales/Prueba Temperatura/Fotos/prueba_temp_vclosed.jpeg

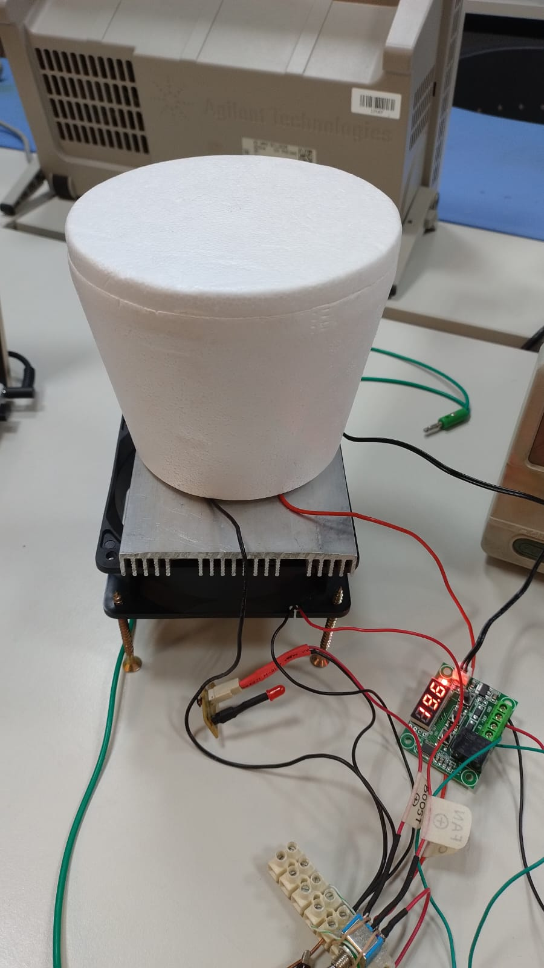
Pruebas Experimentales/Prueba Temperatura/Fotos/prueba_temp_vclosed.jpeg
