odevincenti/Wet-DryPenguins/Pruebas Experimentales/Prueba Temperatura/Fotos/prueba_temp_vopen.jpeg

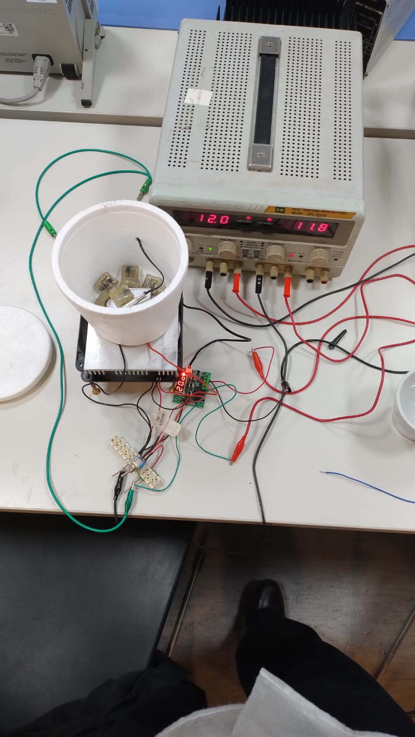
Pruebas Experimentales/Prueba Temperatura/Fotos/prueba_temp_vopen.jpeg
