odevincenti/Wet-DryPenguins/Pruebas Experimentales/Prueba Temperatura/Grafico_6_10C.png

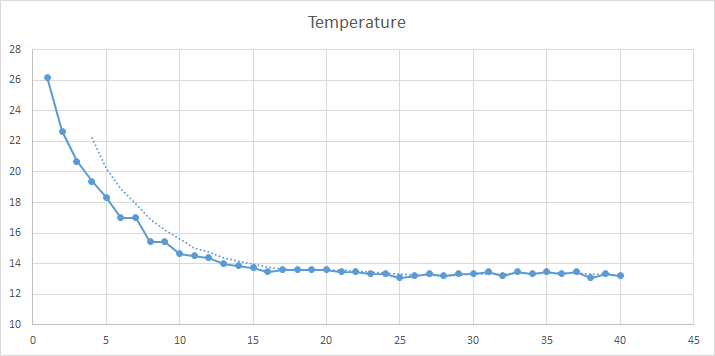
Pruebas Experimentales/Prueba Temperatura/Grafico_6_10C.png
