odevincenti/Wet-DryPenguins/Pruebas Experimentales/Prueba Temperatura/Grafico_Tmedida_vs_Treal.png

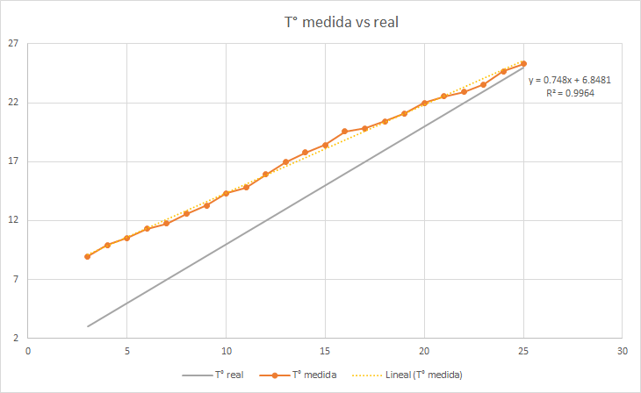
Pruebas Experimentales/Prueba Temperatura/Grafico_Tmedida_vs_Treal.png
