odevincenti/Wet-DryPenguins/Pruebas Experimentales/Prueba Temperatura/Prueba 3C1/PRUEBA_TEMPERATURA_23_T3C.png

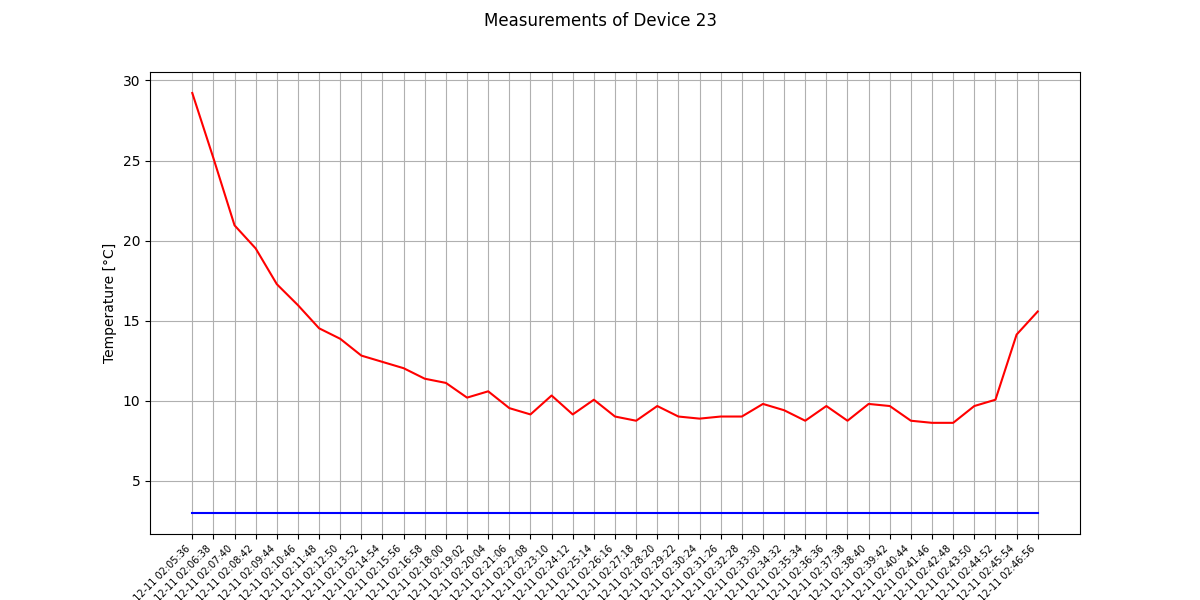
Pruebas Experimentales/Prueba Temperatura/Prueba 3C1/PRUEBA_TEMPERATURA_23_T3C.png
