odevincenti/Wet-DryPenguins/Pruebas Experimentales/Prueba Temperatura/Prueba 4C1/PRUEBA_TEMPERATURA_6_T4C.png

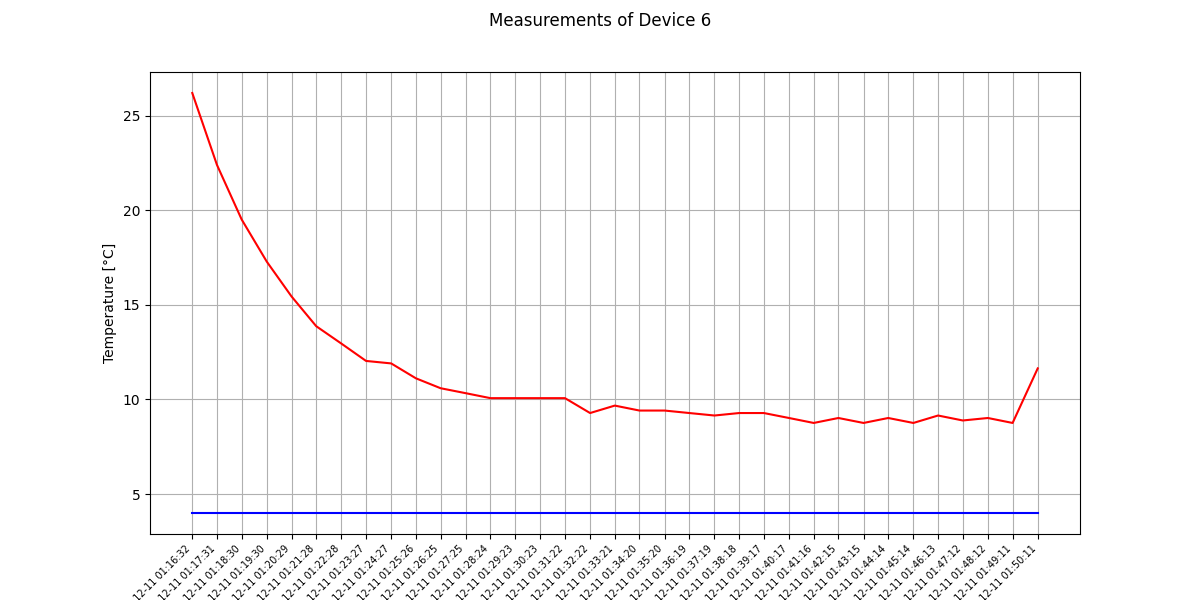
Pruebas Experimentales/Prueba Temperatura/Prueba 4C1/PRUEBA_TEMPERATURA_6_T4C.png
