odevincenti/Wet-DryPenguins/Pruebas Experimentales/Prueba Temperatura/Prueba 5C1/PRUEBA_TEMPERATURA_6_T5C.png

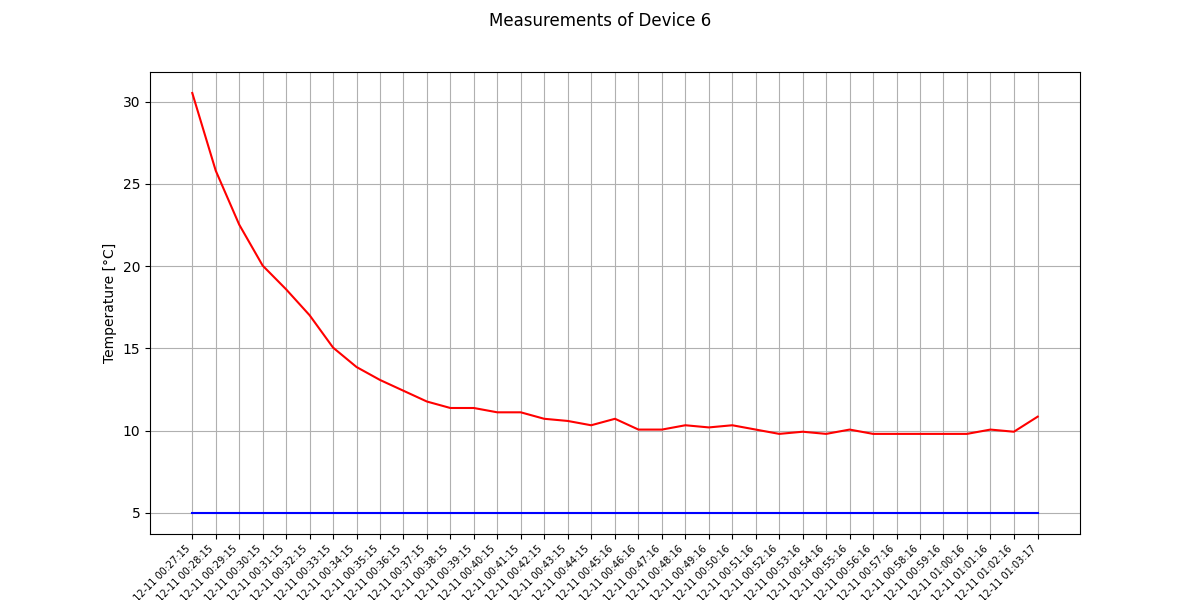
Pruebas Experimentales/Prueba Temperatura/Prueba 5C1/PRUEBA_TEMPERATURA_6_T5C.png
