odevincenti/Wet-DryPenguins/Pruebas Experimentales/Prueba Temperatura/Prueba 7C1/PRUEBA_TEMPERATURA_6_T7C.png

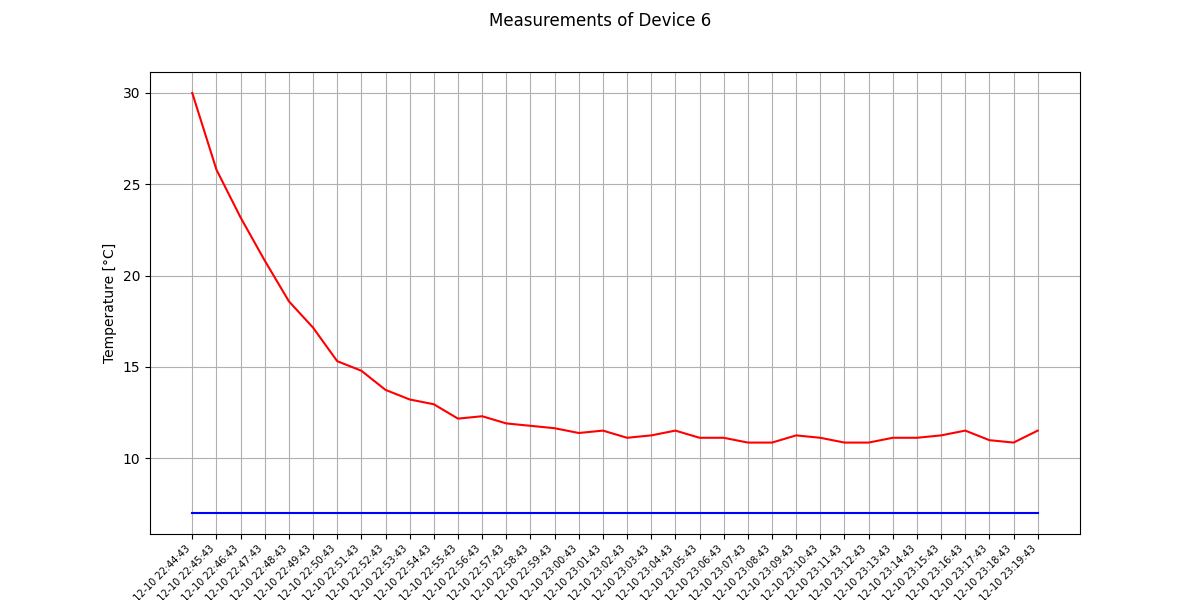
Pruebas Experimentales/Prueba Temperatura/Prueba 7C1/PRUEBA_TEMPERATURA_6_T7C.png
