odevincenti/Wet-DryPenguins/Pruebas Experimentales/Prueba Temperatura/Prueba 8C/PRUEBA_TEMPERATURA_23_T8C.png

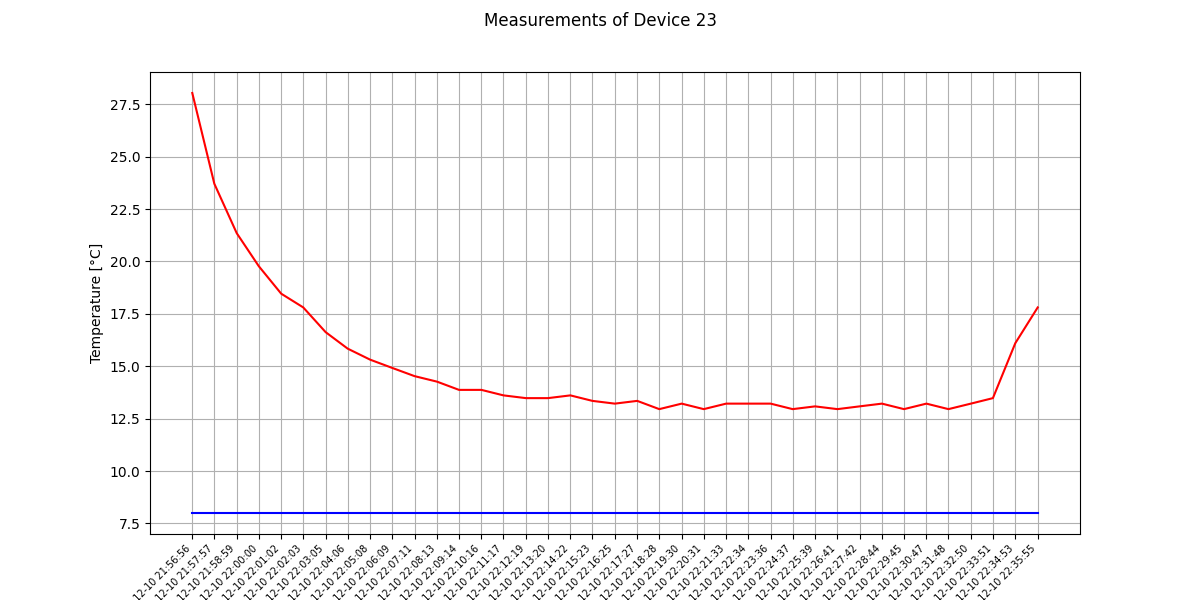
Pruebas Experimentales/Prueba Temperatura/Prueba 8C/PRUEBA_TEMPERATURA_23_T8C.png
