odevincenti/Wet-DryPenguins/Pruebas Experimentales/Prueba Temperatura/Prueba 9C2/PRUEBA_TEMPERATURA_23_T9C.png

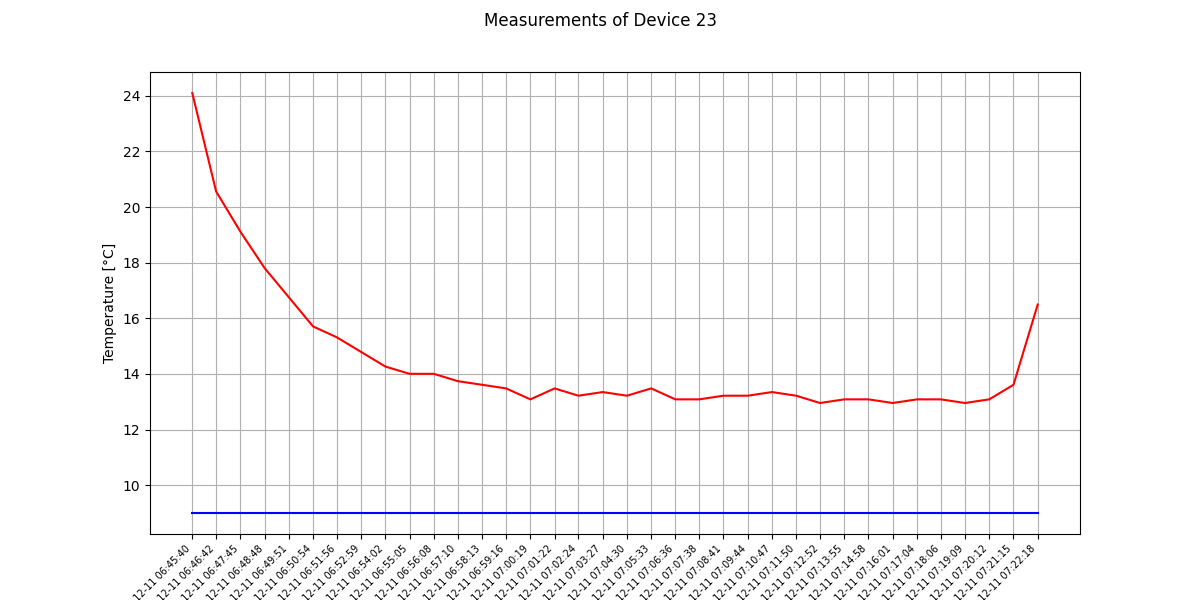
Pruebas Experimentales/Prueba Temperatura/Prueba 9C2/PRUEBA_TEMPERATURA_23_T9C.png
