odevincenti/Wet-DryPenguins/Pruebas Experimentales/Prueba Temperatura/Prueba 10C2/PRUEBA_TEMPERATURA_6_T10C.png

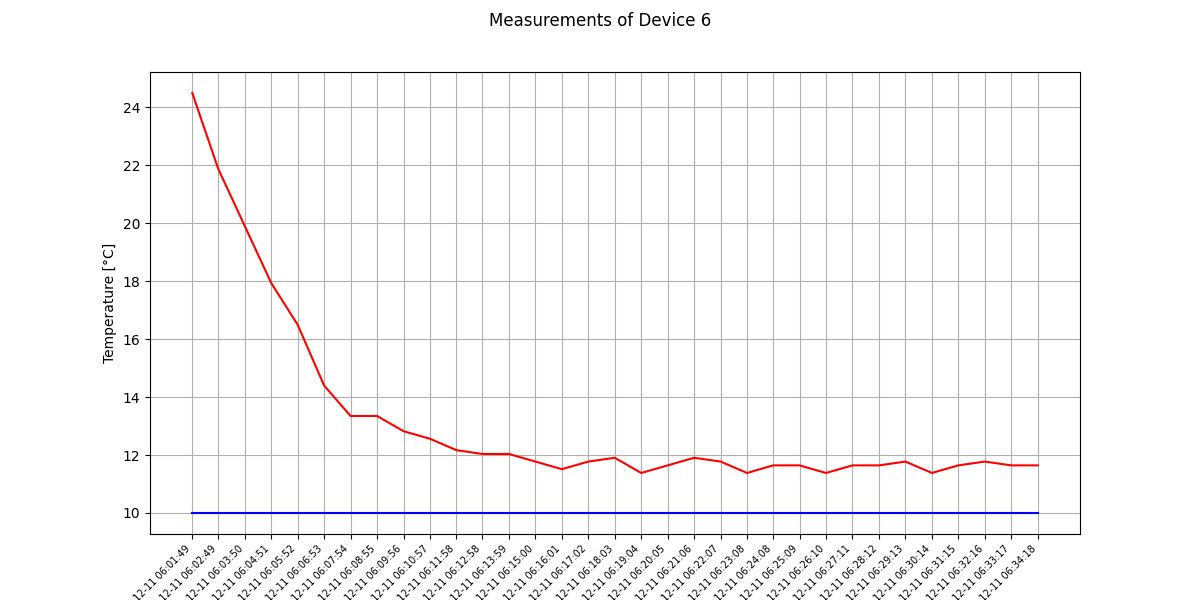
Pruebas Experimentales/Prueba Temperatura/Prueba 10C2/PRUEBA_TEMPERATURA_6_T10C.png
