odevincenti/Wet-DryPenguins/Pruebas Experimentales/Prueba Temperatura/Prueba 10C/Ex 23/PRUEBA_TEMPERATURA_23_T10C.png

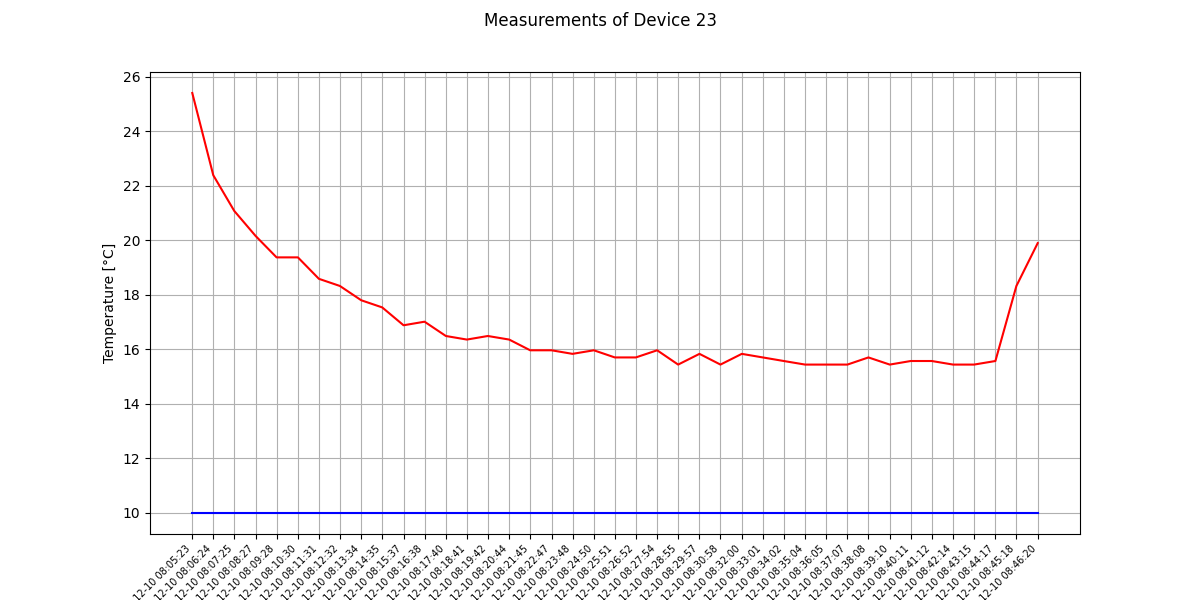
Pruebas Experimentales/Prueba Temperatura/Prueba 10C/Ex 23/PRUEBA_TEMPERATURA_23_T10C.png
