odevincenti/Wet-DryPenguins/Pruebas Experimentales/Prueba Temperatura/Prueba 11C2/PRUEBA_TEMPERATURA_23_T11C.png

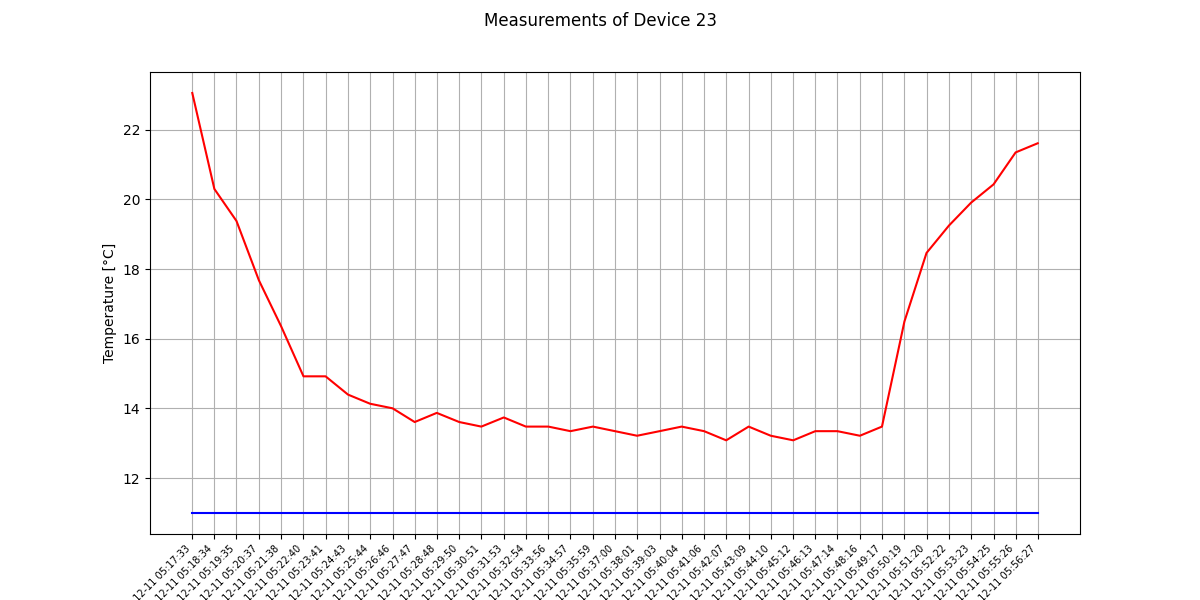
Pruebas Experimentales/Prueba Temperatura/Prueba 11C2/PRUEBA_TEMPERATURA_23_T11C.png
