odevincenti/Wet-DryPenguins/Pruebas Experimentales/Prueba Temperatura/Prueba 12C2/PRUEBA_TEMPERATURA_23_T12C.png

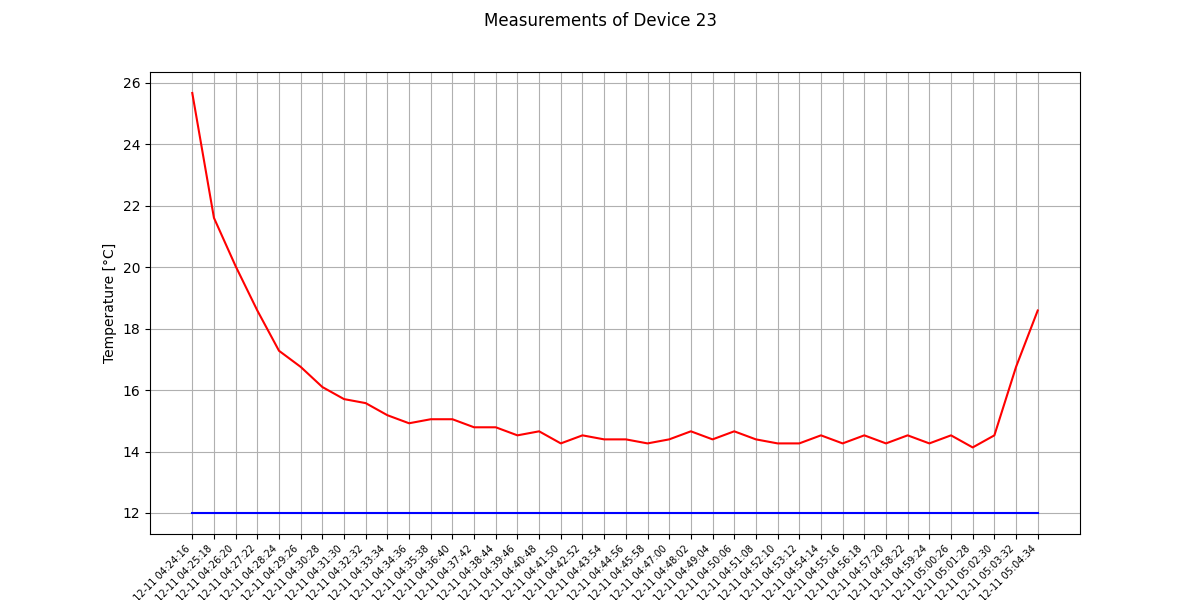
Pruebas Experimentales/Prueba Temperatura/Prueba 12C2/PRUEBA_TEMPERATURA_23_T12C.png
