odevincenti/Wet-DryPenguins/Pruebas Experimentales/Prueba Temperatura/Prueba 13C2/PRUEBA_TEMPERATURA_6_T13C.png

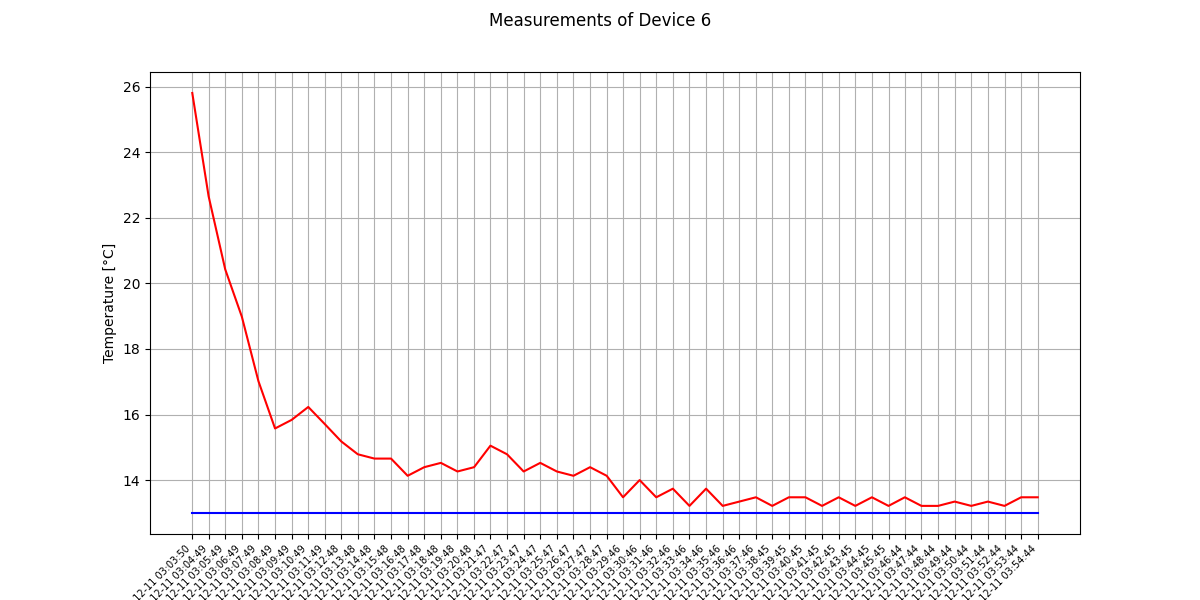
Pruebas Experimentales/Prueba Temperatura/Prueba 13C2/PRUEBA_TEMPERATURA_6_T13C.png
