odevincenti/Wet-DryPenguins/Pruebas Experimentales/Prueba Temperatura/Prueba 14C/PRUEBA_TEMPERATURA_23_T14C.png

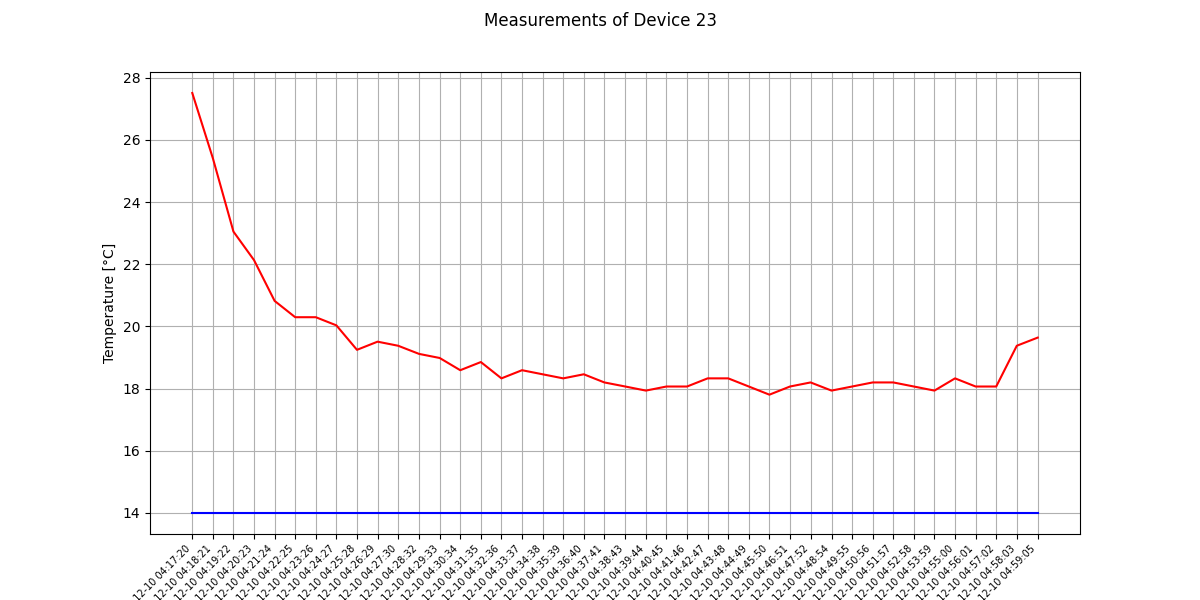
Pruebas Experimentales/Prueba Temperatura/Prueba 14C/PRUEBA_TEMPERATURA_23_T14C.png
