odevincenti/Wet-DryPenguins/Pruebas Experimentales/Prueba Temperatura/Prueba 15C2/PRUEBA_TEMPERATURA_6_T15C.png

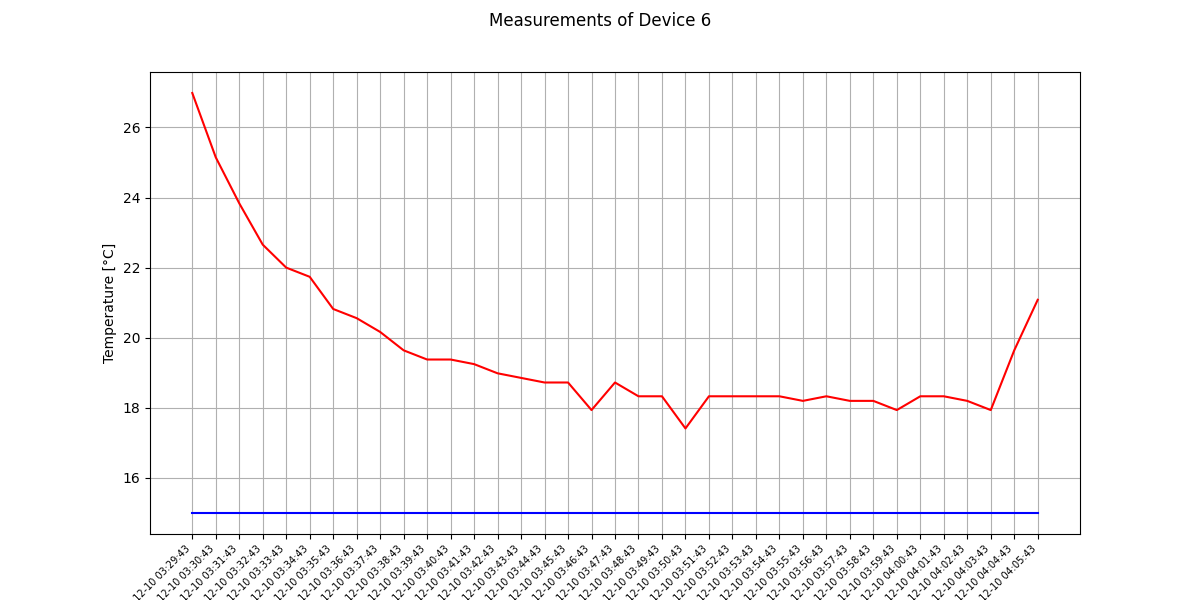
Pruebas Experimentales/Prueba Temperatura/Prueba 15C2/PRUEBA_TEMPERATURA_6_T15C.png
