odevincenti/Wet-DryPenguins/Pruebas Experimentales/Prueba Temperatura/Prueba 16C/PRUEBA_TEMPERATURA_6_T16C.png

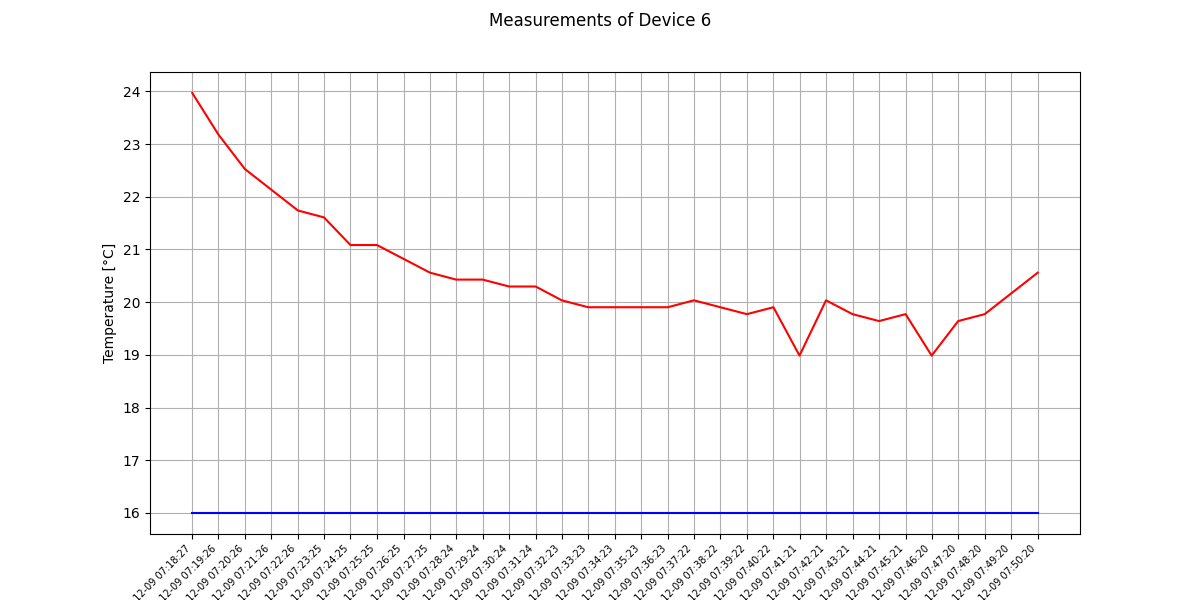
Pruebas Experimentales/Prueba Temperatura/Prueba 16C/PRUEBA_TEMPERATURA_6_T16C.png
