odevincenti/Wet-DryPenguins/Pruebas Experimentales/Prueba Temperatura/Prueba 17C2/PRUEBA_TEMPERATURA_6_T17C.png

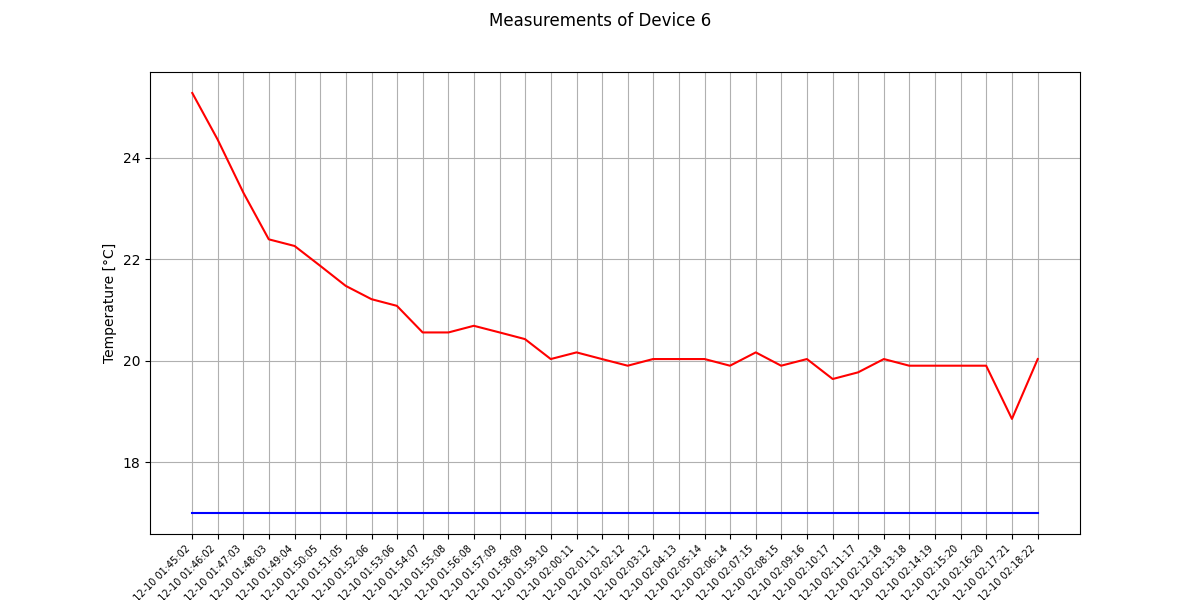
Pruebas Experimentales/Prueba Temperatura/Prueba 17C2/PRUEBA_TEMPERATURA_6_T17C.png
