odevincenti/Wet-DryPenguins/Pruebas Experimentales/Prueba Temperatura/Prueba 18C2/PRUEBA_TEMPERATURA_6_T18C.png

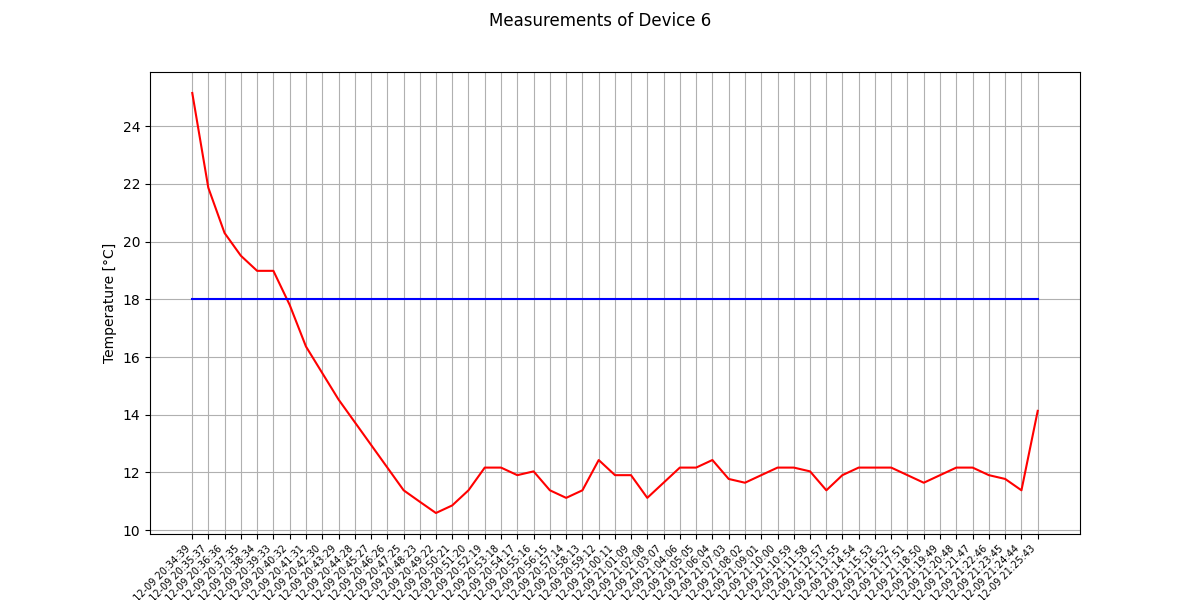
Pruebas Experimentales/Prueba Temperatura/Prueba 18C2/PRUEBA_TEMPERATURA_6_T18C.png
