odevincenti/Wet-DryPenguins/Pruebas Experimentales/Prueba Temperatura/Prueba 19C1/PRUEBA_TEMPERATURA_23_T19C.png

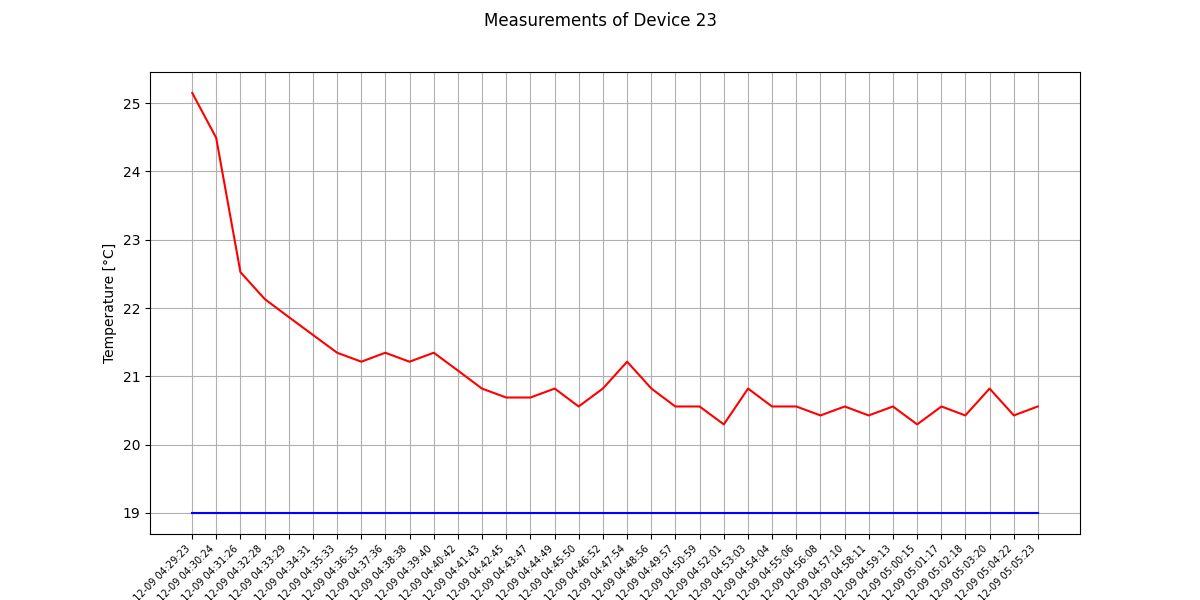
Pruebas Experimentales/Prueba Temperatura/Prueba 19C1/PRUEBA_TEMPERATURA_23_T19C.png
