odevincenti/Wet-DryPenguins/Pruebas Experimentales/Prueba Temperatura/Prueba 20C1/PRUEBA_TEMPERATURA_6_T20C.png

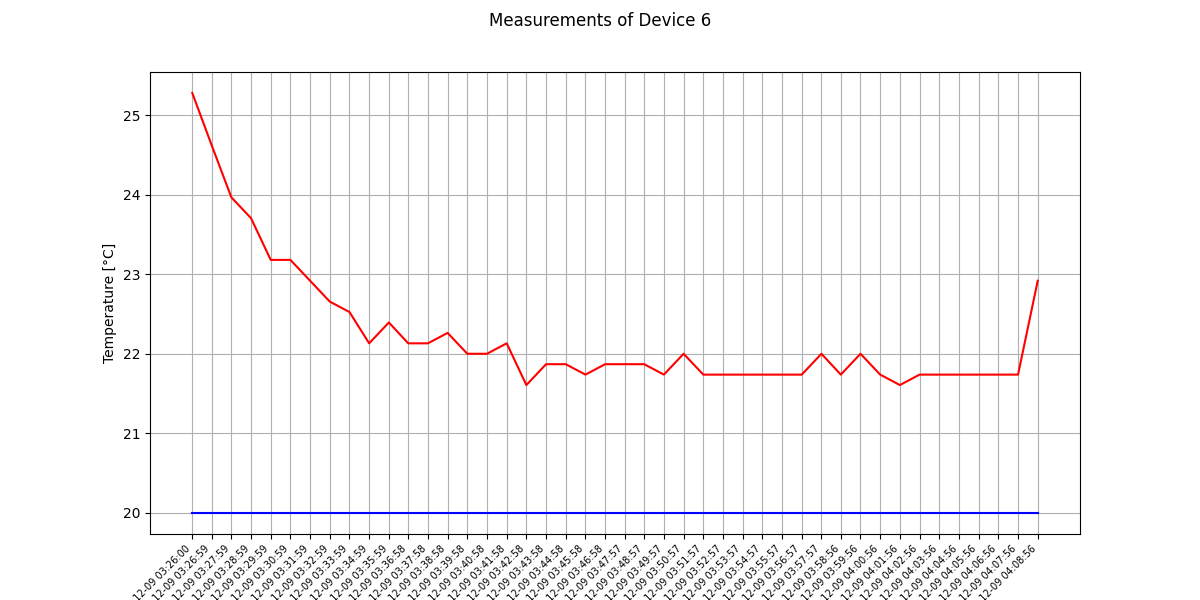
Pruebas Experimentales/Prueba Temperatura/Prueba 20C1/PRUEBA_TEMPERATURA_6_T20C.png
