odevincenti/Wet-DryPenguins/Pruebas Experimentales/Prueba Temperatura/Prueba 20C/PRUEBA_TEMPERATURA_6_T20C.png

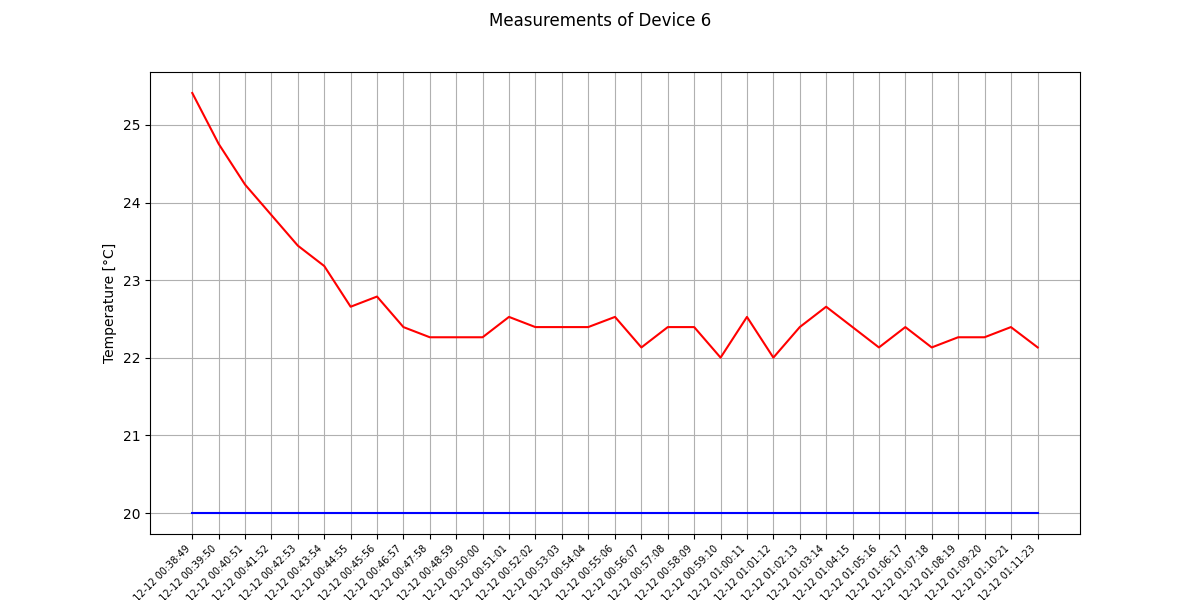
Pruebas Experimentales/Prueba Temperatura/Prueba 20C/PRUEBA_TEMPERATURA_6_T20C.png
