odevincenti/Wet-DryPenguins/Pruebas Experimentales/Prueba Temperatura/Prueba 21C1/PRUEBA_TEMPERATURA_23_T21C.png

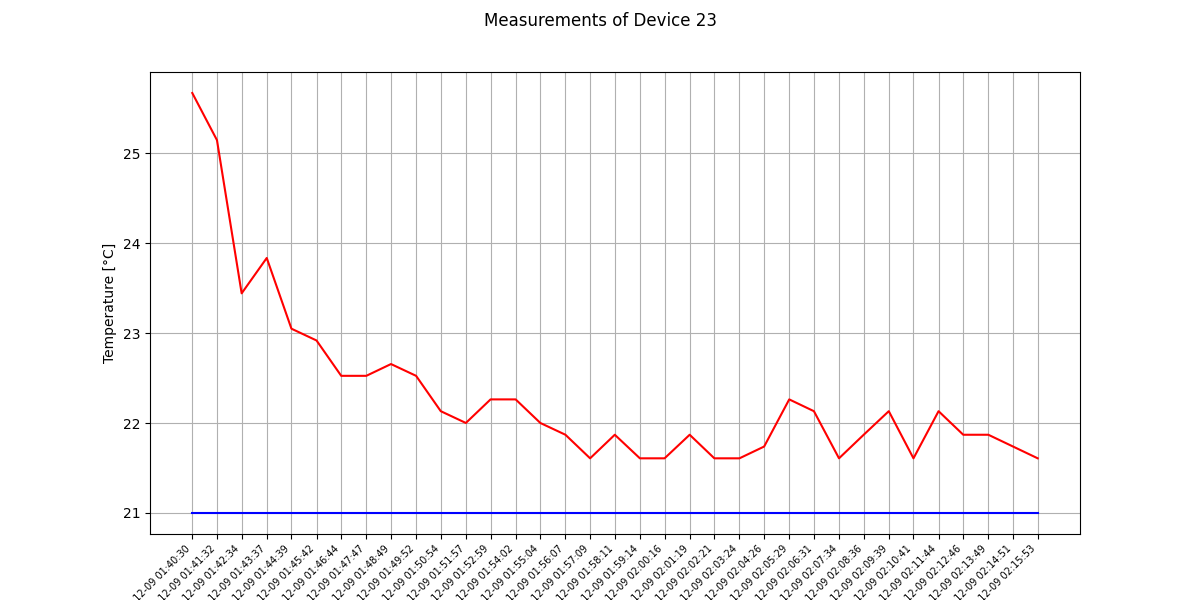
Pruebas Experimentales/Prueba Temperatura/Prueba 21C1/PRUEBA_TEMPERATURA_23_T21C.png
