odevincenti/Wet-DryPenguins/Pruebas Experimentales/Prueba Temperatura/Prueba 21C/PRUEBA_TEMPERATURA_6_T21C.png

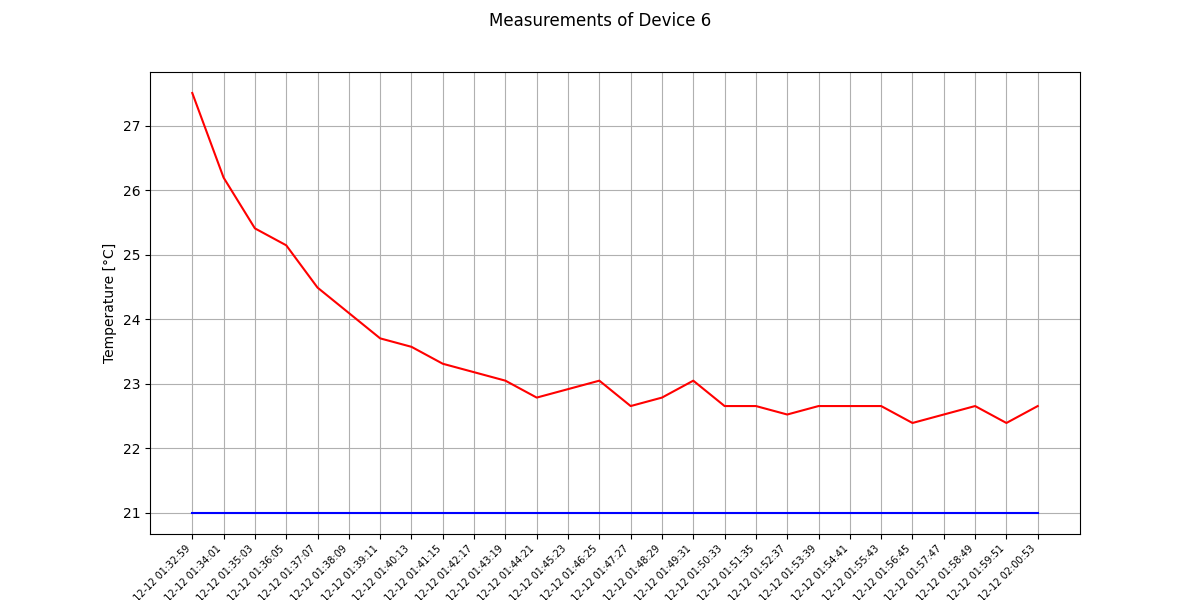
Pruebas Experimentales/Prueba Temperatura/Prueba 21C/PRUEBA_TEMPERATURA_6_T21C.png
