odevincenti/Wet-DryPenguins/Pruebas Experimentales/Prueba Temperatura/Prueba 22C1/PRUEBA_TEMPERATURA_23_T22C.png

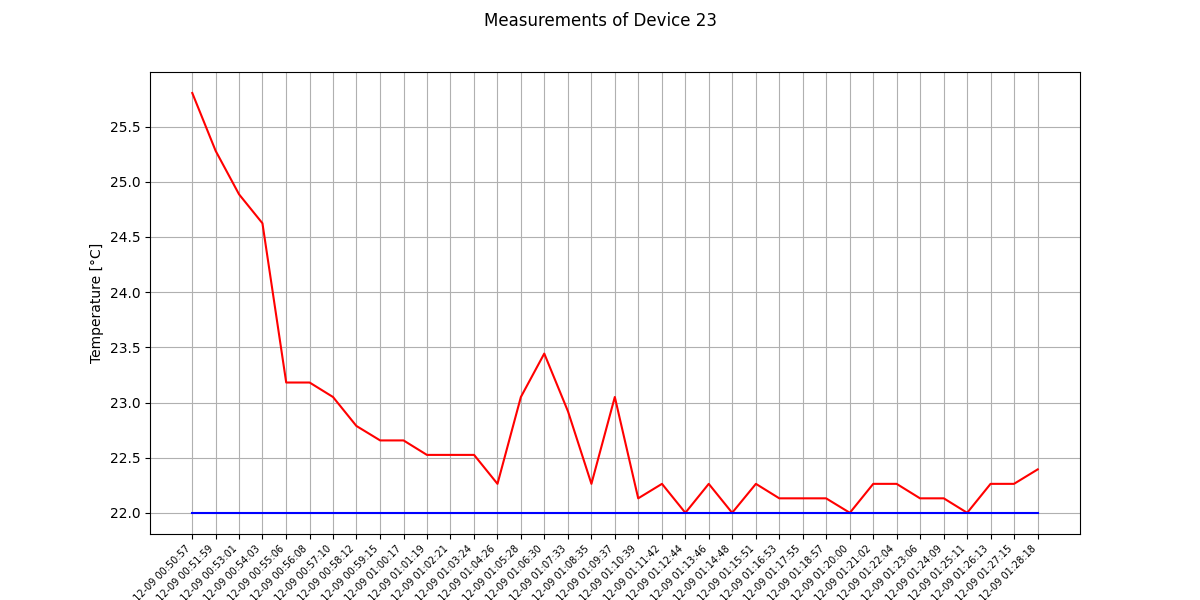
Pruebas Experimentales/Prueba Temperatura/Prueba 22C1/PRUEBA_TEMPERATURA_23_T22C.png
