odevincenti/Wet-DryPenguins/Pruebas Experimentales/Prueba Temperatura/Prueba 23C1/PRUEBA_TEMPERATURA_23_T23C.png

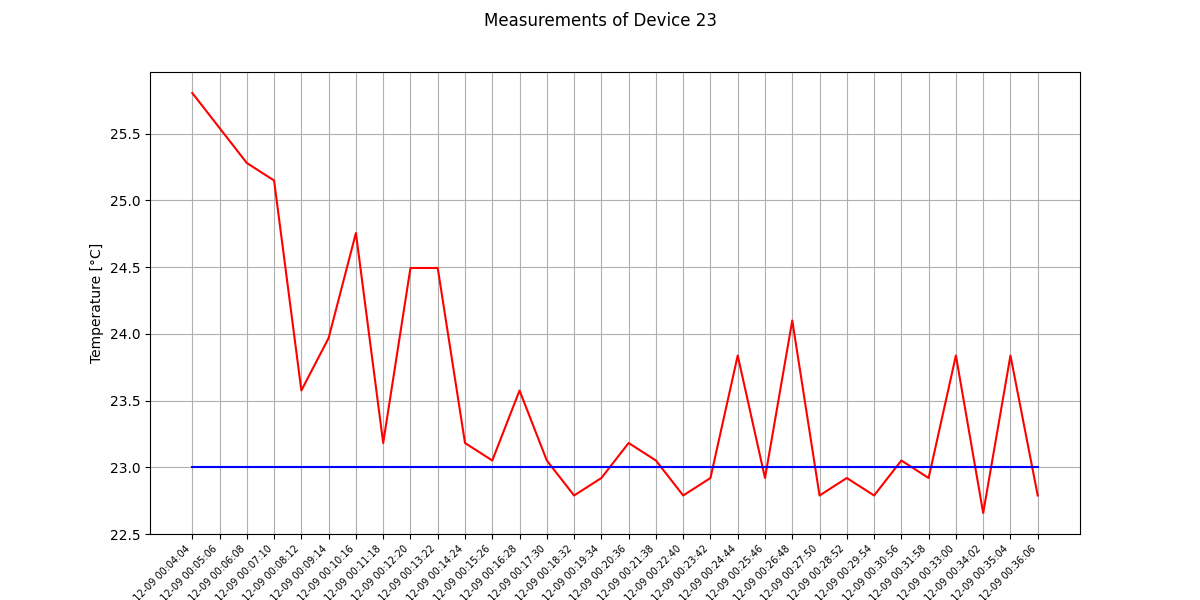
Pruebas Experimentales/Prueba Temperatura/Prueba 23C1/PRUEBA_TEMPERATURA_23_T23C.png
