odevincenti/Wet-DryPenguins/Pruebas Experimentales/Prueba Temperatura/Prueba 23C/PRUEBA_TEMPERATURA_6_T23C.png

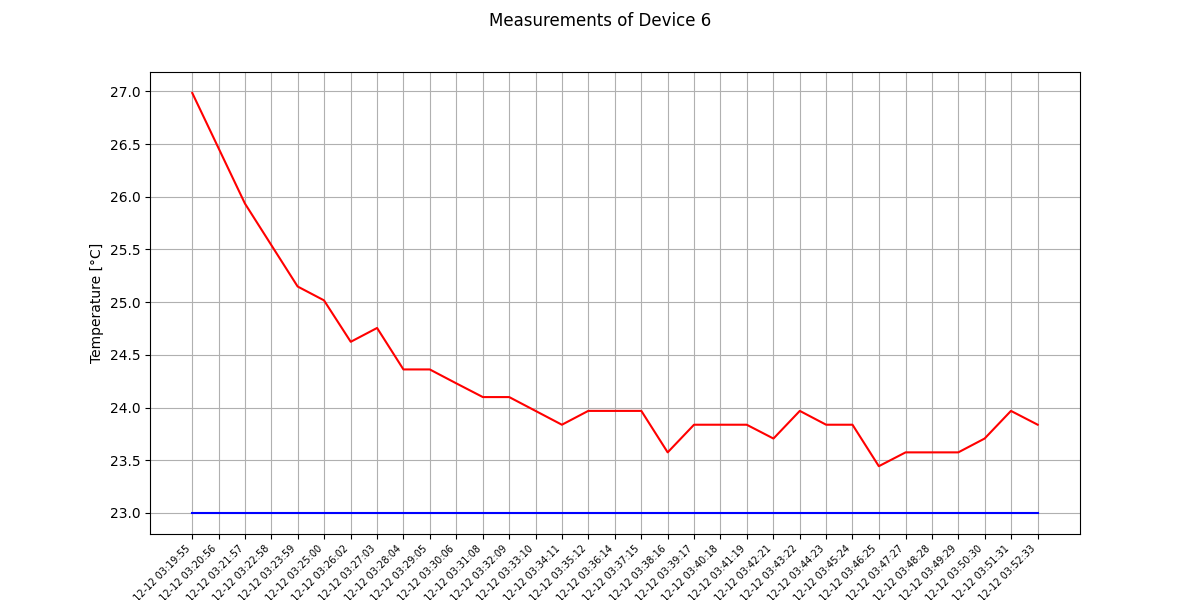
Pruebas Experimentales/Prueba Temperatura/Prueba 23C/PRUEBA_TEMPERATURA_6_T23C.png
