odevincenti/Wet-DryPenguins/Pruebas Experimentales/Prueba Temperatura/Prueba 24C/PRUEBA_TEMPERATURA_6_T24C.png

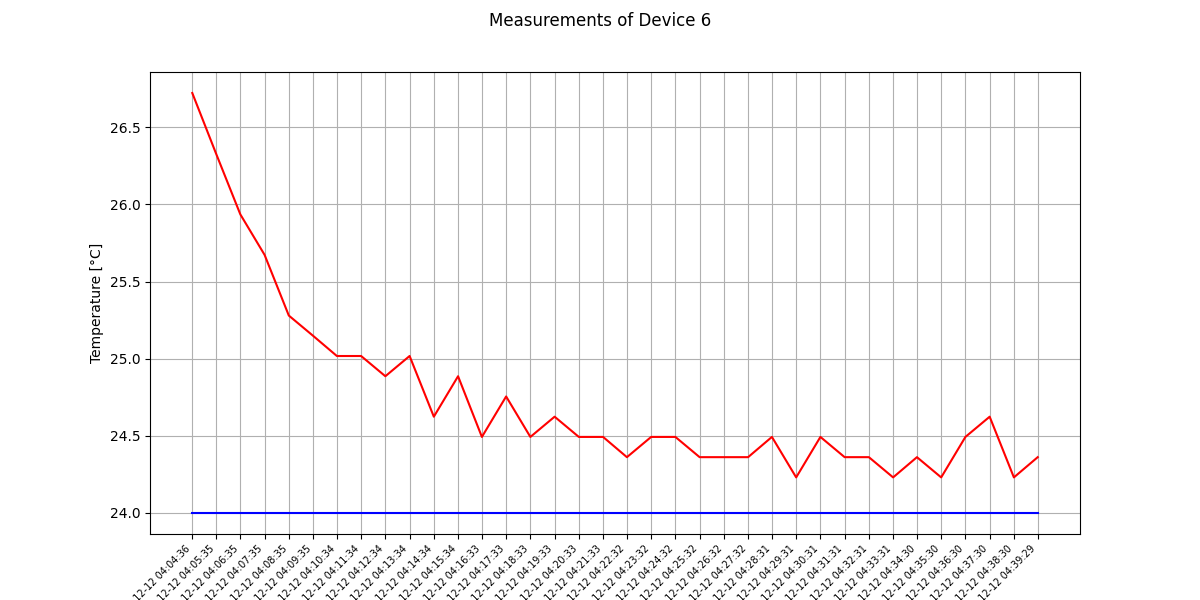
Pruebas Experimentales/Prueba Temperatura/Prueba 24C/PRUEBA_TEMPERATURA_6_T24C.png
