odevincenti/Wet-DryPenguins/Pruebas Experimentales/Prueba Temperatura/Prueba 25C/PRUEBA_TEMPERATURA_23_T25C.png

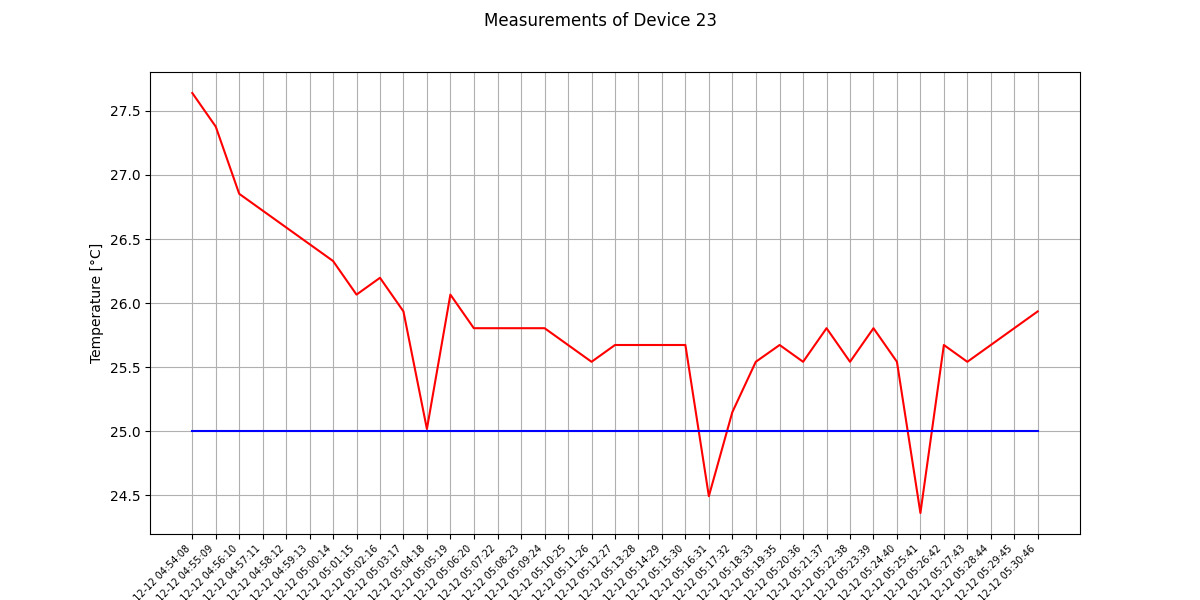
Pruebas Experimentales/Prueba Temperatura/Prueba 25C/PRUEBA_TEMPERATURA_23_T25C.png
