odevincenti/Wet-DryPenguins/Pruebas Experimentales/Prueba Temperatura/Prueba 26C/PRUEBA_TEMPERATURA_23_T26C.png

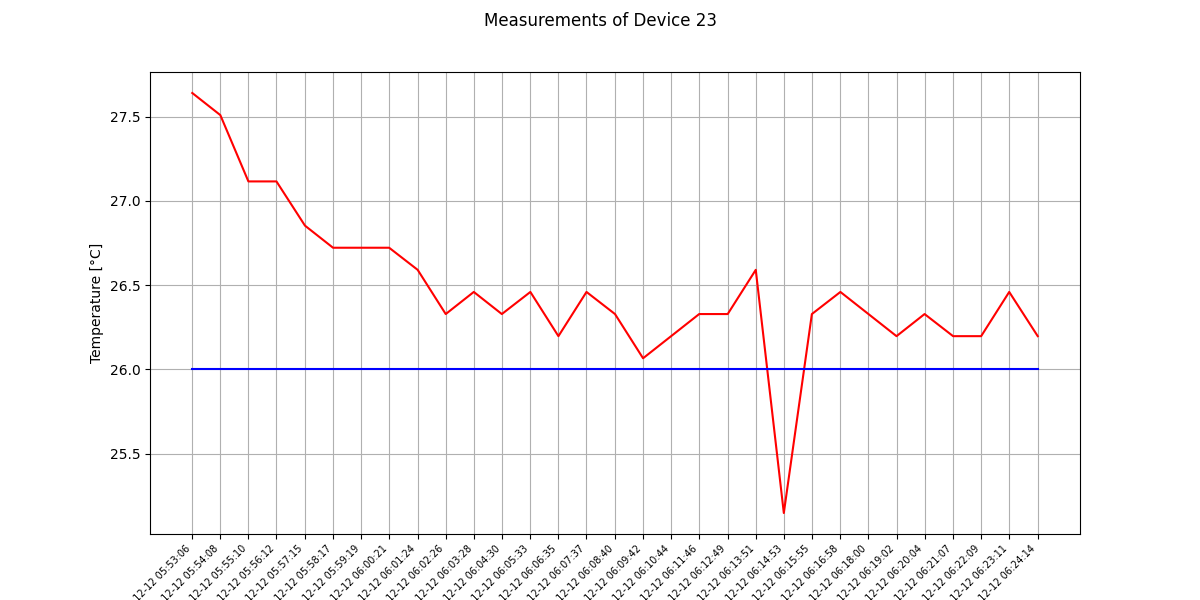
Pruebas Experimentales/Prueba Temperatura/Prueba 26C/PRUEBA_TEMPERATURA_23_T26C.png
