odevincenti/Wet-DryPenguins/Pruebas Experimentales/Prueba Temperatura/Prueba 27C/PRUEBA_TEMPERATURA_6_T27C.png

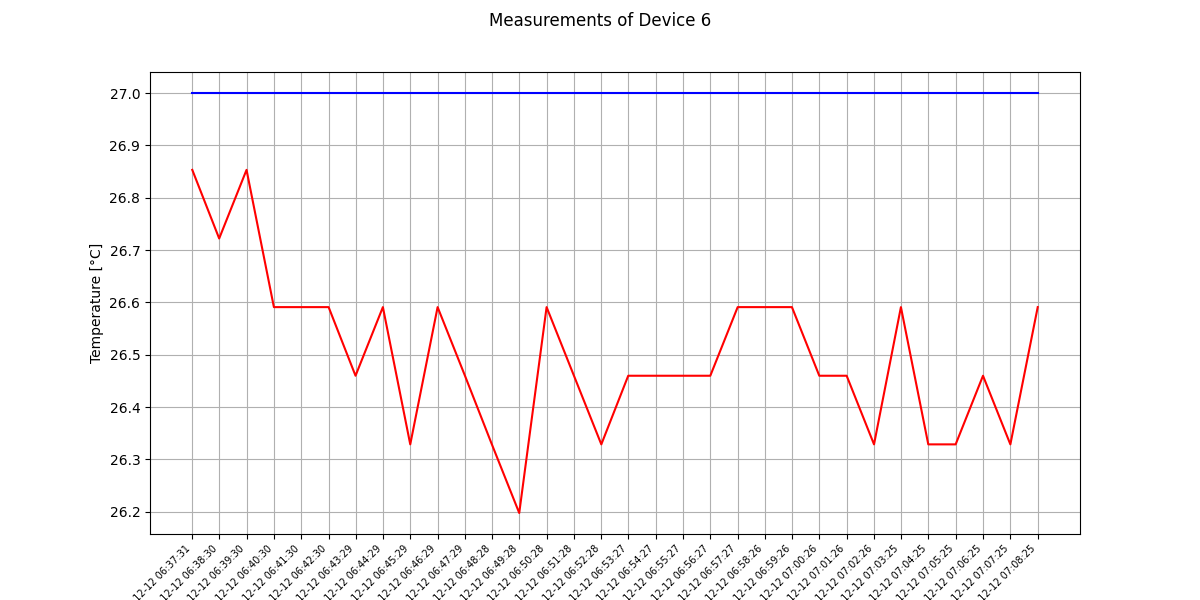
Pruebas Experimentales/Prueba Temperatura/Prueba 27C/PRUEBA_TEMPERATURA_6_T27C.png
