odevincenti/Wet-DryPenguins/Pruebas Experimentales/Prueba Temperatura/Prueba 28C/PRUEBA_TEMPERATURA_23_T28C.png

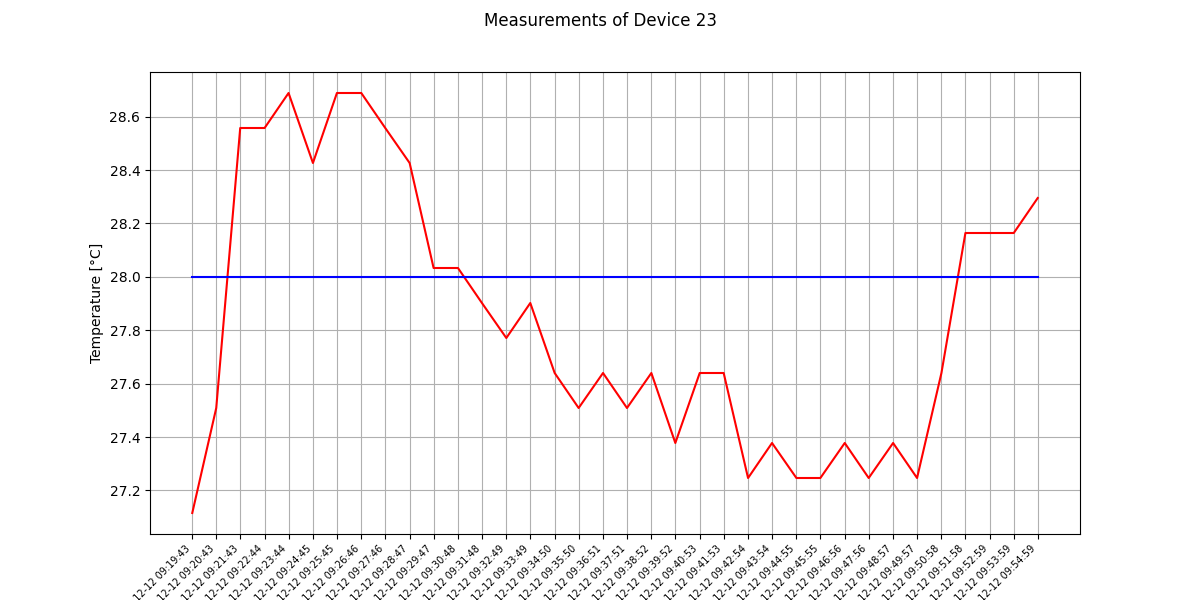
Pruebas Experimentales/Prueba Temperatura/Prueba 28C/PRUEBA_TEMPERATURA_23_T28C.png
