odevincenti/Wet-DryPenguins/Pruebas Experimentales/Prueba Temperatura/Pruebas viejas/Prueba 1/PRUEBA_TEMPERATURA_OLI_23.png

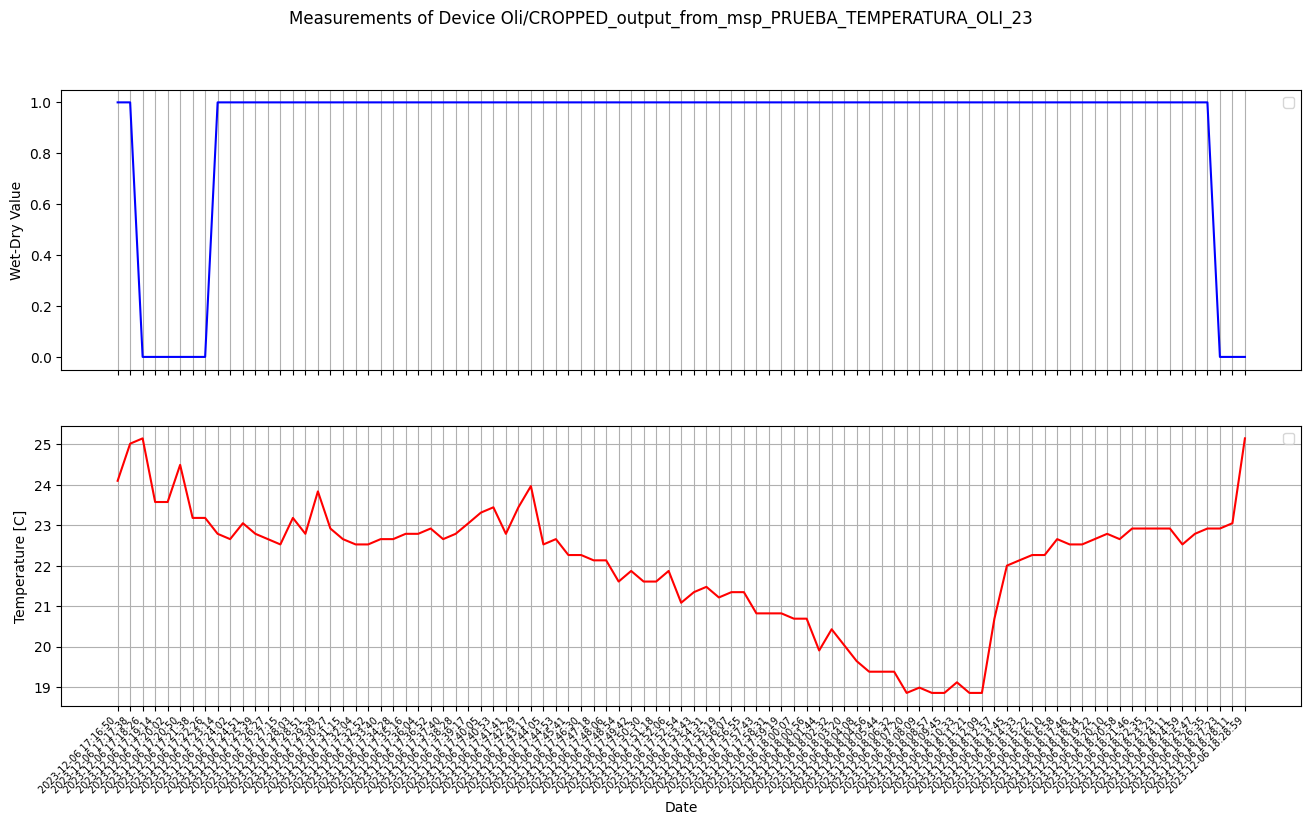
Pruebas Experimentales/Prueba Temperatura/Pruebas viejas/Prueba 1/PRUEBA_TEMPERATURA_OLI_23.png
