odevincenti/Wet-DryPenguins/Documentación/Tablas/9-1-4 DFMEA.xlsx

Sheet: FMECA Iteracion 2
FMECA
 | Subsistema | Modo potencial de falla | Efecto potencial de falla | Severidad | Causa(s) potenciales de fallo | Ocurrencia | Controles preventivos actuales | Controles de detección actuales | RPN
1 | Bateria | Descarga inesperadamente rapida | Circuito apagado, no hay nuevas mediciones desde cierto punto. Complica la extraccion de datos | 8 | Corto en los pines de sensado u otros. Demasiadas mediciones. | 1 | Minimizacion de mediciones(consumo), carcasa aislante y optimizacion del modo apagado. | Test de proyección de consumo | 8
2 | Sensores | Corrosion propia del agua salada/intemperie | Podria interferir con las mediciones a partir de cierto punto, o incluso poner en riesgo la integridad del circuito | 6 | Alta composicion acidica en el agua de mar contra el material de los sensores | 1 | Pines con recubrimiento especial para evitar la corrosion | Sin test, investigacion | 6
3 | Carcasa | Perdida de impermeabilidad (fallas de integridad) | Se estropearia el circuito entero, se perderian las mediciones y hasta quizas el dispositivo en si | 9 | Demasiada presion, o su derivada. Exposicion a fuerzas de la naturaleza | 1 | Proceso de enresinado adecuado, y eleccion de material preciso | Testeos de presión | 9
4 | Carcasa | Adherencia organismos biologicos | Podria interferir con las mediciones a partir de su aparición. Tambien podria entorpecer la extraccion de datos | 4 | Alta adherencia del material de recubrimiento | 1 | Material de recubrimiento antiadherente | Prueba de campo | 4
5 | Micro controlador | Uso total de la memoria maxima antes de tiempo | Podrian perderse futuras mediciones, y hasta incluso perder todas (si no se programa con esta falla en cuenta) | 8 | Cantidad inesperadamente alta de mediciones. | 6 | Memoria sobredimensionada, eficiencia en el guardado de datos | Test de mediciones | 48
6 | Micro controlador | Baja de rendimiento/Apagado por condiciones de operacion | El micro se podria colgar y dejar de procesar datos por tiempo indeterminado | 7 | Muy bajas temperaturas, muy altas presiones, cualquier falla mecanica que comprometa la conexion del uC | 2 | Proceso de poteo adecuado, soldaduras revisadas | Testeos estadísticos con distintas condiciones de operación | 14
7 |  |  |  |  |  |  |  |  | 0
8 |  |  |  |  |  |  |  |  | 0
9 |  |  |  |  |  |  |  |  | 0
10 |  |  |  |  |  |  |  |  | 0
11 |  |  |  |  |  |  |  |  | 0 |  | Ocurrencia |  | Severidad
 |  |  |  |  |  |  |  |  |  |  | 10 | Falla inevitable | 10 | Peligroso y sin aviso previo
 |  |  |  |  |  |  |  |  | Referencias | ------------> | 9 | Probabilidad de ocurrencia muy alta | 9 | Peligroso , con aviso
 |  |  |  |  |  |  |  |  |  |  | 8 | Probabilidad de ocurrencia alta | 8 | Perdida de alguna funcion primaria
 |  |  |  |  |  |  |  |  |  |  | 7 | Probabilidad de ocurrencia moderada/alta | 7 | Reduccion de alguna funcion primaria
 |  |  |  |  |  |  |  |  |  |  | 6 | Probabilidad de ocurrencia moderada | 6 | Perdida de alguna funcion secundaria
 |  |  |  |  |  |  |  |  |  |  | 5 | Probabilidad de ocurrencia ocasional | 5 | Reduccion de alguna funcion secundaria
 |  |  |  |  |  |  |  |  |  |  | 4 | Probabilidad de ocurrencia baja | 4 | Defecto menor que muy posiblemente sea notado por el cliente
 |  |  |  |  |  |  |  |  |  |  | 3 | Probabilidad de ocurrencia muy baja | 3 | Defecto menor que puede o no ser detectado por el cliente
 |  |  |  |  |  |  |  |  |  |  | 2 | Probabilidad de ocurrencia escasa | 2 | Defecto menor que muy posiblemente no sera notado por el cliente
 |  |  |  |  |  |  |  |  |  |  | 1 | Probabilidad de ocurrencia casi nula | 1 | Sin efecto
 |  |  |  |  |  |  |  |  |  |  | Detección
 |  |  |  |  |  |  |  |  |  |  | 10 | No se puede detectar
 |  |  |  |  |  |  |  |  |  |  | 9 | Posibilidad muy remota de deteccion
 |  |  |  |  |  |  |  |  |  |  | 8 | Posibilidad remota de deteccion
 |  |  |  |  |  |  |  |  |  |  | 7 | Posibilidad muy baja de deteccion
 |  |  |  |  |  |  |  |  |  |  | 6 | Posibilidad baja de deteccion
 |  |  |  |  |  |  |  |  |  |  | 5 | Posibilidad moderada de deteccion
 |  |  |  |  |  |  |  |  |  |  | 4 | Posibilidad alta de deteccion
 |  |  |  |  |  |  |  |  |  |  | 3 | Posibilidad muy alta de deteccion
 |  |  |  |  |  |  |  |  |  |  | 2 | Deteccion casi asegurada
 |  |  |  |  |  |  |  |  |  |  | 1 | Deteccion asegurada

Sheet: Iteracion 2
Design DFMEA
 | Subsistema | Modo potencial de falla | Efecto potencial de falla | Severidad | Causa(s) potenciales de fallo | Ocurrencia | Controles preventivos actuales | Controles de deteccion actuales | Deteccion | RPN
1 | Bateria | Descarga inesperadamente rapida | Circuito apagado, no hay nuevas mediciones desde cierto punto. Complica la extraccion de datos | 8 | Corto en los pines de sensado u otros. Demasiadas mediciones. | 1 | Minimizacion de mediciones(consumo), carcasa aislante y optimizacion del modo apagado. | Test de proyección de consumo | 2 | 16
2 | Sensores | Corrosion propia del agua salada/intemperie | Podria interferir con las mediciones a partir de cierto punto, o incluso poner en riesgo la integridad del circuito | 8 | Alta composicion acidica en el agua de mar contra el material de los sensores | 1 | Pines con recubrimiento especial para evitar esto mismo | Sin test, investigacion | 2 | 16
3 | Carcasa | Perdida de impermeabilidad (fallas de integridad) | Se estropearia el circuito entero, se perderian las mediciones y hasta quizas el dispositivo en si | 9 | Demasiada presion, o su derivada. Exposicion a fuerzas de la naturaleza | 1 | Proceso de poteo adecuado, y eleccion de material preciso | Testeos de presión | 1 | 9
4 | Carcasa | Adherencia organismos biologicos | Podria interferir con las mediciones a partir de su aparicion. Tambien podria entorpecer la extraccion de datos | 7 | Alta adherencia del material de poteo | 1 | Material de poteo antiadherente | Prueba de campo | 2 | 14
5 | Micro controlador | Uso total de la memoria maxima antes de tiempo | Podrian perderse futuras mediciones, y hasta incluso perder todas (si no se programa con esta falla en cuenta) | 8 | Cantidad inesperadamente alta de mediciones. | 6 | Memoria sobredimensionada, eficiencia en el guardado de datos | Test de mediciones | 3 | 144
6 | Micro controlador | Baja de rendimiento/Apagado por condiciones de operacion | El micro se podria colgar y dejar de procesar datos por tiempo indeterminado | 7 | Muy bajas temperaturas, muy altas presiones, cualquier falla mecanica que comprometa la conexion del uC | 2 | Proceso de poteo adecuado, soldaduras revisadas | Testeos estadísticos con distintas condiciones de operación | 3 | 42
7 |  |  |  |  |  |  |  |  |  | 0
8 |  |  |  |  |  |  |  |  |  | 0
9 |  |  |  |  |  |  |  |  |  | 0
10 |  |  |  |  |  |  |  |  |  | 0
11 |  |  |  |  |  |  |  |  |  | 0 |  | Ocurrencia |  | Severidad
 |  |  |  |  |  |  |  |  |  |  |  | 10 | Falla inevitable | 10 | Peligroso y sin aviso previo
 |  |  |  |  |  |  |  |  |  | Referencias | ------------> | 9 | Probabilidad de ocurrencia muy alta | 9 | Peligroso , con aviso
 |  |  |  |  |  |  |  |  |  |  |  | 8 | Probabilidad de ocurrencia alta | 8 | Perdida de alguna funcion primaria
 |  |  |  |  |  |  |  |  |  |  |  | 7 | Probabilidad de ocurrencia moderada/alta | 7 | Reduccion de alguna funcion primaria
 |  |  |  |  |  |  |  |  |  |  |  | 6 | Probabilidad de ocurrencia moderada | 6 | Perdida de alguna funcion secundaria
 |  |  |  |  |  |  |  |  |  |  |  | 5 | Probabilidad de ocurrencia ocasional | 5 | Reduccion de alguna funcion secundaria
 |  |  |  |  |  |  |  |  |  |  |  | 4 | Probabilidad de ocurrencia baja | 4 | Defecto menor que muy posiblemente sea notado por el cliente
 |  |  |  |  |  |  |  |  |  |  |  | 3 | Probabilidad de ocurrencia muy baja | 3 | Defecto menor que puede o no ser detectado por el cliente
 |  |  |  |  |  |  |  |  |  |  |  | 2 | Probabilidad de ocurrencia escasa | 2 | Defecto menor que muy posiblemente no sera notado por el cliente
 |  |  |  |  |  |  |  |  |  |  |  | 1 | Probabilidad de ocurrencia casi nula | 1 | Sin efecto
 |  |  |  |  |  |  |  |  |  |  |  | Detección
 |  |  |  |  |  |  |  |  |  |  |  | 10 | No se puede detectar
 |  |  |  |  |  |  |  |  |  |  |  | 9 | Posibilidad muy remota de deteccion
 |  |  |  |  |  |  |  |  |  |  |  | 8 | Posibilidad remota de deteccion
 |  |  |  |  |  |  |  |  |  |  |  | 7 | Posibilidad muy baja de deteccion
 |  |  |  |  |  |  |  |  |  |  |  | 6 | Posibilidad baja de deteccion
 |  |  |  |  |  |  |  |  |  |  |  | 5 | Posibilidad moderada de deteccion
 |  |  |  |  |  |  |  |  |  |  |  | 4 | Posibilidad alta de deteccion
 |  |  |  |  |  |  |  |  |  |  |  | 3 | Posibilidad muy alta de deteccion
 |  |  |  |  |  |  |  |  |  |  |  | 2 | Deteccion casi asegurada
 |  |  |  |  |  |  |  |  |  |  |  | 1 | Deteccion asegurada

Sheet: Iteracion 1
DFMEA
 | Subsistema | Modo potencial de falla | Efecto potencial de falla | Severidad | Causa(s) potenciales de fallo | Ocurrencia | Controles preventivos actuales | Controles de deteccion actuales | Deteccion | RPN
1 | Bateria | Descarga inesperadamente rapida | Circuito apagado, no hay nuevas mediciones desde cierto punto. Complica la extraccion de datos | 8 | Corto en los pines de sensado u otros. Demasiadas mediciones. | 3 | Minimizacion de mediciones(consumo), carcasa aislante y optimizacion del modo apagado | Testeos de peor caso - T07, T08, T09, T11 | 5 | 120 | 24
2 | Sensores | Corrosion propia del agua salada/intemperie | Podria interferir con las mediciones a partir de cierto punto, o incluso poner en riesgo la integridad del circuito | 8 | Alta composicion acidica en el agua de mar contra el material de los sensores | 2 | Pines con recubrimiento especial para evitar la corrosion | Testeos - T14 | 8 | 128 | 16
3 | Carcasa | Perdida de impermeabilidad (fallas de integridad) | Se estropearia el circuito entero, se perderian las mediciones y hasta quizas el dispositivo en si | 9 | Demasiada presion, o su derivada. Exposicion a fuerzas de la naturaleza | 4 | Proceso de enresinado adecuado, y eleccion de material preciso | Testeos de peor caso- T14,T15,T16 | 4 | 144 | 36
4 | Carcasa | Adherencia organismos biologicos | Podria interferir con las mediciones a partir de su aparicion. Tambien podria entorpecer la extraccion de datos | 7 | Alta adherencia del material de recubrimiento | 5 | Material de recubrimiento antiadherente |  | 10 | 350 | 35
5 | Micro controlador | Uso total de la memoria maxima antes de tiempo | Podrian perderse futuras mediciones, y hasta incluso perder todas (si no se programa con esta falla en cuenta) | 8 | Cantidad inesperadamente alta de mediciones. | 3 | Memoria sobredimensionada, eficiencia en el guardado de datos | Testeos de peor caso- T10,T17 | 6 | 144 | 24
6 | Micro controlador | Baja de rendimiento/Apagado por condiciones de operacion | El micro se podria colgar y dejar de procesar datos por tiempo indeterminado | 7 | Muy bajas temperaturas, muy altas presiones, cualquier falla mecanica que comprometa la conexion del uC | 3 | Proceso de poteo adecuado, soldaduras revisadas | Testeos de peor caso - T10,T15,T18,T19 | 5 | 105 | 21
7 |  |  |  |  |  |  |  |  |  | 0 | 0
8 |  |  |  |  |  |  |  |  |  | 0 | 0
9 |  |  |  |  |  |  |  |  |  | 0 | 0
10 |  |  |  |  |  |  |  |  |  | 0 | 0
11 |  |  |  |  |  |  |  |  |  | 0 | 0 | Ocurrencia |  | Severidad
 |  |  |  |  |  |  |  |  |  |  |  | 10 | Falla inevitable | 10 | Peligroso y sin aviso previo
 |  |  |  |  |  |  |  |  |  | Referencias | ------------> | 9 | Probabilidad de ocurrencia muy alta | 9 | Peligroso , con aviso
 |  |  |  |  |  |  |  |  |  |  |  | 8 | Probabilidad de ocurrencia alta | 8 | Perdida de alguna funcion primaria
 |  |  |  |  |  |  |  |  |  |  |  | 7 | Probabilidad de ocurrencia moderada/alta | 7 | Reduccion de alguna funcion primaria
 |  |  |  |  |  |  |  |  |  |  |  | 6 | Probabilidad de ocurrencia moderada | 6 | Perdida de alguna funcion secundaria
 |  |  |  |  |  |  |  |  |  |  |  | 5 | Probabilidad de ocurrencia ocasional | 5 | Reduccion de alguna funcion secundaria
 |  |  |  |  |  |  |  |  |  |  |  | 4 | Probabilidad de ocurrencia baja | 4 | Defecto menor que muy posiblemente sea notado por el cliente
 |  |  |  |  |  |  |  |  |  |  |  | 3 | Probabilidad de ocurrencia muy baja | 3 | Defecto menor que puede o no ser detectado por el cliente
 |  |  |  |  |  |  |  |  |  |  |  | 2 | Probabilidad de ocurrencia escasa | 2 | Defecto menor que muy posiblemente no sera notado por el cliente
 |  |  |  |  |  |  |  |  |  |  |  | 1 | Probabilidad de ocurrencia casi nula | 1 | Sin efecto
 |  |  |  |  |  |  |  |  |  |  |  | Detección
 |  |  |  |  |  |  |  |  |  |  |  | 10 | No se puede detectar
 |  |  |  |  |  |  |  |  |  |  |  | 9 | Posibilidad muy remota de deteccion
 |  |  |  |  |  |  |  |  |  |  |  | 8 | Posibilidad remota de deteccion
 |  |  |  |  |  |  |  |  |  |  |  | 7 | Posibilidad muy baja de deteccion
 |  |  |  |  |  |  |  |  |  |  |  | 6 | Posibilidad baja de deteccion
 |  |  |  |  |  |  |  |  |  |  |  | 5 | Posibilidad moderada de deteccion
 |  |  |  |  |  |  |  |  |  |  |  | 4 | Posibilidad alta de deteccion
 |  |  |  |  |  |  |  |  |  |  |  | 3 | Posibilidad muy alta de deteccion
 |  |  |  |  |  |  |  |  |  |  |  | 2 | Deteccion casi asegurada
 |  |  |  |  |  |  |  |  |  |  |  | 1 | Deteccion asegurada

Sheet: Hoja 4
DFMEA
 | Subsistema | Modo potencial de falla | Efecto potencial de falla | Severidad | Causa(s) potenciales de fallo | Ocurrencia | Controles preventivos actuales | Controles de deteccion actuales | Deteccion | RPN
1 | Bateria | Descarga inesperadamente rapida | Circuito apagado, no hay nuevas mediciones desde cierto punto. Complica la extraccion de datos | 8 | Corto en los pines de sensado u otros. Demasiadas mediciones. | 3 | Minimizacion de mediciones(consumo), carcasa aislante y optimizacion del modo apagado | Testeos de peor caso - T07, T08, T09, T11 | 5 | 120
2 | Sensores | Corrosion propia del agua salada/intemperie | Podria interferir con las mediciones a partir de cierto punto, o incluso poner en riesgo la integridad del circuito | 8 | Alta composicion acidica en el agua de mar contra el material de los sensores | 2 | Pines con recubrimiento especial para evitar esto mismo | Testeos - T14 | 8 | 128
3 | Carcasa | Perdida de impermeabilidad (fallas de integridad) | Se estropearia el circuito entero, se perderian las mediciones y hasta quizas el dispositivo en si | 9 | Demasiada presion, o su derivada. Exposicion a fuerzas de la naturaleza | 4 | Proceso de poteo adecuado, y eleccion de material preciso | Testeos de peor caso- T14,T15,T16 | 4 | 144
4 | Carcasa | Adherencia organismos biologicos | Podria interferir con las mediciones a partir de su aparicion. Tambien podria entorpecer la extraccion de datos | 7 | Alta adherencia del material de poteo | 5 |  |  | 10 | 350
5 | Micro controlador | Uso total de la memoria maxima antes de tiempo | Podrian perderse futuras mediciones, y hasta incluso perder todas (si no se programa con esta falla en cuenta) | 8 | Cantidad inesperadamente alta de mediciones. | 3 | Memoria sobredimensionada, eficiencia en el guardado de datos | Testeos de peor caso- T10,T17 | 6 | 144
6 | Micro controlador | Baja de rendimiento/Apagado por condiciones de operacion | El micro se podria colgar y dejar de procesar datos por tiempo indeterminado | 7 | Muy bajas temperaturas, muy altas presiones, cualquier falla mecanica que comprometa la conexion del uC | 3 | Proceso de poteo adecuado, soldaduras revisadas | Testeos de peor caso - T10,T15,T18,T19 | 5 | 105
