odevincenti/Wet-DryPenguins/PCB/Penguin Base/Base_pcb.pdf

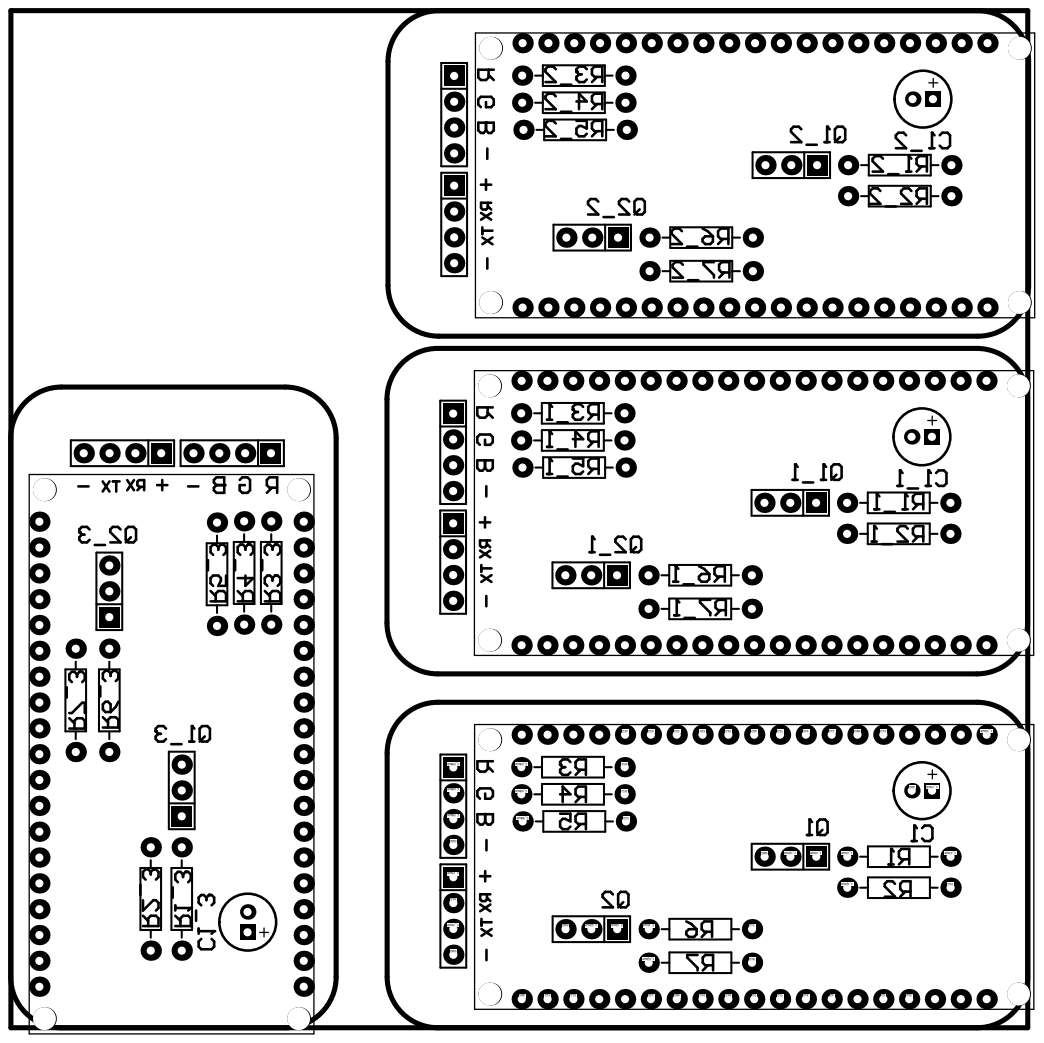
[picture p180: page 1]
NetQ1_1; G15 GND; NetC1_1 NetC1_1 GND; NetC1_1 GND; G13 NetJ1_1 G12 NetJ1_1 G14 NetQ1_1 G26; GND; G18 NetJ1_3 NetQ2_1 G32 G35 NetQ2_1; NetJ1_3 G22 GND; G23 NetR5_2 GND; NetR4_2 NetJ1_3 GND; G16 NetJ1_1 GND; NetR5_2 NetR4_2 NetR3_2; G25 NetR3_2

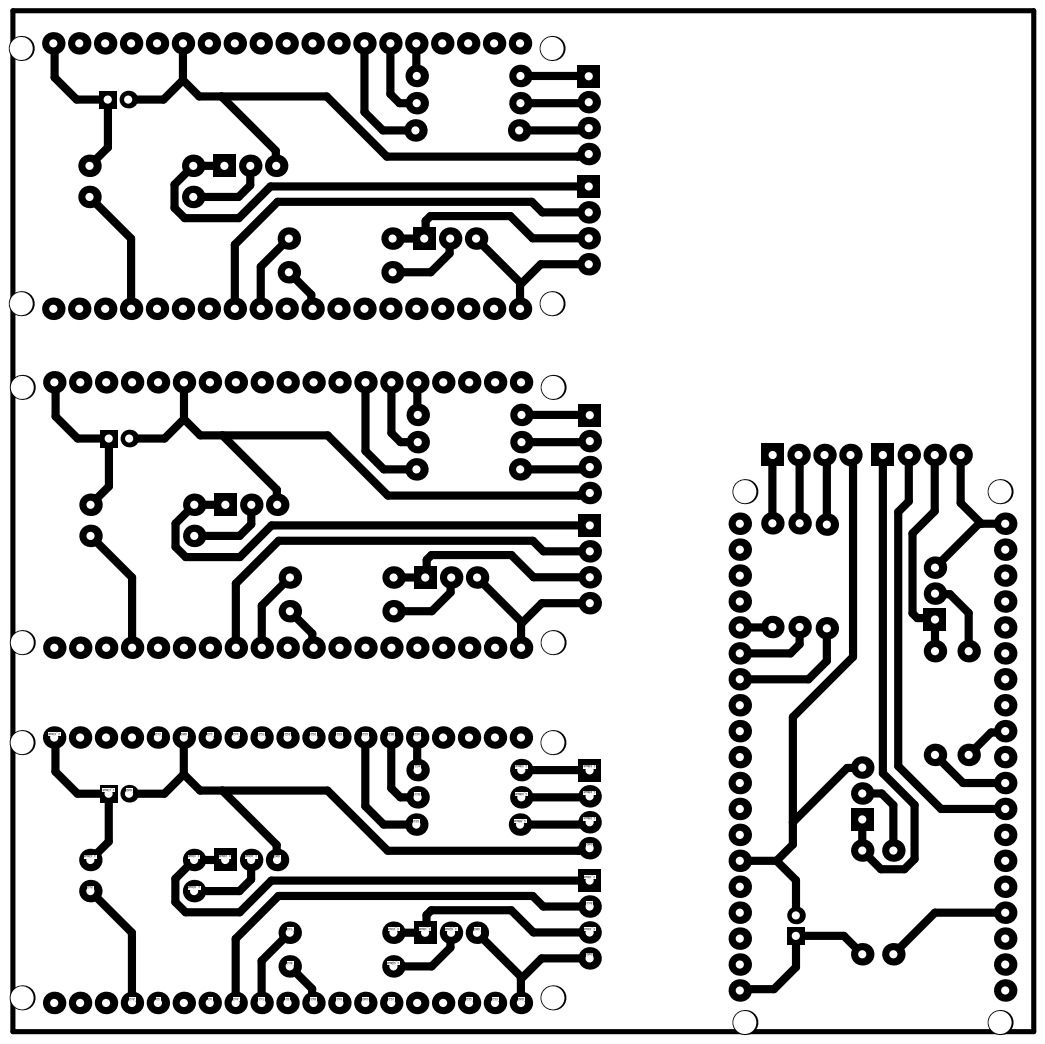
[picture p181: page 2]
NetQ1_1; GND; NetC1_1; NetJ1_1; NetJ1_1 G14; NetQ1_1 G27; G21 NetJ1_3 NetQ2_1; G32 G35NetJ1_3; NetQ2_1; G22 GND; NetR5_2 GND; NetR4_2; NetJ1_3 GND; G16 NetJ1_1 GND; NetR5_2 NetR4_2 NetR3_2 G25; NetR3_2 G15; NetR3_2
