odevincenti/Wet-DryPenguins/PCB/Tracker_Prototype/prototypeV2_reference.pdf

# 4 PROG

# TEST R1

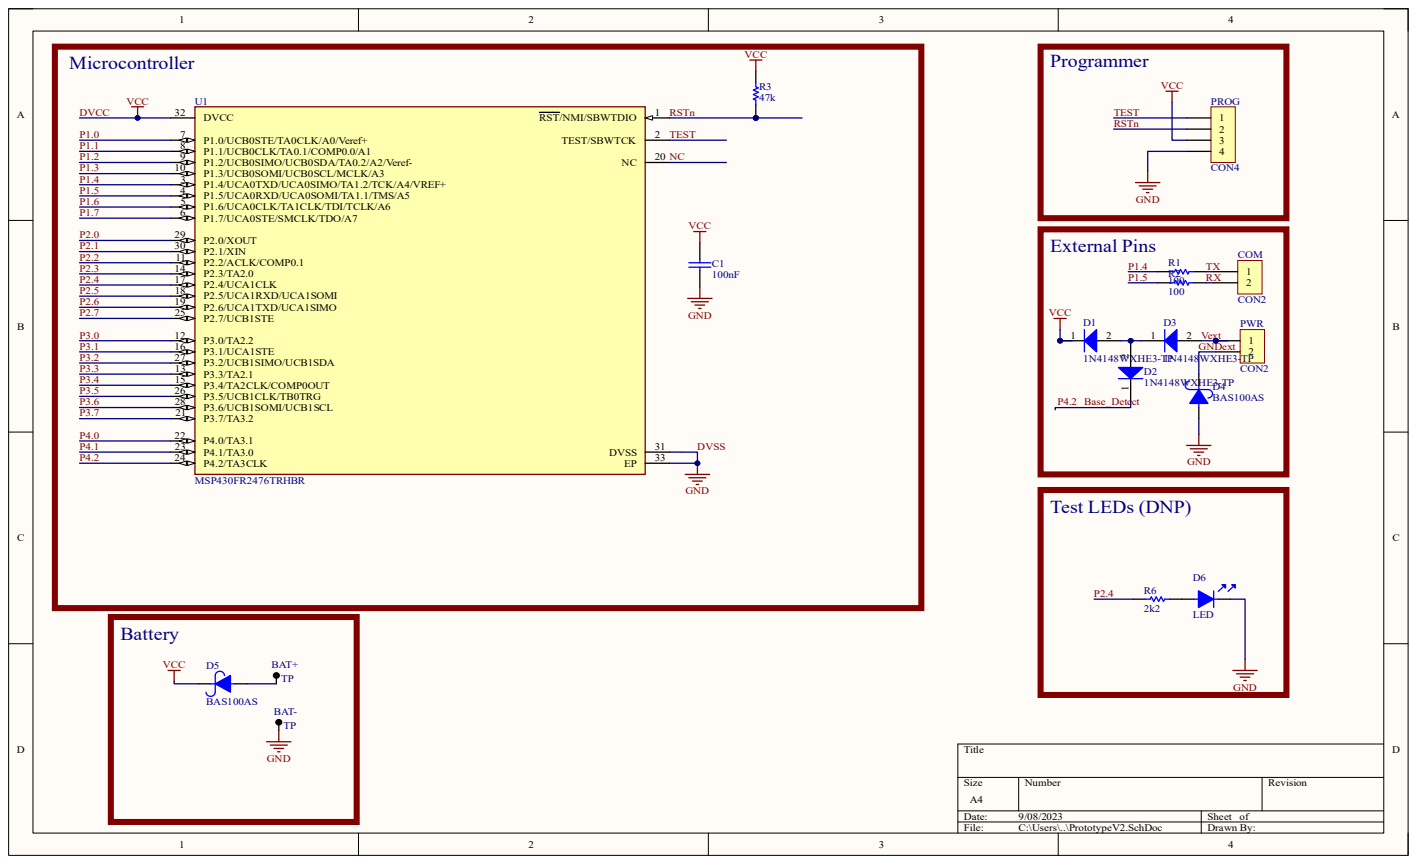
[picture p182: page 1]

RSTn TEST NC DVCC

BAT+ TP BAT- TP GND

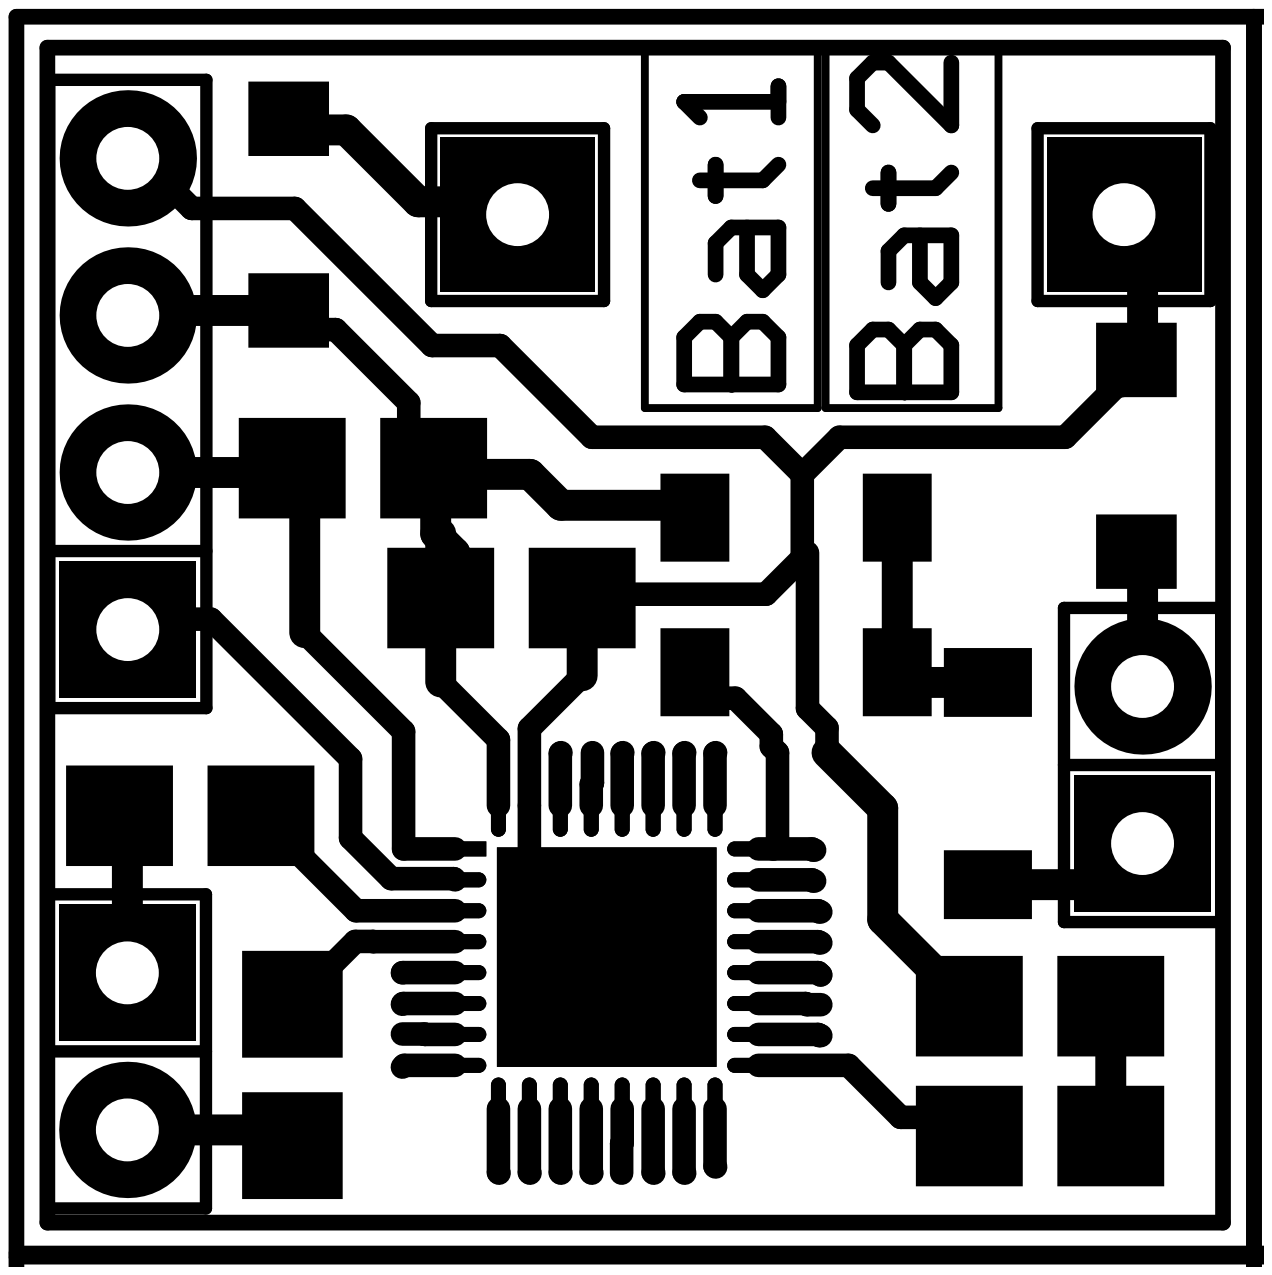
[picture p183: page 2]
