odevincenti/Wet-DryPenguins/PCB/Penguin Base/Project Outputs for Penguin Base/Base-PCB-FullOutputJob.PDF

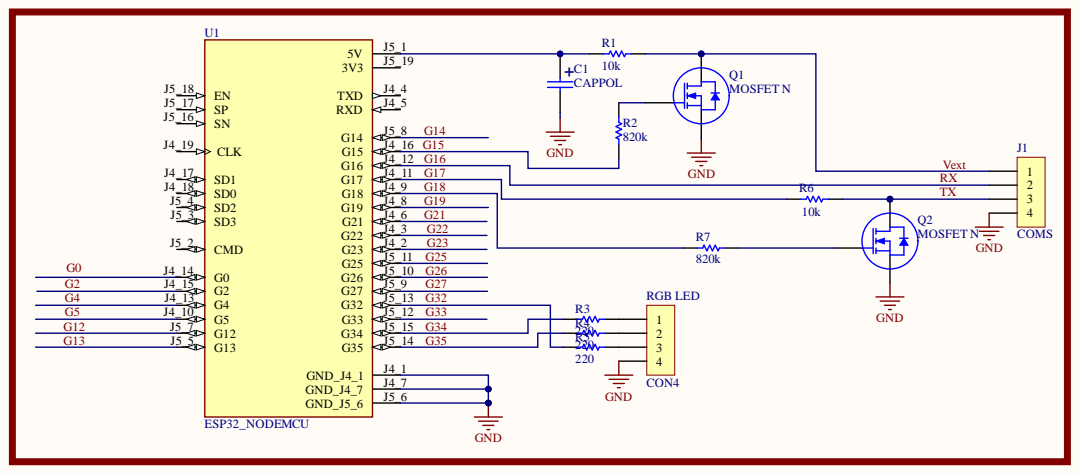
[picture p184: page 1]

J 4 _ | G N D 1 2 G 1 6
J 4 _ | 1 1 G 1 7 G N D
J 4 _
J 4 _ | 8 G 1 9

J 4 _ | 7
J 5 _ | 6

Designator | Quantity | Description | Value | Footprint | PartNumber | Digi-Key_Part_Number
C1 | 1 | | | CAP100RP
J1 | 1 | | | SIP4
Q1, Q2 | 2 | | | JUMPER3
R1, R6 | 2 | | | RES400
R2, R7 | 2 | | | RES400
R3, R4, R5 | 3 | | | RES400
RGBLED | 1 | | | SIP4
U1 | 1 | NodeMCUis an open sourceloTplatform. ESP32is a series of low cost, low powersystem-on-chip (SoC) microcontrollers with integrated Wi-Fi &dual-modeBluetooth. | | MODULE_ESP32_NOD EMCU

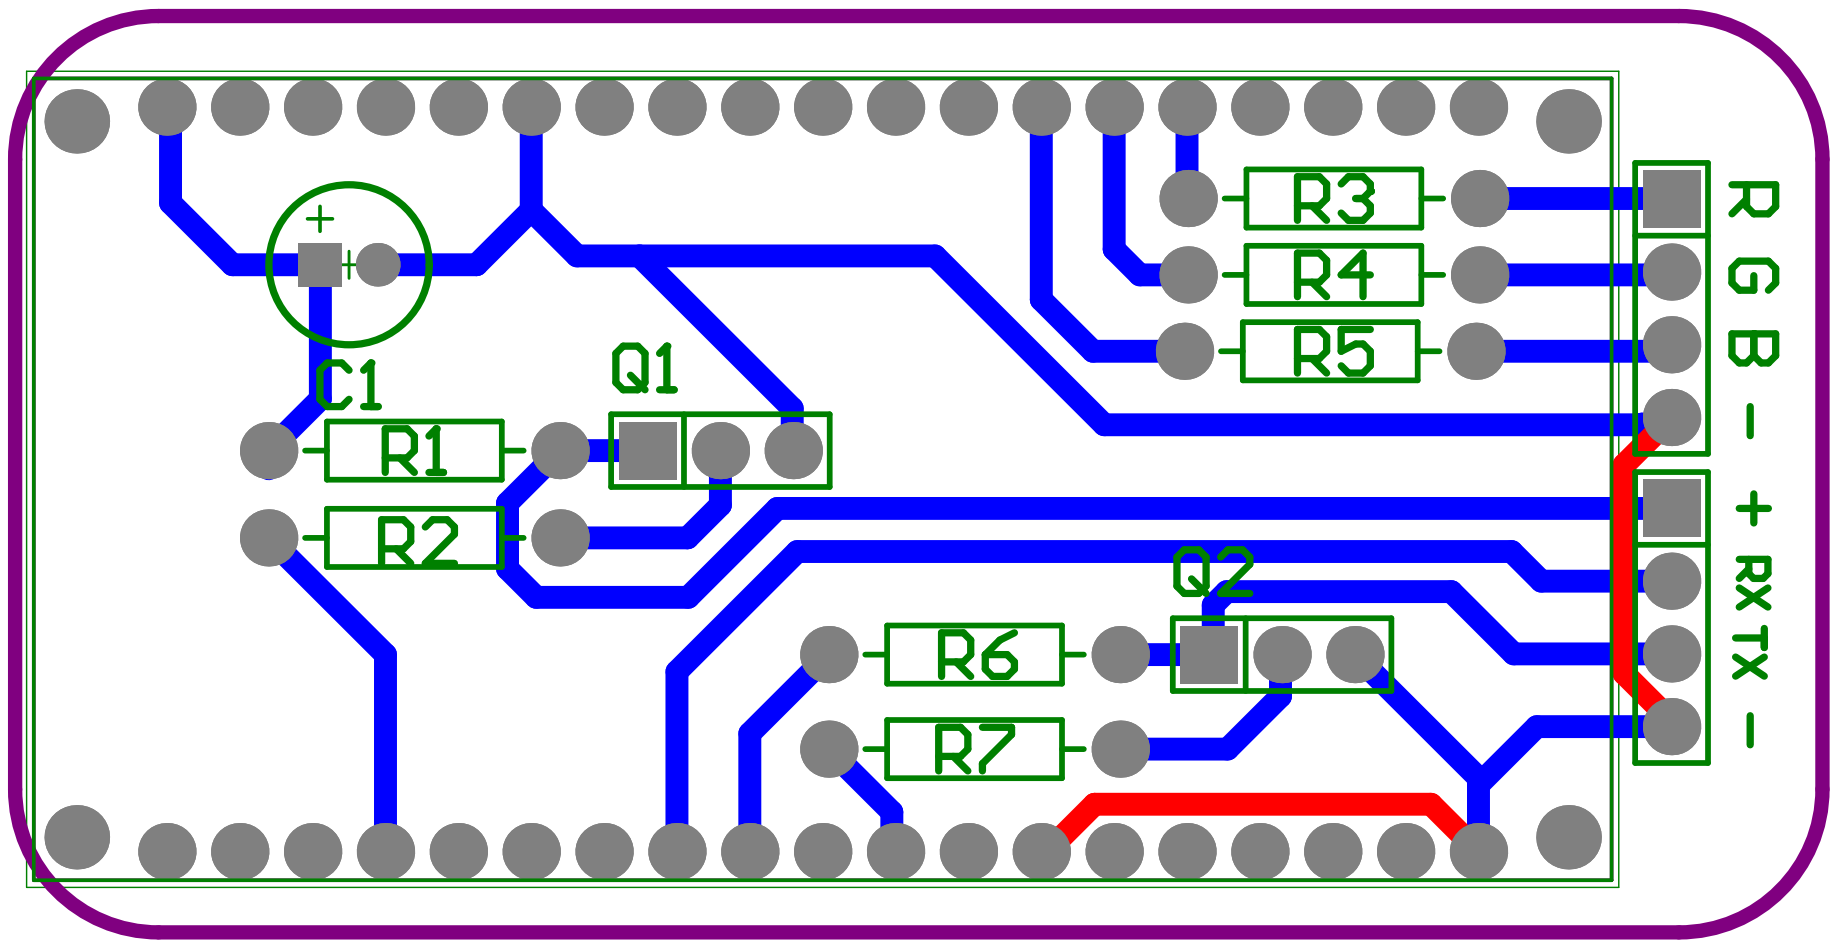
[picture p185: page 3]

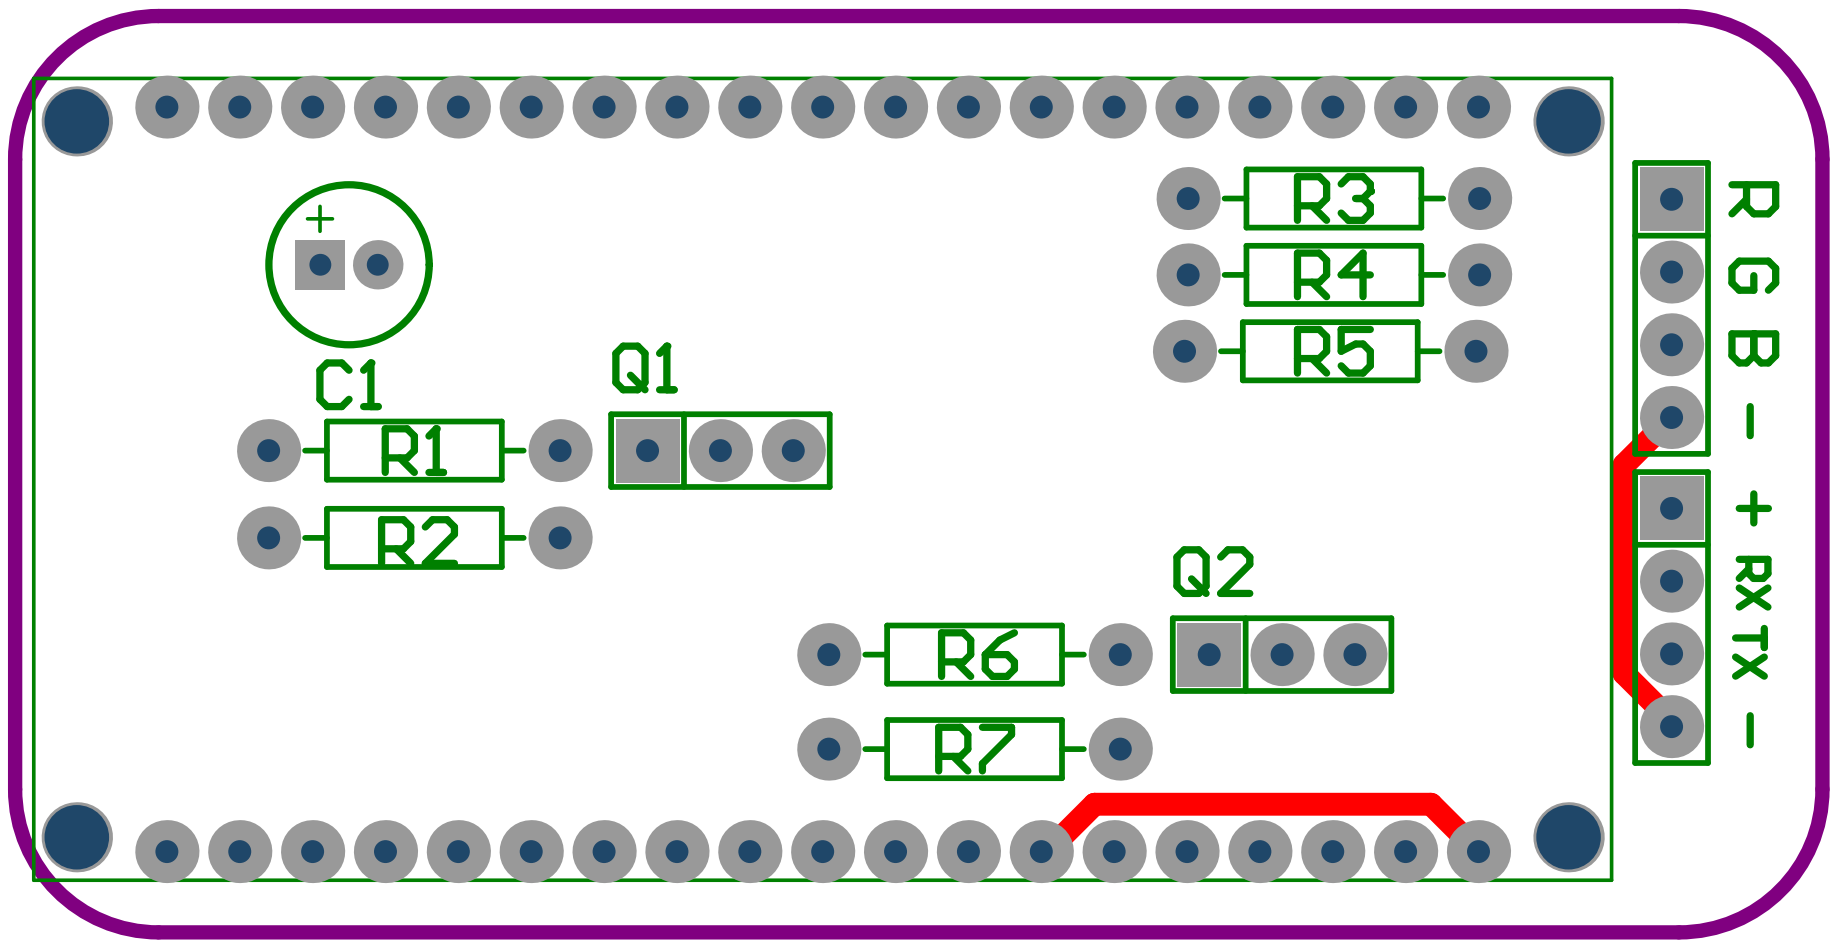
[picture p186: page 4]

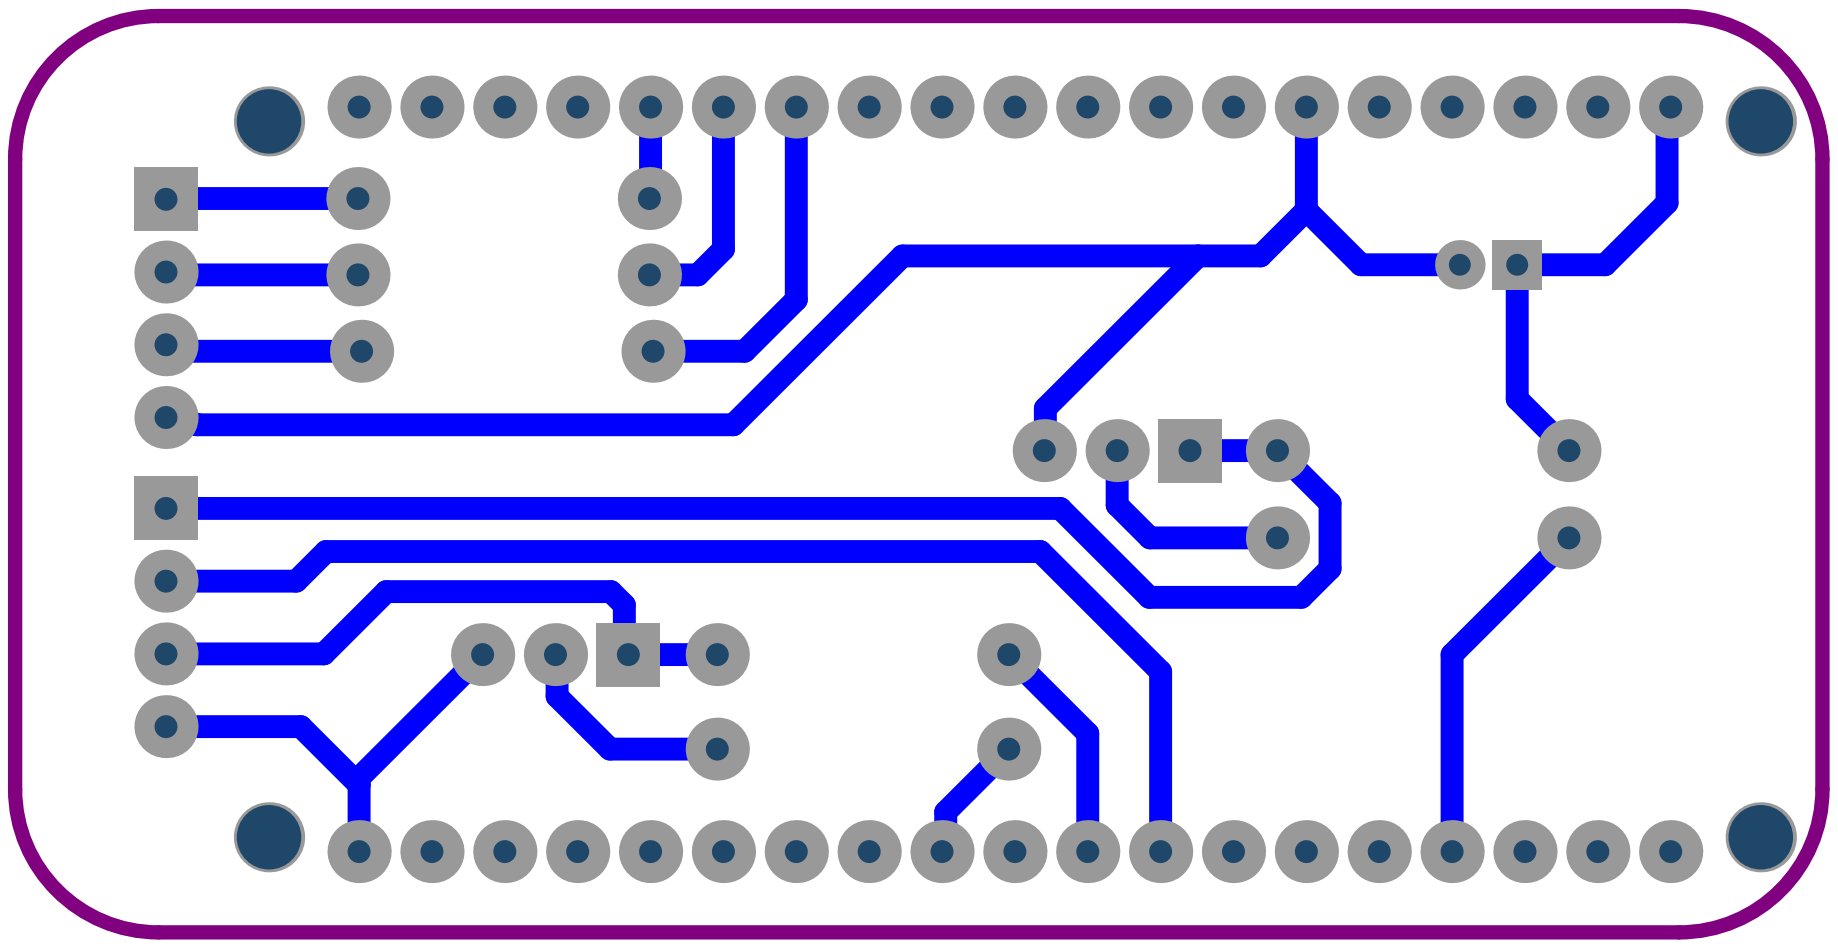
[picture p187: page 5]

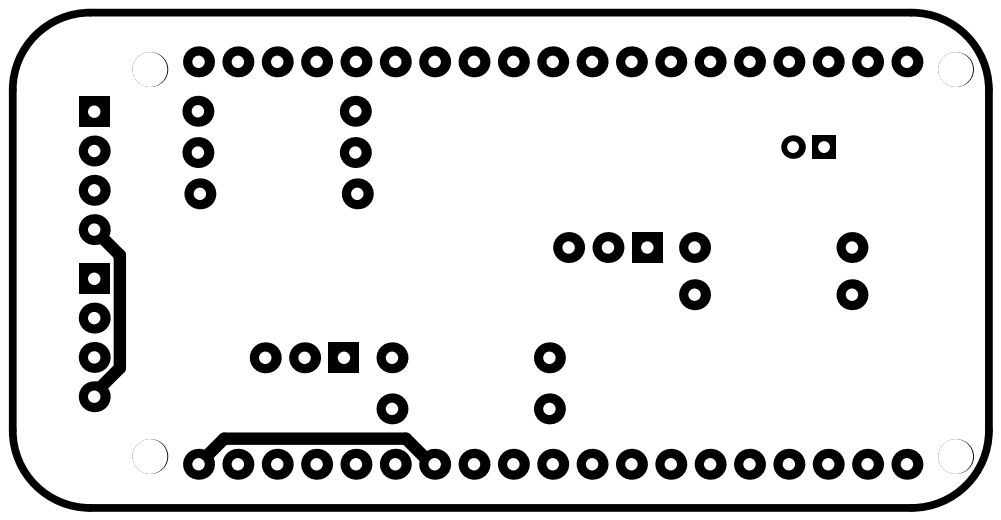
[picture p188: page 6]

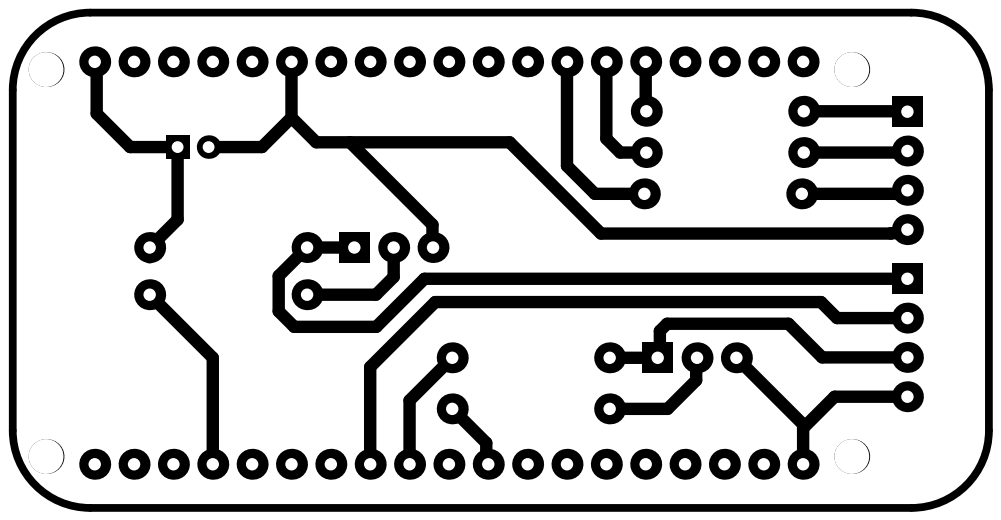
[picture p189: page 7]

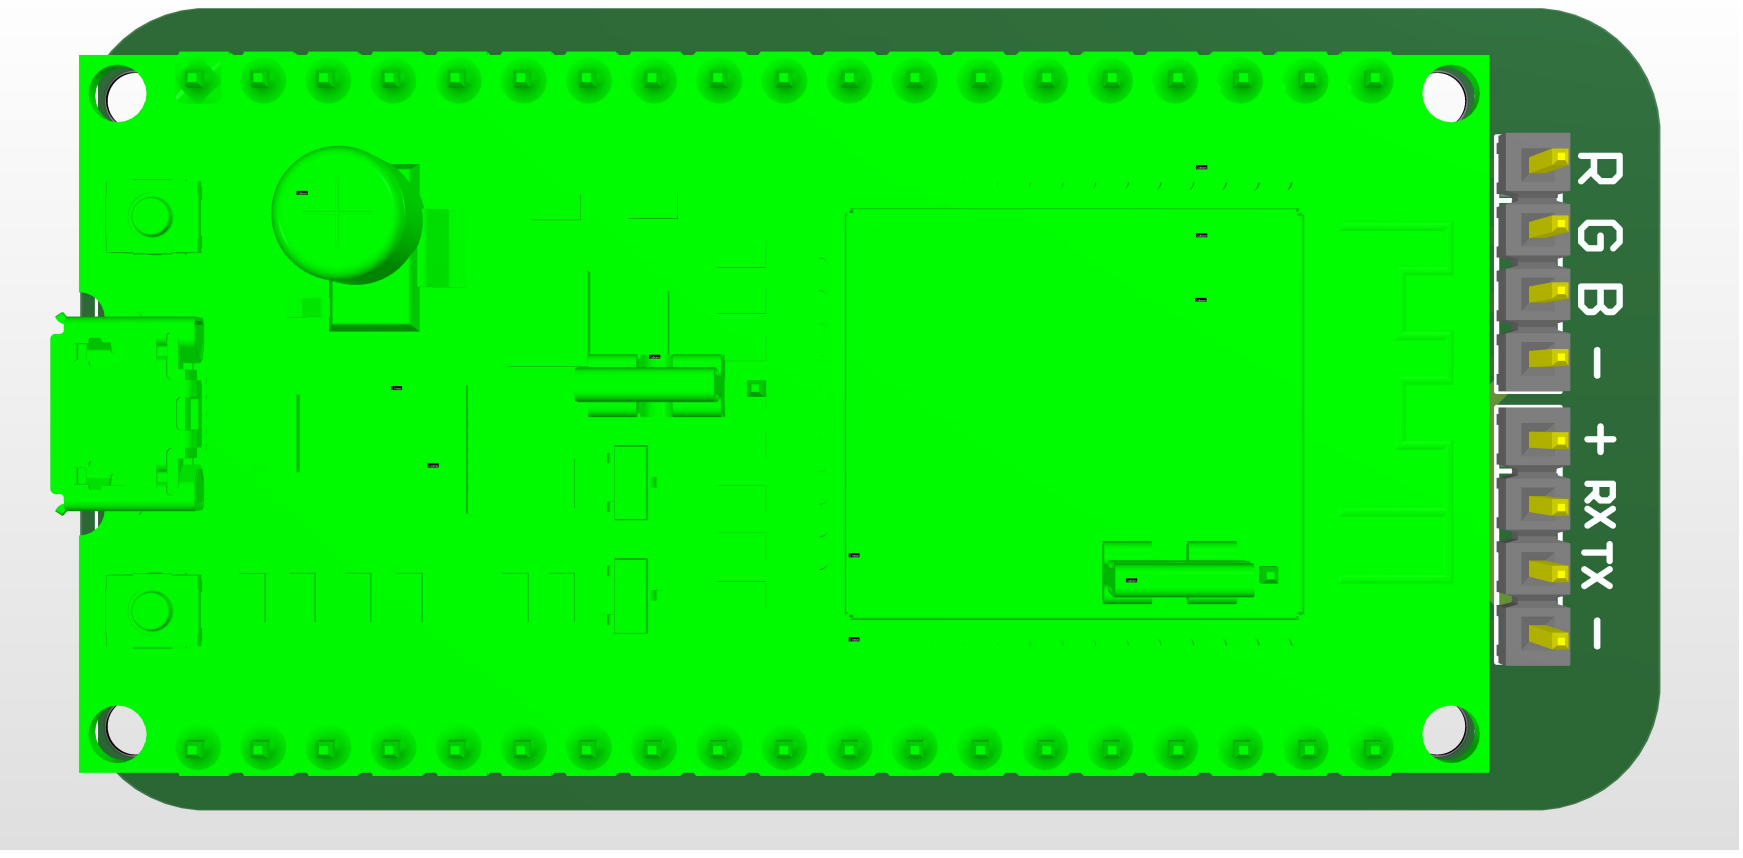
[picture p190: page 8]

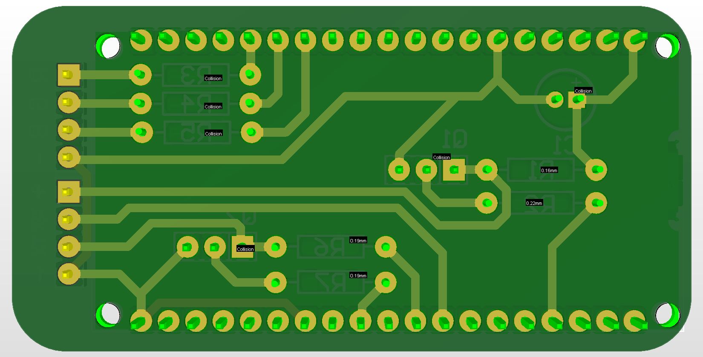
[picture p191: page 9]
