odevincenti/Wet-DryPenguins/PCB/Tracker_Prototype/Project Outputs for Tracker_Prototype/Logger-V4-Full-OutputJob.PDF

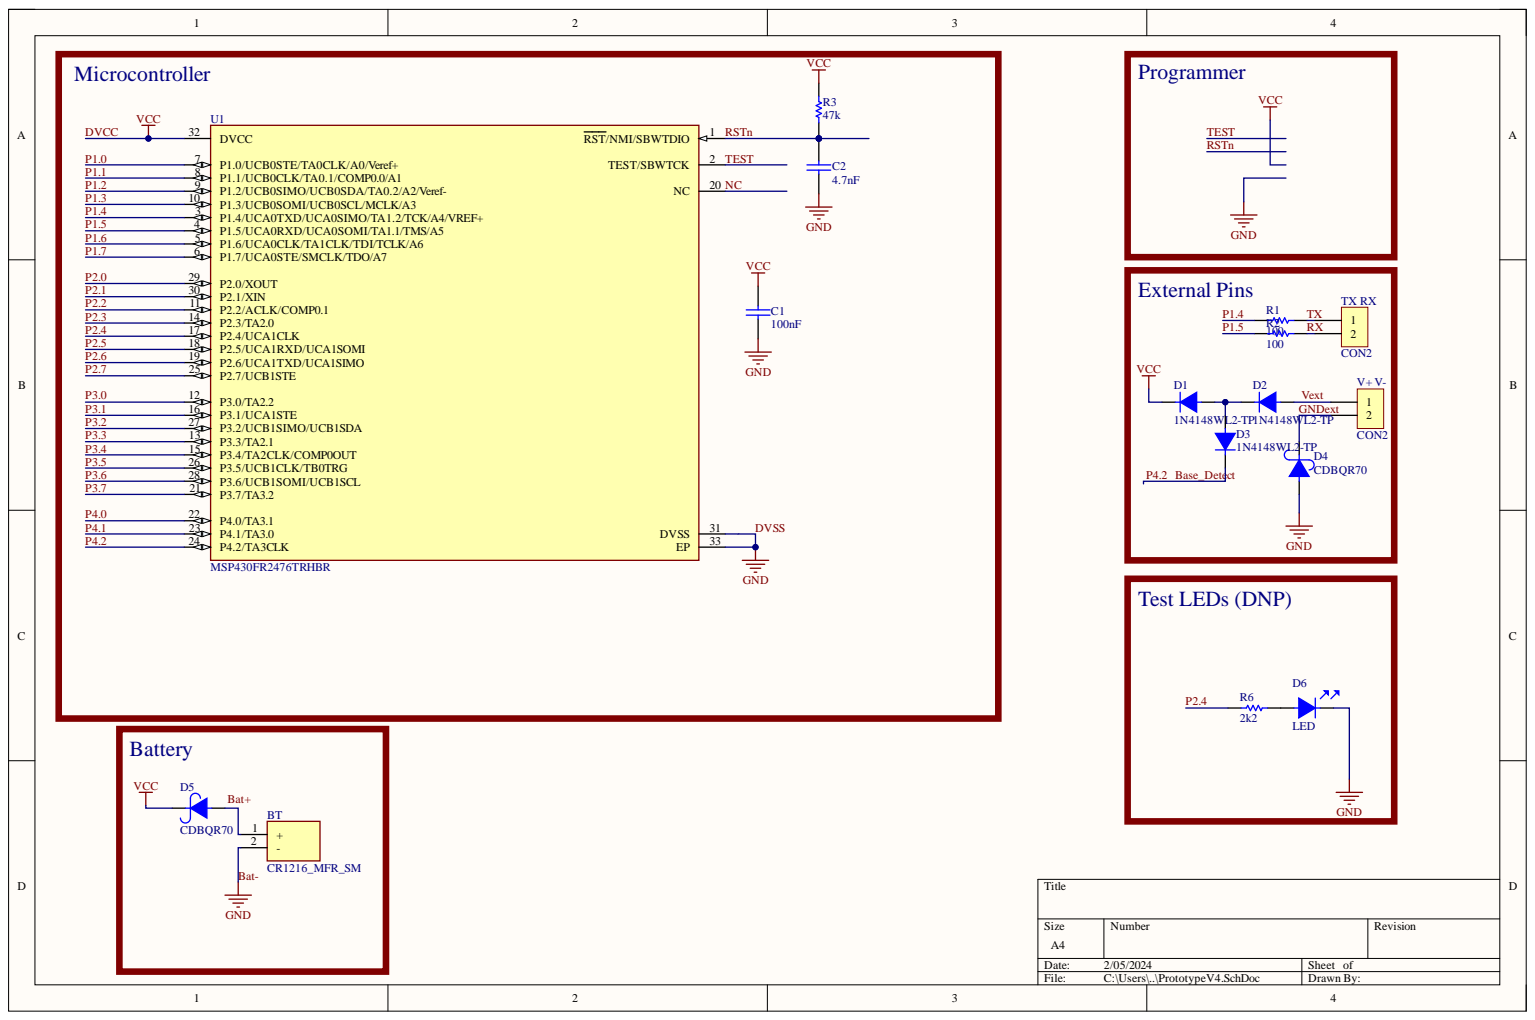
[picture p192: page 1]

Designator | Quantity | Description | Value | Footprint | PartNumber | Digi-Key_Part_Number
BT | 1 Battery | | | CR1216MFRSM
C1 | 1 CL05B104KP5VPNC | | | 0402-A
C2 | 1 C0402C472K5RECAUTO | | | 0402-A
D1, D2, D3 | 3 1N4148WL2-TP | | | 0402-A
D4, D5 | 2 | CDBQR70 DIODESCHOTTKY70V70MA0402 Current - ReverseLeakage@Vr 100nA@50V | | 0402-A
D6 | 1 LEDGREEN CLEAR2012SMD | | | 0805
R1, R2 | 2 RC0402FR-07100RL | | | 0402-A
R3 | 1 ERJ-2GEJ473X | | | 0402-A
R6 | 1 RC0402FR-072K2L | | | 0402-A
TXRX, V+ V- | 2 | | | SIP2
U1 | 1 IC MCU16BIT64.5KBFRAM32VQFN | | | FP-RHB0032E-IPC_A

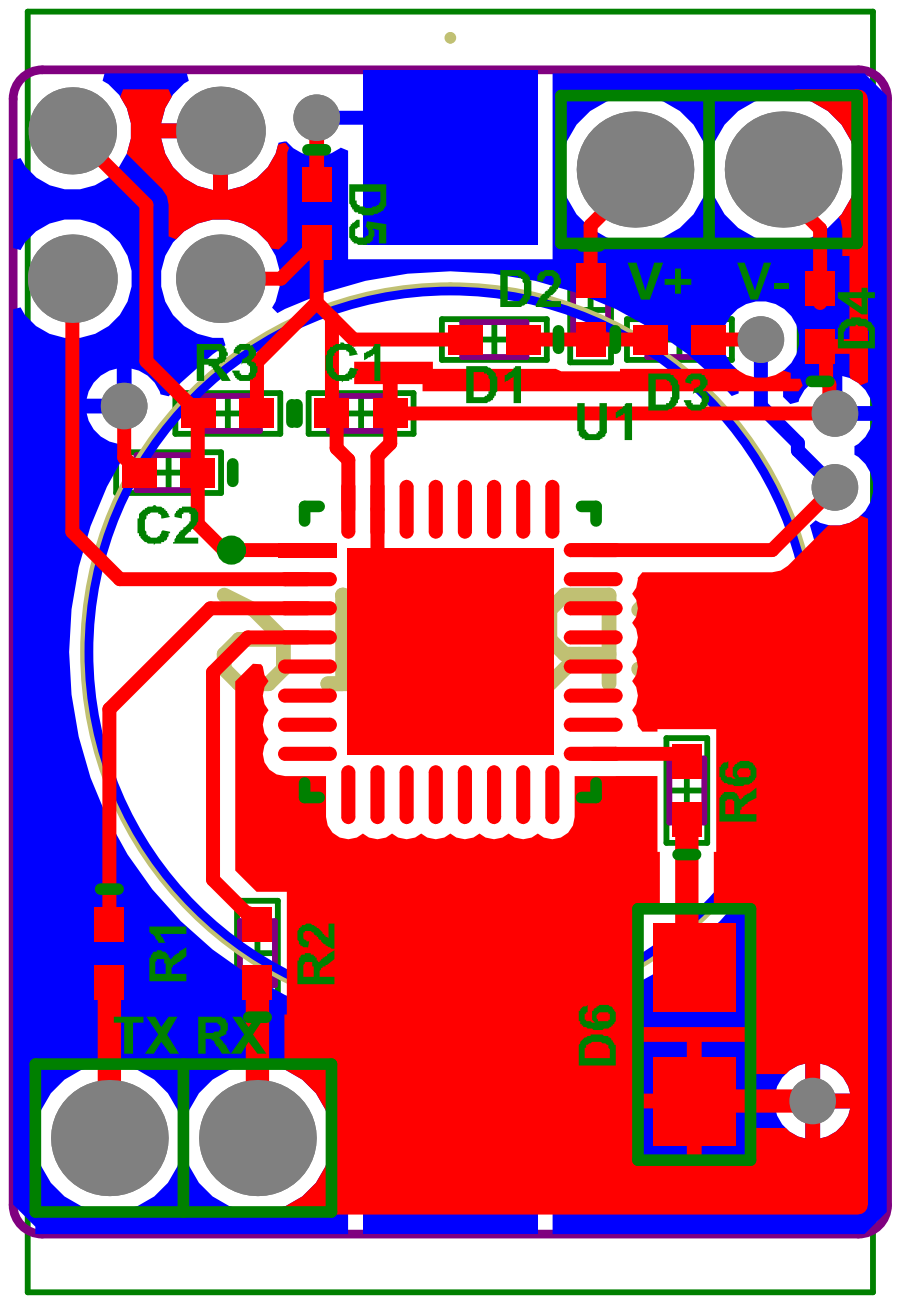
[picture p193: page 3]

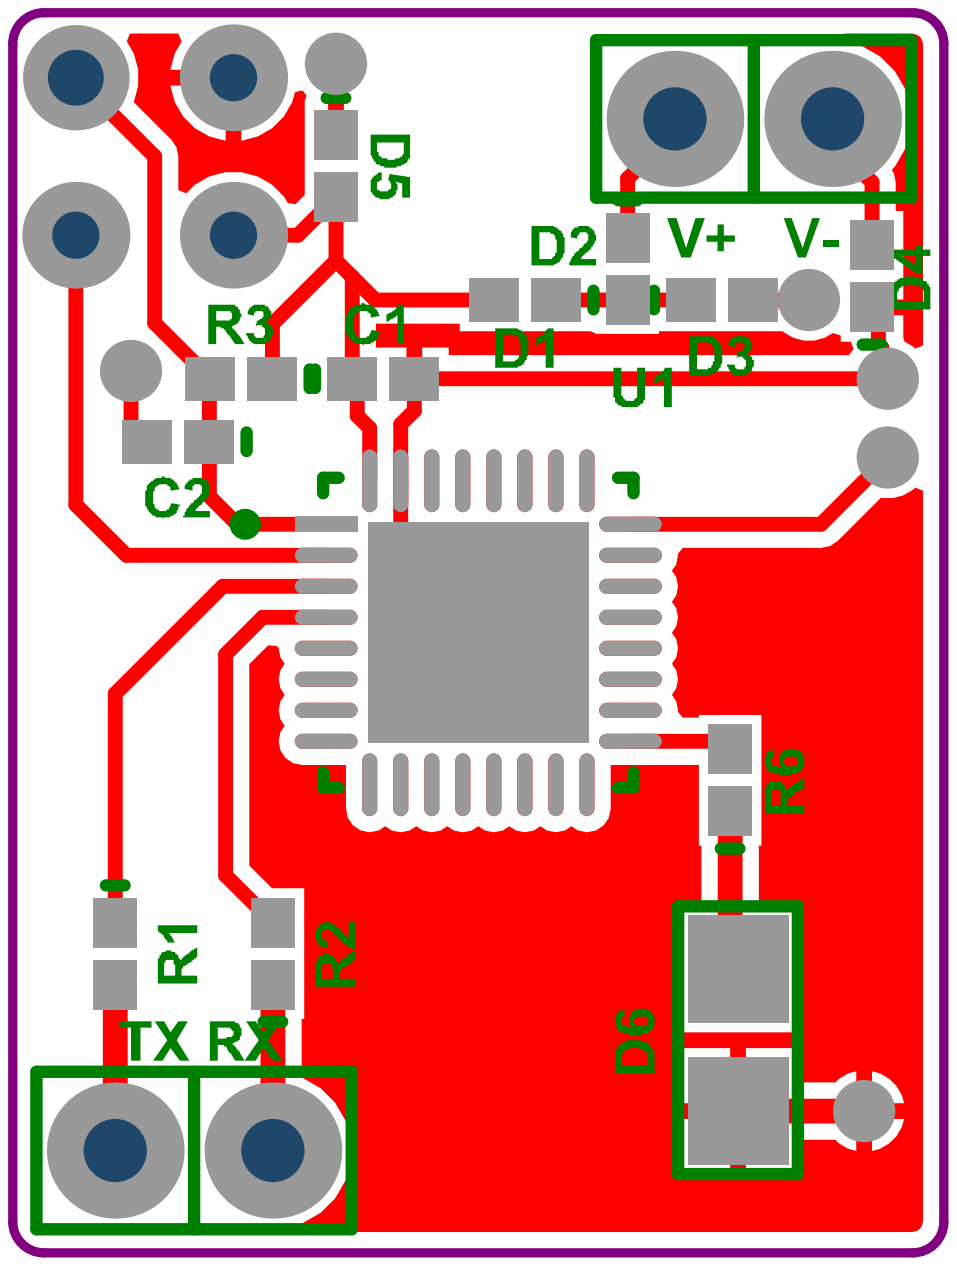
[picture p194: page 4]

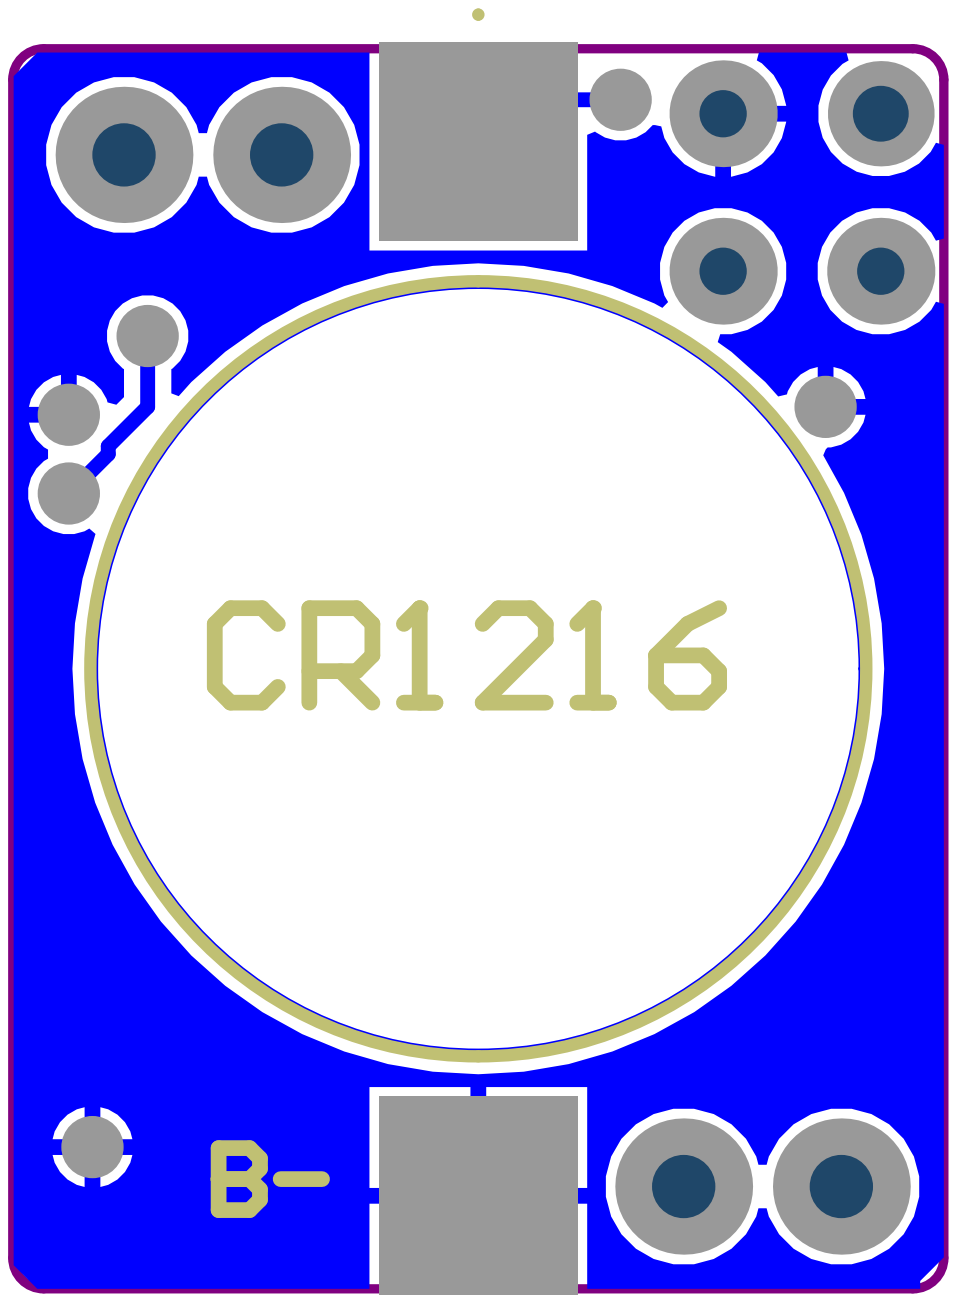
[picture p195: page 5]

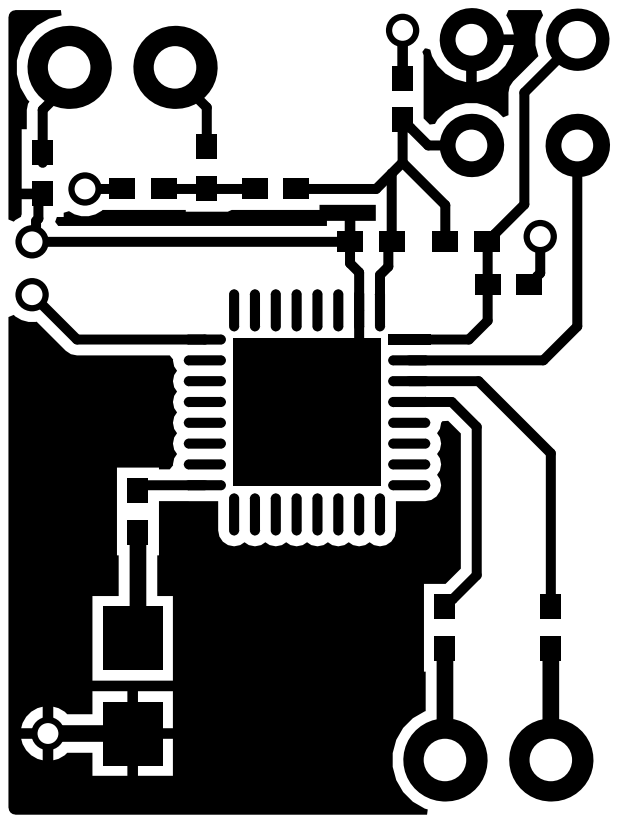
[picture p196: page 6]

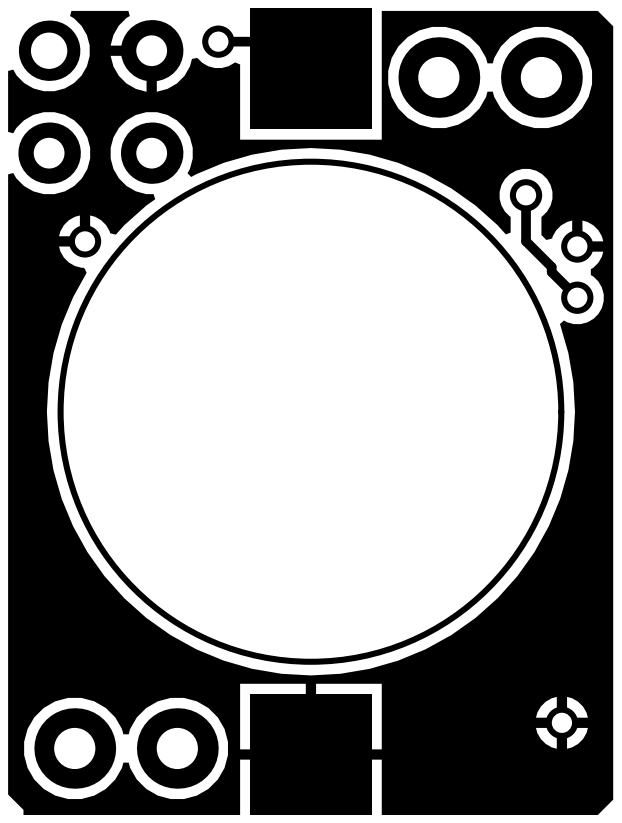
[picture p197: page 7]

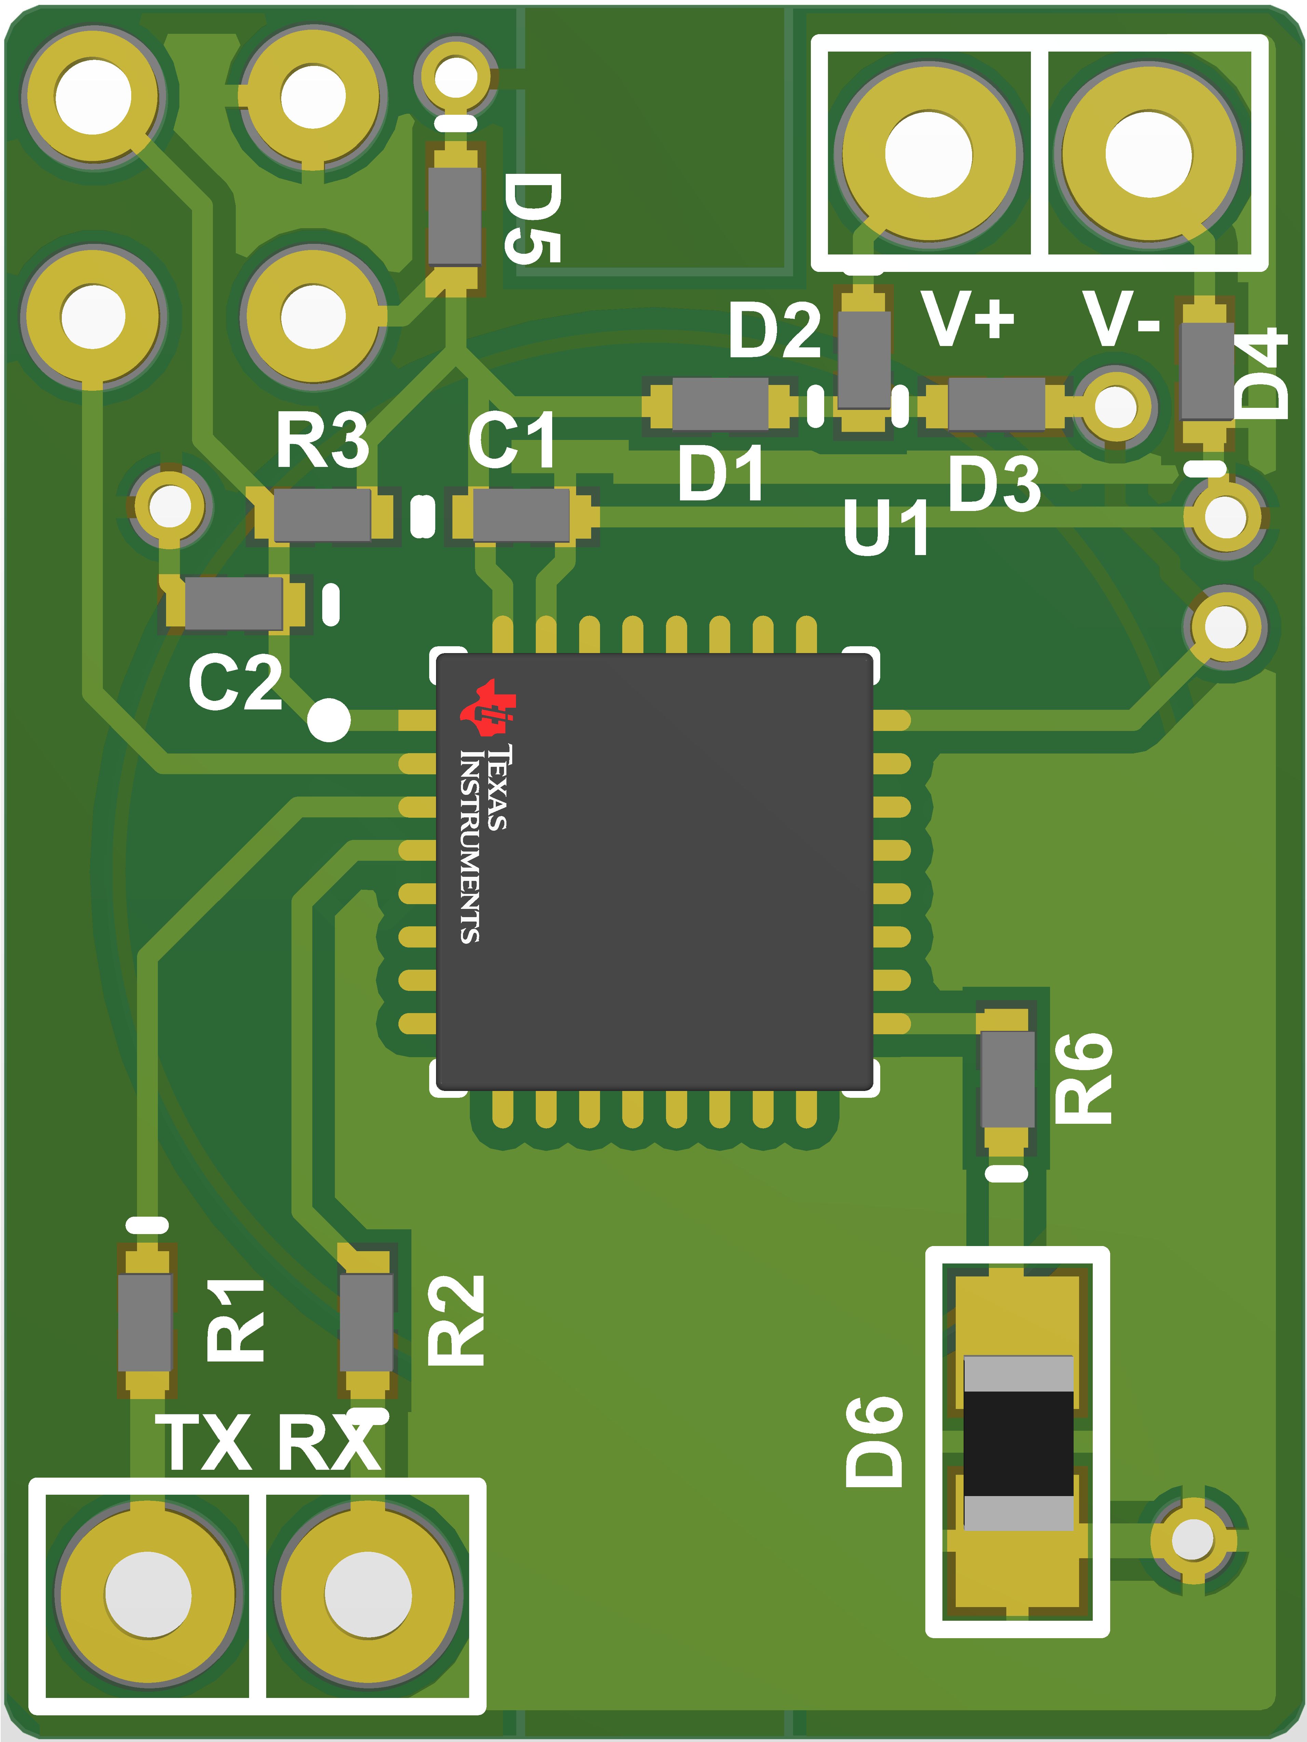
[picture p198: page 8]

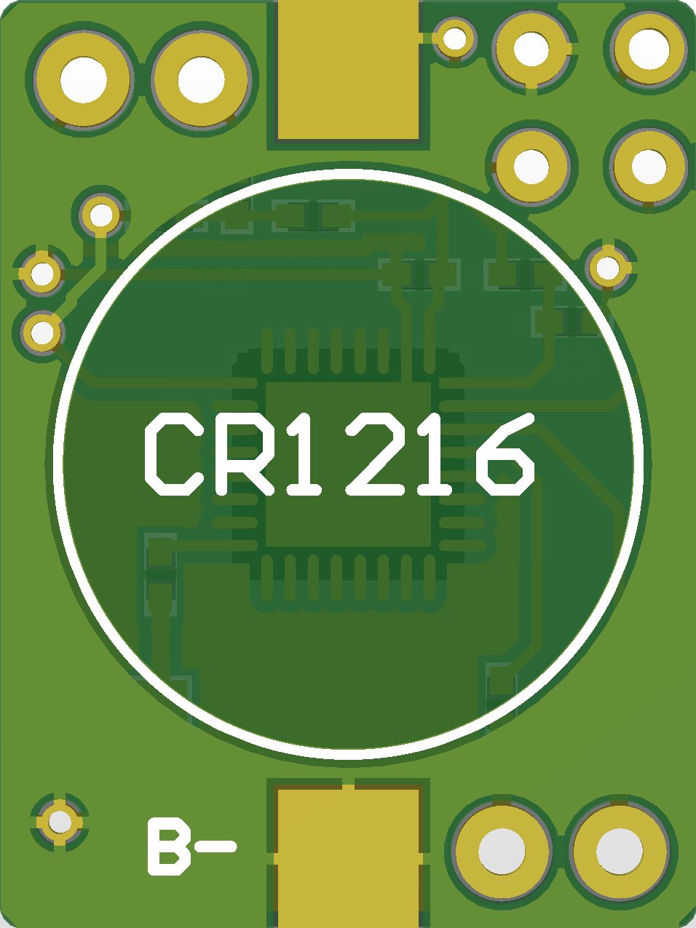
[picture p199: page 9]
