odevincenti/Wet-DryPenguins/Documentación/Modelos 3D/3D_Base_bottom.PDF

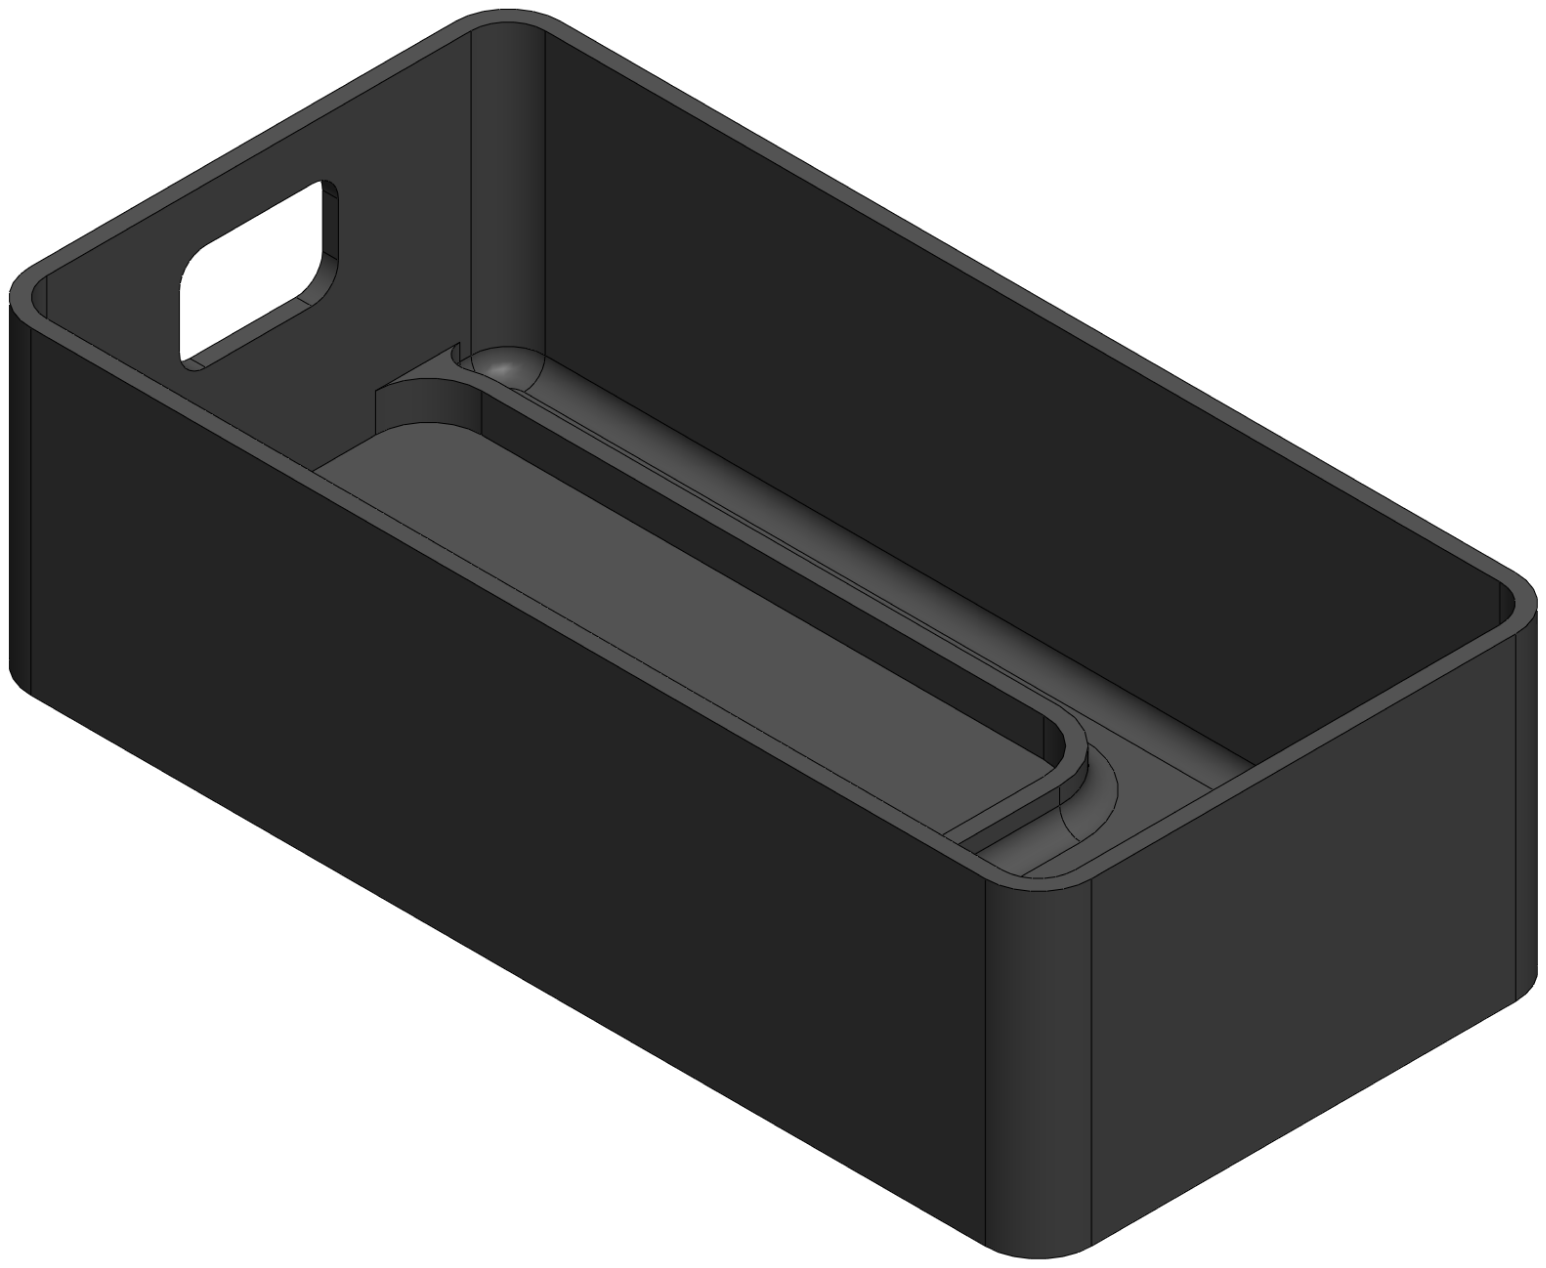
[picture p200: page 1]
