odevincenti/Wet-DryPenguins/Documentación/Modelos 3D/3D_Base_top_clipper_V2.PDF

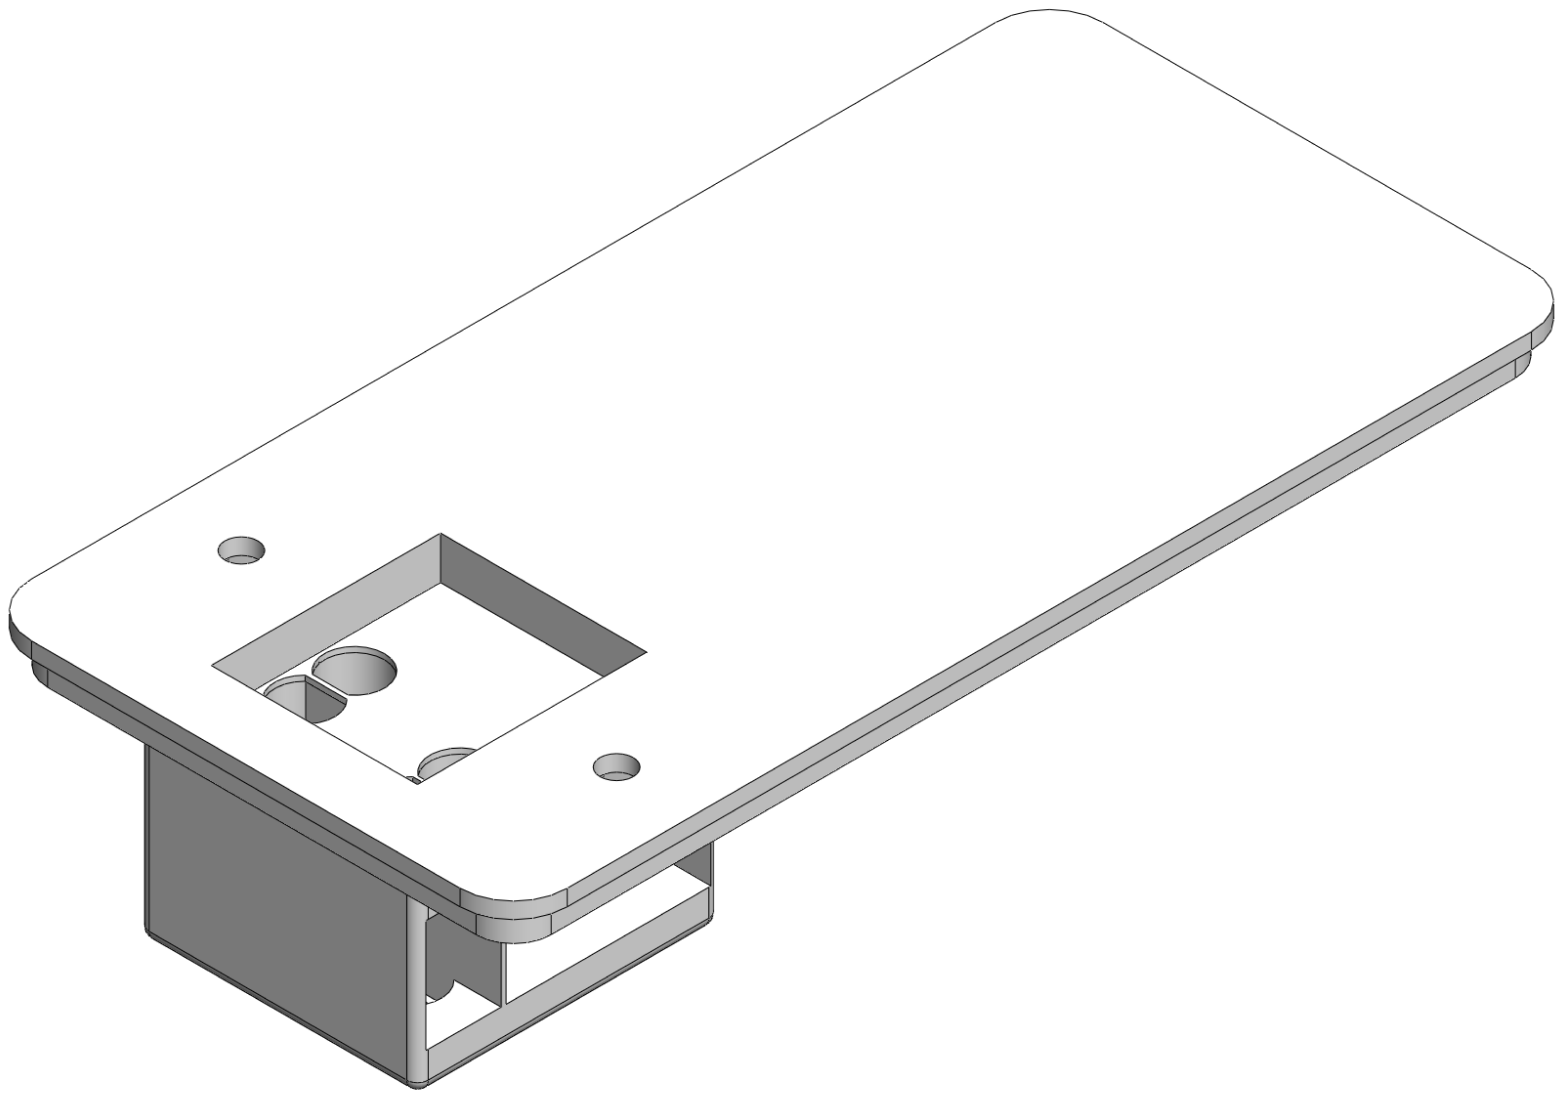
[picture p201: page 1]
