odevincenti/Wet-DryPenguins/Documentación/Modelos 3D/3D_Base_top_clipper_V2_bot.PDF

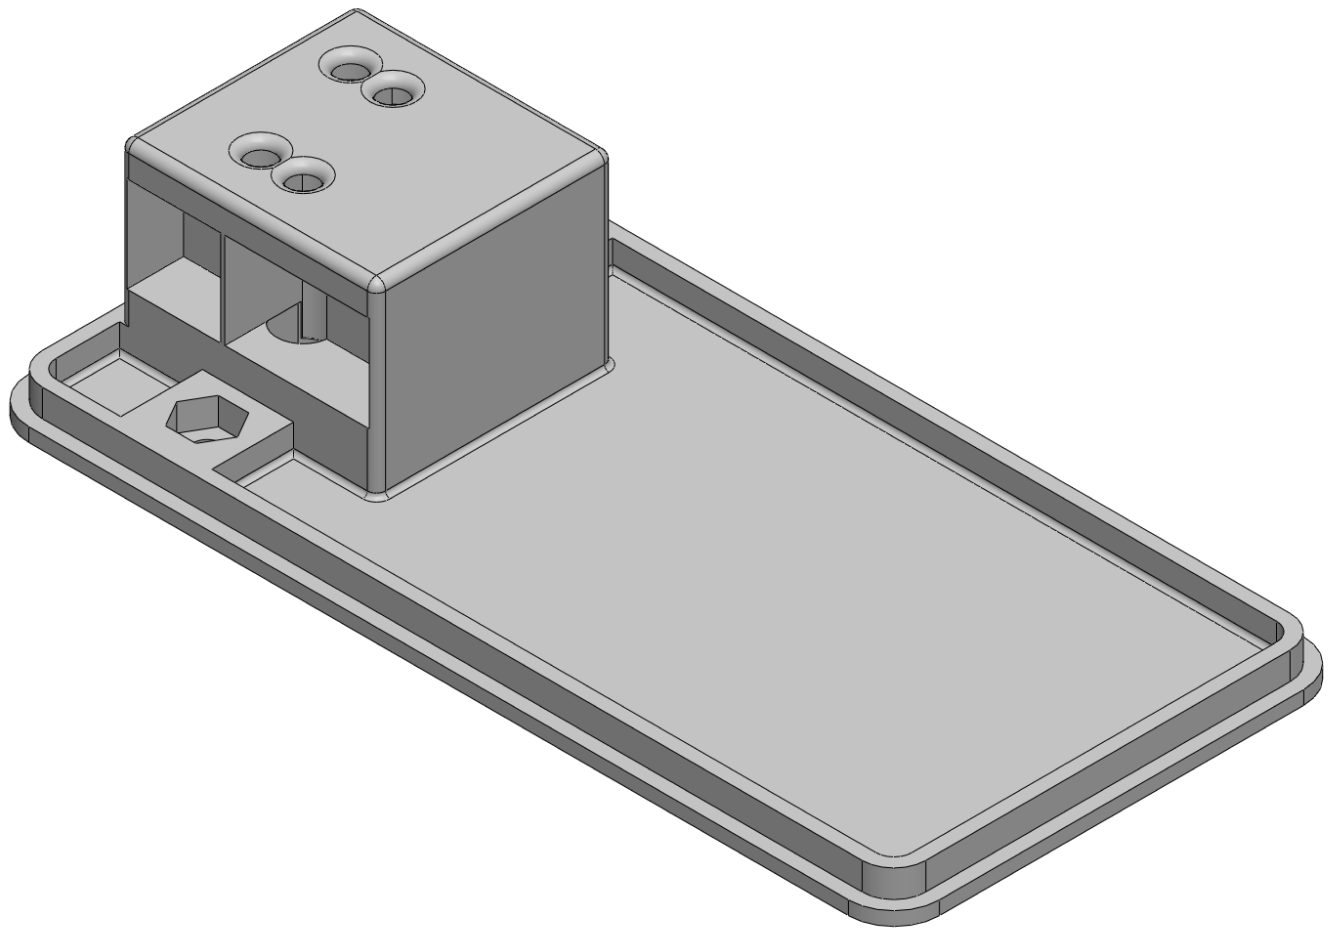
[picture p202: page 1]
