odevincenti/Wet-DryPenguins/Documentación/Diagramas y Gráficos/Notas_Molde.pdf

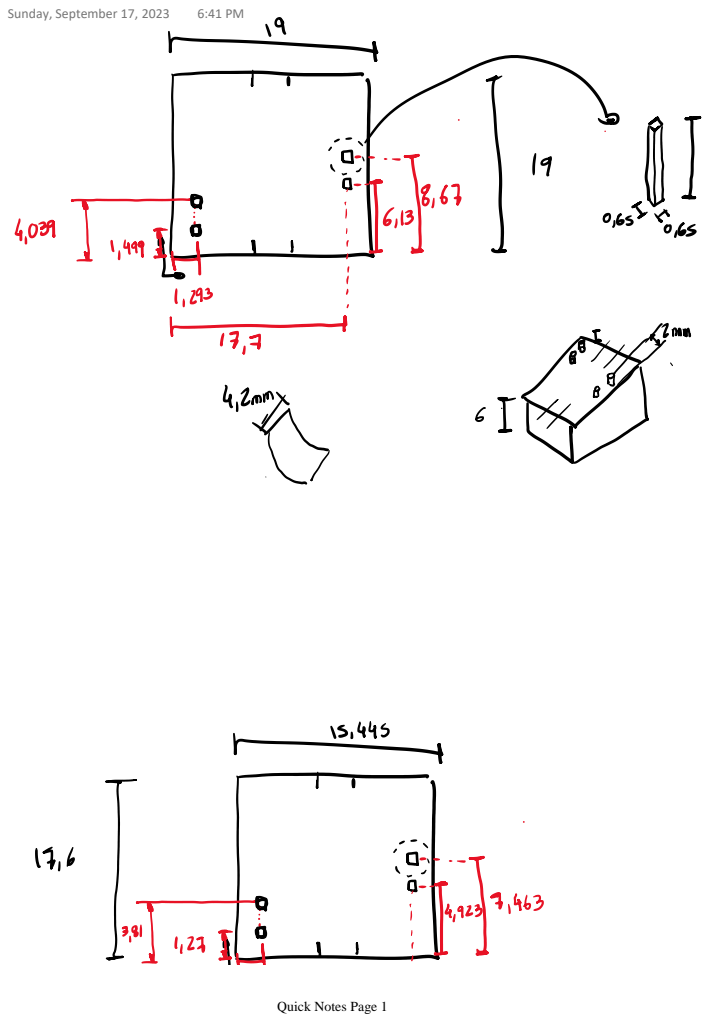
[picture p203: page 1]
Sunday, September 17, 2023

Quick Notes Page 1

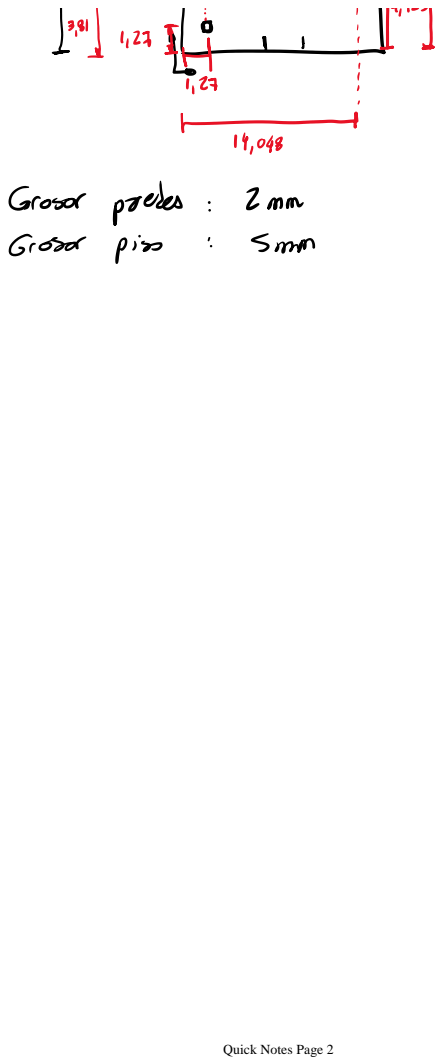
[picture p204: page 2]

Quick Notes Page 2
