odevincenti/Wet-DryPenguins/PCB/Tracker_Prototype/prototypeV3_bottom.pdf

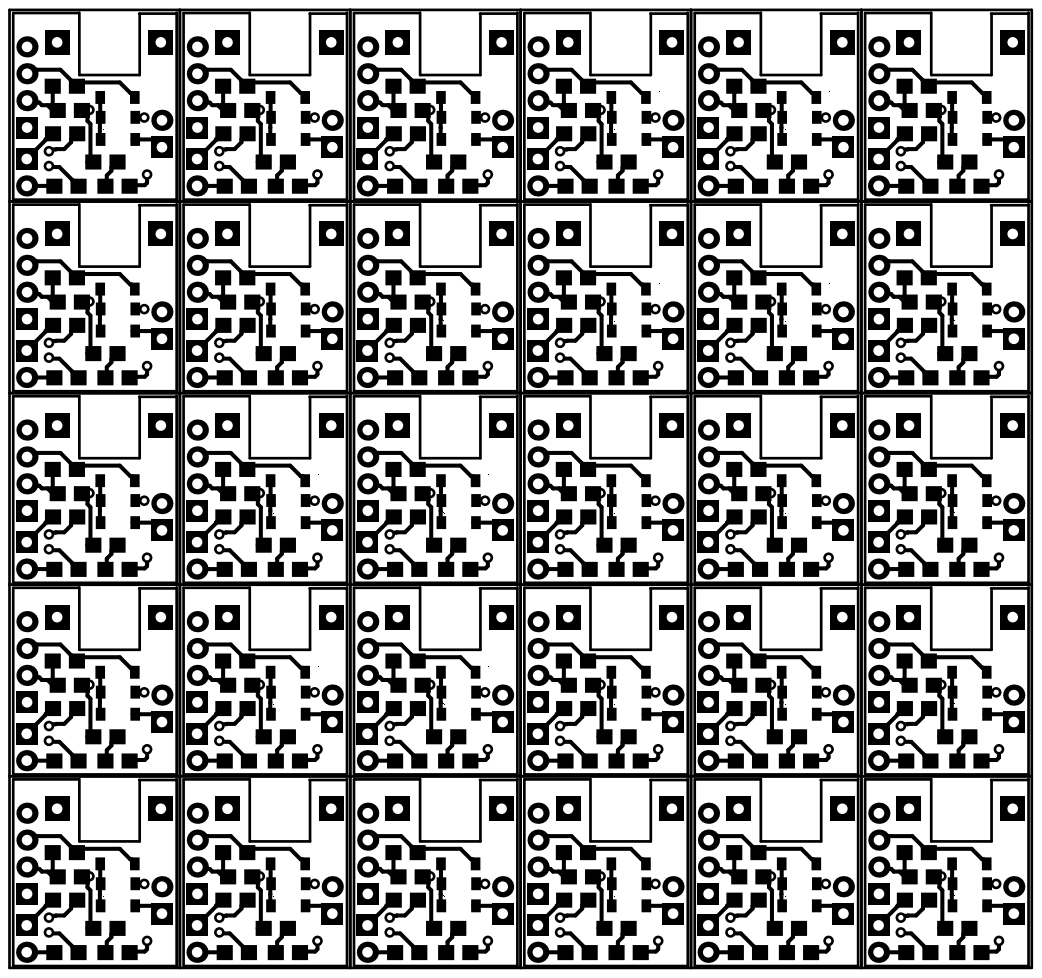
[picture p205: page 1]
