odevincenti/Wet-DryPenguins/PCB/Tracker_Prototype/prototypeV3_top.pdf

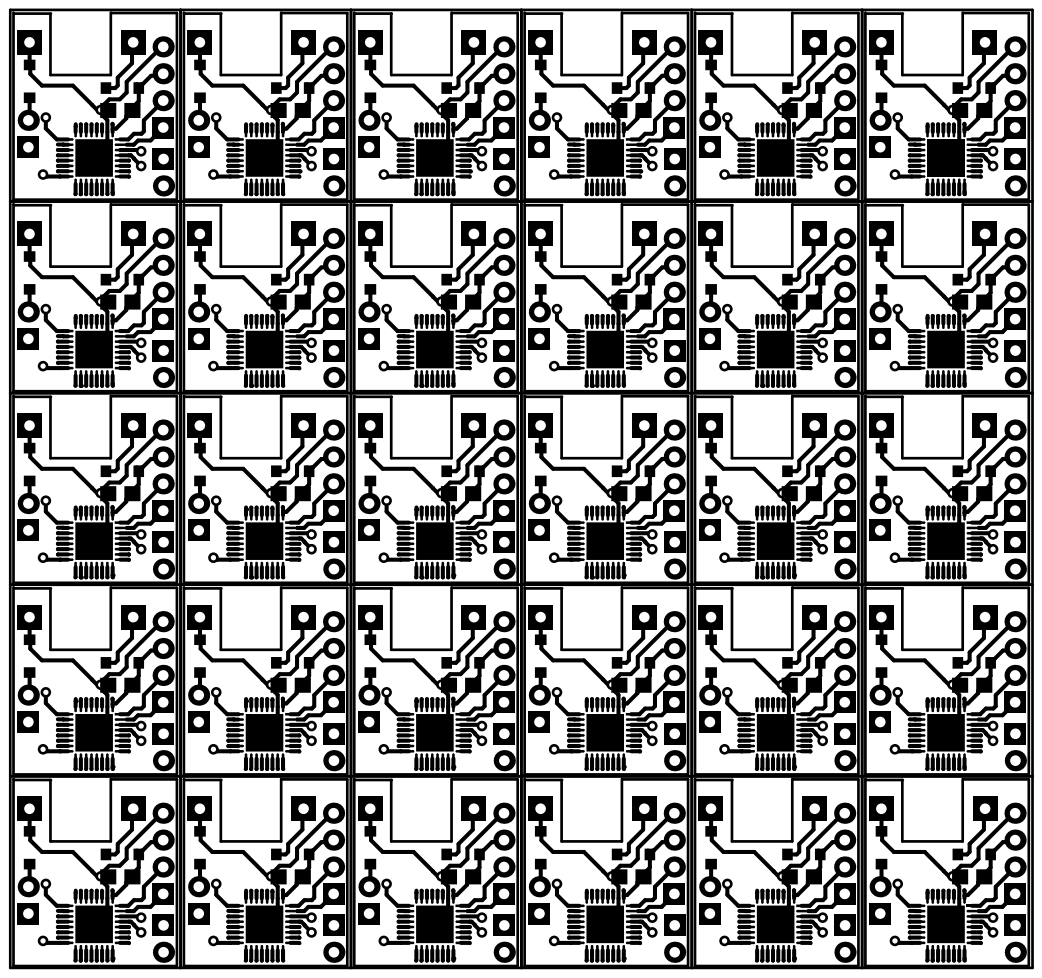
[picture p206: page 1]
