odevincenti/Wet-DryPenguins/PCB/Tracker_Prototype/prototype_reference_top.pdf

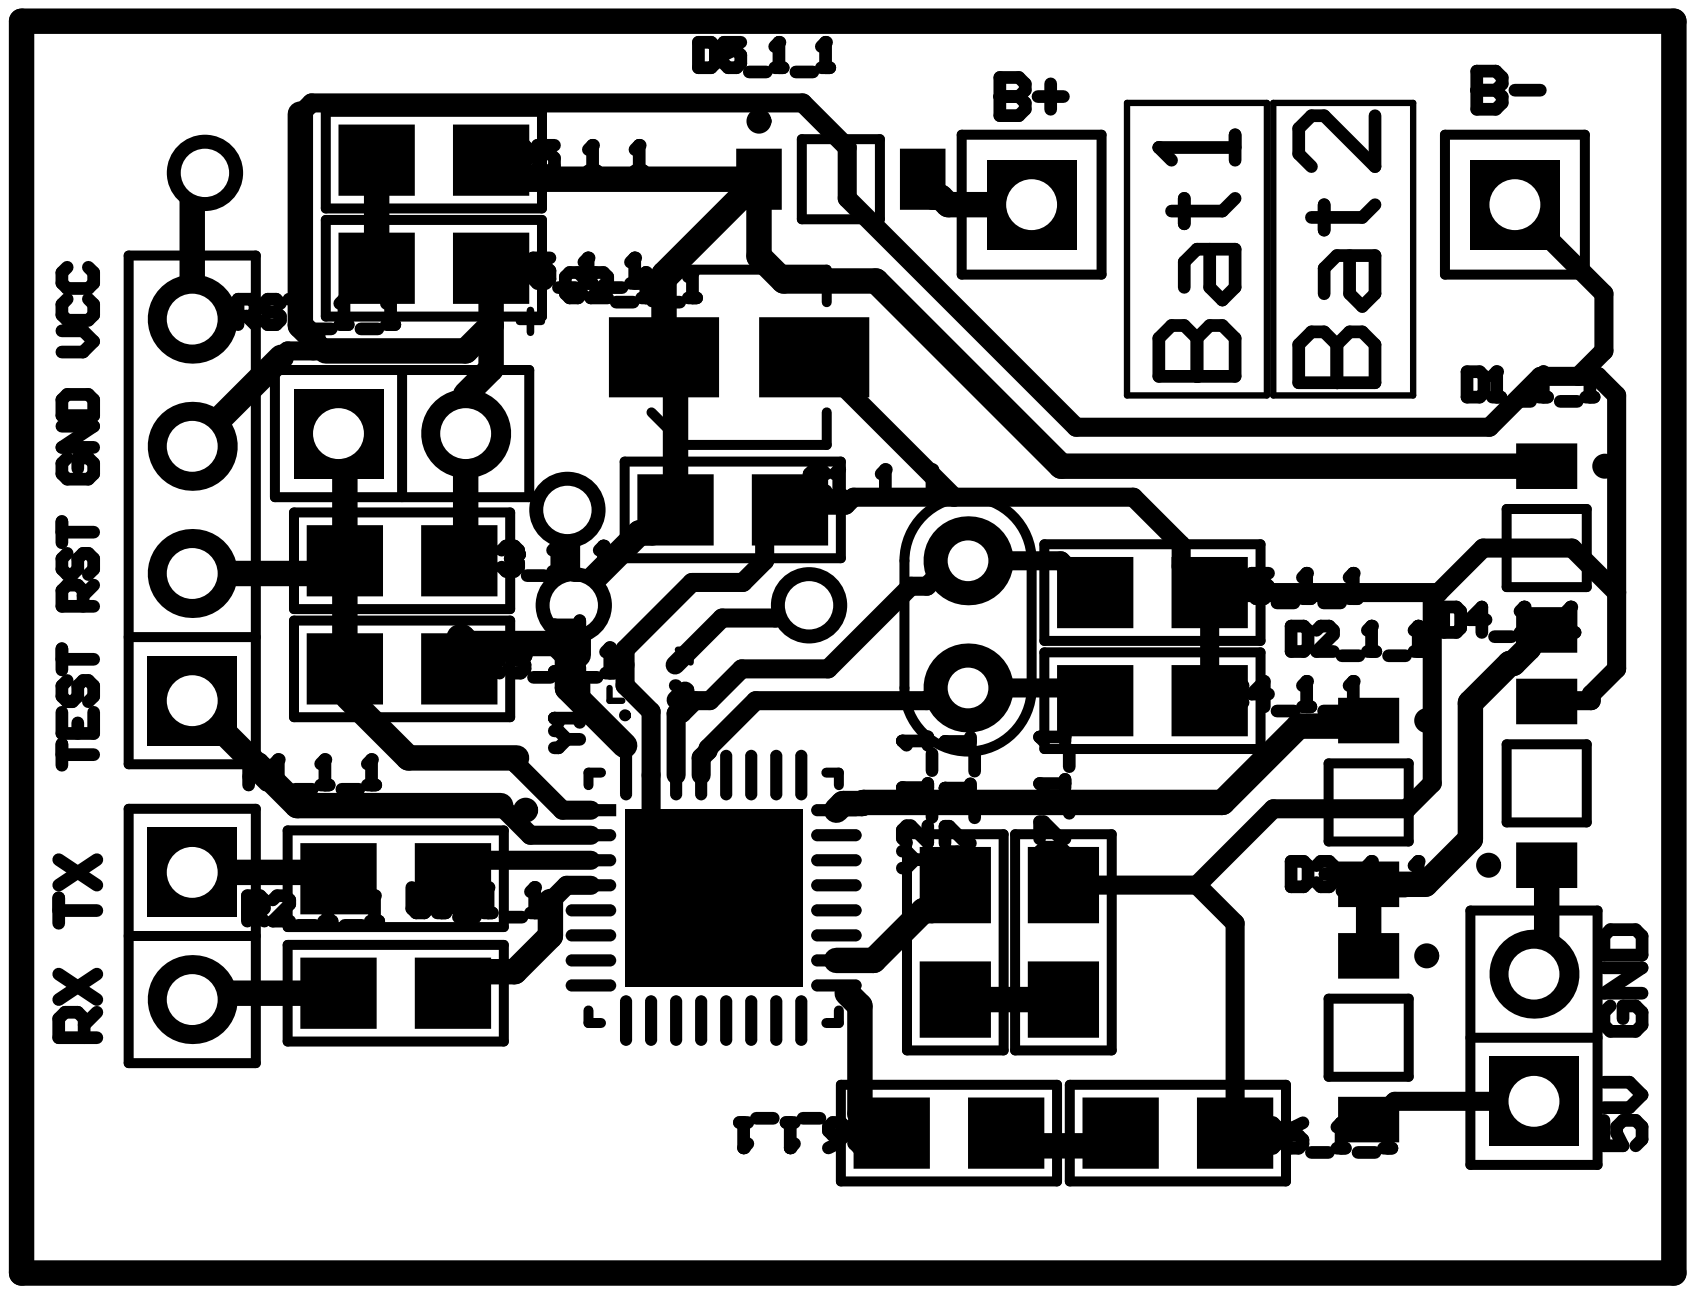
[picture p207: page 1]
