odevincenti/Wet-DryPenguins/PCB/Tracker_Prototype/prototype_schem.pdf

Microcontroller | Programmer

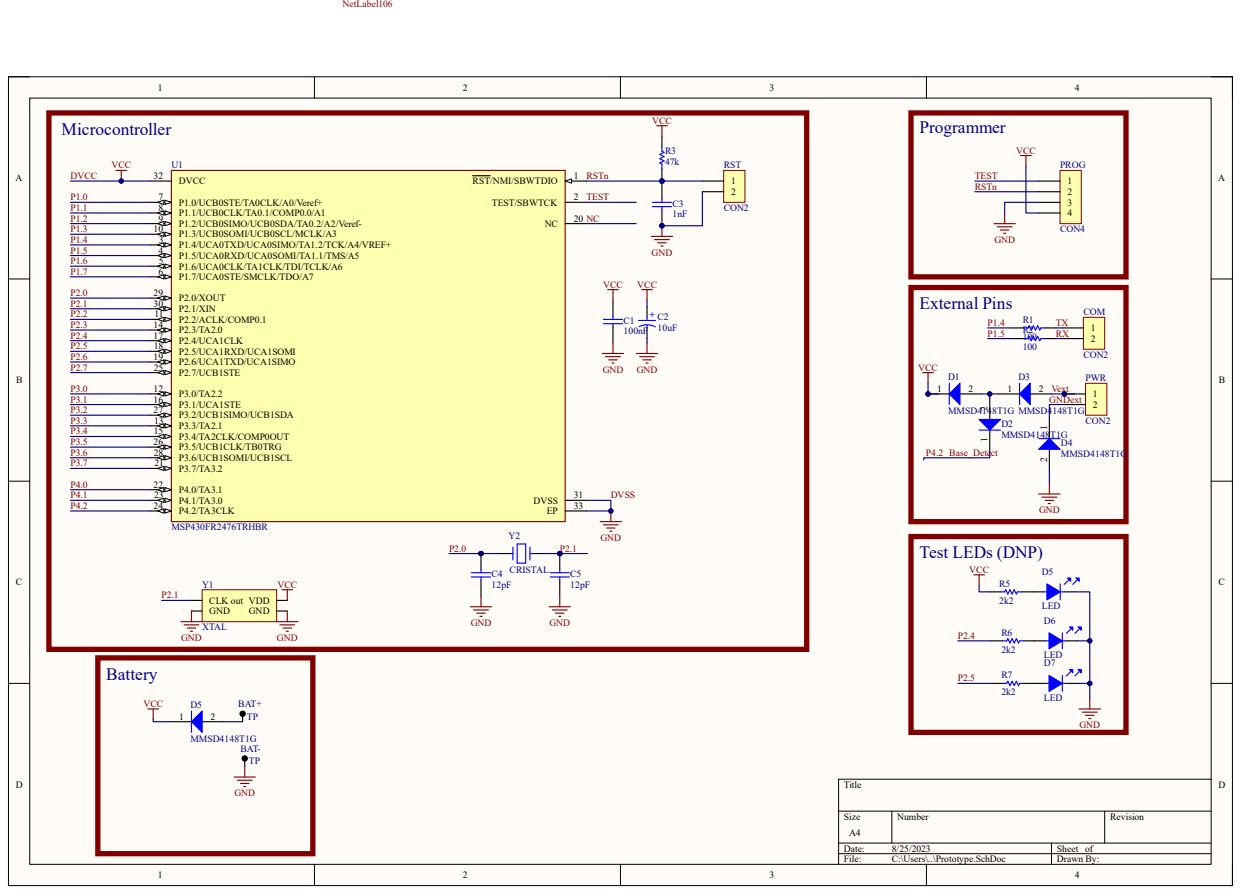
[picture p208: page 1]
