odevincenti/Wet-DryPenguins/PCB/Tracker_Prototype/xtal_tht_top.pdf

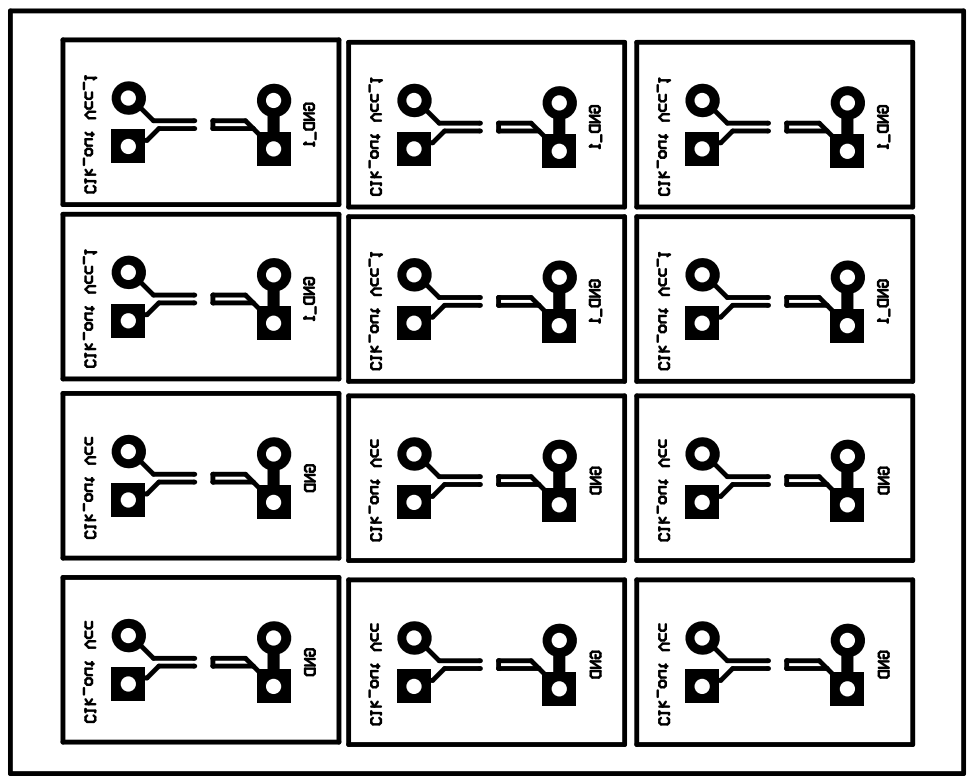
[picture p209: page 1]
