odevincenti/Wet-DryPenguins/PCB/Adapters/Adapters_Bottom.pdf

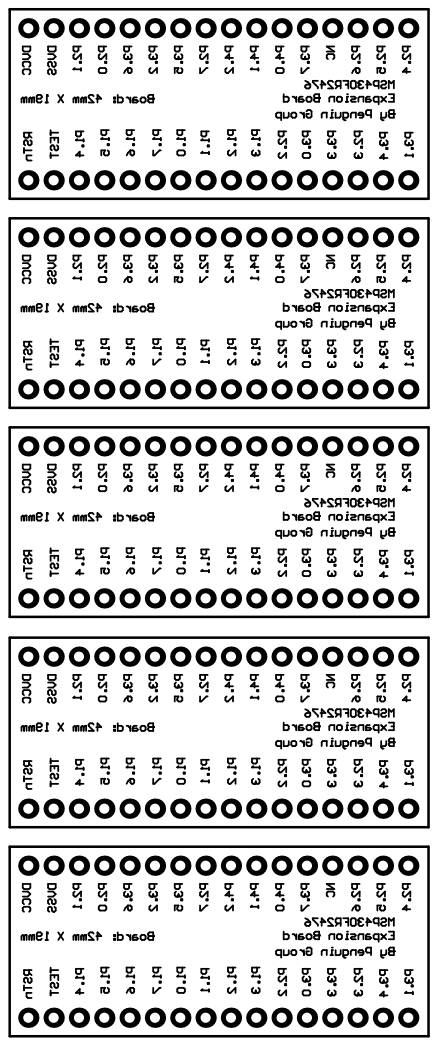
[picture p210: page 1]
