odevincenti/Wet-DryPenguins/PCB/Adapters/Adapters_Top.pdf

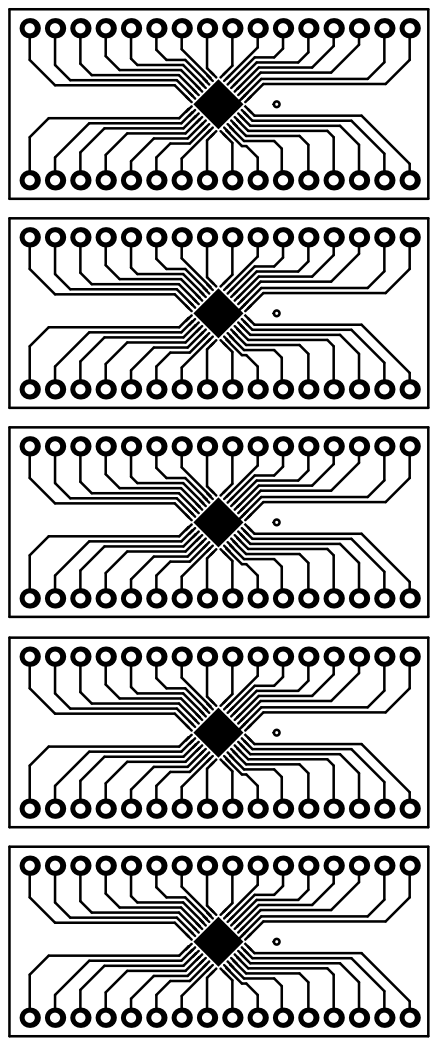
[picture p211: page 1]
