odevincenti/Wet-DryPenguins/PCB/Penguin Base/Project Outputs for Penguin Base/PCB-Base-ESP32.PDF

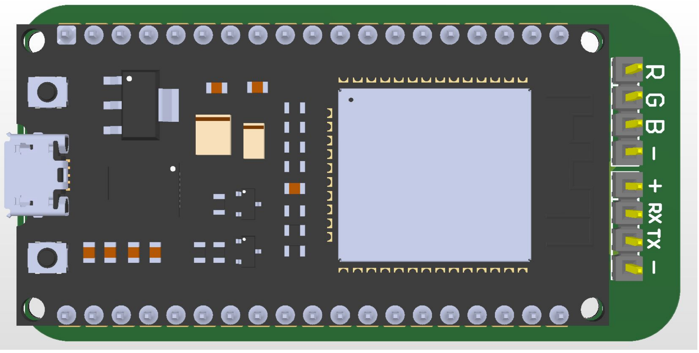
[picture p212: page 1]
