odevincenti/Wet-DryPenguins/PCB/Penguin Base/Project Outputs for Penguin Base/PCB-Base-No-ESP32.PDF

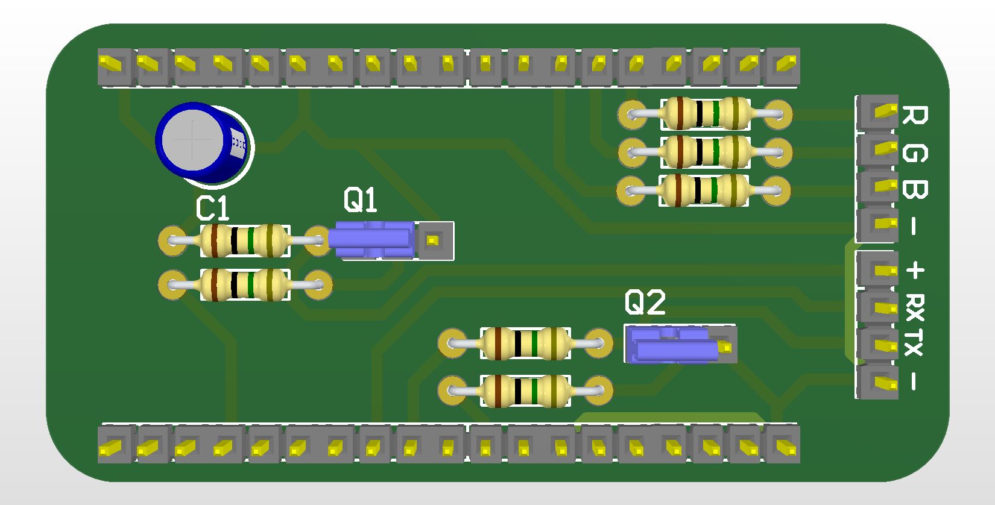
[picture p213: page 1]
