odevincenti/Wet-DryPenguins/PCB/Tracker_Prototype/Project Outputs for Tracker_Prototype/PCB-Logger-V3.PDF

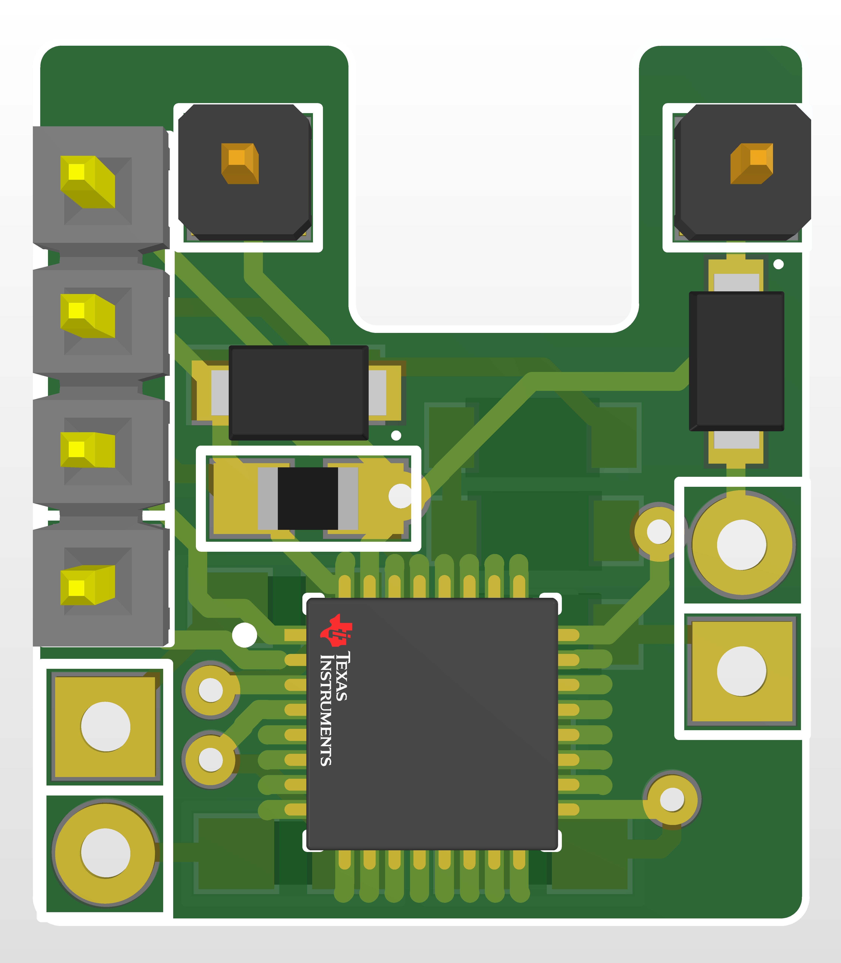
[picture p214: page 1]

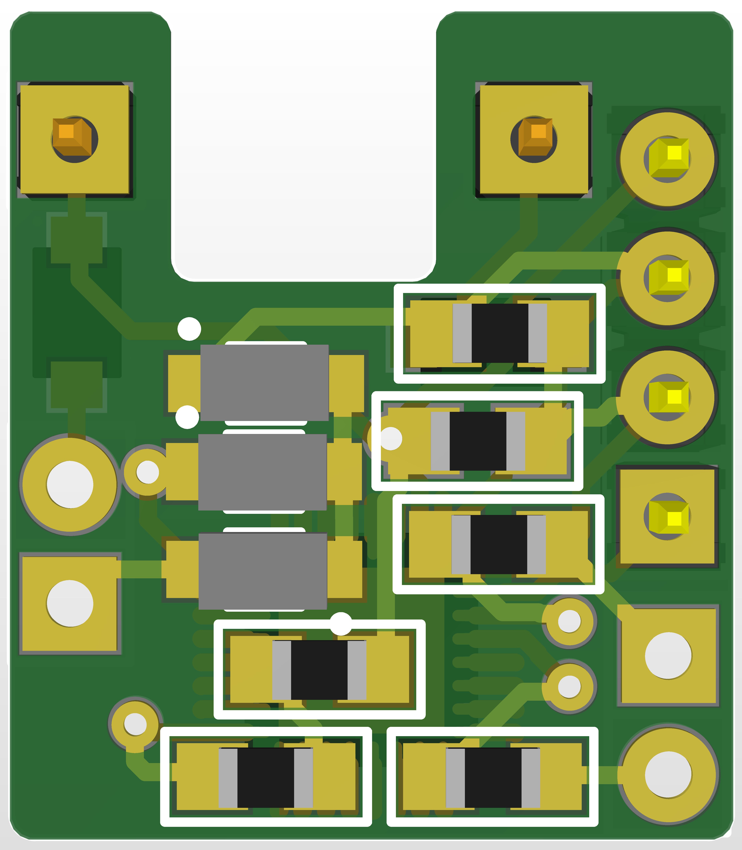
[picture p215: page 2]
