odevincenti/Wet-DryPenguins/PCB/Adapters/Project Outputs for Adapters/Job1.PDF

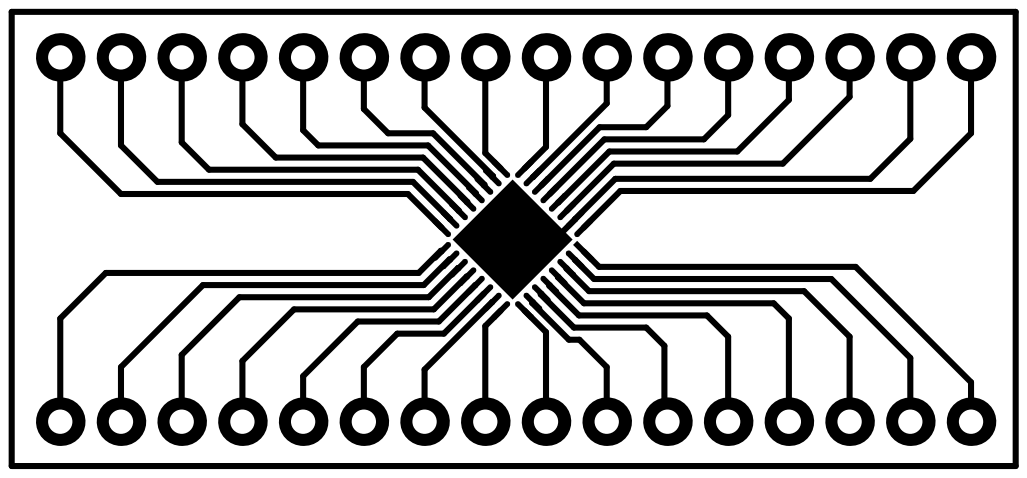
[picture p216: page 1]
