odevincenti/Wet-DryPenguins/PCB/Tracker_Prototype/Project Outputs for Tracker_Prototype/Logger-V3-Full-OutputJob.PDF

Designator | Quantity | Description | Value | Footprint | PartNumber | Digi-Key_Part_Number
BAT-, BAT+ | 2 | | | TPTH
C1 | 1 | | | 0805
C2 | 1 | | | 0805
COM, PWR | 2 | | | SIP2
D1, D2, D3 | 3 SwitchingDiode, 2-Pin SOD-123, Pb-Free, Tape | and Reel | | ONSC-SOD-123-2-425-04_V | MMSD4148T1G
D4, D5 | 2 | | | SODFL350X110-2N
D6 | 1 | | | 0805
PROG | 1 | | | SIP4
R1, R2 | 2 | | | 0805
R3 | 1 | | | 0805
R6 | 1 | | | 0805
U1 | 1 IC MCU16BIT64.5KBFRAM32VQFN | | | FP-RHB0032E-IPC_A

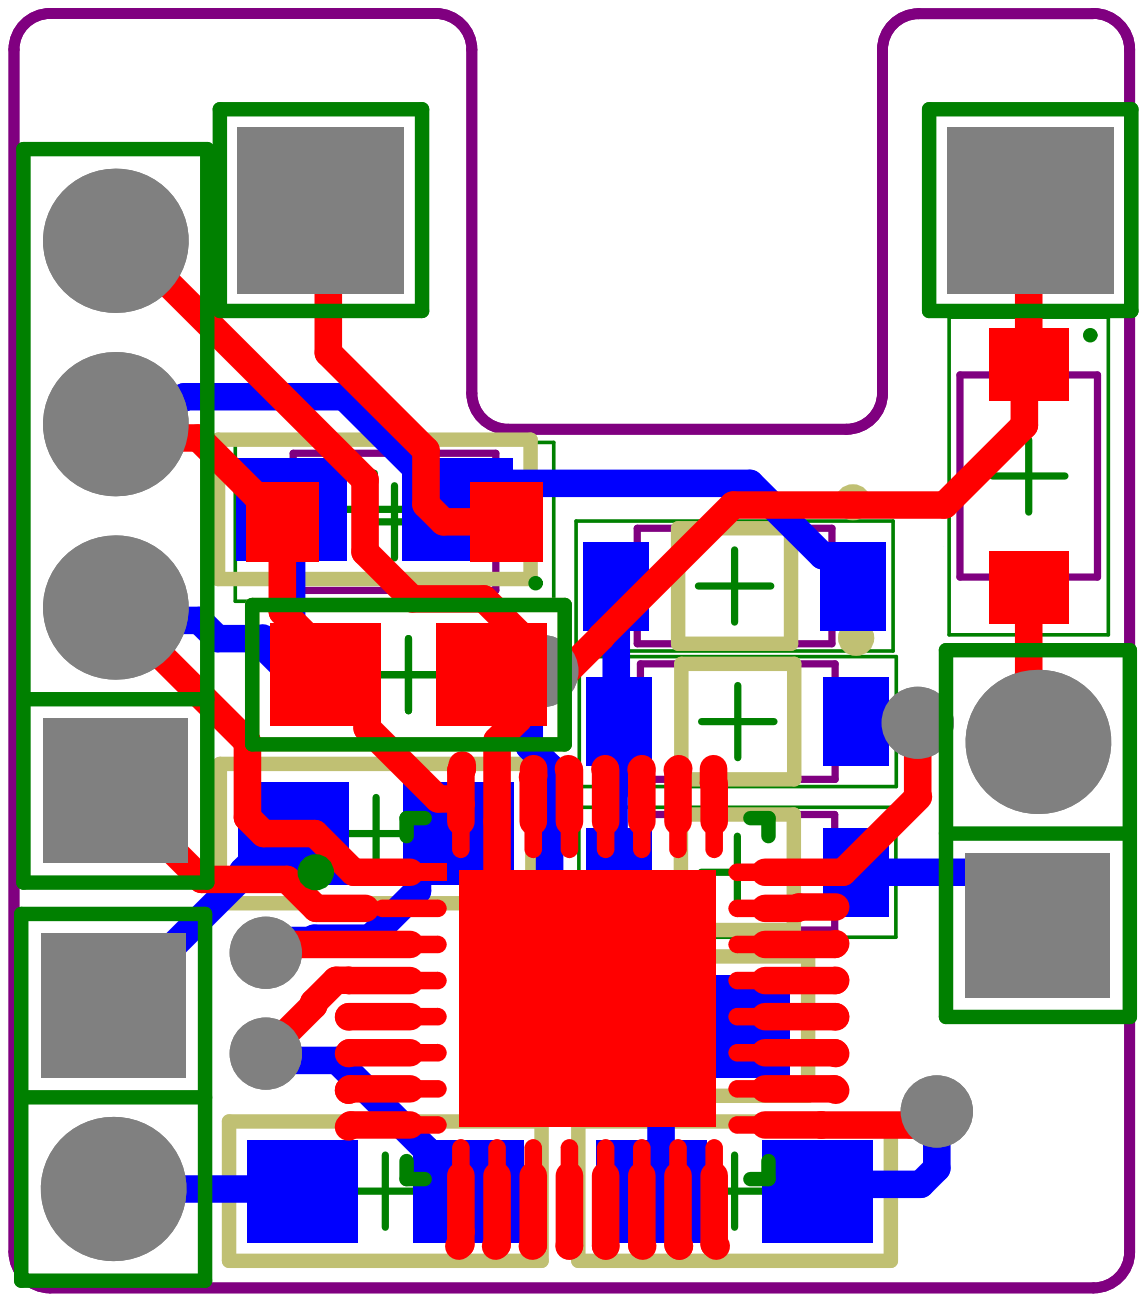
[picture p217: page 3]

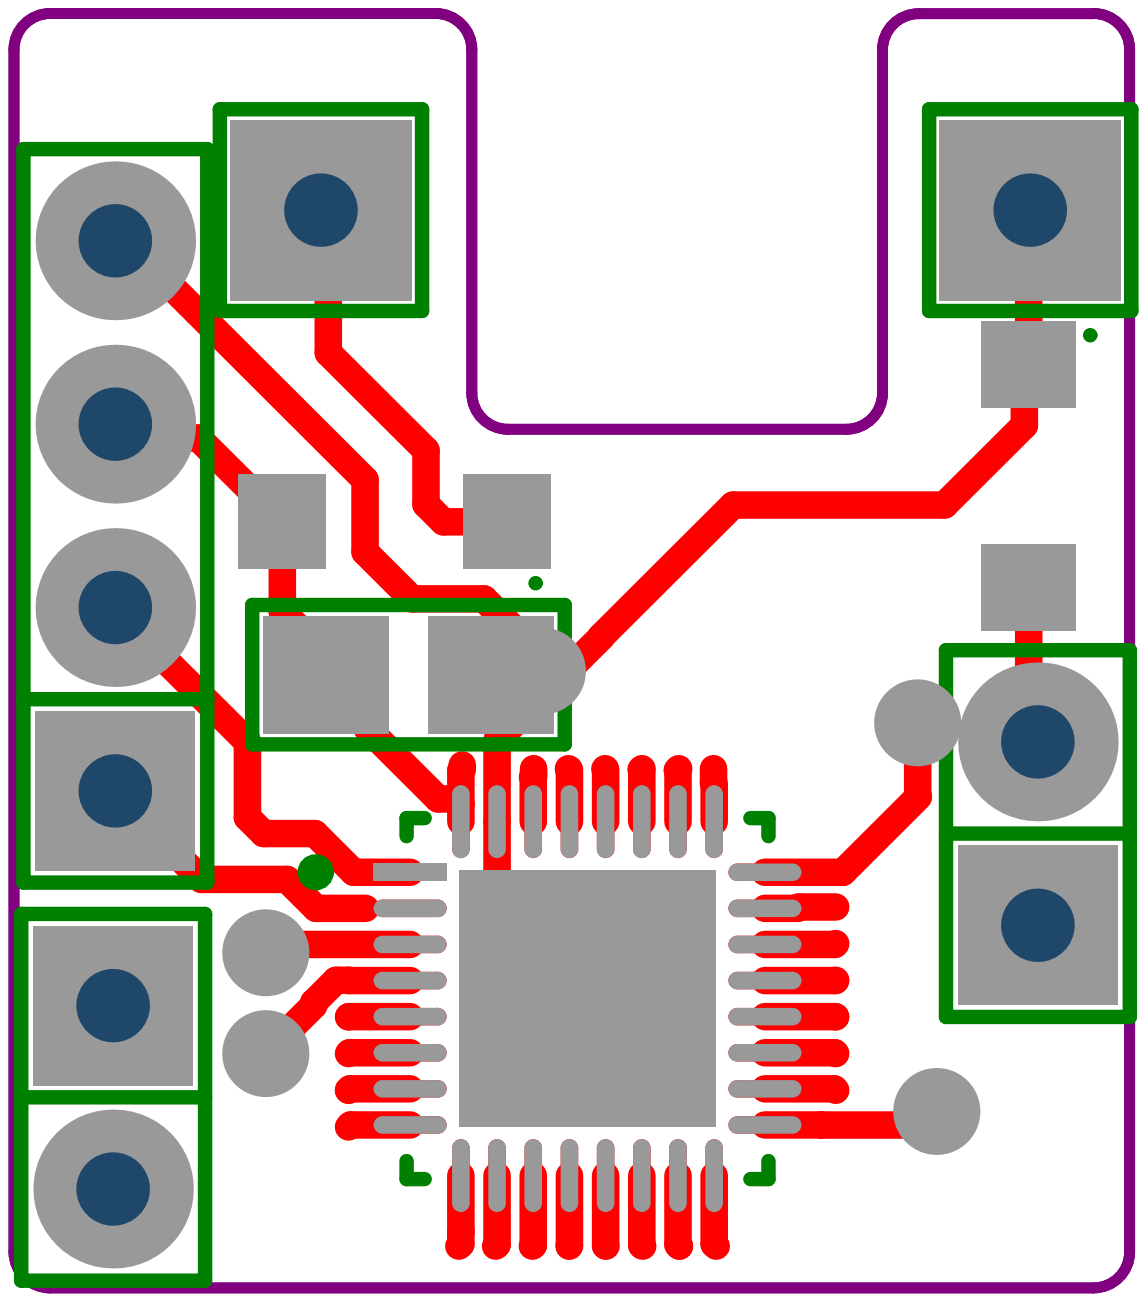
[picture p218: page 4]

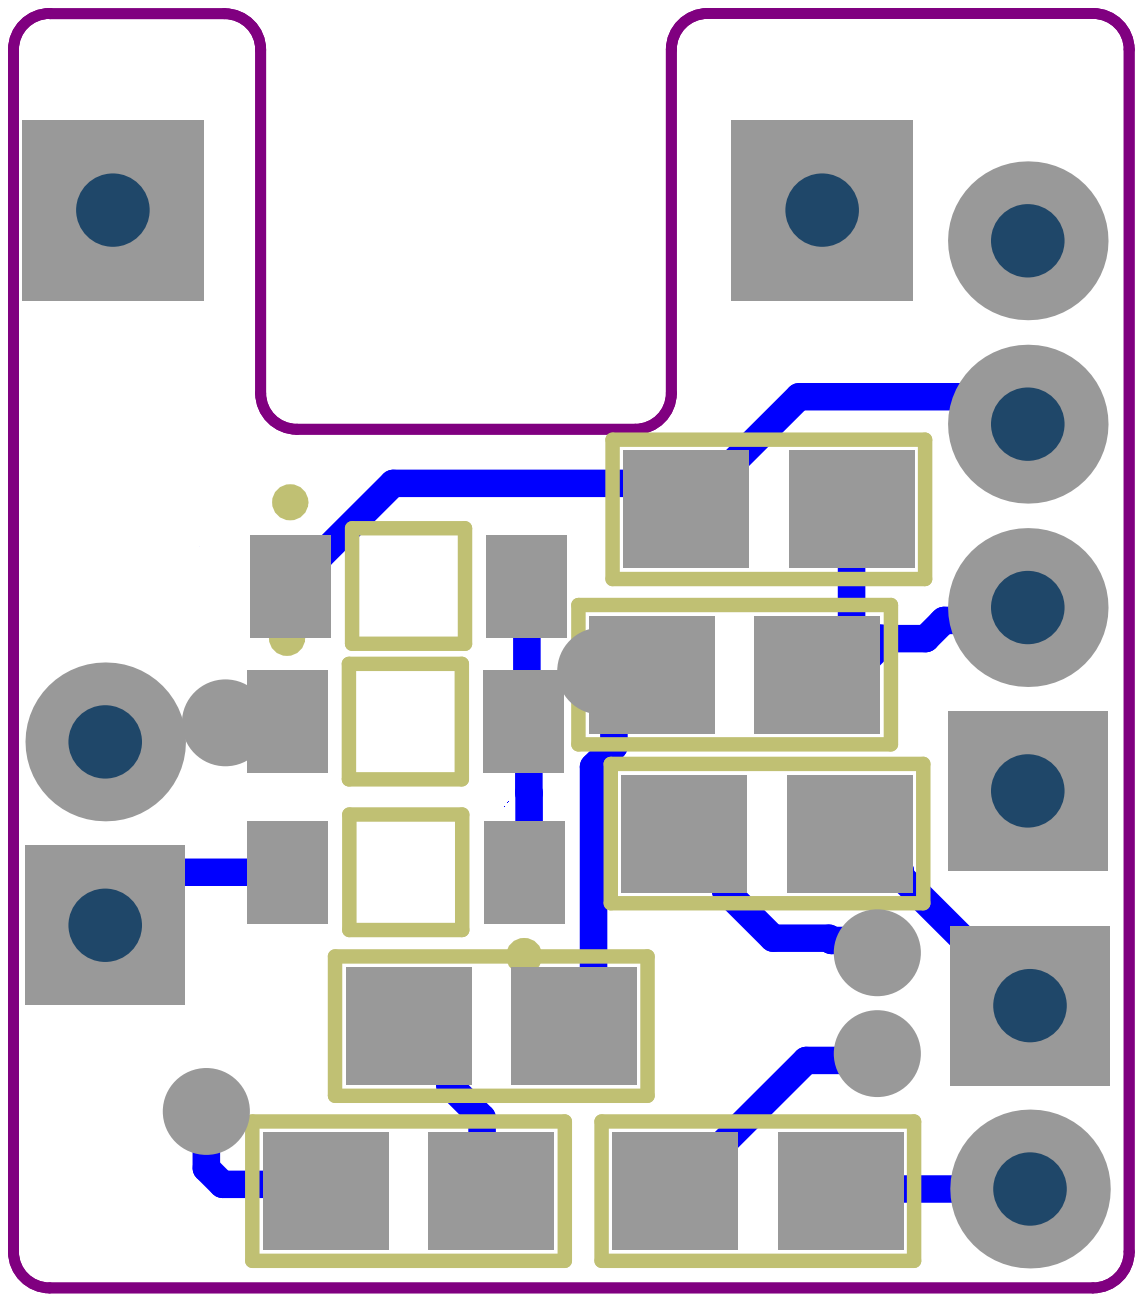
[picture p219: page 5]

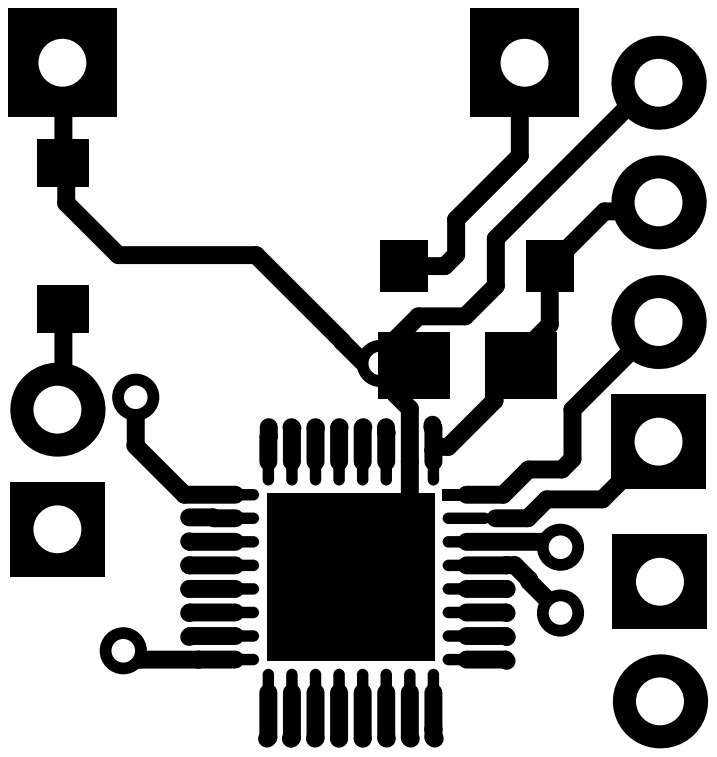
[picture p220: page 6]

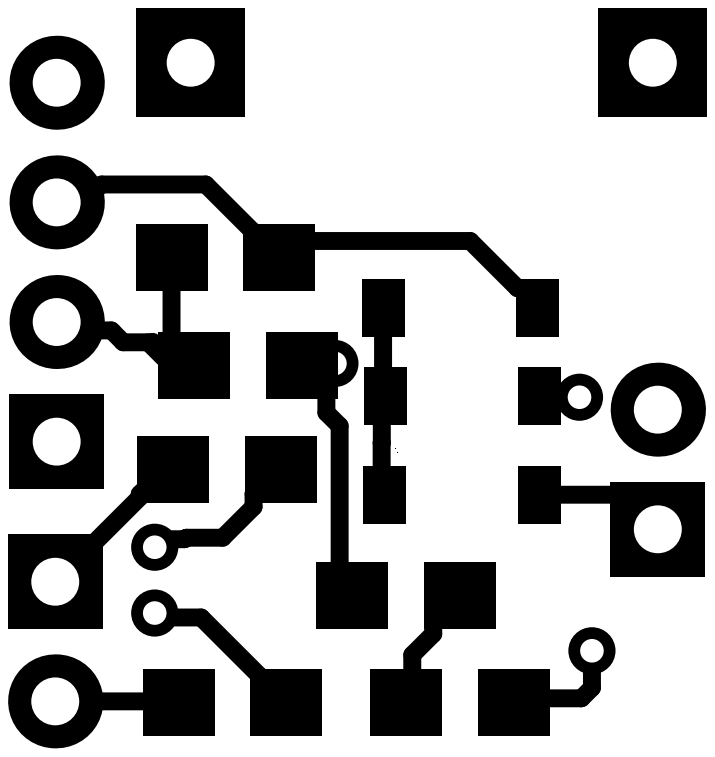
[picture p221: page 7]

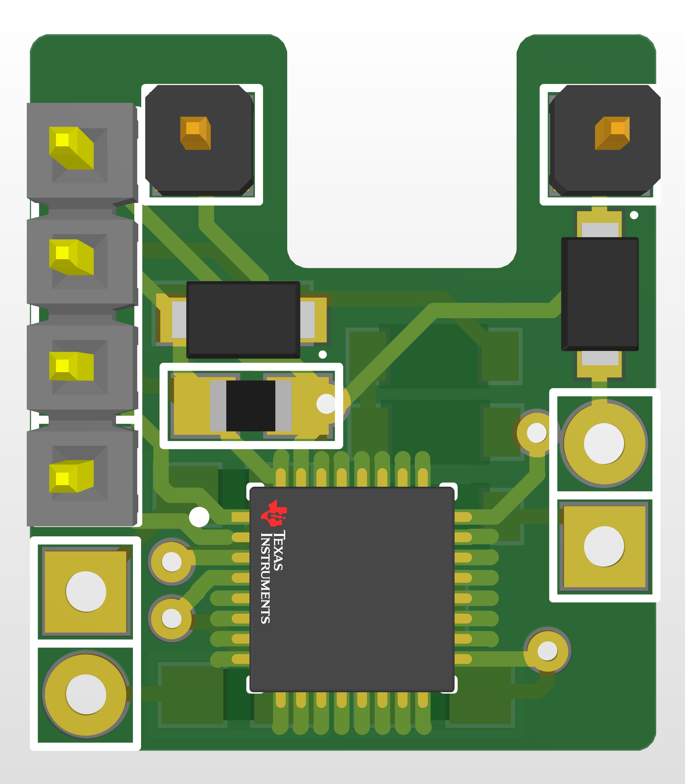
[picture p222: page 8]

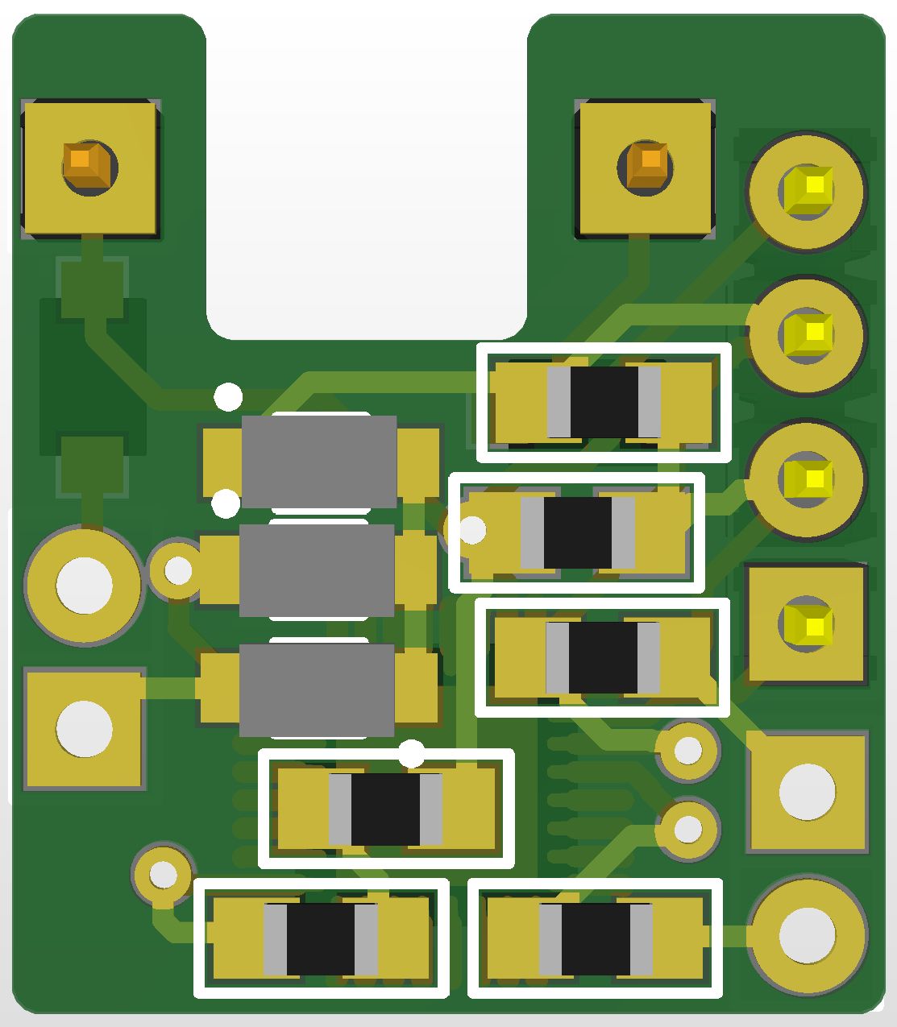
[picture p223: page 9]
