odevincenti/Wet-DryPenguins/PCB/Tracker_Prototype/prototypeV2_bottom.pdf

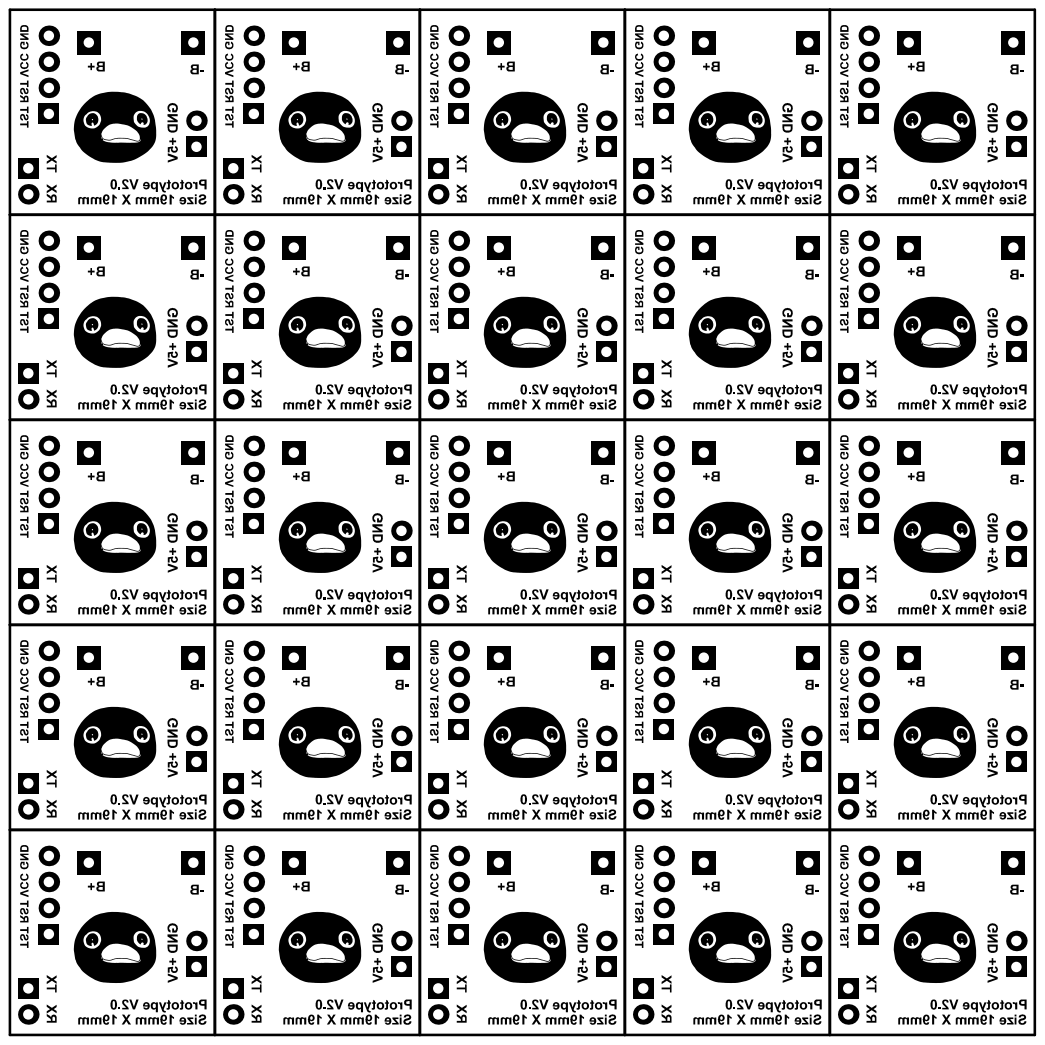
[picture p224: page 1]
