odevincenti/Wet-DryPenguins/PCB/Tracker_Prototype/prototypeV2_top.pdf

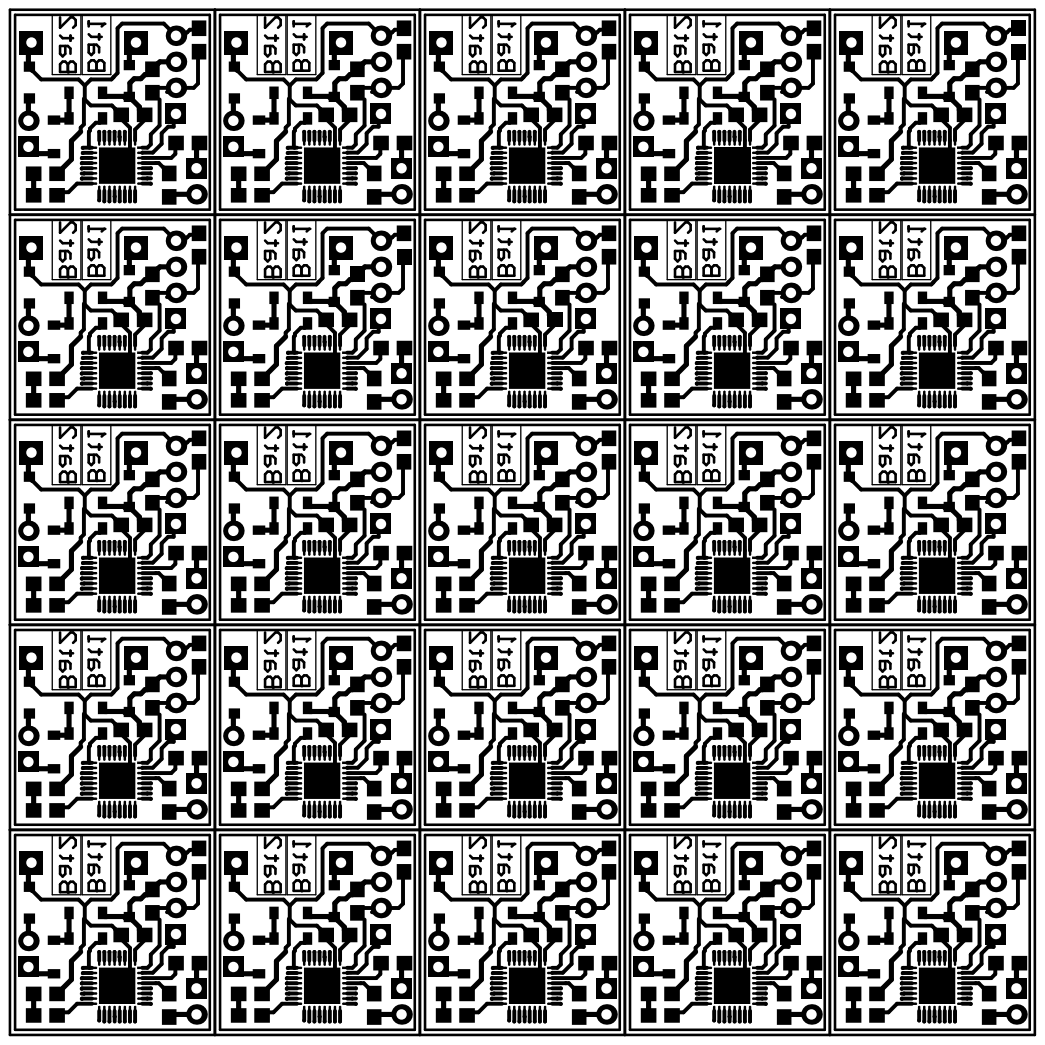
[picture p225: page 1]
