odevincenti/Wet-DryPenguins/PCB/Tracker_Prototype/prototype_top.pdf

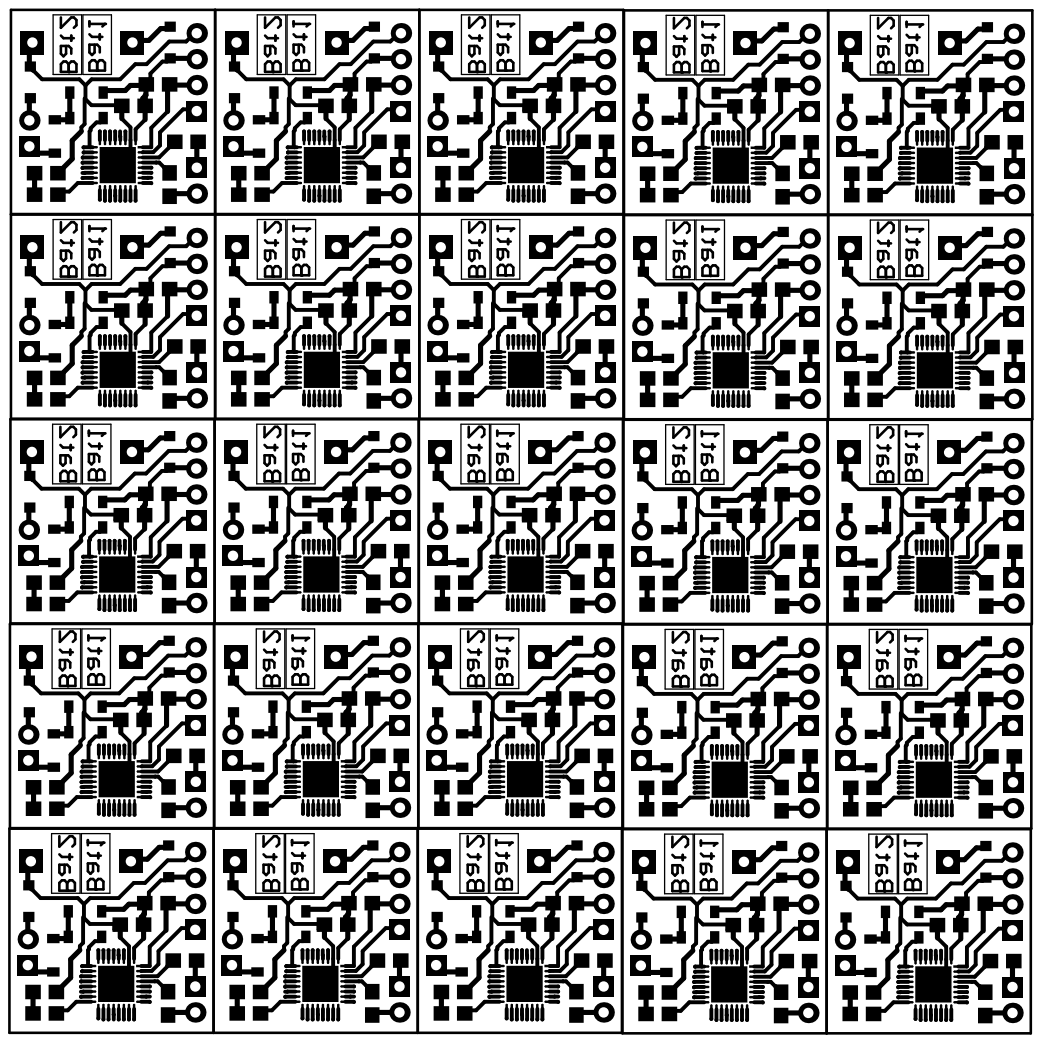
[picture p226: page 1]
