odevincenti/Wet-DryPenguins/PCB/Tracker_Prototype/Project Outputs for Tracker_Prototype/PCB-Logger-V1.PDF

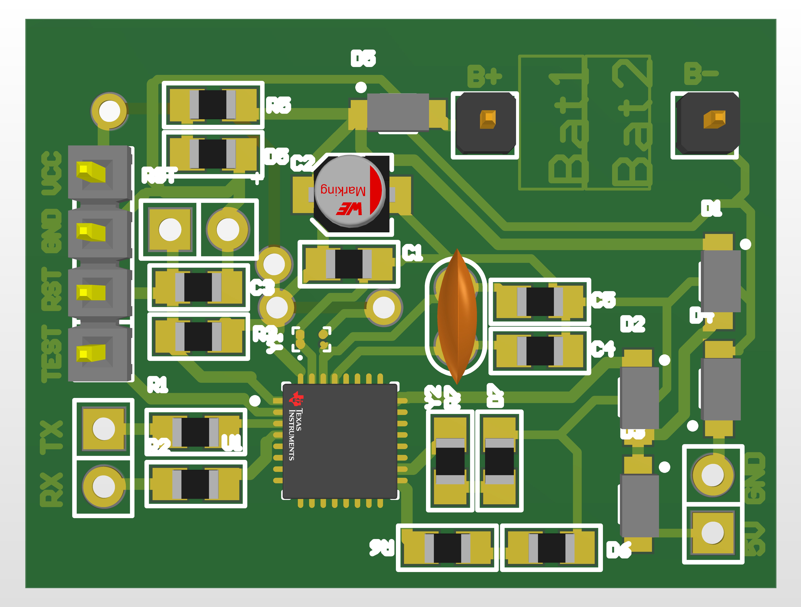
[picture p227: page 1]
