odevincenti/Wet-DryPenguins/PCB/Tracker_Prototype/Project Outputs for Tracker_Prototype/PCB-Logger-V2.PDF

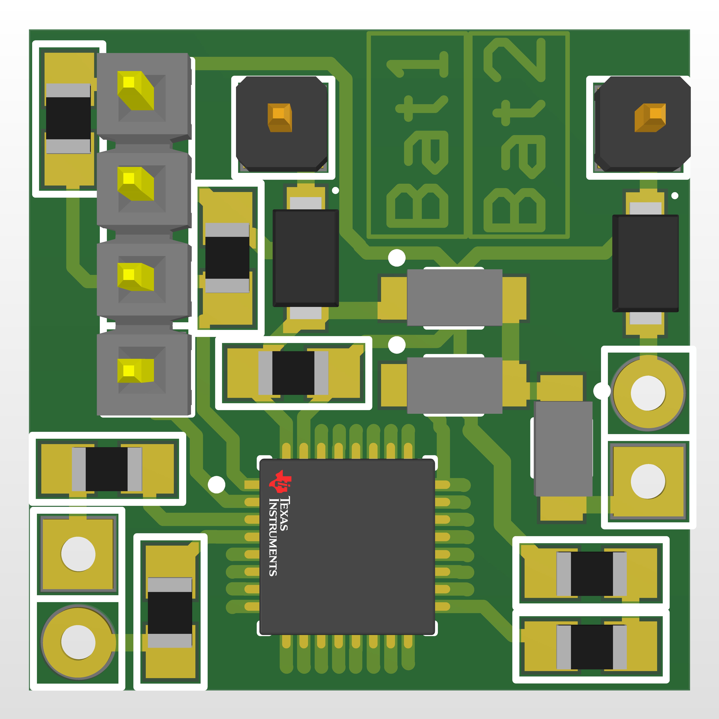
[picture p228: page 1]
