odevincenti/Wet-DryPenguins/Simulaciones/Test baterías/Test_baterias.asc

C1: cap; 47µ
C2: cap; 10n
Q1: pnp; BC557C
Q2: npn; BC547C
R1: res; 150k
R1_var: res; 1k
R2: res; 10k
R3: res; 2.7k
R4: res; 27
R5: res; 510
R5_var: res; 1k
R6: res; 1k
R8: res; 6.8k
Rlim: res; 1k
Roff: res; 1Mega
Ron: res; 3.9k
Ron_var: res; 10k
U1: NE555
U2: LM339
V1: battery; 3.1
Vcc: voltage; 3.6
Named nets: 0, Vcc, Rampa, Vout, Vref
.tran 0 120 3m
Preset 50k
ASSD TP1 G1
Oscilador con frecuencia y Duty Cycle variable
Preset 1k
Generador de rampa
Comparador
Control de frecuencia
Control de Duty Cycle
Preset 10k
Medición descarga de batería
Directivas Spice
Tester
I_off = 3.1uA
I_on: 220uA - 800uA
Ts: 26.9s  - 34.7s
DC: 0.15% - 0.82%
R5: 1 - 1k
R1_var: 1k - 50k
