odevincenti/Wet-DryPenguins/Simulaciones/Schem_tracker.asc

C1: cap
D1: diode; 1N4007
D2: diode; 1N4007
D3: diode; 1N4007
D4: diode; 1N4007
D5: diode; 1N4007
D6: schottky; 1N5819
D7: diode; 1N4007
R1: res; 100
R2: res; 20k
R3: res; 20k
V1: voltage; BAT
Named nets: DETECT_BASE, 0, Vcc, SENSE1_3V3, GND_INT, SENSE_2, V_EXT, SENSE_1, TX, RX
MSP430
Tracker
Proteccion/carga
