odevincenti/Wet-DryPenguins/Simulaciones/Simu_conductividad.asc

Ccc: cap; 10n
D1: diode
D2: diode
Ramb: res; {Ragua}
RambDC: res; {Ragua}
RlimDC: res; 10k
Rpd0: res; 50k
Rpd00: res; 50k
Rpd1: res; 50k
Rpd11: res; 50k
S1: sw; SW1
S2: sw; SW1
S3: sw; SW1
S4: sw; SW1
V1: voltage; 3.1
V2: voltage; 3.3
V3: voltage; PULSE(0 3.1 62u 0 0 31u 124u)
V4: voltage; PULSE(0 3.1 0 0 0 31u 124u)
Named nets: Vcc, 0, MedDC, Pin0, Pin1, OutA, Pin1DC, Pin0DC, OutB, InA, InB, Vext
.tran 0 2m 0
Medición DC (Electrólisis mala)
Medición AC (Sin electrólisis :D )
Alimentación Interna
Directivas Spice
.param Ragua=5
.param Raire=130Mega
.model SW1 SW(Ron=1 Roff=1Meg Vt=.5 Vh=-.4)
Alimentación Externa
