odevincenti/Wet-DryPenguins/(list of files, drawings)

Other design files:
PCB/Adapters/Adapters.PrjPcb
PCB/Adapters/MSP_Adapter.PcbDoc
PCB/Adapters/MSP_Adapter.SchDoc
PCB/Penguin Base/Penguin Base.PrjPcb
PCB/Penguin Base/Penguin_Base.SchDoc
PCB/Penguin Base/PrototypeV4.PcbDoc
PCB/Tracker_Prototype/BGA4C100X41P2X2_154X84X60N.PcbLib
PCB/Tracker_Prototype/BGA4C100X41P2X2_154X84X60N.SchLib
PCB/Tracker_Prototype/LIB_CR1216_MFR_SM/CR1216_MFR_SM/Altium/CR1216_MFR_SM.SchLib
PCB/Tracker_Prototype/LIB_CR1216_MFR_SM/CR1216_MFR_SM/Altium/CR1216MFRSM.PcbLib
PCB/Tracker_Prototype/Prototype.PcbDoc
PCB/Tracker_Prototype/Prototype.SchDoc
PCB/Tracker_Prototype/PrototypeV2.PcbDoc
PCB/Tracker_Prototype/PrototypeV2.SchDoc
PCB/Tracker_Prototype/PrototypeV3.PcbDoc
PCB/Tracker_Prototype/PrototypeV3.SchDoc
PCB/Tracker_Prototype/PrototypeV4.SchDoc
PCB/Tracker_Prototype/Tracker_Prototype.PrjPcb
PCB/Tracker_Prototype/XTAL_tht.PcbDoc
