odevincenti/Wet-DryPenguins/ESP32/Codigo/penguin_tracker_base_06/penguin_tracker_base_06/pinout.h

#ifndef __pinout_h__
#define __pinout_h__

#define PIN_5V_ENABLE   15
//#define PIN_TX        17
//#define PIN_RX        16
#define PIN_TX_ENABLE   33 
//#define PIN_TX_PC     1
//#define PIN_RX_PC     3
#define PIN_RED_LED     25
#define PIN_GREEN_LED   26
#define PIN_BLUE_LED    27

#endif
