odevincenti/Wet-DryPenguins/ESP32/Codigo/penguin_tracker_base_06/penguin_tracker_base_06/led_functions.h

#ifndef __led_functions_h__
#define __led_functions_h__

enum COLOR {BLACK, RED, GREEN, YELLOW, BLUE, MAGENTA, CYAN, WHITE};
void setup_led(void);
void change_led_color(int color);

#define BASE_POWER_ON RED
#define CONNECTING    BLUE
#define FAILED_TO_CONNECT   MAGENTA
#define CONNECTED     GREEN
#define PROCESSING    BLUE

#endif
