odevincenti/Wet-DryPenguins/Pruebas Experimentales/Presión/log 1 - pre test - pre config.txt

////////////////////////////////////\n\nOption not valid\nG = get\nS = set\nR = reset all\nQ = quit\n\n////////////////////////////////////\n\nGetting ...\nA = all variables\nX = cancel operation\n\n////////////////////////////////////\n\nRTC = disabled\nMemory full = False\nCurrent index = 6\nC:0 = 5 : Counter interrupted by RESET\nC:1 = 0 : Counter interrupted by RESET\nC:2 = 10340 : Counter interrupted by FALSE base detection\nC:3 = 2 : Counter interrupted by FALSE base detection\nC:4 = 101 : Counter interrupted by BASE DETECTION\nC:5 = 0 : Counter interrupted by BASE DETECTION\nC:6 = 0 : CURRENT counter\n\nPenguin Tracker Beta\nG = get\nS = set\nR = reset counters and warnings\nQ = quit\n\n
