odevincenti/Wet-DryPenguins/(commit log)

2023-07-05 Poblamos el repo
2023-07-07 Agrego circuito para testear baterías
2023-08-01 Added Adapter PCB
    [Adapters.PrjPcb, MSP_Adapter.PcbDoc, MSP_Adapter.SchDoc]
2023-08-21 Started Prototype PCB
    [BGA4C100X41P2X2_154X84X60N.PcbLib, MSP_Adapter.PcbDoc, Prototype.SchDoc, Tracker_Prototype.PrjPcb]
2023-08-21 Progress on Prototype PCB
    [BGA4C100X41P2X2_154X84X60N.SchLib, Prototype.PcbDoc, Prototype.SchDoc, Tracker_Prototype.PrjPcb]
2023-08-25 Prototype built :)
    [Prototype.PcbDoc, Prototype.SchDoc, Tracker_Prototype.PrjPcb, XTAL_tht.PcbDoc]
2023-08-25 Added pdfs
    [Prototype.SchDoc]
2023-09-04 Agrego mediciones del multimetro
    [Multimetro.xlsx]
2023-09-05 Revert "Delete Codigo/PT_Minitipo_justCLK_withPERSISTENT directory"
    This reverts commit 4af414de036c918863779d7bc0aff773565445ca.
    [msp430fr267x_2.c]
2023-09-05 Added current measurements and clock analysis
    [Calibracion_Multimetro.xlsx, Consumo OSC + MSP.xlsx, Multimetro.xlsx]
2023-09-05 Mediciones de consumo para presión
    [Consumo OSC + MSP.xlsx, Consumo Presión.xlsx]
2023-09-05 Finished analysis of voltage vlo
2023-09-06 Added board clock tests
2023-09-08 Updated PCB V2
    [Prototype.PcbDoc, PrototypeV2.PcbDoc, PrototypeV2.SchDoc, Tracker_Prototype.PrjPcb]
2023-09-08 Added logo
    [PrototypeV2.PcbDoc]
2023-09-08 Printed PCB V2
    [Tracker_Prototype.PrjPcb]
2023-09-13 Added pression experiment results
    [log pre test - pre config.txt]
2023-09-14 Added more test logs
    [log 1 - pre test - pre config.txt]
2023-09-16 Printed V3 pcb
    [PrototypeV2.GBL, PrototypeV2.GTL, PrototypeV2.GTO, PrototypeV3.GBL, PrototypeV3.GBO, PrototypeV3.GBP, PrototypeV3.GBS, PrototypeV3.GKO]
2023-09-17 Notas de molde
2023-09-21 Subo fotos de distintas mediciones
    [Calibracion_Multimetro.xlsx, Consumo OSC + MSP.xlsx, Consumo Presión.xlsx]
2023-09-21 Agrego Diagrama en bloques de Firmware
2023-10-03 Added ESP32 code for Base
2023-10-03 Subo configuraciones pinguinos
    [Config_inicial.xlsx]
2023-10-03 PCB Final
    [Penguin Base.PrjPcb, Penguin_Base.SchDoc]
2023-10-04 Agrego views de la gui
2023-10-25 Subo matriz de trazabilidad
    [Matriz de Trazabilidad.xlsx]
2023-12-08 Added ADC time measurements
    [Medicion_Wet_y_Temp_Adaptador2_Nocaps_LedON_zoomINadc.csv, Medicion_Wet_y_Temp_Adaptador2_Nocaps_LedON_zoomINadc2.csv, Medicion_Wet_y_Temp_Adaptador2_Nocaps_LedON_zoomINwakeup1.csv, Medicion_Wet_y_Temp_Adaptador2_Nocaps_LedON_zoomINwakeup2.csv, Medicion_Wet_y_Temp_Adaptador2_Nocaps_LedON_zoomOUT.csv, Medicion_Wet_y_Temp_Adaptador2_cap104_LedON_zoomINadc.csv, Medicion_Wet_y_Temp_Adaptador2_cap104_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]
2023-12-08 Subo mediciones cosumo
    [Medición Consumo Prototipo.xlsx]
2023-12-08 Subo mediciones y gráficos temperatura
    [PRUEBA_TEMPERATURA_6_6.csv, Prueba Temperatura.xlsx, output_from_msp_PRUEBA_TEMPERATURA_OLI_06.csv, output_from_msp_PRUEBA_TEMPERATURA_OLI_23.csv, output_from_msp_PRUEBA_TEMPERATURA_OLI_23_2.csv, output_from_msp_PRUEBA_TEMPERATURA_OLI_23_3.csv, output_from_msp_PRUEBA_TEMPERATURA_OLI_23_4.csv, output_from_msp_PRUEBA_TEMPERATURA_OLI_23_5.csv]
2023-12-10 Added more time analysis data
    [Medicion_Wet_y_Temp_Adaptador2_Nocaps_LedON_zoomINadc.csv, Medicion_Wet_y_Temp_Adaptador2_Nocaps_LedON_zoomINadc2.csv, Medicion_Wet_y_Temp_Adaptador2_Nocaps_LedON_zoomINwakeup1.csv, Medicion_Wet_y_Temp_Adaptador2_Nocaps_LedON_zoomINwakeup2.csv, Medicion_Wet_y_Temp_Adaptador2_Nocaps_LedON_zoomOUT.csv, Medicion_Wet_y_Temp_Adaptador2_cap104_LedON_zoomINadc.csv, Medicion_Wet_y_Temp_Adaptador2_cap104_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]
2023-12-11 Agrego herramientas para pruebas de temperatura
    [Plantilla PRUEBA_TEMPERATURA_ID_RUNC.xlsx]
2023-12-11 Agrego mediciones de temperatura (me quiero morir)
    [PRUEBA_TEMPERATURA_23_10C.csv, PRUEBA_TEMPERATURA_23_10C.xlsx, PRUEBA_TEMPERATURA_23_11C.csv, PRUEBA_TEMPERATURA_23_11C.xlsx, PRUEBA_TEMPERATURA_23_12C.csv, PRUEBA_TEMPERATURA_23_12C.xlsx, PRUEBA_TEMPERATURA_23_13C.csv, PRUEBA_TEMPERATURA_23_13C.xlsx]
2023-12-12 Added Pressure Test time analysis
    [Medicion_de_tiempos_prueba_de_resistencia.csv]
2023-12-13 Agrego screenshot de la PenGUI
2023-12-13 Más mediciones de temperatura
    [PRUEBA_TEMPERATURA_23_10C.csv, PRUEBA_TEMPERATURA_23_10C.xlsx, PRUEBA_TEMPERATURA_23_11C.csv, PRUEBA_TEMPERATURA_23_11C.xlsx, PRUEBA_TEMPERATURA_23_12C.csv, PRUEBA_TEMPERATURA_23_12C.xlsx, PRUEBA_TEMPERATURA_23_13C.csv, PRUEBA_TEMPERATURA_23_13C.xlsx]
2023-12-13 Gráficos temperatura
2024-01-18 PCB V2
    [CR1216MFRSM.PcbLib, CR1216_MFR_SM.SchLib, EDI2CAP.CFG, Penguin_Base.SchDoc, PrototypeV3.SchDoc, PrototypeV4.PcbDoc, PrototypeV4.SchDoc, Tracker_Prototype.PrjPcb]
2024-01-23 Subo planificación de tiempos
    [Gantt del Proyecto.xlsx]
2024-01-24 Added Tablas
    [10-2 Gantt del Proyecto.xlsx, 9-3Matriz de Trazabilidad.xlsx]
2024-01-25 Tablas de seccion 8
    [8-1 Requerimientos del Cliente.xlsx, 8-3 Especificaciones de Diseño.xlsx, 9-1 Diseño de banco de pruebas.xlsx, 9-2 Especificación de Tests.xlsx, 9-3 Matriz de Trazabilidad de validación.xlsx]
2024-01-25 Finished 8-1 and 8-3
    [8-1 Requerimientos del Cliente.xlsx, 8-3 Especificaciones de Diseño.xlsx]
2024-01-27 Done with sections 9-1 and 9-2 :)
    [8-1 Requerimientos del Cliente.xlsx, 8-3 Especificaciones de Diseño.xlsx, 9-1 Diseño de banco de pruebas.xlsx, 9-2 Especificación de Tests.xlsx]
2024-01-28 Lista matriz de trazabilidad
    [10-1-2 Propuesta de alternativas de diseño.xlsx, 8-3 Especificaciones de Diseño.xlsx, 9-3 Matriz de Trazabilidad de validación.xlsx]
2024-01-28 Listo 10.1.2 Alternativas de diseño y elección de solución
    [10-1-2 Propuesta de alternativas de diseño.xlsx]
2024-02-02 Inicio planes de prueba de hardware, ordene algunas carpetas para que tablas y graficos esten cerca
    [11-1-4 Plan de pruebas de cada módulo (Hardware).xlsx, 9-2 Especificación de Tests.xlsx]
2024-02-03 Lista sección 14-1 Confiabilidad de Hardware :)
    [11-1-4 Plan de pruebas de cada módulo (Hardware).xlsx, 14-1 Confiabilidad de hardware.xlsx]
2024-02-05 Agrego factibilidad de tiempos
    [Gantt del Proyecto.xlsx]
2024-02-05 Agrego canvas modelo de negocios
2024-02-05 Agrego revisión de parte del informe
2024-02-05 Muevo factibilidad de tiempos
    [10-2 Gantt del Proyecto.xlsx, Gantt del Proyecto.xlsx]
2024-02-05 Muevo y actualizo factibilidad económica
    [Costos desarrollo.csv, Costos logger.csv, Factibilidad económica.xlsx]
2024-02-05 BOMs para seccion 12
    [12-1 Descripción de los módulos - BOMs.xlsx, Prototype.PcbDoc, PrototypeV3.PcbDoc]
2024-02-05 Corrijo costo del logger
    [Factibilidad económica.xlsx]
2024-02-05 Agrego mas ingresos
    [Ingresos bases.csv, Ingresos logger.csv]
2024-02-05 Lista sección 12 :)
    [12-1 Descripción de los módulos - BOMs.xlsx, Base_bottom.SLDPRT, Base_bottom.STL, Base_contact.STL, Base_lip.STL, Base_spring_holder.STL, Base_spring_holder_V2.SLDPRT, Base_spring_holder_V2.STL]
2024-02-05 Agregada bibliografia y algunos del anexo
    [Penguin Base.PrjPcb, PrototypeV3.PcbDoc, PrototypeV4.PcbDoc, Tracker_Prototype.PrjPcb]
2024-02-05 Pequeño cambio a seccion 8
    [8-1 Requerimientos del Cliente.xlsx, 8-3 Especificaciones de Diseño.xlsx]
2024-02-06 Actualizo Factibilidad Económica
    [Costos desarrollo.csv, Costos logger.csv, Factibilidad económica.xlsx, Ingresos bases.csv, Ingresos logger.csv]
2024-02-08 Mini correcciones
    [8-1 Requerimientos del Cliente.xlsx, 8-3 Especificaciones de Diseño.xlsx, 9-1 Diseño de banco de pruebas.xlsx, 9-2 Especificación de Tests.xlsx, Factibilidad económica.xlsx]
2024-02-09 Fotos de la PenGUI
2024-02-09 Lista confiabilidad de software
    [14-2 Confiabilidad de software.xlsx]
2024-02-09 tabla DFMEA
    [9-1-4 DFMEA.xlsx]
2024-09-13 Subo todo lo referente a la programación en masa de los loggers
    [Programación.xlsx]
2024-09-14 Update producción
    [Programación.xlsx]
2024-09-21 Update testing producción
    [Programación.xlsx]
2024-09-21 Commit para que git deje de llorar
    [Factibilidad económica.xlsx]
2024-09-26 Actualizo excel produccion
    [Programación.xlsx]
2024-09-26 Update Excel programacion
    [Programación.xlsx]
2024-09-26 Comencé activation.py
    Es el script que se utilizará para activar los loggers
2024-09-26 Actualice mas cosas para la activacion
